COO-Utilities/hispec-tib/doc/hardware.md

# Electronics and repair reference

This page owns physical mappings and assumptions. [Fiber paths](hardware_profiles.md)
connect those mappings to API names. A firmware profile describes what is used;
a BOM describes assembly population. Neither alone certifies an installed board.

## Source drawings and revision boundaries

Use these source drawings and assembly files:

- {download}`Schematic print <../pcb/FIB_Switcher TIB Schematic Print.PDF>`:
  52 PDF pages, with some sheets dated 21 October 2026. PDF page numbers below
  are viewer page numbers, since repeated Altium sheet numbers are ambiguous.
- {download}`PCB print <../pcb/FIB_Switcher PCB Print.PDF>`: 23 pages of layers
  and assembly views; use component designators to locate the electrical stage.
- {download}`TIB BOM <../pcb/FIB_Switcher_TIB_BOM.xlsx>` and
  {download}`NoTIB BOM <../pcb/FIB_Switcher_NoTIB_BOM.xlsx>`: `Manufacturing`
  sheets dated 4 September 2026, 12:18 and 12:19 respectively.
- {download}`TIB placement <../pcb/FIB_Switcher_TIB.txt>` and
  {download}`NoTIB placement <../pcb/FIB_Switcher_NoTIB.txt>`: 16 July 2026,
  design revision `59e398672786f7c0d6aec813e7c4099687d5be41`.
  NoTIB contains optical patch comments for CAL and AS.

| Drawing pages | Use |
|---|---|
| 1, 10, 52 | AS, CAL and TIB hierarchy/component names |
| 9 | DACs U8/U9, references U12/U13 and TP2 |
| 39–44 | Repeated OPA2991 FVOA-drive stages |
| 45–48 | Controller hierarchy and Nucleo connector nets/straps |
| 49 | ADS1115 U4 and PD input networks |
| 50 | Power circuitry |
| 51 | PCAL6416 U7, MEMS drive mapping and TP1 |

The PD scaling follows the resistor network on page 49; its voltage annotation
is obsolete. The [input-chain description](#tib-photodiode-monitoring-adc) below
uses the component values and connections.

**Differences requiring physical review:** FVOA stages show 4.7 kΩ/2.43 kΩ feedback, giving
nominal gain $1+2.43/4.7=1.5170$, while firmware defaults to 1.533. NoTIB placement
comments reverse the red AS first-switch branch destinations relative to the
firmware route interpretation. These are [owner-review items](human_review_required.md);
the installed configuration matters when interpreting those drawings.

## Controller, buses and connectors

The controller is a Nucleo H563ZI (MB1404), STM32H563ZIT6 Cortex-M33, with 2 MB
flash and 640 KB SRAM. See the bundled
{download}`Nucleo manual <um3115-stm32h5-nucleo144-board-mb1404-stmicroelectronics.pdf>`
and {download}`MCU reference <stm32h563zi.pdf>`.

| Function | Nucleo signal / connector | Peripheral / destination |
|---|---|---|
| PD ADC SCL/SDA | PB8/PB9, D15/D14, CN7 2/4 | I2C1, 400 kHz; U4 ADS1115 at 0x48 |
| DAC/MEMS SCL/SDA | PF1/PF0, D69/D68, CN9 19/21 | I2C2, 400 kHz; DAC 0x48/0x4A, PCAL 0x21 |
| Laser Modbus RX/TX | PD6/PD5, D52/D53, CN9 4/6 | USART2, THVD1429 RS-485 |
| RS-485 enable | PD4, D54, CN9 8 | GPIO active high |
| Laser-bank enable | PB2, D72, CN9 13 | GPIO active low, default off |
| Relay 1-Wire | PE9, D71, CN9 15 | UART12 RX, AF6, TX/RX swap, single-wire open drain |
| Ambient 1-Wire | PG1, D64, CN9 30 | UART9 TX, AF11, single-wire open drain, DS18B20 |
| FFLS status 1/2 | PF7/PF9, D62/D63 | PCB pull-ups; overlay inputs, unused by firmware |

The two devices at address 0x48 are on different buses. Check bus identity before
interpreting an address scan. `app/boards/nucleo_h563zi.overlay` supplies the exact
pin configuration; `devices.c` maps profile names and logical channels.

Addresses below are **7-bit I2C addresses**, without the read/write bit:

| Device | Address strap | Installed selection |
|---|---|---|
| ADS1115 U4, I2C1 | ADDR to GND: 0x48; to VDD: 0x49 | GND, 0x48 |
| DAC7678PW U8/U9, I2C2 | ADDR to GND: 0x48; to AVDD: 0x4A; floating: 0x4C | U8: 0x4A; U9: 0x48 |
| PCAL6416A U7, I2C2 | ADDR low: 0x20; high: 0x21 | High, 0x21 |

The [DAC address table](https://www.ti.com/lit/ds/symlink/dac7678.pdf)
depends on package: these are the single-address-pin TSSOP-16 parts.

| Nucleo connector | Purpose | USB signal pins |
|---|---|---|
| CN1, ST-Link USB-C | Programming/debugging and ST-Link virtual COM port | Debugger MCU: D+ PB15, D− PB14, CC1 PC3, CC2 PC4 |
| CN13, user USB-C | USB connection directly to the STM32H563 | Target MCU: D+ PA12, D− PA11, CC1 PB13, CC2 PB14 |
| CN14, RJ45 | Ethernet for MQTT and OTA | — |
| CN5, MIPI20 | External SWD/JTAG/trace debugger | See Nucleo manual table 6 |

CN1 and CN13 connect to **different MCUs**; their similarly named pins are not
shared target pins. The connector names and USB mappings are in Nucleo manual
tables 18–19. Use CN1 for the [USB firmware procedure](ota.md#usb-provisioning-and-local-development).

Required MB1404 solder bridges: PB2 uses SB61 OFF/SB66 ON; PE9 uses SB35 OFF/SB67
ON. The installed-clock assumption is “HSE not used”: SB48/SB50 ON, SB49 OFF,
SB3/SB4 OFF. HSE pins PH0/PH1 are distinct from I2C2 PF0/PF1. Firmware therefore
uses HSI/PLL at 240 MHz, not an HSE source. LSE 32768 Hz clocks RTC and periodic
LPTIM4 uptime at 4096 ticks/s. LSI clocks the independent watchdog. No automatic
STOP states or RTC retention across complete power removal are assumed.

## MEMS drive and switch identity

U7 is a PCAL6416AHF,128: 3.3 V I2C logic, 5 V port supply, ADDR tied high for
0x21. Its outputs drive external transistor stages. The overlay uses push-pull,
pull-ups and **active-low PCAL logic**: logical inactive gives an external low
control line, and logical active creates a high pulse at the switch. A GPIO
`output-low` flag describes logical state, not necessarily low voltage at the pin.

The [PCAL specification](https://www.nxp.com/docs/en/data-sheet/PCAL6416A.pdf)
allows up to 25 mA sink and 10 mA source per pin, subject to its voltage and
package limits. The external MOSFETs supply the switch-coil current. The Zephyr
driver initializes full drive strength and push-pull operation. Output mode is
selected per eight-bit port; TIB's port 0 mixes FFLS and FFSW controls, so the
common push-pull configuration serves both stage types.

| Stage | Parts verified in schematic/BOM | Function |
|---|---|---|
| FFSW | Two NTGD4167CT1G complementary MOSFET packages per switch, Q6/Q7; 4.7 kΩ resistors | Coil drive for 20 ms firmware pulses |
| FFLS (TIB only) | DMP3085LSD-13 dual P-channel packages Q4/Q5 | Large-core switch drive for 50 ms pulses |

Each FFSW control has a 4.7 kΩ pull-up to 5 V: about 1.06 mA flows through that
resistor when its PCAL output is low, or up to 2.1 mA for the two-line stage.
The NTGD4167 is the PCB's complementary N/P MOSFET implementation of Agiltron's
SI3552DV reference stage. FFLS gate controls lack these external pull-ups.
An open-drain conversion would require gate pull-ups; unpopulated FFSW-stage
pads provide possible connection points where present. The current push-pull
configuration does not require that modification.

FFLS status inputs have separate 10 kΩ pull-ups to 3.3 V (R11/R12) and 10 kΩ
series resistors (R13/R14), shown on page 48 and specified in TIB BOM row 36.
These are sense-line components, not gate pull-ups.

TIB BOM rows 32–33 and NoTIB row 26 agree with the schematic's stage names. Both switch types latch;
firmware limits actuation to five pulses/s. FFLS status low indicates position B,
high A, but firmware does not consume this feedback. See the bundled
{download}`FFSW datasheet <datasheets/FFSW 1x2 Switch.pdf>` and
{download}`FFLS datasheet <datasheets/FFLS 1x2 Switch.pdf>`.

TIB return selectors `yj_sm_mm` (sw7 / SW2_FFLS1) and `hk_sm_mm`
(sw8 / SW2_FFLS2) follow state A/B name order. Common optical A connects to the
detector; silkscreen B is the SM return and C is the MM return. Pulsing FFLS
pin 2 with the A-state GPIO selects SM; pin 3 with the B-state GPIO selects MM.
The schematic labels these optical branches B1/B2.

| PCB channel | PCAL A/B GPIO indices | Port bits |
|---|---|---|
| sw1 | 6 / 7 | P0.6 / P0.7 |
| sw2 | 8 / 9 | P1.0 / P1.1 |
| sw3 | 4 / 5 | P0.4 / P0.5 |
| sw4 | 10 / 11 | P1.2 / P1.3 |
| sw5 | 12 / 13 | P1.4 / P1.5 |
| sw6 | 14 / 15 | P1.6 / P1.7 |
| sw7 | 2 / 3 | P0.2 / P0.3 |
| sw8 | 0 / 1 | P0.0 / P0.1 |

TP1 on schematic page 51 exposes drive-side nets. Its physical header pin numbers
are not PCAL bit numbers. Use [profile assignments](hardware_profiles.md) to map
sw1…sw8 to installed switch designators before probing.

## TIB and CAL attenuator drive

TIB populates DAC7678 U8/U9, REF3333 U12/U13 and six dual OPA2991 drive stages;
NoTIB's BOM populates U9/U13 and only FVOADrive5. The latter is consistent with
CAL's one logical pair, not a separately verified AS population manifest.

DAC AVDD/reference are 3.3 V; LDAC is grounded. Ideal 12-bit output is
$V=3.3n/4096$ volts for code 0…4095. Amplifiers drive the FVOAs toward 5 V.
Firmware's gain is a model coefficient; distinguish it from the resistor-derived
gain and the measured post-amplifier voltage.

The FVOA is a resistive load without polarity. The datasheet lists 6 V maximum
drive and 220 mW maximum consumption at full attenuation. Their ratio is
36.7 mA, the design current allowance; it is not a separately specified current
limit. Bench supply/ammeter measurements found **530–616 Ω**, typically about
615 Ω. At 5 V that implies about 8.1–9.4 mA per FVOA. The OPA2991, rather than
the DAC, supplies this load. Verify actual supply/headroom and loading before
interpreting a saturated drive as extra attenuation.

| API channel | PCB attenuator label | DAC/address | DAC1 / DAC2 outputs |
|---|---|---|---|
| `1028y` | Y / pair 1 | U8 / 0x4A | A / C |
| `1270j` | J / pair 2 | U8 / 0x4A | E / G |
| `1430yj` | YJATC / pair 3 | U8 / 0x4A | D / F |
| `1430hk` | HKATC / pair 4 | U9 / 0x48 | A / C |
| `1510h` or CAL `lfc` | H / CAL / pair 5 | U9 / 0x48 | E / G |
| `2330k` | K / pair 6 | U9 / 0x48 | D / F |

The firmware CAL index is **4, zero-based**, meaning physical pair 5. TP2 exposes
pre/post-amplifier nets; consult page 9 for its pin mapping. Two successful DAC
writes are consecutive I2C operations, not simultaneous latching. Refer to the
[attenuator model](attenuator.md), [calibration](attenuator_calibration.md), and
{download}`FVOA datasheet <datasheets/FVOA_atten.pdf>` for optical interpretation.

(photodiode-monitoring)=
## TIB photodiode monitoring ADC

U4 ADS1115 channel A0 samples YJ (J13); A2 samples HK (J12), single-ended. Nominal
detectors are Femto FWPR-20-IN and Thorlabs PDA10DT. Firmware uses ±2.048 V range,
62.5 µV/code and 64 SPS converter rate, producing a fresh sample on each channel
at 20 Hz. It treats 2000 mV as the usable upper limit, distinct from the ADC rail.

Each input uses a precision **0–10 V → 0–2 V divider**. R7 (YJ) and R8 (HK)
are NOMCT16032002AT1 networks containing eight isolated 20 kΩ resistors; four
form the 80 kΩ upper leg and one the 20 kΩ lower leg. The remaining three are
tied to ground at both ends. This presents a nominal 100 kΩ load to the detector.
See page 49 and the [Vishay network specification](https://www.vishay.com/docs/60007/nomc.pdf).

C17/C18 are 0.47 µF capacitors across the lower legs. The divider's Thevenin
resistance is $80\,\mathrm{k\Omega}\parallel20\,\mathrm{k\Omega}=16\,\mathrm{k\Omega}$,
giving $f_c=1/(2\pi\,16\,000\times0.47\,\mu\mathrm F)\simeq21.2$ Hz.
This PCB filter follows the detector's own response; it is separate from the
ADS1115's digital filtering and 20 Hz per-channel sample cadence.

The HK PDA10DT uses **70 dB gain and the 500 Hz bandwidth selector**. Its
high-impedance gain is $4.75\times10^6$ V/A, making the effective ADC gain
$0.2\times4.75\times10^6=9.5\times10^5$ V/A. The 100 kΩ divider is not a
50 Ω termination, so the detector's 50 Ω-load half-gain does not apply.
The [Thorlabs gain table](https://www.thorlabs.com/catalogpages/V21/1576.PDF)
states gain in **kV/A**. Firmware effective transimpedance includes the divider;
applying it twice would corrupt power.
[Sampling and uncertainty](photodiode_notes.md) explains clipping and dark capture.

### Static attenuation requirements

The optical simulations determined these anticipated attenuation requirements.
They retain the signed power-ratio convention, $10\log_{10}T$: negative dB means
loss. The static component supplies the least-negative end of the required range;
the variable attenuation supplies the remaining span.

| Wavelength (nm) | Anticipated attenuation | Variable span | Static attenuation |
|---|---|---|---|
| 1028 | -90.0 to -73.0 dB | 17.0 dB | **-73.0 dB** |
| 1270 | -70.0 to -40.0 dB | 30.0 dB | **-40.0 dB** |
| 1430 | Fixed | 0.0 dB | **-100.0 dB** |
| 1510 | -80.0 to -33.0 dB | 47.0 dB | **-33.0 dB** |
| 2330 | -73.0 to -3.0 dB | 70.0 dB | **-3.0 dB** |

These simulation-derived requirements are distinct from the compiled whole-route
defaults below and from an installed route's measured loss. Firmware attenuation
commands use **positive loss in dB**; do not send these signed values directly.

### TIB route-loss defaults

The November 4, 2026 loopbacks supply provisional **effective whole-route**
launch losses. SM return transmission is normalized to 1. Static attenuators,
actual SM-return loss and external patch loss are absorbed in the launch
estimate. The reported calibrated FVOA transmission is divided out; firmware
applies it separately. Do not add static attenuation or subtract FVOA loss again.

| Source | FEI loss (dB) | AO loss (dB) | FEI transmission | AO transmission |
|---|---:|---:|---:|---:|
| 1028y | 35.896998 | 35.912564 | 0.000257217310675 | 0.000256297034072 |
| 1270j | 40.022883 | 39.919884 | 9.94744744745e-05 | 0.000101861861862 |
| 1430yj | 61.862828 | 61.770422 | 6.51204158058e-07 | 6.65208548554e-07 |
| 1430hk | 40.316480 | 40.783695 | 9.29719589563e-05 | 8.34892314352e-05 |
| 1510h | 28.578688 | 28.861120 | 0.00138717482884 | 0.00129983419147 |
| 2330k | 35.947698 | 35.969136 | 0.000254232004693 | 0.00025298010467 |

Use the shared `yj_laser_to_yj_ao/fei` or `hk_laser_to_hk_ao/fei` loss names,
including 1430. Internal 1430 records retain their physical route identity.
YJ used an S154C head set to 1028 nm, with factors 1, 0.7314 and 0.6507 for
1028/1270/1430. HK 1430/1510 used the same head set to 1430 nm, with factors 1
and 0.9714. The 2330 measurement used an S148C set to 2330 nm, factor 1.
S154C factors come from its typical response graph; retained digits are
calculation precision, not measurement accuracy. AO/FEI and MM/SM ratios do not
depend on these wavelength corrections.

| Channel | SM transmission | MM transmission | Additional MM loss (dB) |
|---|---:|---:|---:|
| YJ | 1.0 | 0.389741142978 | 4.092237455 |
| HK | 1.0 | 0.830050505051 | 0.808954818 |

Each MM value is the equally weighted arithmetic mean of the three measured
MM/SM ratios in that channel. These useful broadband estimates do not establish
achromatic returns. They replace the former MM 0.98 / SM 0.60 component estimates.
The launch values replace the October 3 YJ 34.5/41/62 dB estimates and nominal
HK switch/static-loss products; the notebook retains that measurement history.

YJ CAL launch remains the 1 dB component estimate (transmission 0.794328234724);
HK CAL has no measured default and uses unity. Retro estimates remain notebook
references. Explicit `mems/route/loss` records replace the whole default.
Named-source overrides are independent of stored generic overrides; passive
capture selects `generic`. Saved settings take precedence after firmware updates.

## Laser control and switched power

The off-board bank contains six Maiman controllers and an NH8 hub. USART2 uses
115200 baud, 8N1, native FIFO and interrupt-driven Modbus. The THVD1429 drives
RS-485 with a documented 50 Ω board termination for this hub connection.
Power/ground to the hub come from the bank. See the bundled
{download}`Maiman manual <datasheets/maiman sf8025.pdf>` and
[laser operation](laser_operation.md) for transaction timing and faults.

PB2 drives a BSS138 stage controlling the bank power inhibit. The active-low
logical enable defaults off; heater auto policy can subsequently power the bank.
Off-board DS2408 relays switch PD YJ, PD HK and the auxiliary heater:

| Relay label | Zero-based DS2408 pin | Logical function |
|---|---|---|
| P1 | 0 | YJ PD power |
| P2 | 1 | HK PD power |
| P3 | 2 | Laser-bank auxiliary heater |

All are active-low, with inactive/off startup intent. The custom DS2408 driver
applies `init-gpios` defaults when available; application setup enforces its own
startup state. This allowed missing-at-boot peripheral is not a generic GPIO hog:
a hog would abort on a not-ready controller. Offline commands report errors;
warnings are best-effort, not guaranteed delivery. Successful DS2408 communication
is the current proxy for load-power availability; there is no downstream power-good
measurement. Status reports confirmed logical relay state.

Both 1-Wire buses have external 3.3 V pull-ups and use stock UART timing:
115200 baud data, 9600 baud reset (about 521 µs low). The accepted DS2408 reset
timing is outside its documented 660–720 µs range at this pull-up voltage; earlier
GPIO timing also fell outside it. This is a known board assumption, not a claim
of datasheet compliance. Revisit it if failures warrant. The pinned serial-driver
mutex limitation is described in [architecture](architecture.md#hardware-control).
Ambient DS18B20 conversion can take 750 ms on the app blocking queue.

## Tracing a fault

Start with the detected profile and commanded path, then follow its physical
channel through the tables above. For switching, distinguish requested state,
PCAL output, transistor-side pulse and actual optical continuity. For attenuation,
compare DAC code, pre-amplifier voltage and FVOA drive before judging the optical
model. For a PD fault, check relay state, input voltage, ADC raw code and configured
dark before interpreting computed nW. For a laser fault, preserve controller
readbacks and communication errors separately from cached current/power estimates.
The [review ledger](human_review_required.md) records unresolved drawing/firmware
questions; use the installed configuration when resolving them.
