COO-Utilities/hispec-tib/doc/hardware_overview.md

# Hardware

`hardware.md` remains the hardware source of truth. The pages below separate
physical hardware details from the firmware's selected board-profile view.

```{toctree}
:maxdepth: 2

hardware.md
hardware_profiles.md
```
