COO-Utilities/hispec-tib/doc/api/devices.md

# Devices and Board Profiles

```{eval-rst}
.. doxygenfile:: app/src/devices.h
   :project: hispec_tib
```

```{eval-rst}
.. doxygenfile:: app/src/app_identity.h
   :project: hispec_tib
```
