COO-Utilities/hispec-tib/doc/api/index.md

# API Reference

These pages are generated through Doxygen XML and Breathe. They are intended to
answer "what does the current C implementation expose?" rather than replace the
architecture and command audit pages.

```{toctree}
:maxdepth: 2

command_interface.md
devices.md
mems_switching.md
photodiode_monitoring.md
attenuator_control.md
maiman_laser.md
settings.md
scheduled_actions.md
warnings.md
sntp_time.md
temperature.md
network_mqtt.md
```
