COO-Utilities/hispec-tib/doc/api/mems_switching.md

# MEMS Switching

```{eval-rst}
.. doxygenfile:: app/src/mems_switching.h
   :project: hispec_tib
```
