COO-Utilities/hispec-tib/pcb/FIB_Switcher_NoTIB_BOM.xlsx

Sheet: Manufacturing
 |  | Bill of Materials for |  | FIB_Switcher.PrjPcb
 |  | Source Data From: | ActiveBOM.BomDoc
 |  | Variant: | NoTIB
 |  | Report Date: | 9/4/2026 12:19 PM
 |  |  |  | Primary |  |  |  |  | Secondary
Altium Vault P/N | Designator | Description | Qty | Supplier | Supplier Part Number | Manufacturer | Manufacturer Part Number | Supplier Unit Price | Supplier | Supplier Part Number | Manufacturer | Manufacturer Part Number | Supplier Unit Price
CMP-06035-053188-1 | C7, C16 | Multi-Layer Ceramic Capacitor 2.2uF 50V X5R ±10% 0603 Paper T/R | 2 | Mouser | 81-GRT188R61H225KE3J | Murata | GRT188R61H225KE13J | 0.0910 | Mouser | 81-GRT188R61H225KE3J | Murata | GRT188R61H225KE13J | 0.0910
CMP-05428-000143-1 | C9 | Conductive Polymer Aluminum Solid Capacitors (OS-CON) 100uF ±20% 25V RADIAL SMT 8x6.9mm | 1 | Mouser | 667-25SVPT100M | Panasonic | 25SVPT100M | 2.2500 | Newark | 25SVPT100M | Panasonic | 25SVPT100M | 2.2900
CMP-06035-045268-1 | C10 | Chip Multilayer Ceramic Capacitors for General Purpose, 0603, 10uF, X5R, 15%, 10%, 25V | 1 | Conrad | 3425436 | Murata | GRM188R61E106KA73D | 0.0929 | Arrow Electronics | GRM188R61E106KA73D | Murata | GRM188R61E106KA73D | 0.0955
CMP-03422-001490-1 | C11, C12, C14, C20, C21_FVOADrive5 | CAP CER 0.1UF 50V X7R 0603 | 5 | Newark | CC0603JRX7R9BB104 | Yageo Group | CC0603JRX7R9BB104 | 0.0390 | Newark | CC0603JRX7R9BB104 | Yageo Group | CC0603JRX7R9BB104 | 0.0390
CMP-00278-84331543-1 | D1 | SMCJ24CA Cut Tape 1 Surface Mount Single (Type) Tvs Diode 38.9V 5muA 1.5kW 150C | 1 | Arrow Electronics | SMCJ24CA | Bourns | SMCJ24CA | 0.1616 | Mouser | 652-SMCJ24CA | Bourns | SMCJ24CA | 0.5030
CMP-004-00035-1 | D2 | Zener Diode, 8.2V V(Z), 5%, 1W, Silicon, Unidirectional, DO-214AC | 1 | Mouser | 78-SML4738A-E3 | Vishay | SML4738A-E3/61 | 0.3920 | DigiKey | SML4738A-E3/61GICT-ND | Vishay | SML4738A-E3/61 | 0.9100
CMP-002-00106-4 | J1_ASB1, J1_ASB2, J1_ASB3, J1_ASR1, J1_ASR2, J1_ASR3, J1_Cal1, J1_Cal2, J1_Cal3, J1_Cal4, J1_Cal5, J1_Cal6, J1_Cal7, J2_ASB1, J2_ASB2, J2_ASB3, J2_ASR1, J2_ASR2, J2_ASR3, J2_Cal1, J2_Cal2, J2_Cal3, J2_Cal4, J2_Cal5, J2_Cal6, J2_Cal7, J3_ASB1, J3_ASB2, J3_ASB3, J3_ASR1, J3_ASR2, J3_ASR3, J3_Cal1, J3_Cal2, J3_Cal3, J3_Cal4, J3_Cal5, J3_Cal6, J3_Cal7, J4_ASB1, J4_ASB2, J4_ASB3, J4_ASR1, J4_ASR2, J4_ASR3, J4_Cal1, J4_Cal2, J4_Cal3, J4_Cal4, J4_Cal5, J4_Cal6, J4_Cal7, J8_Cal, J9_Cal, J10_Cal, J11_Cal | MillMax 0.015 ~ 0.020" (0.38mm ~ 0.56mm) No Tail Solder Pin Receptacle Connector | 56 | Mouser | 575-055221515 | Mill-Max | 0552-2-15-15-11-27-10-0 | 0.2450 | DigiKey | ED90096-ND | Mill-Max | 0552-2-15-15-11-27-10-0 | 0.2646
CMP-04776-000082-1 | J6 | CONN HEADER SMD R/A 2POS 3MM | 1 | Mouser | 538-43650-0210 | Molex | 43650-0210 | 2.8800 | Arrow Electronics | 0436500210 | Molex | 43650-0210 | 1.2200
CMP-002-00103-1 | J18, TP2 | 20 Position Receptacle, Bottom Entry Connector 0.100 (2.54mm) Surface Mount Gold | 2 | Avnet | SSM-110-L-DV-BE | Samtec | SSM-110-L-DV-BE | 3.0100 | Avnet | SSM-110-L-DV-BE | Samtec | SSM-110-L-DV-BE | 3.0100
CMP-002-00102-1 | J19, TP1 |  | 2 | Avnet | SSM-115-L-DV-BE | Samtec | SSM-115-L-DV-BE | 3.8200 | Mouser | 200-SSM115LDVBE | Samtec | SSM-115-L-DV-BE | 3.8600
CMP-002-00104-1 | J20 |  | 1 | Avnet | SSM-108-L-DV-BE-K | Samtec | SSM-108-L-DV-BE-K | 3.6800 | DigiKey | 612-SSM-108-L-DV-BE-K-ND | Samtec | SSM-108-L-DV-BE-K | 3.7200
CMP-002-00101-1 | J21 |  | 1 | Avnet | SSM-117-L-DV-BE | Samtec | SSM-117-L-DV-BE | 4.6700 | Newark | SSM-117-L-DV-BE | Samtec | SSM-117-L-DV-BE | 4.9200
CMP-03913-75615359-2 | MP51, MP52, MP53, MP54, MP55, MP56, MP57, MP58, MP61, MP62, MP63, MP64, MP65, MP66, MP67, MP68 | WA-SMSI SMT Steel Spacer, M3 Internal non Stop | 16 | DigiKey | 732-9774025360RCT-ND | Wurth Elektronik | 9774025360R | 0.7560 | DigiKey | 732-9774025360RCT-ND | Wurth Elektronik | 9774025360R | 0.7560
CMP-03913-89311589-2 | MP100, MP101, MP102, MP103, MP104, MP105, MP106, MP107, MP108, MP109 | WA-SMSI SMT Steel Spacer, M4 Internal non Stop | 10 | Newark | 9774010482R | Wurth Elektronik | 9774010482R | 1.3800 | Newark | 9774010482R | Wurth Elektronik | 9774010482R | 1.3800
CMP-00572-18642749-1 | Q3 | Trans MOSFET P-CH 60V 50A Automotive 3-Pin(2+Tab) DPAK T/R / MOSFET P-CH 60V 50A TO-252 | 1 | DigiKey | 559-NP50P06SDG-E1-AYCT-ND | Renesas | NP50P06SDG-E1-AY | 3.4600 | DigiKey | 559-NP50P06SDG-E1-AYDKR-ND | Renesas | NP50P06SDG-E1-AY | 3.4600
CMP-1058-00959-1 | Q6_FFSWDrive1, Q6_FFSWDrive2, Q6_FFSWDrive3, Q6_FFSWDrive4, Q6_FFSWDrive5, Q6_FFSWDrive6, Q6_FFSWDrive7, Q7_FFSWDrive1, Q7_FFSWDrive2, Q7_FFSWDrive3, Q7_FFSWDrive4, Q7_FFSWDrive5, Q7_FFSWDrive6, Q7_FFSWDrive7 | Power MOSFET, Complementary, 30 V, +2.9 / -2.2 A, 6-Pin TSOP, Pb-Free, Tape and Reel | 14 | Arrow Electronics | NTGD4167CT1G | onsemi | NTGD4167CT1G | 0.1725 | Arrow Electronics | NTGD4167CT1G | onsemi | NTGD4167CT1G | 0.3412
CMP-07173-000101-1 | Q8 | MOSFET N-CH 50V 220MA SOT-23 | 1 | DigiKey | BSS138DKR-ND | onsemi | BSS138 | 0.3200 | DigiKey | BSS138CT-ND | onsemi | BSS138 | 0.3200
CMP-2000-06942-1 | R1, R2, R15, R16, R26_FFSWDrive1, R26_FFSWDrive2, R26_FFSWDrive3, R26_FFSWDrive4, R26_FFSWDrive5, R26_FFSWDrive6, R26_FFSWDrive7, R27_FFSWDrive1, R27_FFSWDrive2, R27_FFSWDrive3, R27_FFSWDrive4, R27_FFSWDrive5, R27_FFSWDrive6, R27_FFSWDrive7, R28_FVOADrive5, R29_FVOADrive5 | Chip Resistor, 4.7 KOhm, +/- 1%, 0.1 W, -55 to 155 degC, 0603 (1608 Metric), RoHS, Tape and Reel | 20 | Mouser | 603-RC0603FR-074K7L | Yageo Group | RC0603FR-074K7L | 0.0100 | Mouser | 603-RC0603FR-074K7L | Yageo Group | RC0603FR-074K7L | 0.0100
CMP-2100-03664-2 | R17, R21, R22, R25 | RES 10K OHM 1% 1/10W 0603 | 4 | Mouser | 603-RC0603FR-0710KL | Yageo Group | RC0603FR-0710KL | 0.0140 | Mouser | 603-RC0603FR-0710KL | Yageo Group | RC0603FR-0710KL | 0.0140
CMP-03412-020828-1 | R20 | RES SMD 732 OHM 1% 1/10W 0603 | 1 | Arrow Electronics | RT0603FRE07732RL | Yageo Group | RT0603FRE07732RL | 0.0068 | Arrow Electronics | RT0603FRE07732RL | Yageo Group | RT0603FRE07732RL | 0.0068
CMP-1012-00552-1 | R30_FVOADrive5, R31_FVOADrive5 | 2K43 0.1W 1% 0603 (1608 Metric) SMD | 2 | Arrow Electronics | CRCW06032K43FKEA | Vishay | CRCW06032K43FKEA | 0.0012 | Arrow Electronics | CRCW06032K43FKEA | Vishay | CRCW06032K43FKEA | 0.0025
CMP-0253-00019-2 | U1 | High-Precision 1-Wire Digital Thermometer, -55 to 125 degC, 8-Pin SOIC (S8+2), Pb-Free | 1 | Mouser | 700-DS18B20Z | Analog Devices | DS18B20Z+ | 5.6300 | DigiKey | DS18B20Z+-ND | Analog Devices | DS18B20Z+ | 6.1400
CMP-0387-00758-2 | U6 | 3 A, Wide-Input, Adjustable Switching Regulator Module, -40 to 85 degC, 7-pin Module (EUY7), Pb-Free (RoHS) | 1 | DigiKey | 296-20525-ND | Texas Instruments | PTN78060WAZ | 31.2900 | Mouser | 595-PTN78060WAZ | Texas Instruments | PTN78060WAZ | 31.9000
CMP-10112-000009-1 | U7 | IC I/O EXPANDER 16BIT 24HWQFN | 1 | Newark | PCAL6416AHF,128 | NXP Semiconductors | PCAL6416AHF,128 | 1.5200 | Mouser | 771-PCAL6416AHF,128 | NXP Semiconductors | PCAL6416AHF,128 | 1.5900
CMP-0004-01214-1 | U9 | 12-Bit, Octal Channel, Ultra-Low Glitch, Voltage Output, 2-Wire Interface DAC with 2.5 V Internal Reference, -40 to 125 degC, 16-pin SOP (PW16), Green (RoHS & no Sb/Br) | 1 | DigiKey | 296-DAC7678SPWRCT-ND | Texas Instruments | DAC7678SPWR | 15.2900 | DigiKey | 296-DAC7678SPWRDKR-ND | Texas Instruments | DAC7678SPWR | 15.2900
CMP-04895-000242-1 | U10_FVOADrive5 | IC OPAMP GP 2 CIRCUIT 8SOIC | 1 | Arrow Electronics | OPA2991IDR | Texas Instruments | OPA2991IDR | 2.0400 | DigiKey | 296-OPA2991IDRDKR-ND | Texas Instruments | OPA2991IDR | 2.5300
CMP-0367-00146-2 | U13 | 30 ppm / degC Drift, 3.9 uA Voltage Reference, -40 to 125 degC, 3-pin SOT-23 (DBZ), Green (RoHS & no Sb/Br) | 1 | Arrow Electronics | REF3333AIDBZR | Texas Instruments | REF3333AIDBZR | 1.6700 | Mouser | 595-REF3333AIDBZR | Texas Instruments | REF3333AIDBZR | 1.7300

Sheet: Project Information
Project Full Path | C:\Users\Public\Documents\Altium\FIB_Switcher\FIB_Switcher.PrjPcb
Project Filename | FIB_Switcher.PrjPcb
Variant Name | NoTIB
Data-Source Filename | ActiveBOM.BomDoc
Data-Source Full Path | C:\Users\Public\Documents\Altium\FIB_Switcher\ActiveBOM.BomDoc
Title | Copy of Copy of Copy of Copy of Copy of Copy of Bill of Materials for Variant [NoTIB] of BOM Document [ActiveBOM.BomDoc]
Total Quantity | 149
Report Time | 12:19 PM
Report Date | 9/4/2026
Report Date & Tine | 9/4/2026 12:19 PM
Output Name | Copy of Copy of Copy of Copy of Copy of Copy of Bill of Materials
Output Type | BomReport
Output Generator Name | BOM
Output Generator Description | Bill of Materials
