COO-Utilities/hispec-tib/pcb/FIB_Switcher_TIB_BOM.xlsx

Sheet: Manufacturing
 |  | Bill of Materials for |  | FIB_Switcher.PrjPcb
 |  | Source Data From: | ActiveBOM.BomDoc
 |  | Variant: | TIB
 |  | Report Date: | 9/4/2026 12:18 PM
 |  |  |  | Primary |  |  |  |  | Secondary
Altium Vault P/N | Designator | Description | Qty | Supplier | Supplier Part Number | Manufacturer | Manufacturer Part Number | Supplier Unit Price | Supplier | Supplier Part Number | Manufacturer | Manufacturer Part Number | Supplier Unit Price
CMP-03422-001490-1 | C1, C5, C11, C12, C13, C14, C19, C20, C21_FVOADrive1, C21_FVOADrive2, C21_FVOADrive3, C21_FVOADrive4, C21_FVOADrive5, C21_FVOADrive6 | CAP CER 0.1UF 50V X7R 0603 | 14 | Newark | CC0603JRX7R9BB104 | Yageo Group | CC0603JRX7R9BB104 | 0.0390 | Newark | CC0603JRX7R9BB104 | Yageo Group | CC0603JRX7R9BB104 | 0.0390
CMP-03422-001015-1 | C2 | CC0805 1 uF X7R 10.00% 50 V | 1 | Newark | CC0805KFX7R9BB105 | Yageo Group | CC0805KFX7R9BB105 | 0.2470 | Mouser | 603-CC0805KFX7R9BB10 | Yageo Group | CC0805KFX7R9BB105 | 0.2600
CMP-2006-03420-2 | C3 | CAP CER 10000PF 25V 10% NP0 0603 | 1 | DigiKey | 399-C0603C103K3GACTUCT-ND | Yageo Group | C0603C103K3GACTU | 0.4500 | DigiKey | 399-C0603C103K3GACTUDKR-ND | Yageo Group | C0603C103K3GACTU | 0.4500
CMP-06035-053188-1 | C4, C6, C7, C15, C16 | Multi-Layer Ceramic Capacitor 2.2uF 50V X5R ±10% 0603 Paper T/R | 5 | Mouser | 81-GRT188R61H225KE3J | Murata | GRT188R61H225KE13J | 0.0910 | Mouser | 81-GRT188R61H225KE3J | Murata | GRT188R61H225KE13J | 0.0910
CMP-05428-000143-1 | C8, C9 | Conductive Polymer Aluminum Solid Capacitors (OS-CON) 100uF ±20% 25V RADIAL SMT 8x6.9mm | 2 | Mouser | 667-25SVPT100M | Panasonic | 25SVPT100M | 2.2500 | Newark | 25SVPT100M | Panasonic | 25SVPT100M | 2.2900
CMP-06035-045268-1 | C10 | Chip Multilayer Ceramic Capacitors for General Purpose, 0603, 10uF, X5R, 15%, 10%, 25V | 1 | Conrad | 3425436 | Murata | GRM188R61E106KA73D | 0.0929 | Arrow Electronics | GRM188R61E106KA73D | Murata | GRM188R61E106KA73D | 0.0955
CMP-1037-04566-3 | C17, C18 | CAP CER 0.47UF 50V X7R 1206 | 2 | Mouser | 80-C1206C474J5R | Yageo Group | C1206C474J5RACTU | 0.7700 | Newark | C1206C474J5RACTU | Yageo Group | C1206C474J5RACTU | 0.4570
CMP-00278-84331543-1 | D1 | SMCJ24CA Cut Tape 1 Surface Mount Single (Type) Tvs Diode 38.9V 5muA 1.5kW 150C | 1 | Arrow Electronics | SMCJ24CA | Bourns | SMCJ24CA | 0.1616 | Mouser | 652-SMCJ24CA | Bourns | SMCJ24CA | 1.0500
CMP-004-00035-1 | D2 | Zener Diode, 8.2V V(Z), 5%, 1W, Silicon, Unidirectional, DO-214AC | 1 | Mouser | 78-SML4738A-E3 | Vishay | SML4738A-E3/61 | 0.8600 | DigiKey | SML4738A-E3/61GICT-ND | Vishay | SML4738A-E3/61 | 0.9100
CMP-002-00106-4 | J1_TIBB1, J1_TIBB2, J1_TIBB3, J1_TIBR1, J1_TIBR2, J1_TIBR3, J2_TIBB1, J2_TIBB2, J2_TIBB3, J2_TIBR1, J2_TIBR2, J2_TIBR3, J3_TIBB1, J3_TIBB2, J3_TIBB3, J3_TIBR1, J3_TIBR2, J3_TIBR3, J4_TIBB1, J4_TIBB2, J4_TIBB3, J4_TIBR1, J4_TIBR2, J4_TIBR3, J8_H, J8_HKATC, J8_J, J8_K, J8_Y, J8_YJATC, J9_H, J9_HKATC, J9_J, J9_K, J9_Y, J9_YJATC, J10_H, J10_HKATC, J10_J, J10_K, J10_Y, J10_YJATC, J11_H, J11_HKATC, J11_J, J11_K, J11_Y, J11_YJATC | MillMax 0.015 ~ 0.020" (0.38mm ~ 0.56mm) No Tail Solder Pin Receptacle Connector | 48 | Mouser | 575-055221515 | Mill-Max | 0552-2-15-15-11-27-10-0 | 0.2730 | DigiKey | ED90096-ND | Mill-Max | 0552-2-15-15-11-27-10-0 | 0.2824
CMP-00257-00298098-1 | J5 | 43650-0310 Conn Header 3 POS 3mm Solder RA SMD 3 Terminal 1 Port Micro-Fit 3.0 T/R | 1 | Arrow Electronics | 0436500310 | Molex | 43650-0310 | 2.1800 | Newark | 43650-0310 | Molex | 43650-0310 | 3.0600
CMP-04776-000082-1 | J6 | CONN HEADER SMD R/A 2POS 3MM | 1 | Mouser | 538-43650-0210 | Molex | 43650-0210 | 2.8800 | Arrow Electronics | 0436500210 | Molex | 43650-0210 | 1.2200
CMP-00257-00298100-1 | J7 | 43650-0510 Conn Header 5 POS 3mm Solder RA SMD 5 Terminal 1 Port Micro-Fit 3.0 T/R | 1 | Arrow Electronics | 0436500510 | Molex | 43650-0510 | 1.1100 | RS (Formerly Allied Electronics) | 43650-0510 | Molex | 43650-0510 | 1.1900
CMP-03790-39547162-1 | J12, J13 | 5413194-2 RF BNC Connector, 1 Contact(s), Female, Panel Mount, Solder Terminal, Locking, Jack | 2 | Newark | 5413194-2 | TE Connectivity | 5413194-2 | 9.0200 | Newark | 5413194-2 | TE Connectivity | 5413194-2 | 11.5300
CMP-002-00103-1 | J18, TP2 | 20 Position Receptacle, Bottom Entry Connector 0.100 (2.54mm) Surface Mount Gold | 2 | Avnet | SSM-110-L-DV-BE | Samtec | SSM-110-L-DV-BE | 3.0100 | Avnet | SSM-110-L-DV-BE | Samtec | SSM-110-L-DV-BE | 3.0100
CMP-002-00102-1 | J19, TP1 |  | 2 | Avnet | SSM-115-L-DV-BE | Samtec | SSM-115-L-DV-BE | 3.8200 | Mouser | 200-SSM115LDVBE | Samtec | SSM-115-L-DV-BE | 3.8600
CMP-002-00104-1 | J20 |  | 1 | Avnet | SSM-108-L-DV-BE-K | Samtec | SSM-108-L-DV-BE-K | 3.6800 | DigiKey | 612-SSM-108-L-DV-BE-K-ND | Samtec | SSM-108-L-DV-BE-K | 3.7200
CMP-002-00101-1 | J21 |  | 1 | Avnet | SSM-117-L-DV-BE | Samtec | SSM-117-L-DV-BE | 4.6700 | Newark | SSM-117-L-DV-BE | Samtec | SSM-117-L-DV-BE | 4.9200
CMP-03913-75615359-2 | MP14, MP15, MP16, MP17, MP18, MP19, MP20, MP21, MP22, MP23, MP24, MP25, MP26, MP27, MP28, MP29, MP30, MP31, MP32, MP33, MP34, MP35, MP36, MP37 | WA-SMSI SMT Steel Spacer, M3 Internal non Stop | 24 | DigiKey | 732-9774025360RCT-ND | Wurth Elektronik | 9774025360R | 0.8610 | DigiKey | 732-9774025360RCT-ND | Wurth Elektronik | 9774025360R | 0.8610
CMP-03913-89311589-2 | MP100, MP101, MP102, MP103, MP104, MP105, MP106, MP107, MP108, MP109 | WA-SMSI SMT Steel Spacer, M4 Internal non Stop | 10 | Newark | 9774010482R | Wurth Elektronik | 9774010482R | 1.6900 | Newark | 9774010482R | Wurth Elektronik | 9774010482R | 1.6900
CMP-00572-18642749-1 | Q3 | Trans MOSFET P-CH 60V 50A Automotive 3-Pin(2+Tab) DPAK T/R / MOSFET P-CH 60V 50A TO-252 | 1 | DigiKey | 559-NP50P06SDG-E1-AYCT-ND | Renesas | NP50P06SDG-E1-AY | 3.4600 | DigiKey | 559-NP50P06SDG-E1-AYDKR-ND | Renesas | NP50P06SDG-E1-AY | 3.4600
CMP-12801-000030-1 | Q4, Q5 | MOSFET 2P-CH 30V 3.9A 8SO | 2 | Arrow Electronics | DMP3085LSD-13 | Diodes Inc. | DMP3085LSD-13 | 0.2721 | Mouser | 621-DMP3085LSD-13 | Diodes Inc. | DMP3085LSD-13 | 0.6700
CMP-1058-00959-1 | Q6_FFSWDrive1, Q6_FFSWDrive2, Q6_FFSWDrive3, Q6_FFSWDrive4, Q6_FFSWDrive5, Q6_FFSWDrive6, Q7_FFSWDrive1, Q7_FFSWDrive2, Q7_FFSWDrive3, Q7_FFSWDrive4, Q7_FFSWDrive5, Q7_FFSWDrive6 | Power MOSFET, Complementary, 30 V, +2.9 / -2.2 A, 6-Pin TSOP, Pb-Free, Tape and Reel | 12 | Arrow Electronics | NTGD4167CT1G | onsemi | NTGD4167CT1G | 0.2858 | Arrow Electronics | NTGD4167CT1G | onsemi | NTGD4167CT1G | 0.5157
CMP-07173-000101-1 | Q8 | MOSFET N-CH 50V 220MA SOT-23 | 1 | DigiKey | BSS138DKR-ND | onsemi | BSS138 | 0.3200 | DigiKey | BSS138CT-ND | onsemi | BSS138 | 0.3200
CMP-2000-06942-1 | R1, R2, R15, R16, R26_FFSWDrive1, R26_FFSWDrive2, R26_FFSWDrive3, R26_FFSWDrive4, R26_FFSWDrive5, R26_FFSWDrive6, R27_FFSWDrive1, R27_FFSWDrive2, R27_FFSWDrive3, R27_FFSWDrive4, R27_FFSWDrive5, R27_FFSWDrive6, R28_FVOADrive1, R28_FVOADrive2, R28_FVOADrive3, R28_FVOADrive4, R28_FVOADrive5, R28_FVOADrive6, R29_FVOADrive1, R29_FVOADrive2, R29_FVOADrive3, R29_FVOADrive4, R29_FVOADrive5, R29_FVOADrive6 | Chip Resistor, 4.7 KOhm, +/- 1%, 0.1 W, -55 to 155 degC, 0603 (1608 Metric), RoHS, Tape and Reel | 28 | Newark | RC0603FR-074K7L | Yageo Group | RC0603FR-074K7L | 0.0120 | Newark | RC0603FR-074K7L | Yageo Group | RC0603FR-074K7L | 0.0120
CMP-2100-03664-2 | R3, R5, R6, R11, R12, R13, R14, R17, R21, R22, R23, R24, R25 | RES 10K OHM 1% 1/10W 0603 | 13 | Mouser | 603-RC0603FR-0710KL | Yageo Group | RC0603FR-0710KL | 0.0140 | Mouser | 603-RC0603FR-0710KL | Yageo Group | RC0603FR-0710KL | 0.0140
CMP-2000-03661-2 | R4 | RES SMD 50 OHM 0.1% 1/8W 0603 | 1 | Avnet | FC0603E50R0BTBST1 | Vishay | FC0603E50R0BTBST1 | 3.8400 | Avnet | FC0603E50R0BTBST1 | Vishay | FC0603E50R0BTBST1 | 3.8400
NOMCT16032002AT1 | R7, R8 | NOMCT 16P ISO 20K 0.1%ABS 0.05%RAT T1 e3 | 2 | Mouser | 71-NOMCT16032002AT1 | Vishay | NOMCT16032002AT1 | 6.9300
CMP-03412-024216-1 | R19 | RES SMD 21K OHM 1% 1/10W 0603 | 1 | Mouser | 603-RT0603FRE0721KL | Yageo Group | RT0603FRE0721KL | 0.0110 | Mouser | 603-RT0603FRE0721KL | Yageo Group | RT0603FRE0721KL | 0.0110
CMP-03412-020828-1 | R20 | RES SMD 732 OHM 1% 1/10W 0603 | 1 | Arrow Electronics | RT0603FRE07732RL | Yageo Group | RT0603FRE07732RL | 0.0068 | Arrow Electronics | RT0603FRE07732RL | Yageo Group | RT0603FRE07732RL | 0.0068
CMP-1012-00552-1 | R30_FVOADrive1, R30_FVOADrive2, R30_FVOADrive3, R30_FVOADrive4, R30_FVOADrive5, R30_FVOADrive6, R31_FVOADrive1, R31_FVOADrive2, R31_FVOADrive3, R31_FVOADrive4, R31_FVOADrive5, R31_FVOADrive6 | 2K43 0.1W 1% 0603 (1608 Metric) SMD | 12 | Arrow Electronics | CRCW06032K43FKEA | Vishay | CRCW06032K43FKEA | 0.0012 | Arrow Electronics | CRCW06032K43FKEA | Vishay | CRCW06032K43FKEA | 0.0025
CMP-0253-00019-2 | U1 | High-Precision 1-Wire Digital Thermometer, -55 to 125 degC, 8-Pin SOIC (S8+2), Pb-Free | 1 | Mouser | 700-DS18B20Z | Analog Devices | DS18B20Z+ | 6.2500 | DigiKey | DS18B20Z+-ND | Analog Devices | DS18B20Z+ | 6.8200
CMP-04875-000067-1 | U2 | IC TRANSCEIVER HALF 1/1 8SOIC | 1 | DigiKey | 296-53046-1-ND | Texas Instruments | THVD1429DT | 5.8100 | DigiKey | 296-53046-6-ND | Texas Instruments | THVD1429DT | 5.8100
CMP-019-00054-1 | U3 | 150-mA, 16-V, low-dropout voltage regulator with enable 5-SOT-23 -40 to 125 | 1 | Mouser | 926-LP2985AIM5X33NPB | Texas Instruments | LP2985AIM5X-3.3/NOPB | 0.7500 | DigiKey | LP2985AIM5X-3.3/NOPBCT-ND | Texas Instruments | LP2985AIM5X-3.3/NOPB | 0.7600
CMP-0003-00378-2 | U4 | 16-Bit ADC with Integrated Multiplexer, PGA, Comparator, Oscillator, and Reference, -40 to 125 degC, 10-pin SOP (DGS10), Green (RoHS & no Sb/Br) | 1 | Arrow Electronics | ADS1115IDGST | Texas Instruments | ADS1115IDGST | 6.0000 | Newark | ADS1115IDGST | Texas Instruments | ADS1115IDGST | 6.3500
CMP-0387-00758-2 | U5, U6 | 3 A, Wide-Input, Adjustable Switching Regulator Module, -40 to 85 degC, 7-pin Module (EUY7), Pb-Free (RoHS) | 2 | Mouser | 595-PTN78060WAZ | Texas Instruments | PTN78060WAZ | 31.9000 | DigiKey | 296-20525-ND | Texas Instruments | PTN78060WAZ | 32.5000
CMP-10112-000009-1 | U7 | IC I/O EXPANDER 16BIT 24HWQFN | 1 | Newark | PCAL6416AHF,128 | NXP Semiconductors | PCAL6416AHF,128 | 1.5200 | Mouser | 771-PCAL6416AHF,128 | NXP Semiconductors | PCAL6416AHF,128 | 1.5900
CMP-0004-01214-1 | U8, U9 | 12-Bit, Octal Channel, Ultra-Low Glitch, Voltage Output, 2-Wire Interface DAC with 2.5 V Internal Reference, -40 to 125 degC, 16-pin SOP (PW16), Green (RoHS & no Sb/Br) | 2 | DigiKey | 296-DAC7678SPWRCT-ND | Texas Instruments | DAC7678SPWR | 15.2900 | DigiKey | 296-DAC7678SPWRDKR-ND | Texas Instruments | DAC7678SPWR | 15.2900
CMP-04895-000242-1 | U10_FVOADrive1, U10_FVOADrive2, U10_FVOADrive3, U10_FVOADrive4, U10_FVOADrive5, U10_FVOADrive6 | IC OPAMP GP 2 CIRCUIT 8SOIC | 6 | Arrow Electronics | OPA2991IDR | Texas Instruments | OPA2991IDR | 1.5600 | DigiKey | 296-OPA2991IDRDKR-ND | Texas Instruments | OPA2991IDR | 1.8800
CMP-0367-00146-2 | U12, U13 | 30 ppm / degC Drift, 3.9 uA Voltage Reference, -40 to 125 degC, 3-pin SOT-23 (DBZ), Green (RoHS & no Sb/Br) | 2 | Arrow Electronics | REF3333AIDBZR | Texas Instruments | REF3333AIDBZR | 1.6700 | Mouser | 595-REF3333AIDBZR | Texas Instruments | REF3333AIDBZR | 1.7300

Sheet: Project Information
Project Full Path | C:\Users\Public\Documents\Altium\FIB_Switcher\FIB_Switcher.PrjPcb
Project Filename | FIB_Switcher.PrjPcb
Variant Name | TIB
Data-Source Filename | ActiveBOM.BomDoc
Data-Source Full Path | C:\Users\Public\Documents\Altium\FIB_Switcher\ActiveBOM.BomDoc
Title | Copy of Copy of Copy of Copy of Copy of Bill of Materials for Variant [TIB] of BOM Document [ActiveBOM.BomDoc]
Total Quantity | 212
Report Time | 12:18 PM
Report Date | 9/4/2026
Report Date & Tine | 9/4/2026 12:18 PM
Output Name | Copy of Copy of Copy of Copy of Copy of Bill of Materials
Output Type | BomReport
Output Generator Name | BOM
Output Generator Description | Bill of Materials
