COO-Utilities/hispec-tib/pcb/FIB_Switcher TIB Schematic Print.PDF

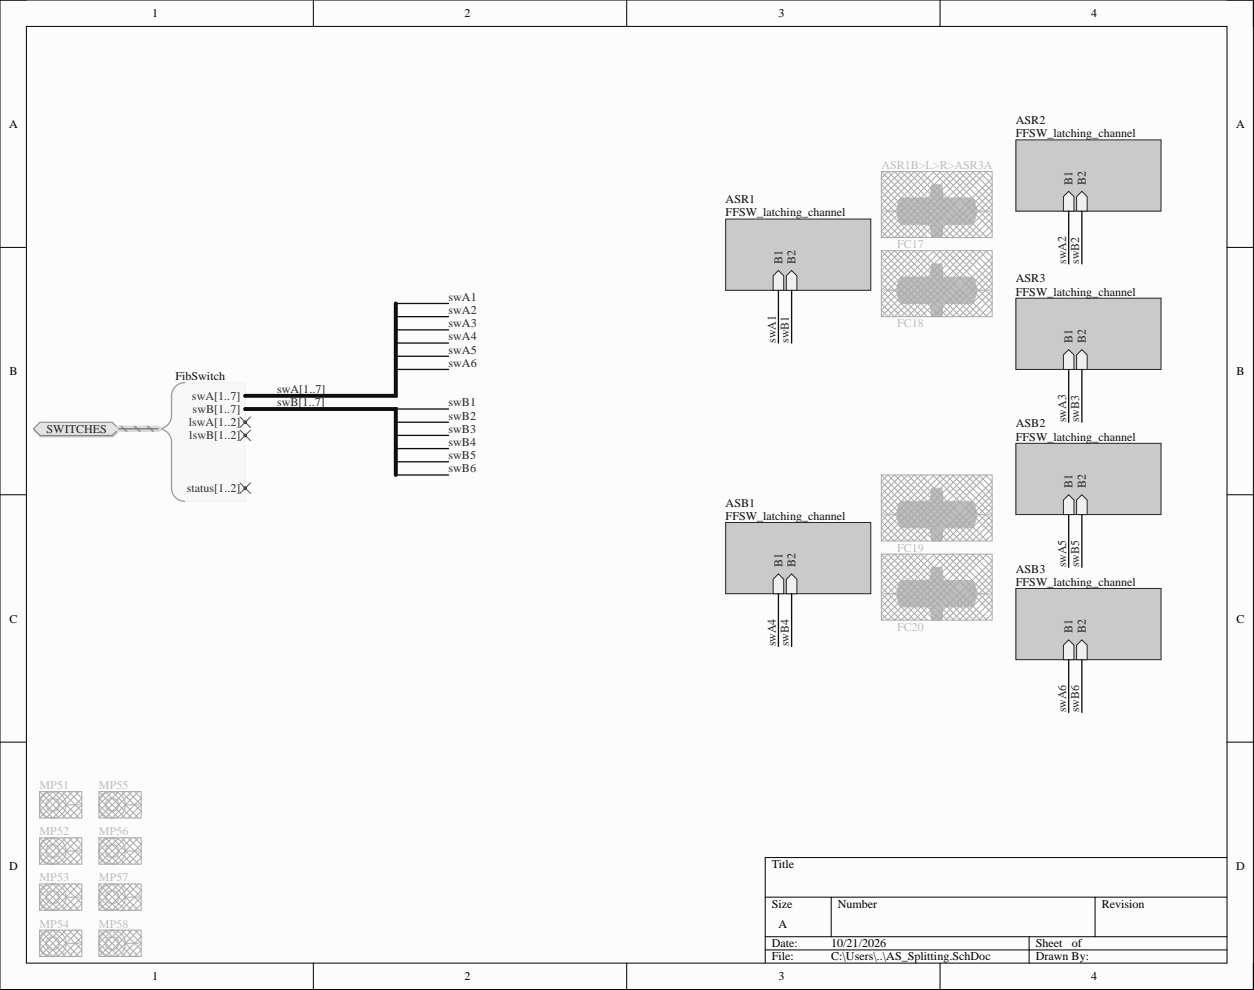
[picture p1: page 1]

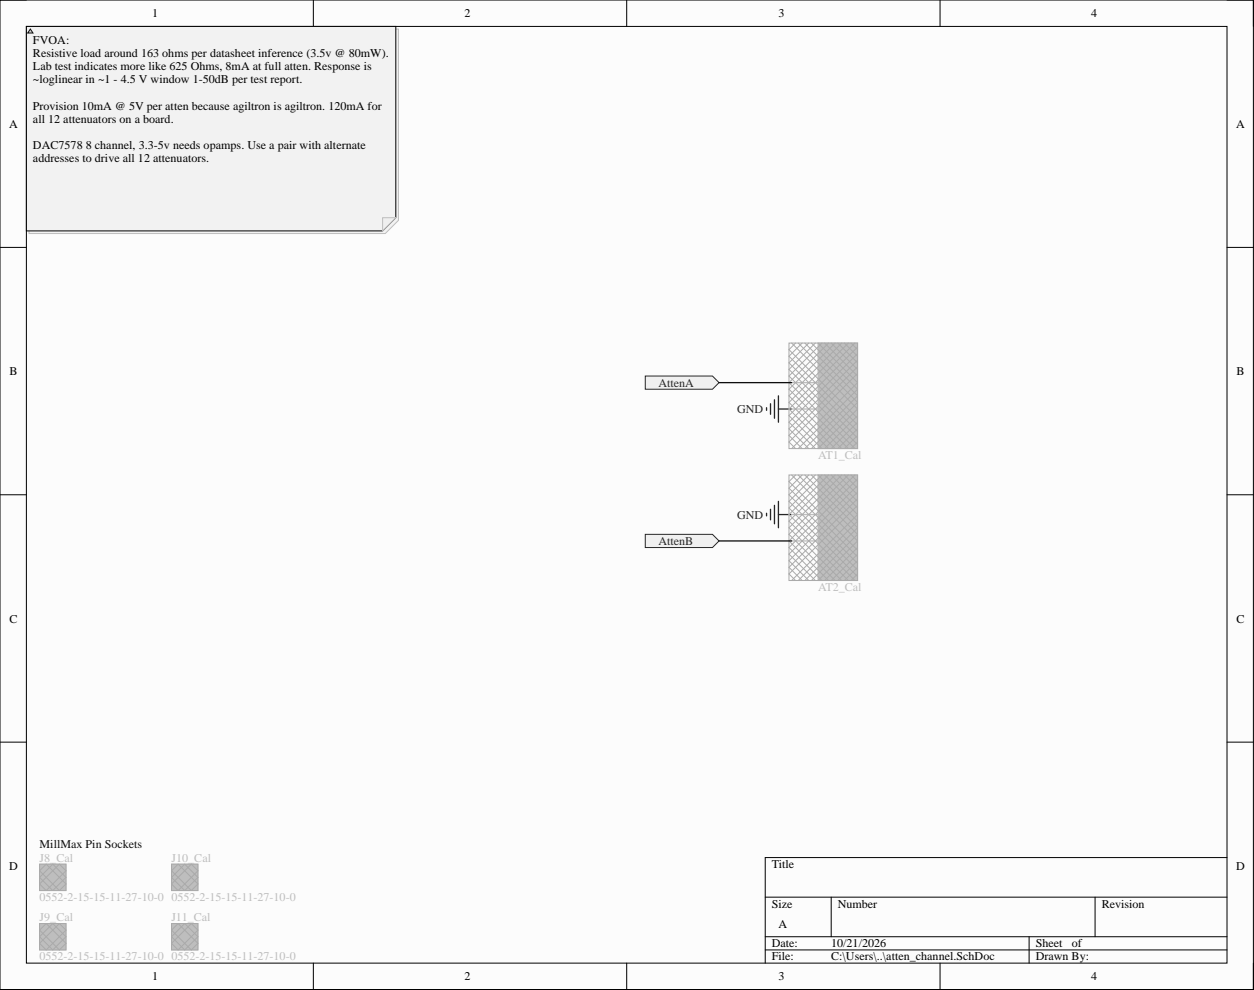
[picture p2: page 2]

FVOA:
Resistive load around 163 ohms per datasheet inference (3.5v @ 80mW).
Lab test indicates more like 625 Ohms, 8mA at full atten. Response is
~loglinear in ~1 - 4.5 V window 1-50dB per test report.

Provision 10mA @ 5V per atten because agiltron is agiltron. 120mA for
all 12 attenuators on a board.

DAC7578 8 channel, 3.3-5v needs opamps. Use a pair with alternate
addresses to drive all 12 attenuators.

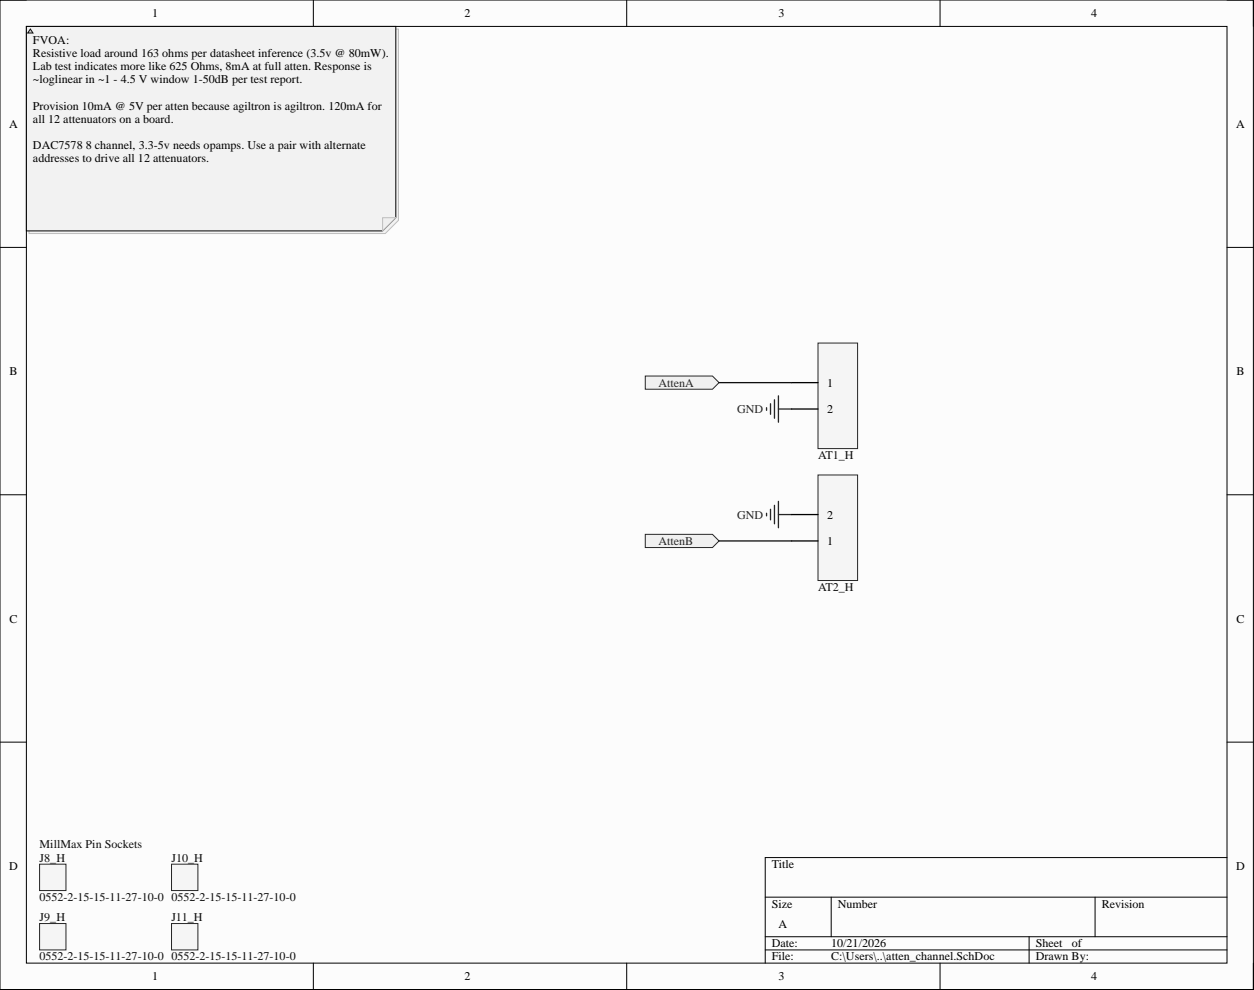
[picture p3: page 3]

FVOA:
Resistive load around 163 ohms per datasheet inference (3.5v @ 80mW).
Lab test indicates more like 625 Ohms, 8mA at full atten. Response is
~loglinear in ~1 - 4.5 V window 1-50dB per test report.

Provision 10mA @ 5V per atten because agiltron is agiltron. 120mA for
all 12 attenuators on a board.

DAC7578 8 channel, 3.3-5v needs opamps. Use a pair with alternate
addresses to drive all 12 attenuators.

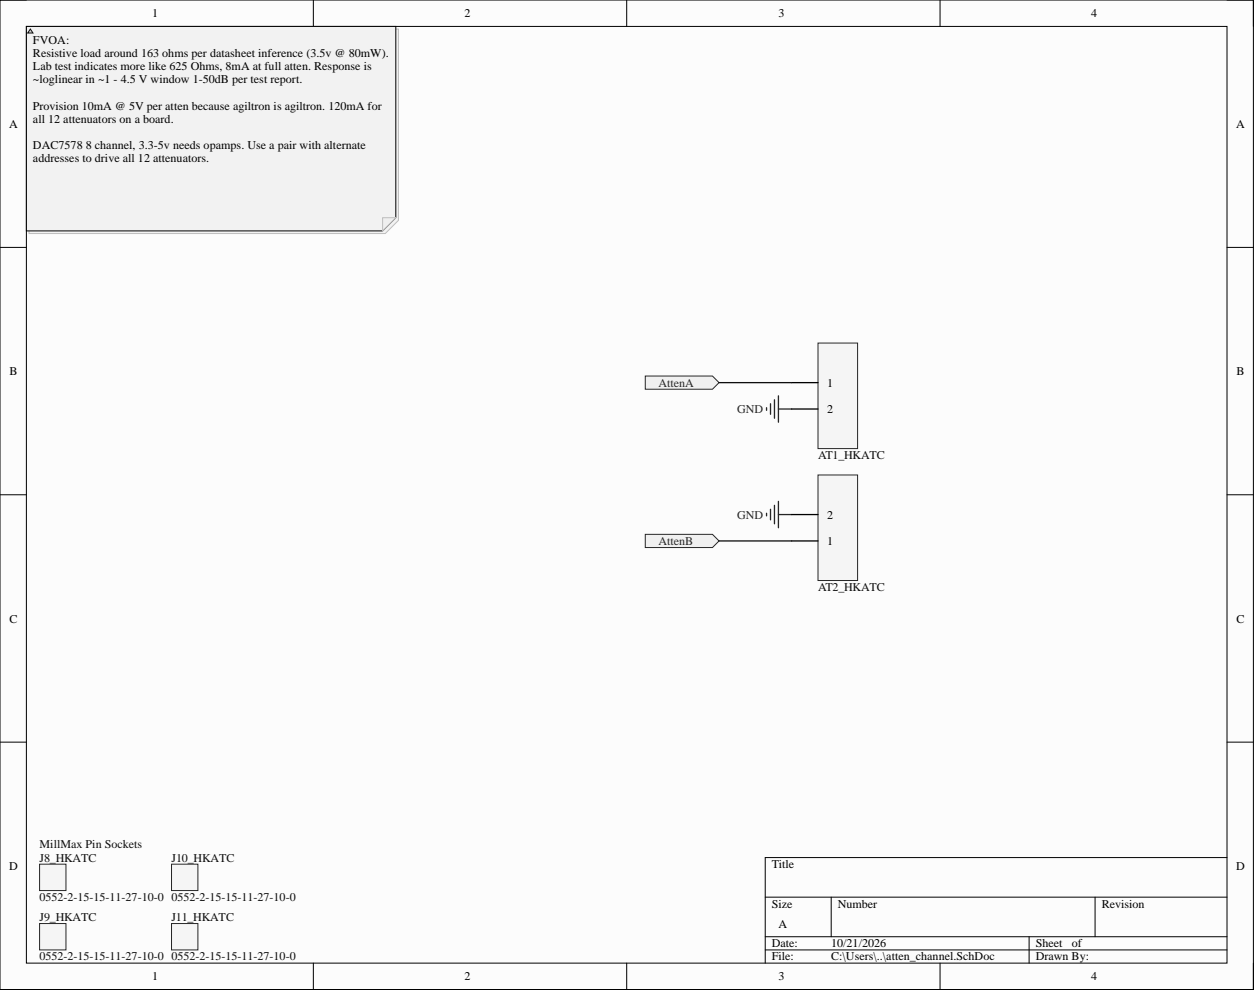
[picture p4: page 4]

FVOA:
Resistive load around 163 ohms per datasheet inference (3.5v @ 80mW).
Lab test indicates more like 625 Ohms, 8mA at full atten. Response is
~loglinear in ~1 - 4.5 V window 1-50dB per test report.

Provision 10mA @ 5V per atten because agiltron is agiltron. 120mA for
all 12 attenuators on a board.

DAC7578 8 channel, 3.3-5v needs opamps. Use a pair with alternate
addresses to drive all 12 attenuators.

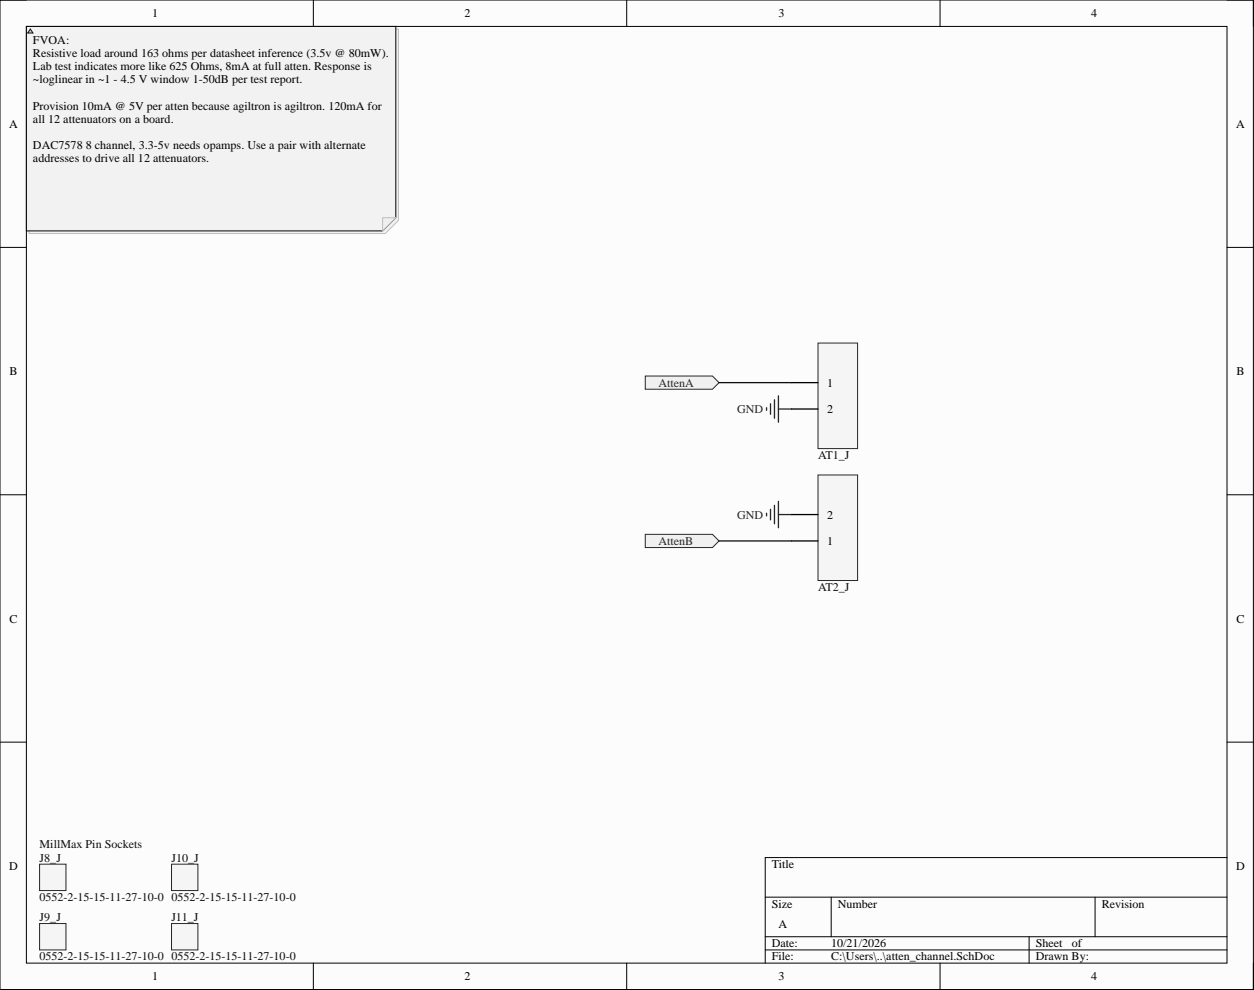
[picture p5: page 5]
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

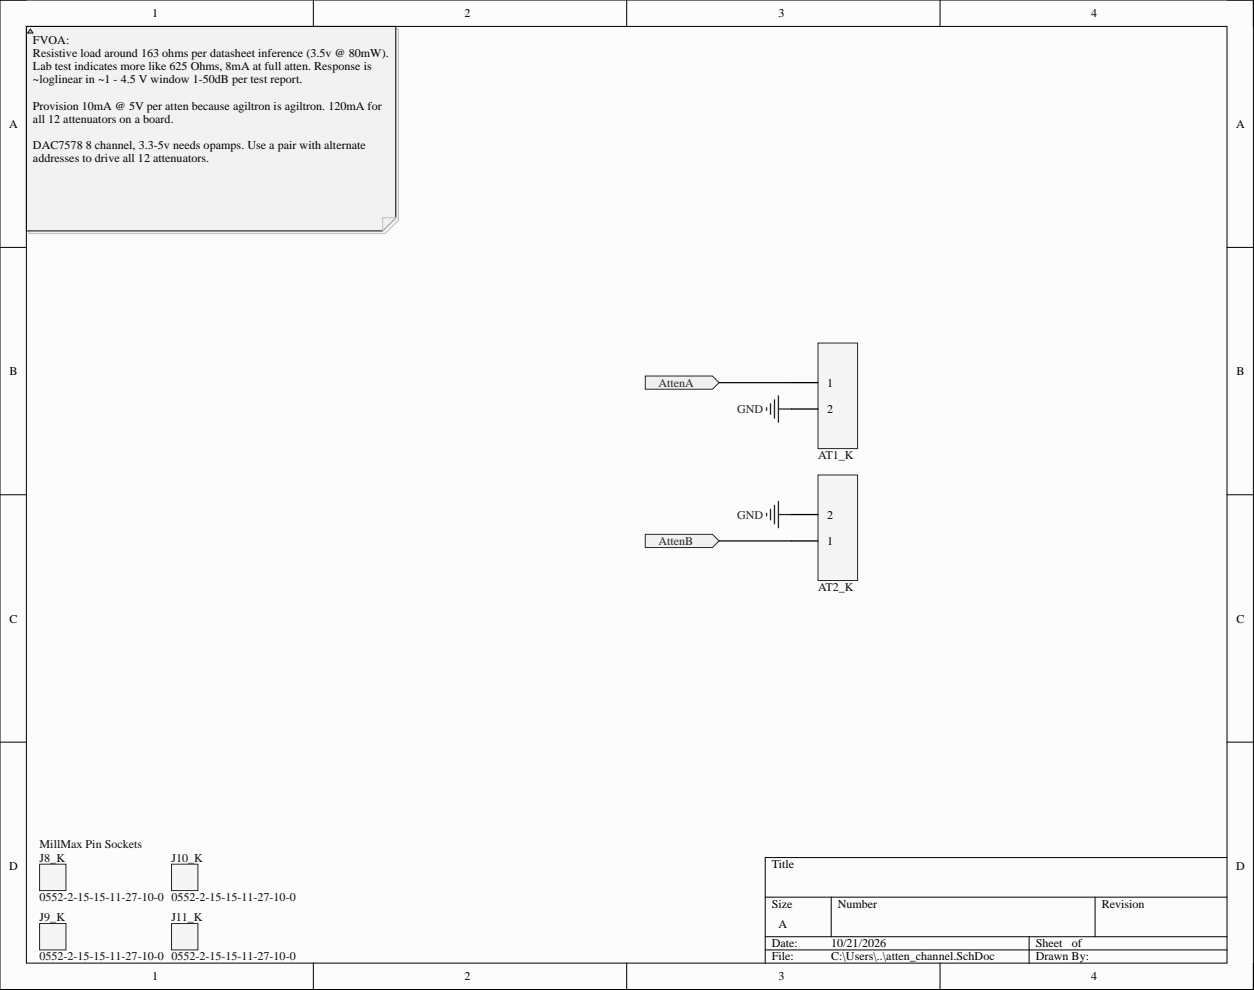
[picture p6: page 6]
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

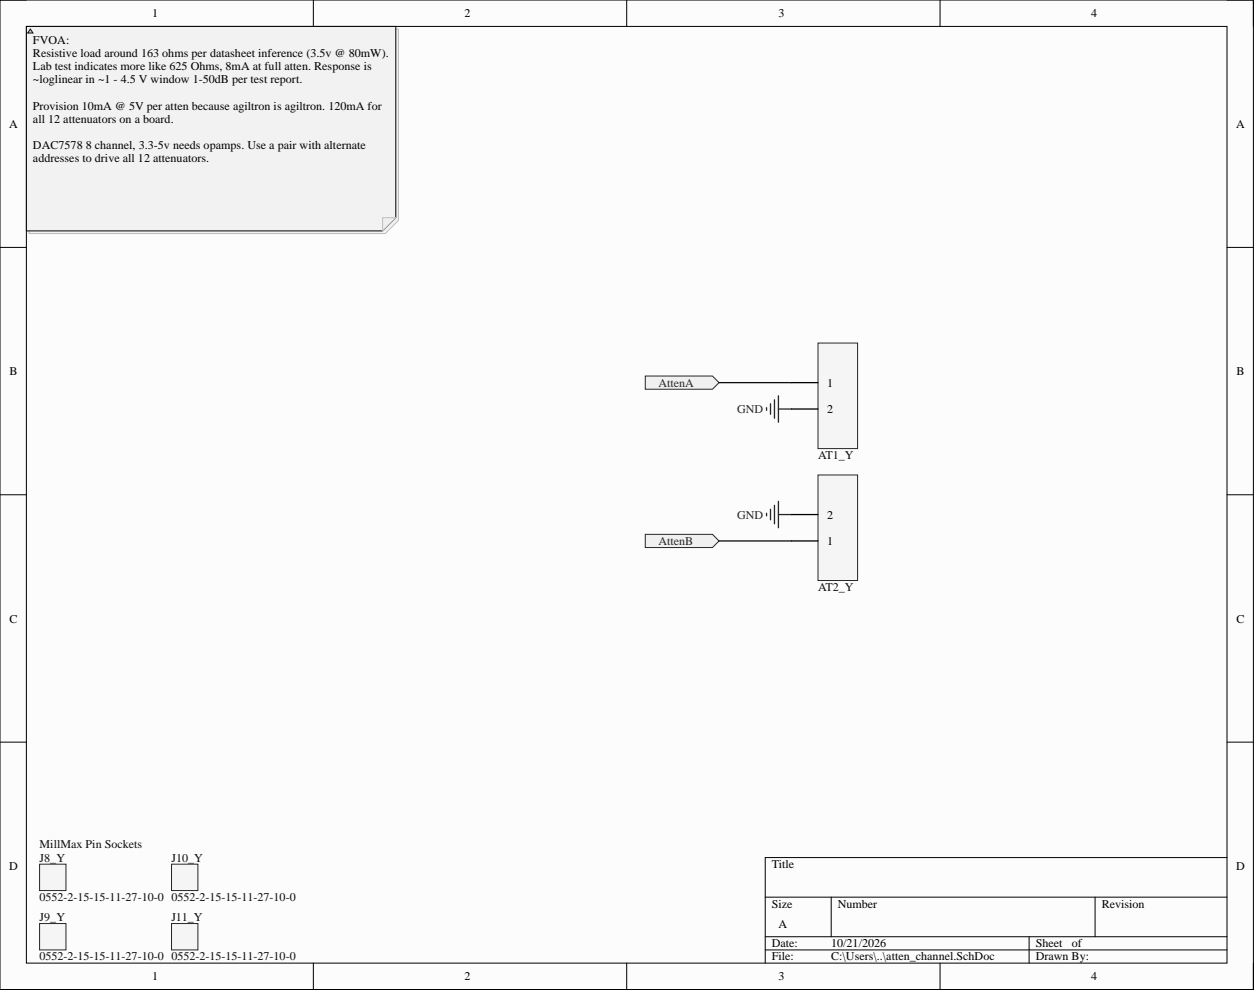
[picture p7: page 7]
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

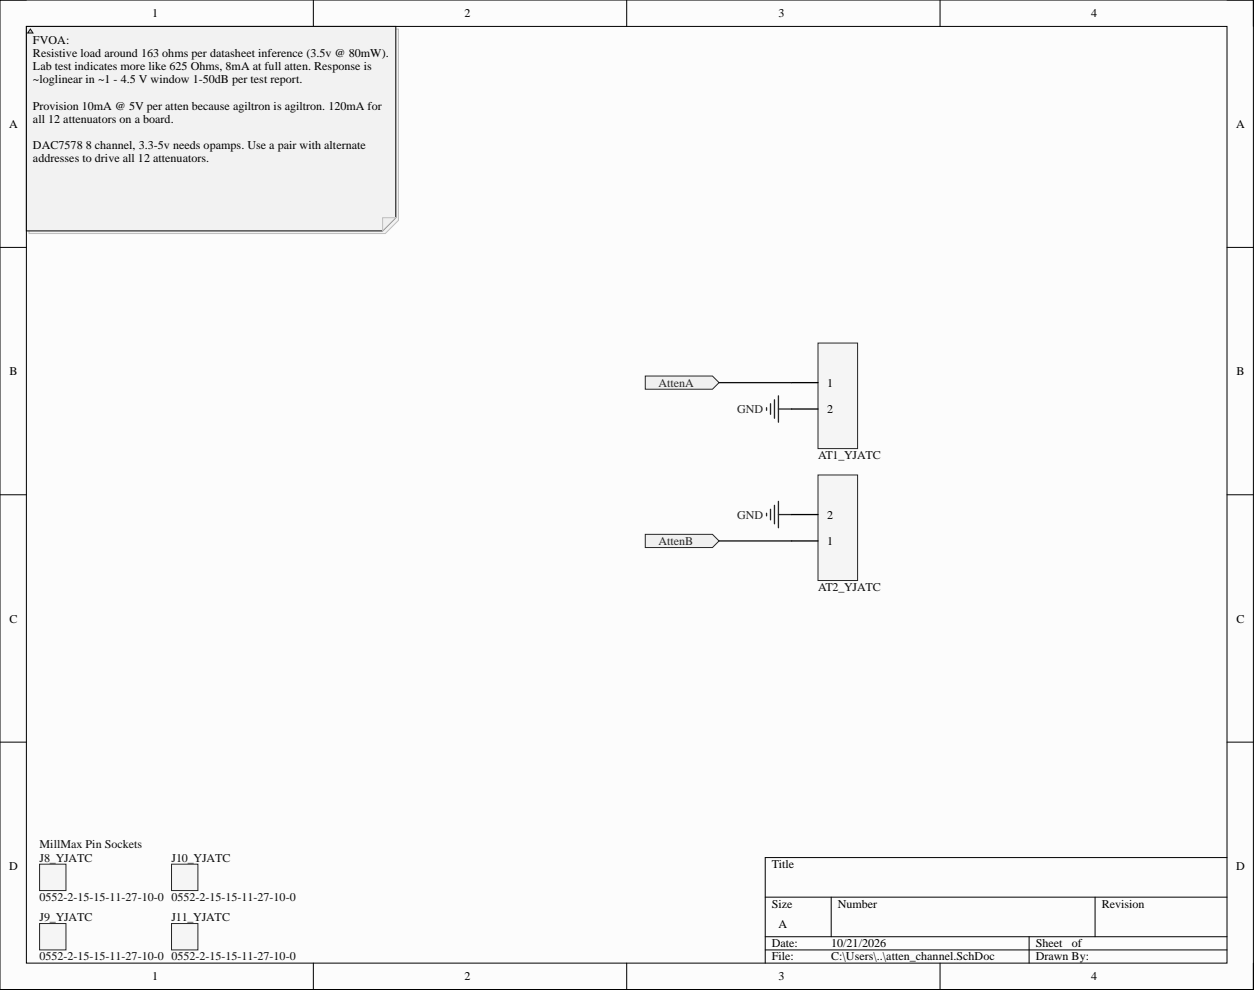
[picture p8: page 8]
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

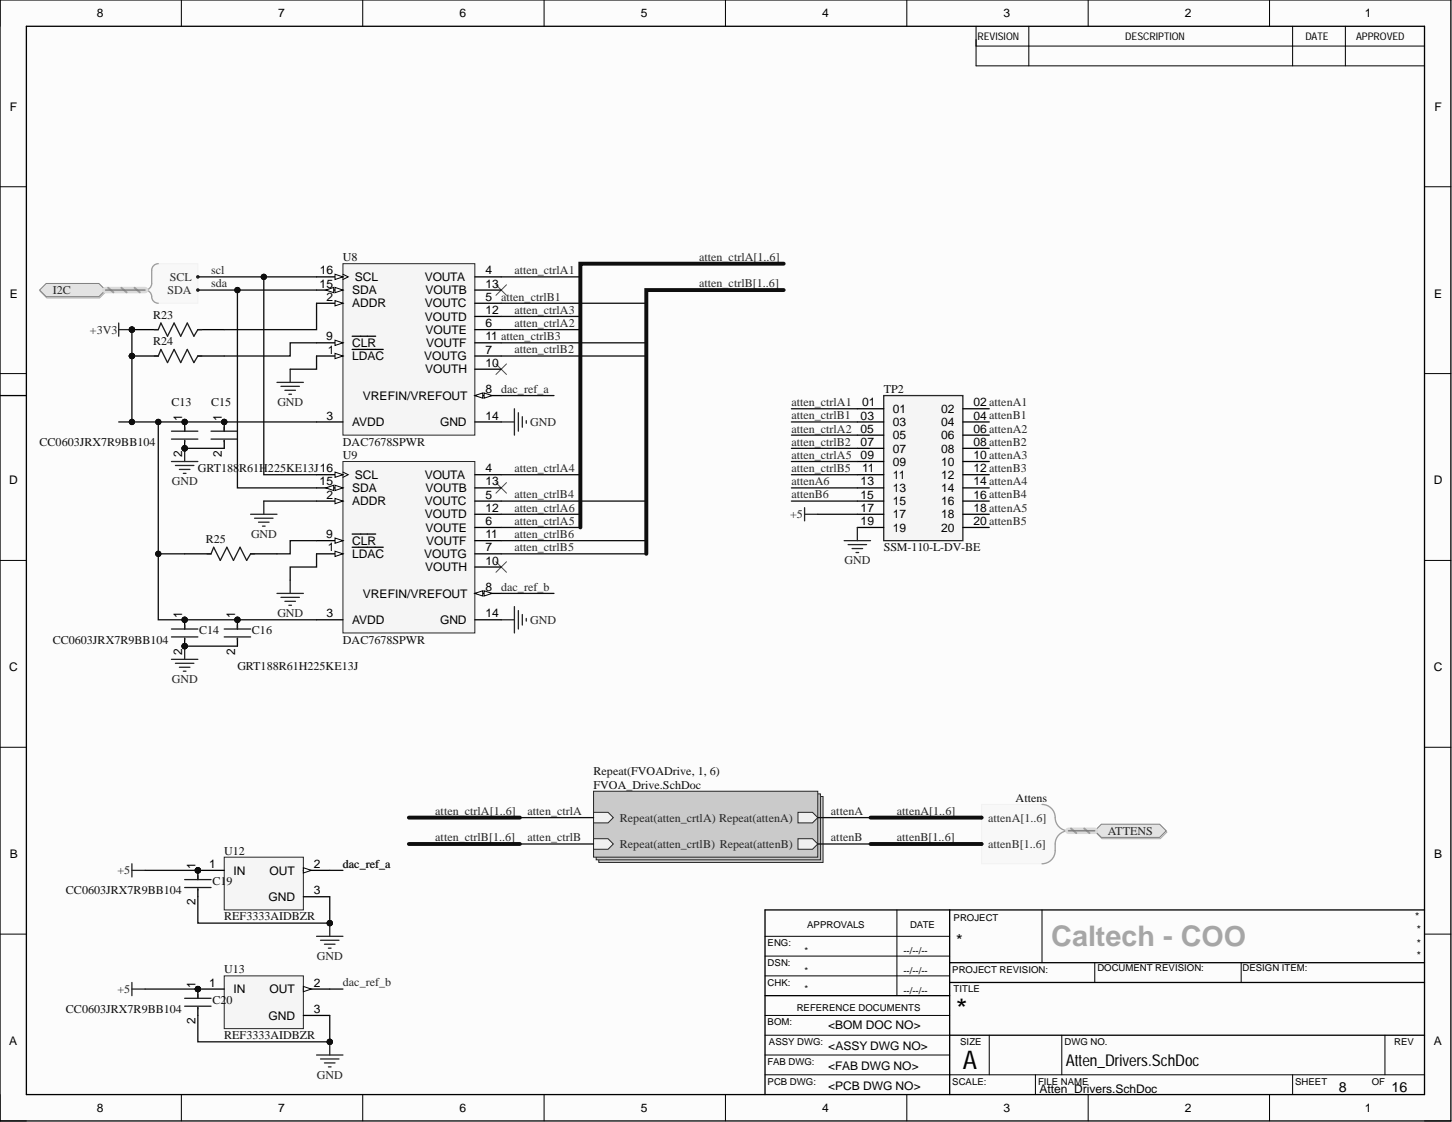
[picture p9: page 9]

DSN: * | --/--/--

PROJECT REVISION: | DOCUMENT REVISION: | DESIGN ITEM:

CHK: * | --/--/--

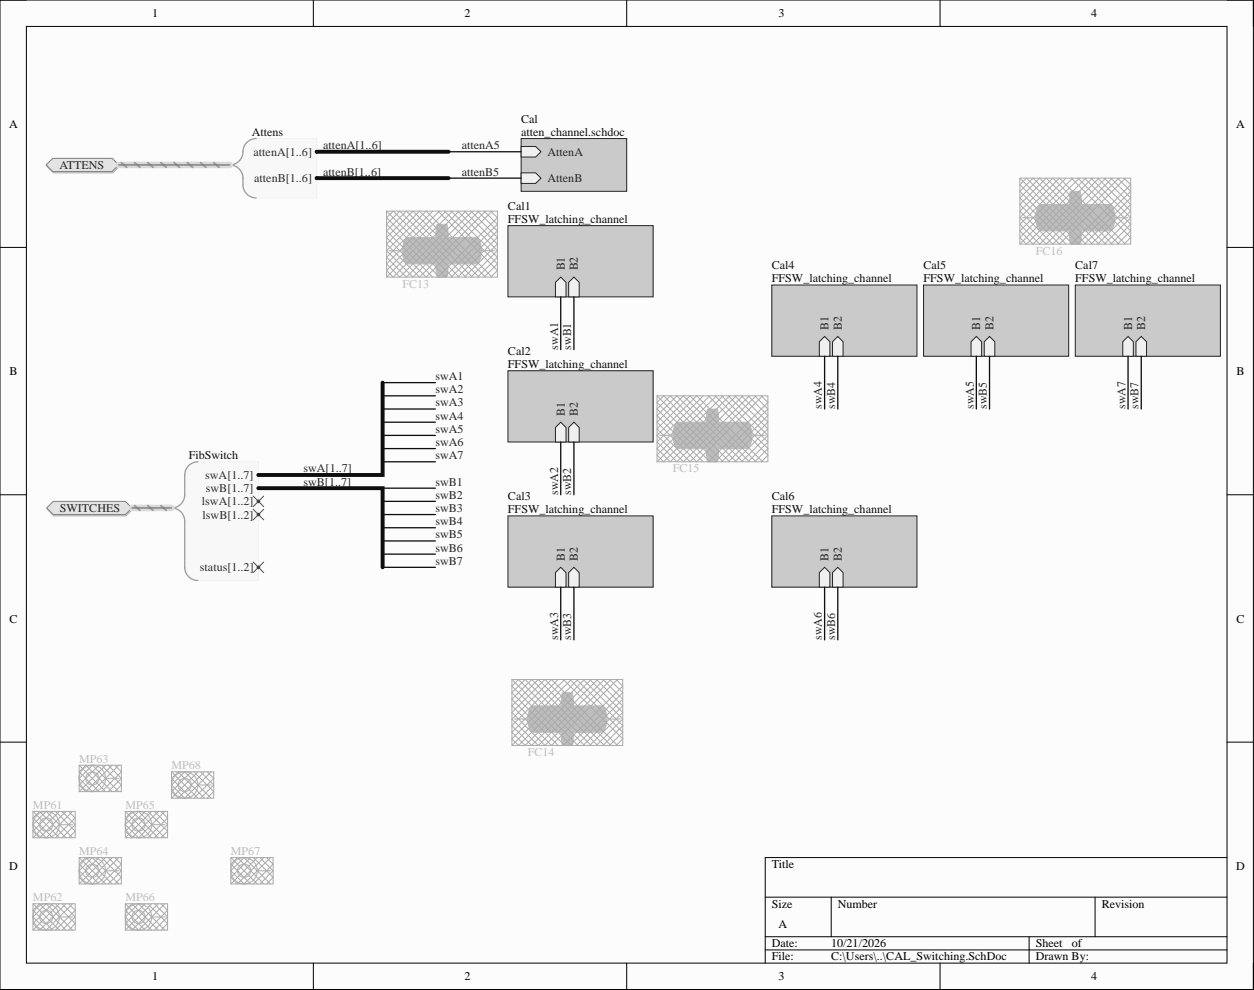
[picture p10: page 10]

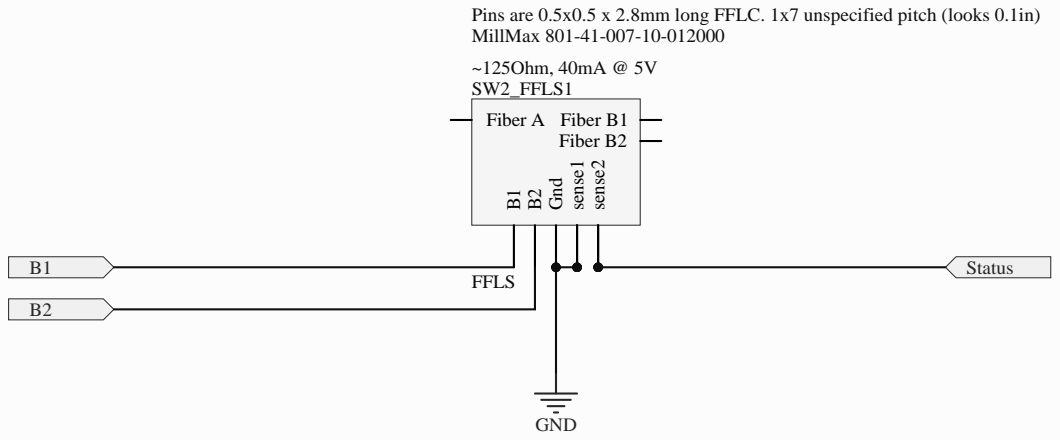
[picture p11: page 11]

Pins are 0.5x0.5 x 2.8mm long FFLC. 1x7 unspecified pitch (looks 0.1in)
MillMax 801-41-007-10-012000
~125Ohm, 40mA @ 5V
SW2_FFLS1
Fiber A Fiber B1

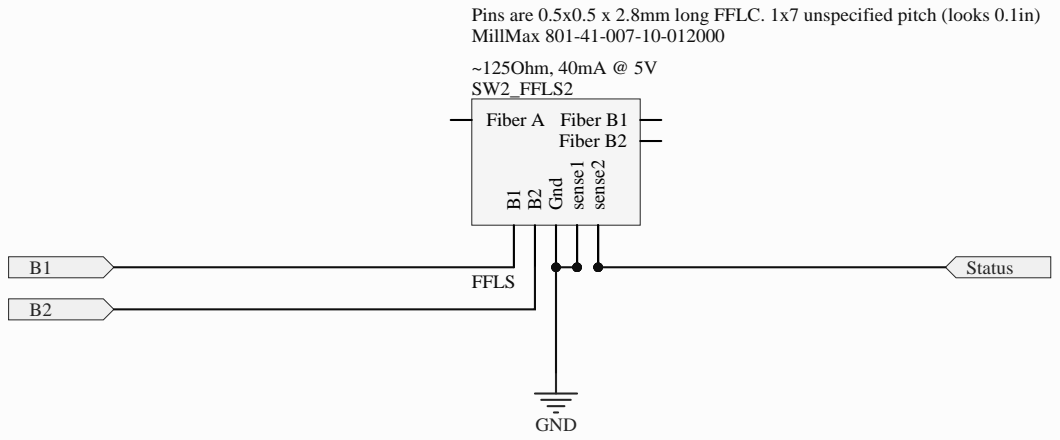
[picture p12: page 12]

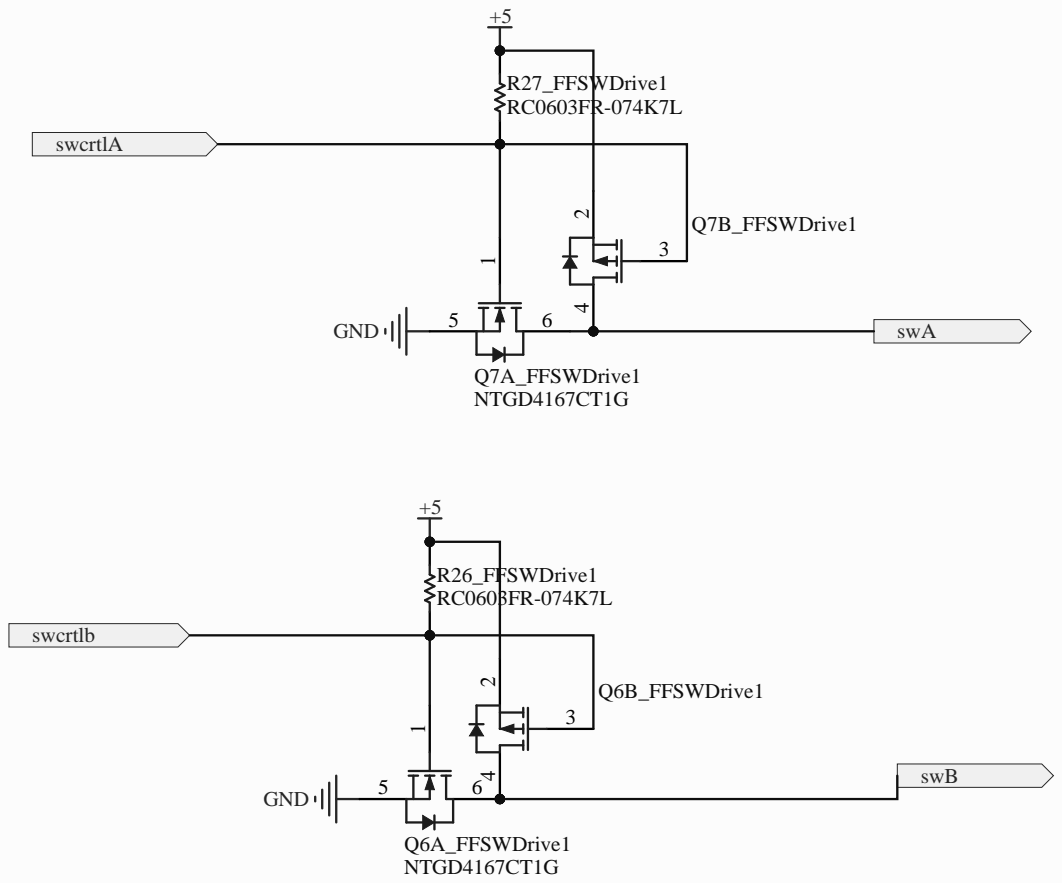
[picture p13: page 13]

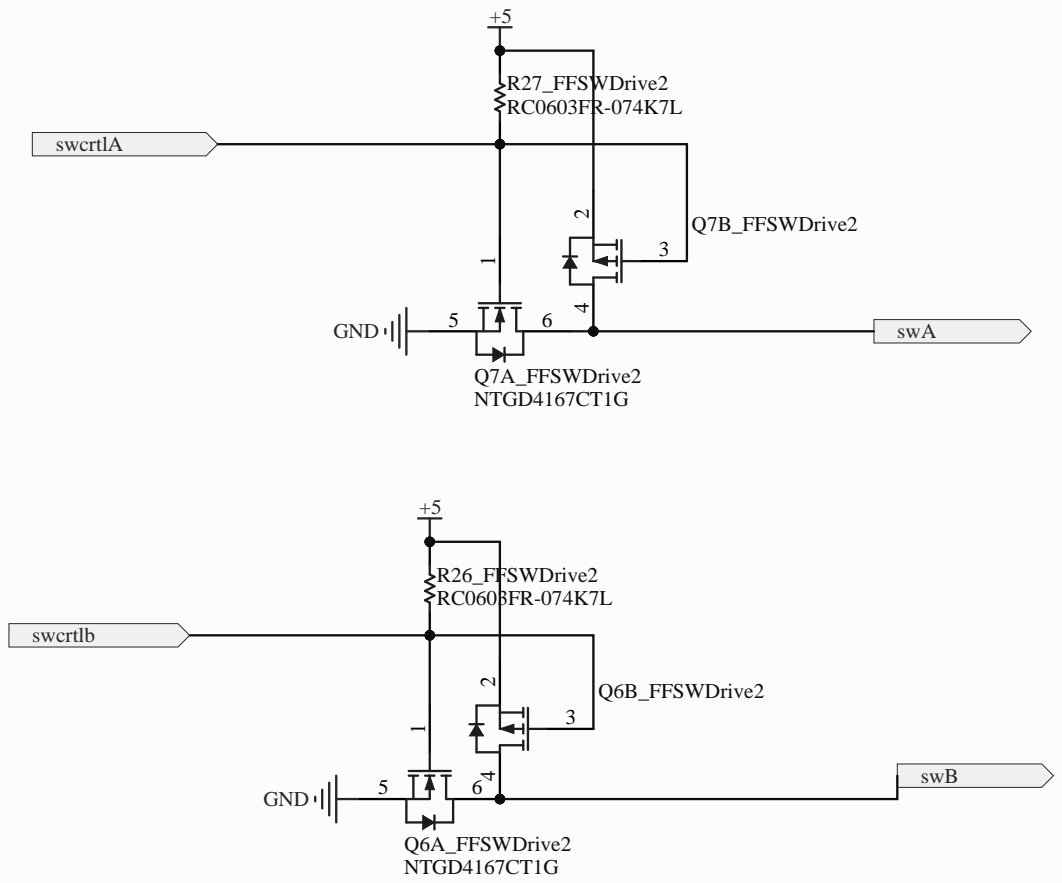
[picture p14: page 14]

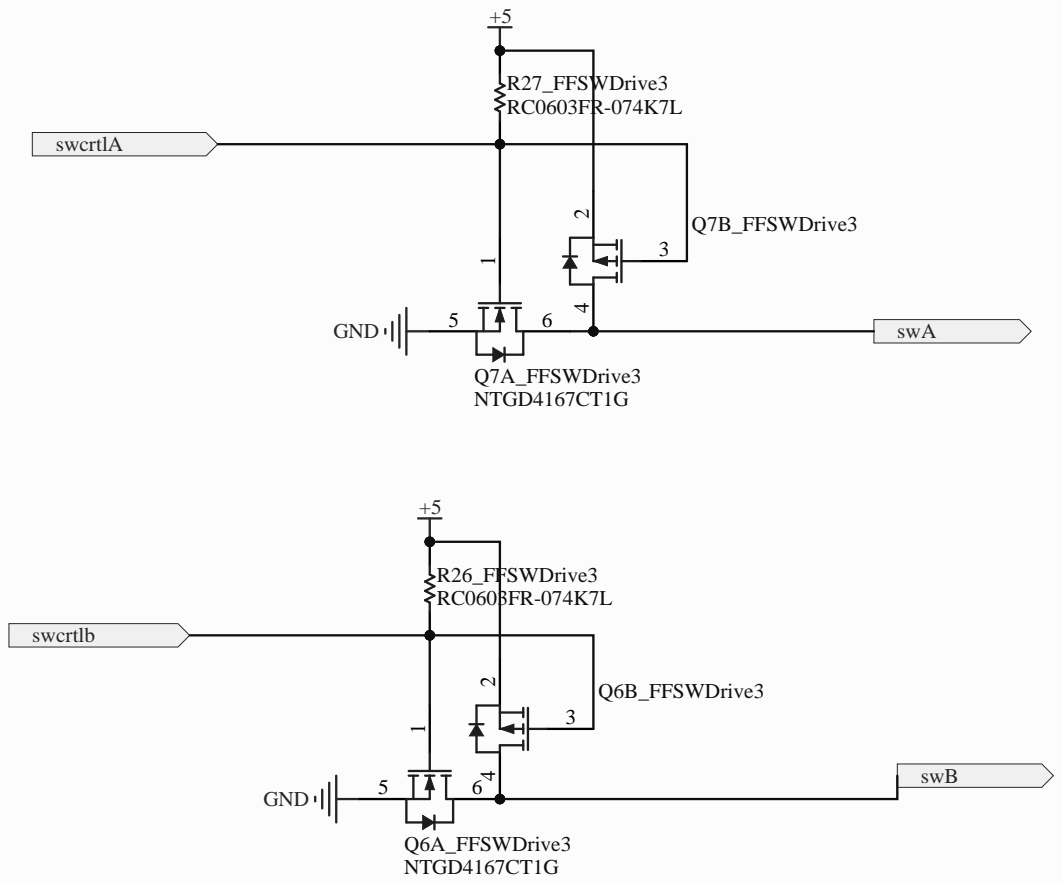
[picture p15: page 15]

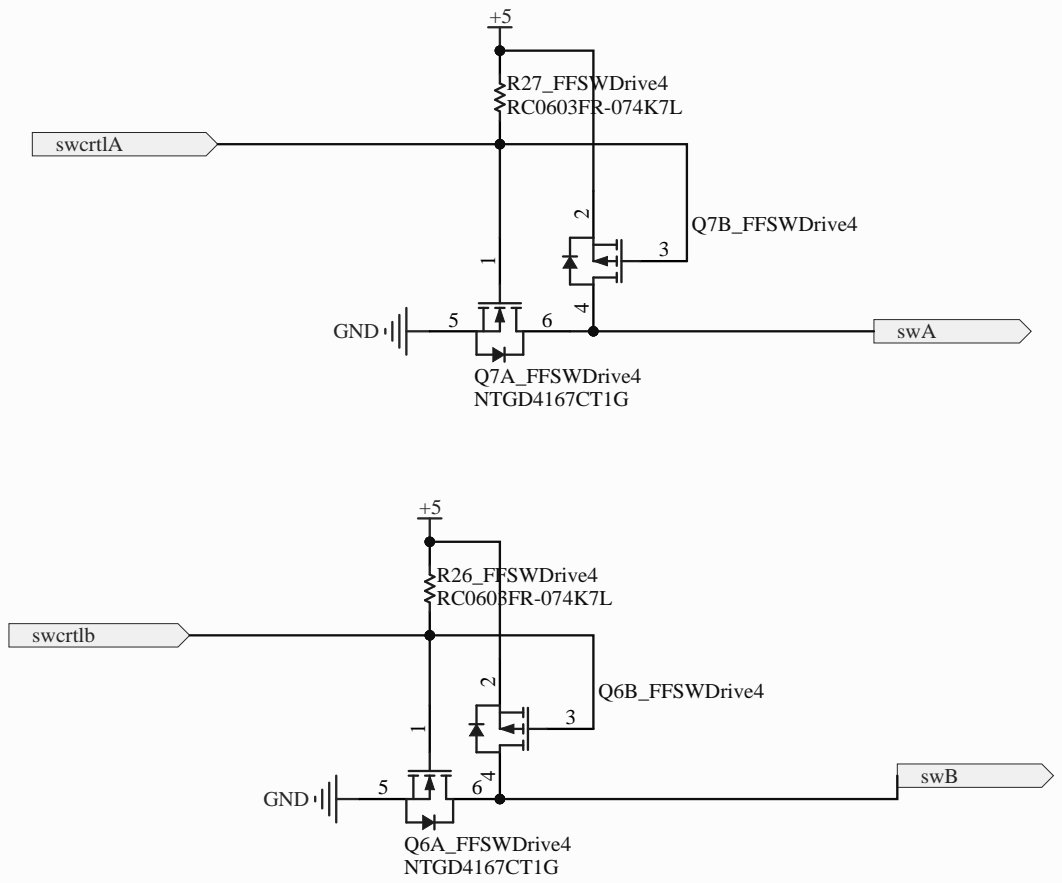
[picture p16: page 16]

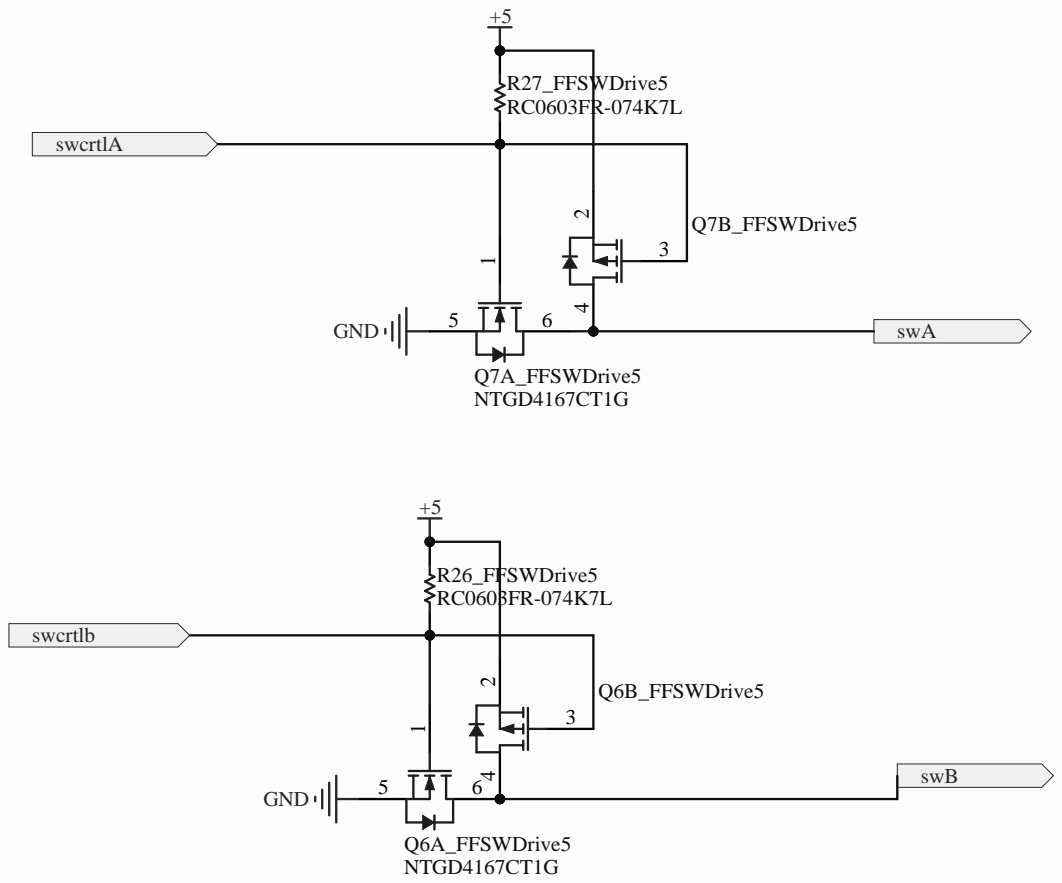
[picture p17: page 17]

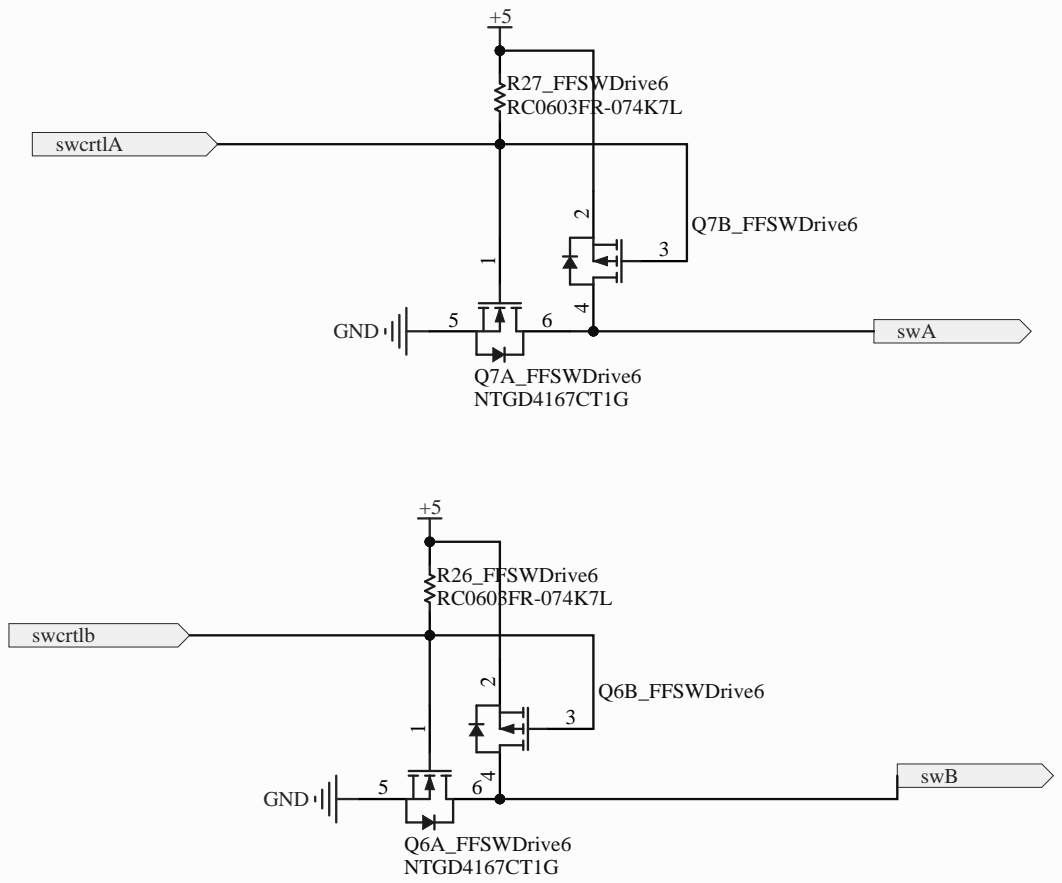
[picture p18: page 18]

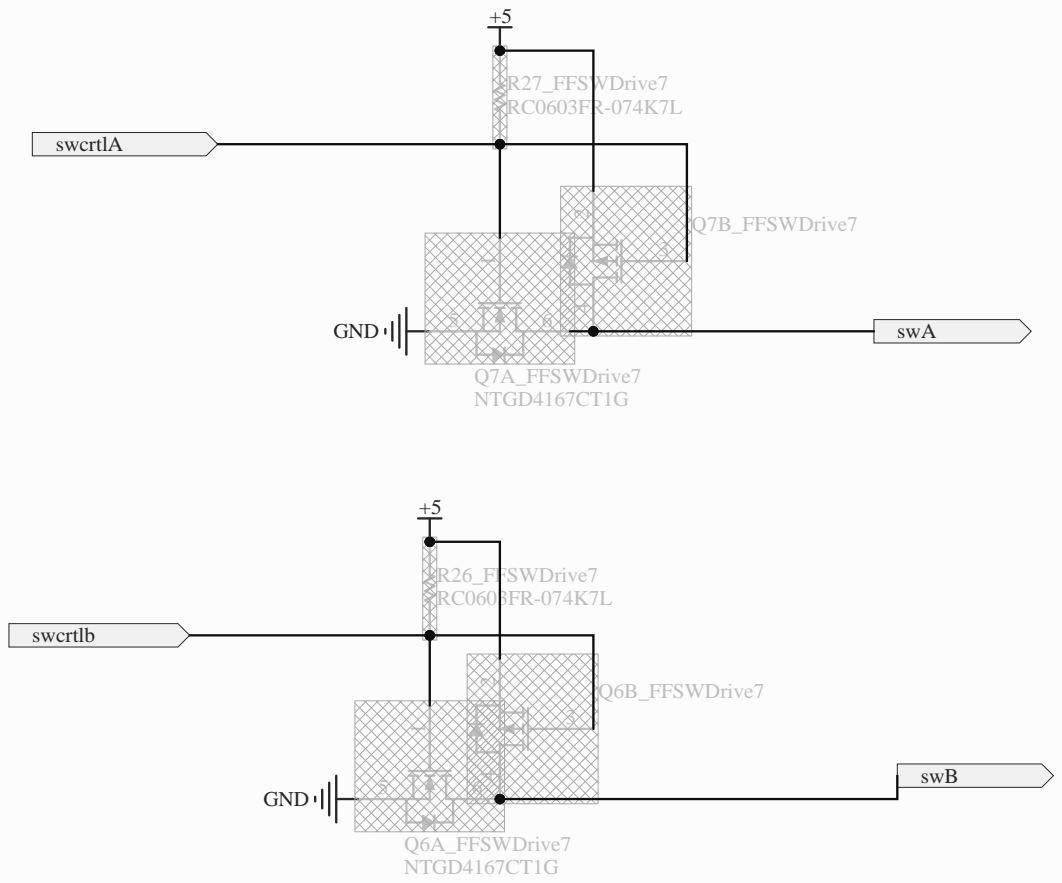
[picture p19: page 19]

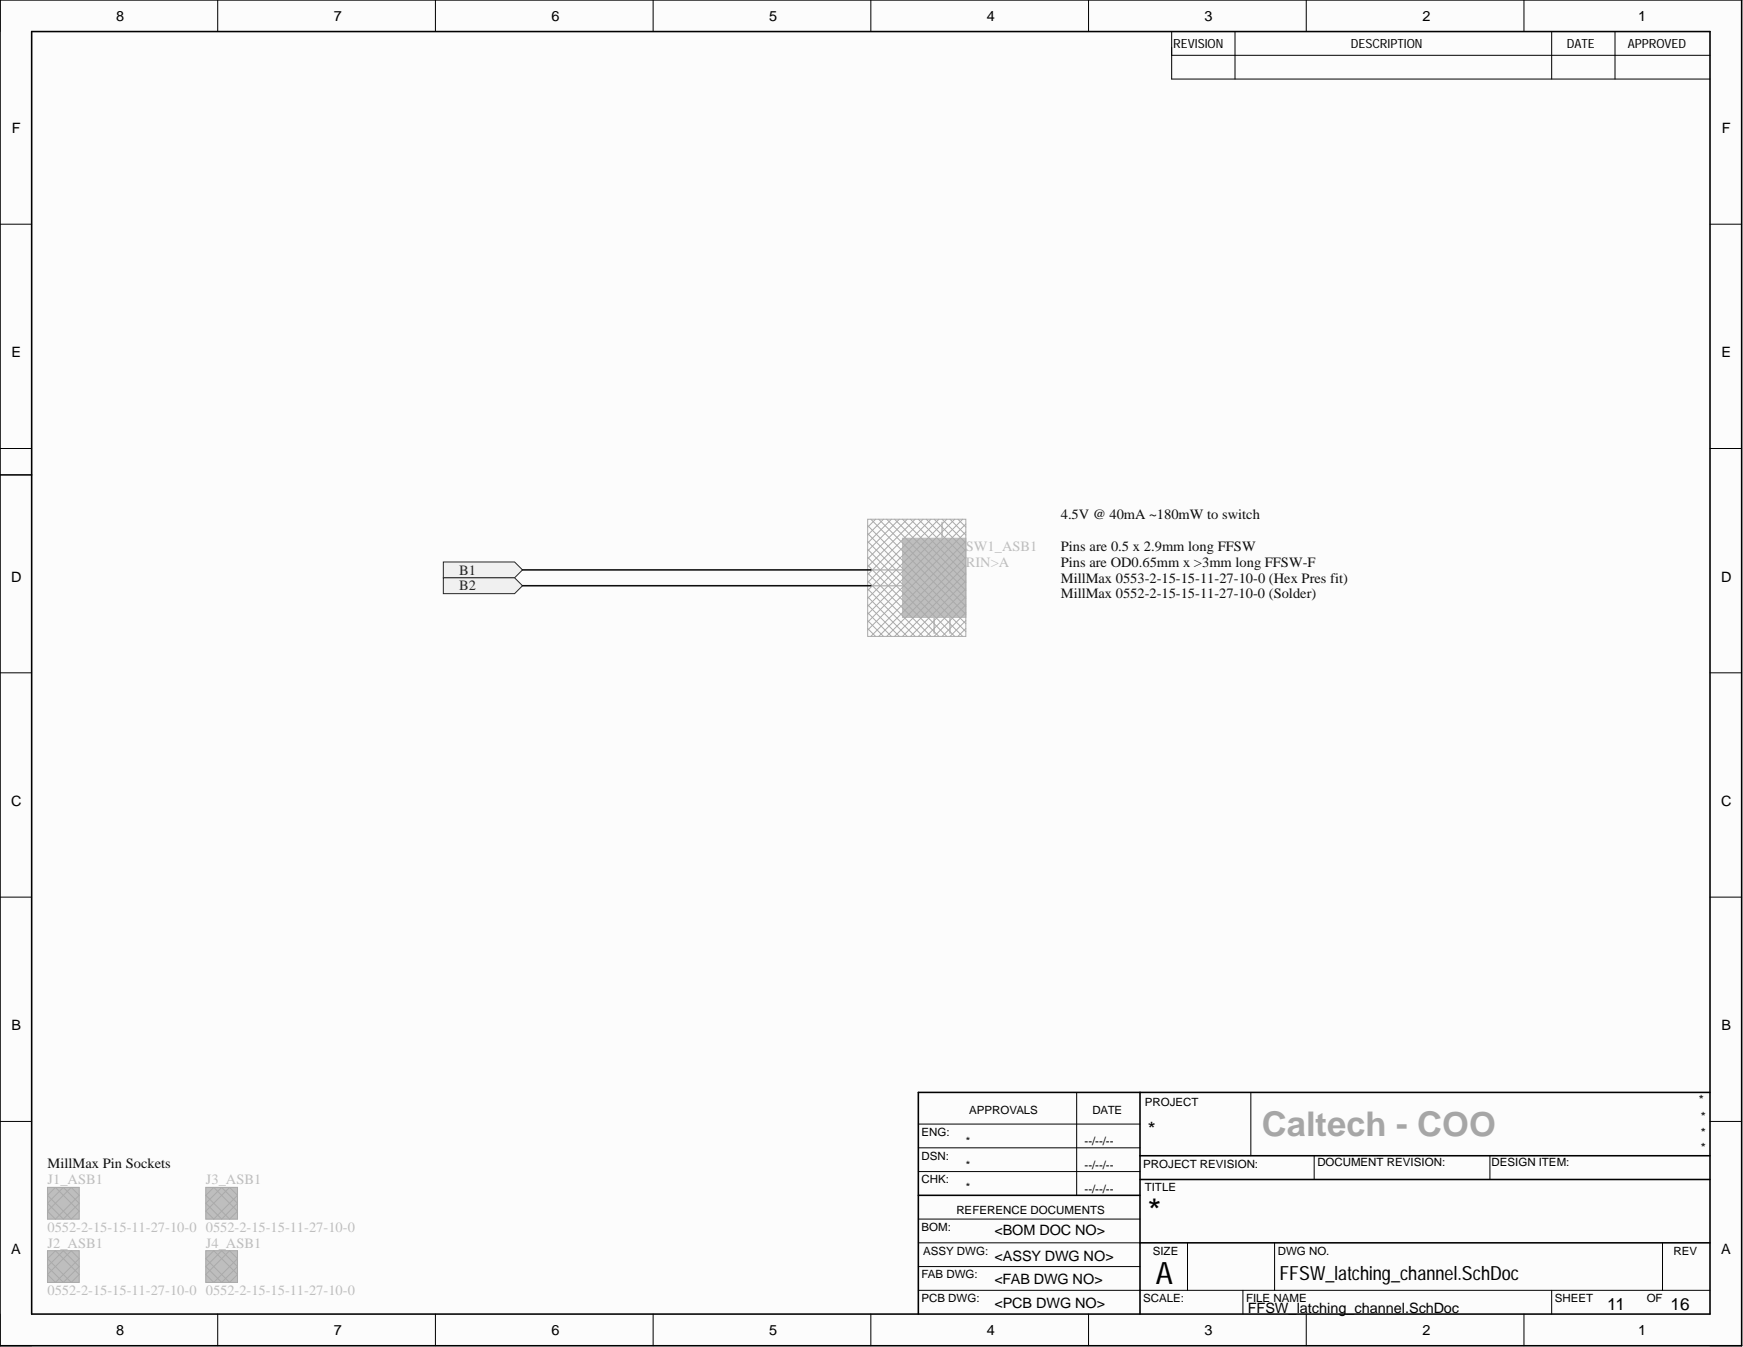
[picture p20: page 20]

Pins are 0.5 x 2.9mm long FFSW
Pins are OD0.65mm x >3mm long FFSW-F
MillMax 0553-2-15-15-11-27-10-0 (Hex Pres fit)
MillMax 0552-2-15-15-11-27-10-0 (Solder)

DATE | PROJECT * | * * APPROVALS Caltech - COO * *

ENG: * | --/--/--

DSN: * | --/--/--

PROJECT REVISION: | DOCUMENT REVISION: | DESIGN ITEM:

CHK: * | --/--/--

A | | FFSW_latching_channel.SchDoc

FFSW_latching_channel.SchDoc | 11 16

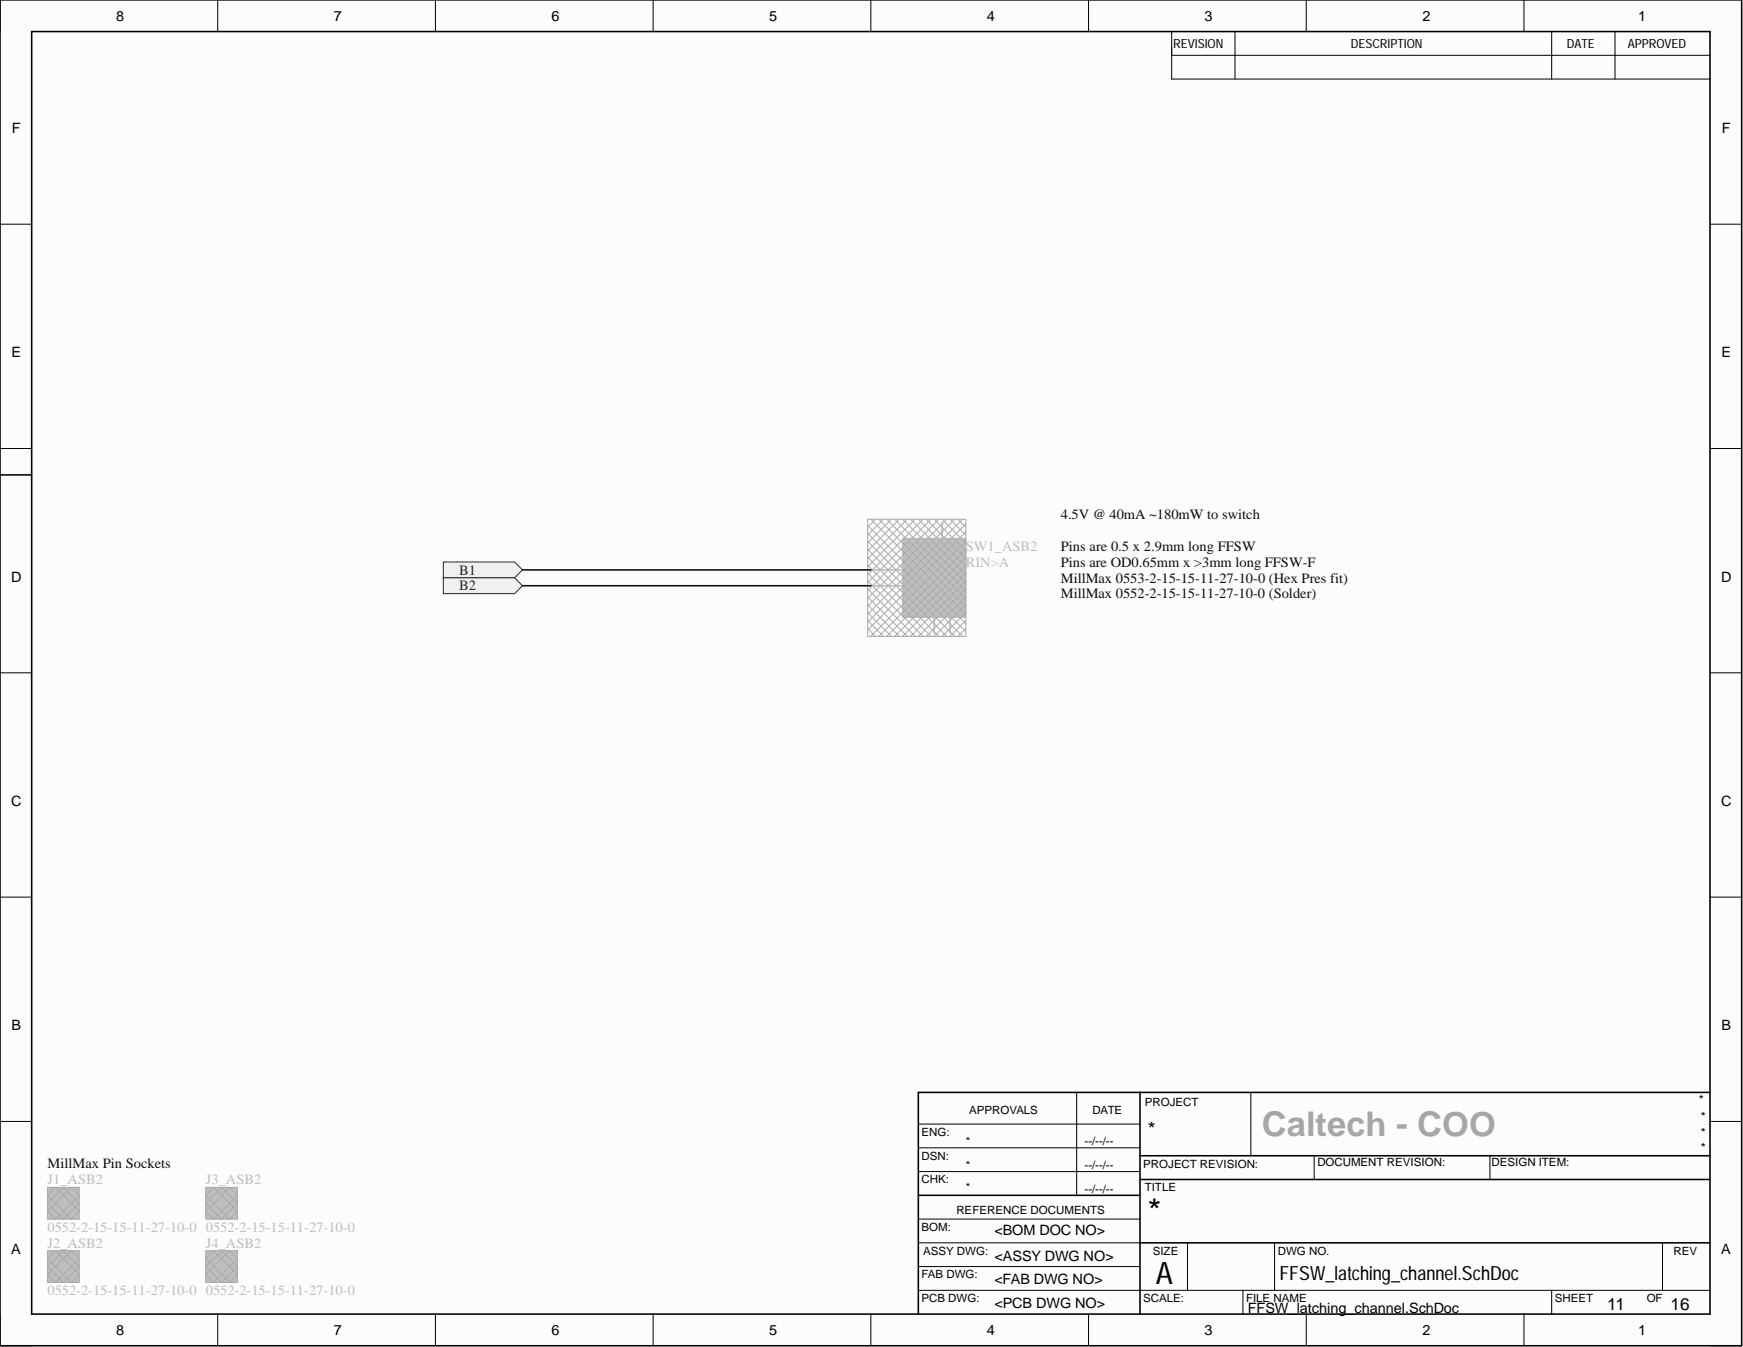
[picture p21: page 21]

Pins are 0.5 x 2.9mm long FFSW
Pins are OD0.65mm x >3mm long FFSW-F
MillMax 0553-2-15-15-11-27-10-0 (Hex Pres fit)
MillMax 0552-2-15-15-11-27-10-0 (Solder)

DATE | PROJECT * | * * APPROVALS Caltech - COO * *

ENG: * | --/--/--

DSN: * | --/--/--

PROJECT REVISION: | DOCUMENT REVISION: | DESIGN ITEM:

CHK: * | --/--/--

A | | FFSW_latching_channel.SchDoc

FFSW_latching_channel.SchDoc | 11 16

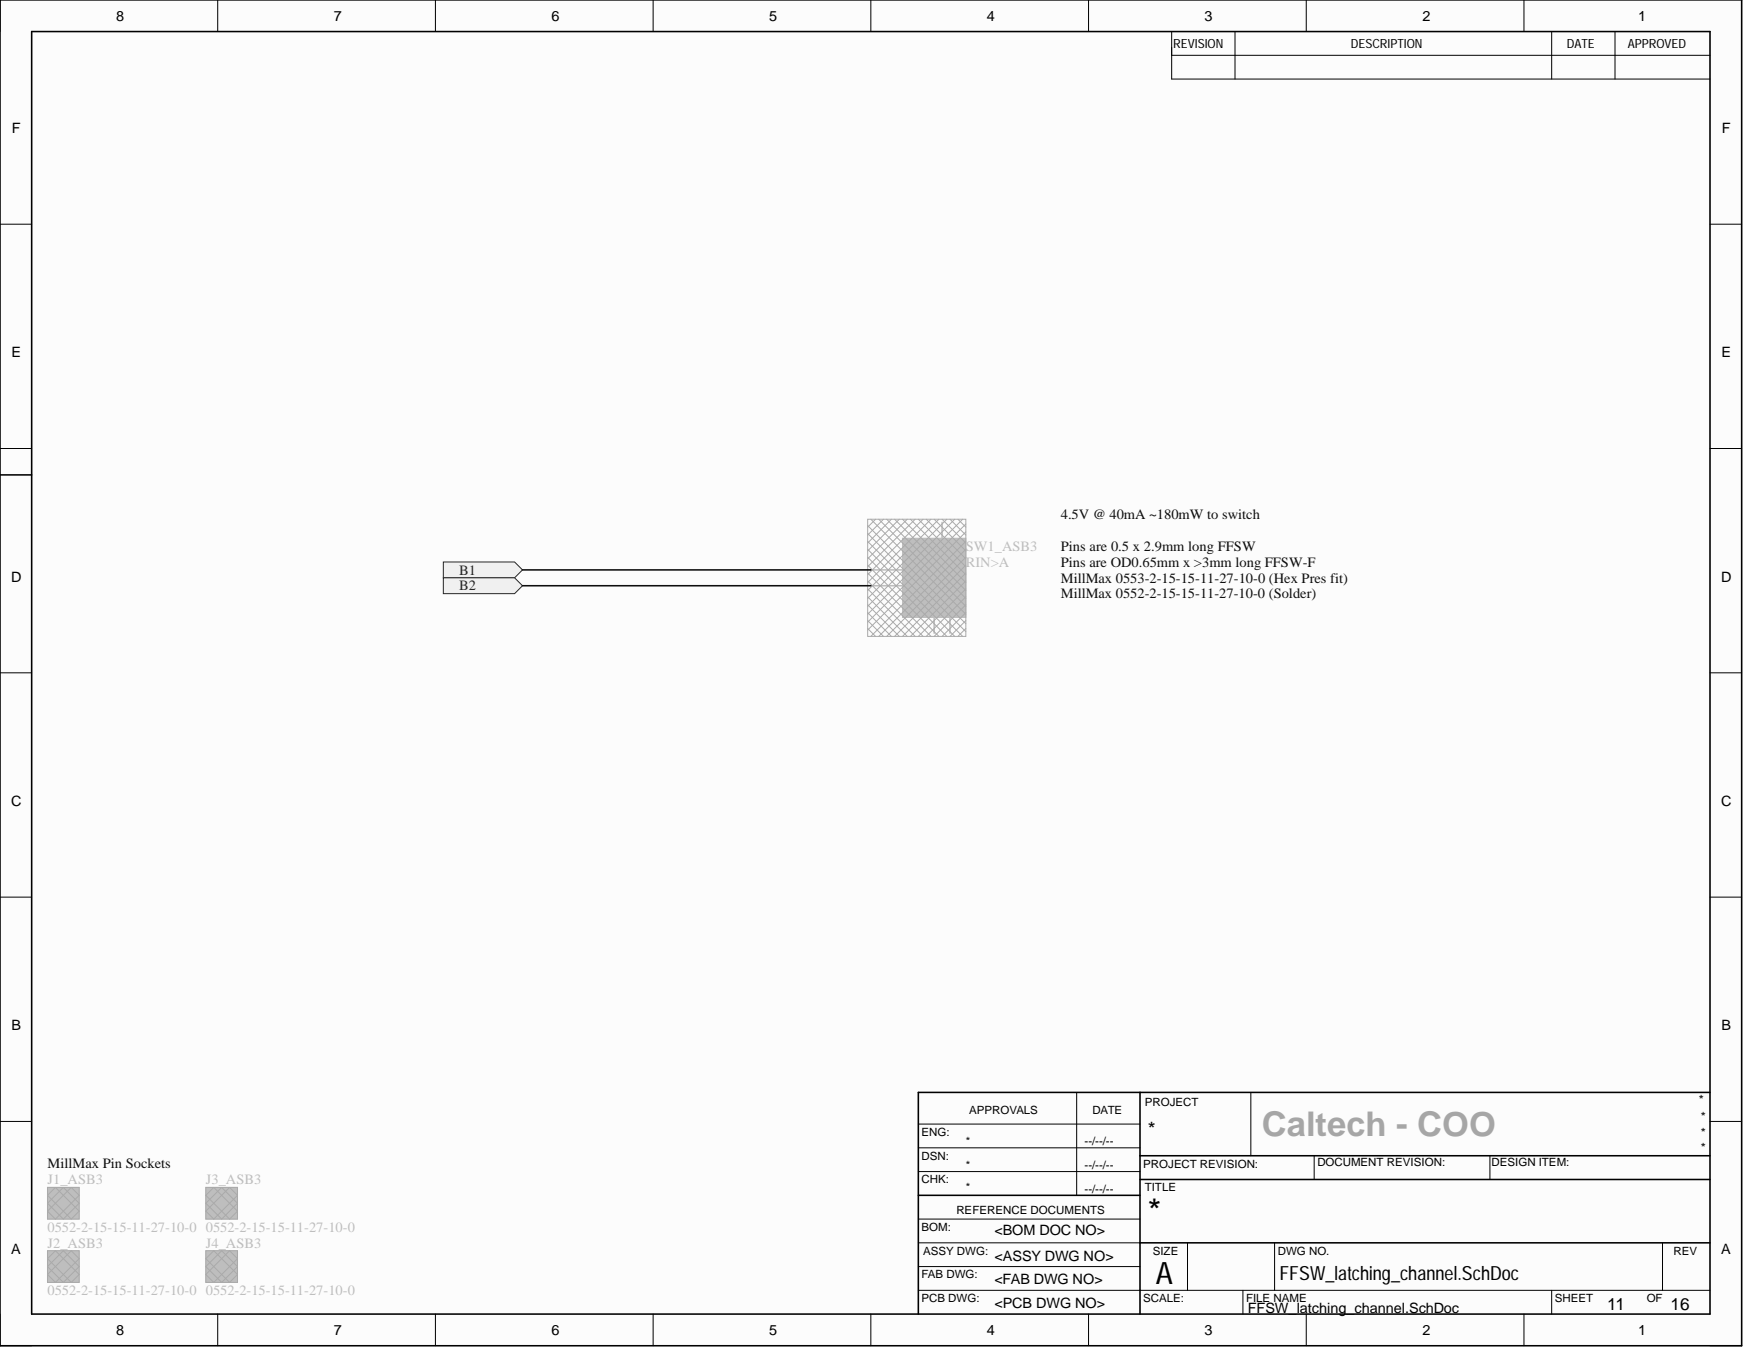
[picture p22: page 22]

Pins are 0.5 x 2.9mm long FFSW
Pins are OD0.65mm x >3mm long FFSW-F
MillMax 0553-2-15-15-11-27-10-0 (Hex Pres fit)
MillMax 0552-2-15-15-11-27-10-0 (Solder)

DATE | PROJECT * | * * APPROVALS Caltech - COO * *

ENG: * | --/--/--

DSN: * | --/--/--

PROJECT REVISION: | DOCUMENT REVISION: | DESIGN ITEM:

CHK: * | --/--/--

A | | FFSW_latching_channel.SchDoc

FFSW_latching_channel.SchDoc | 11 16

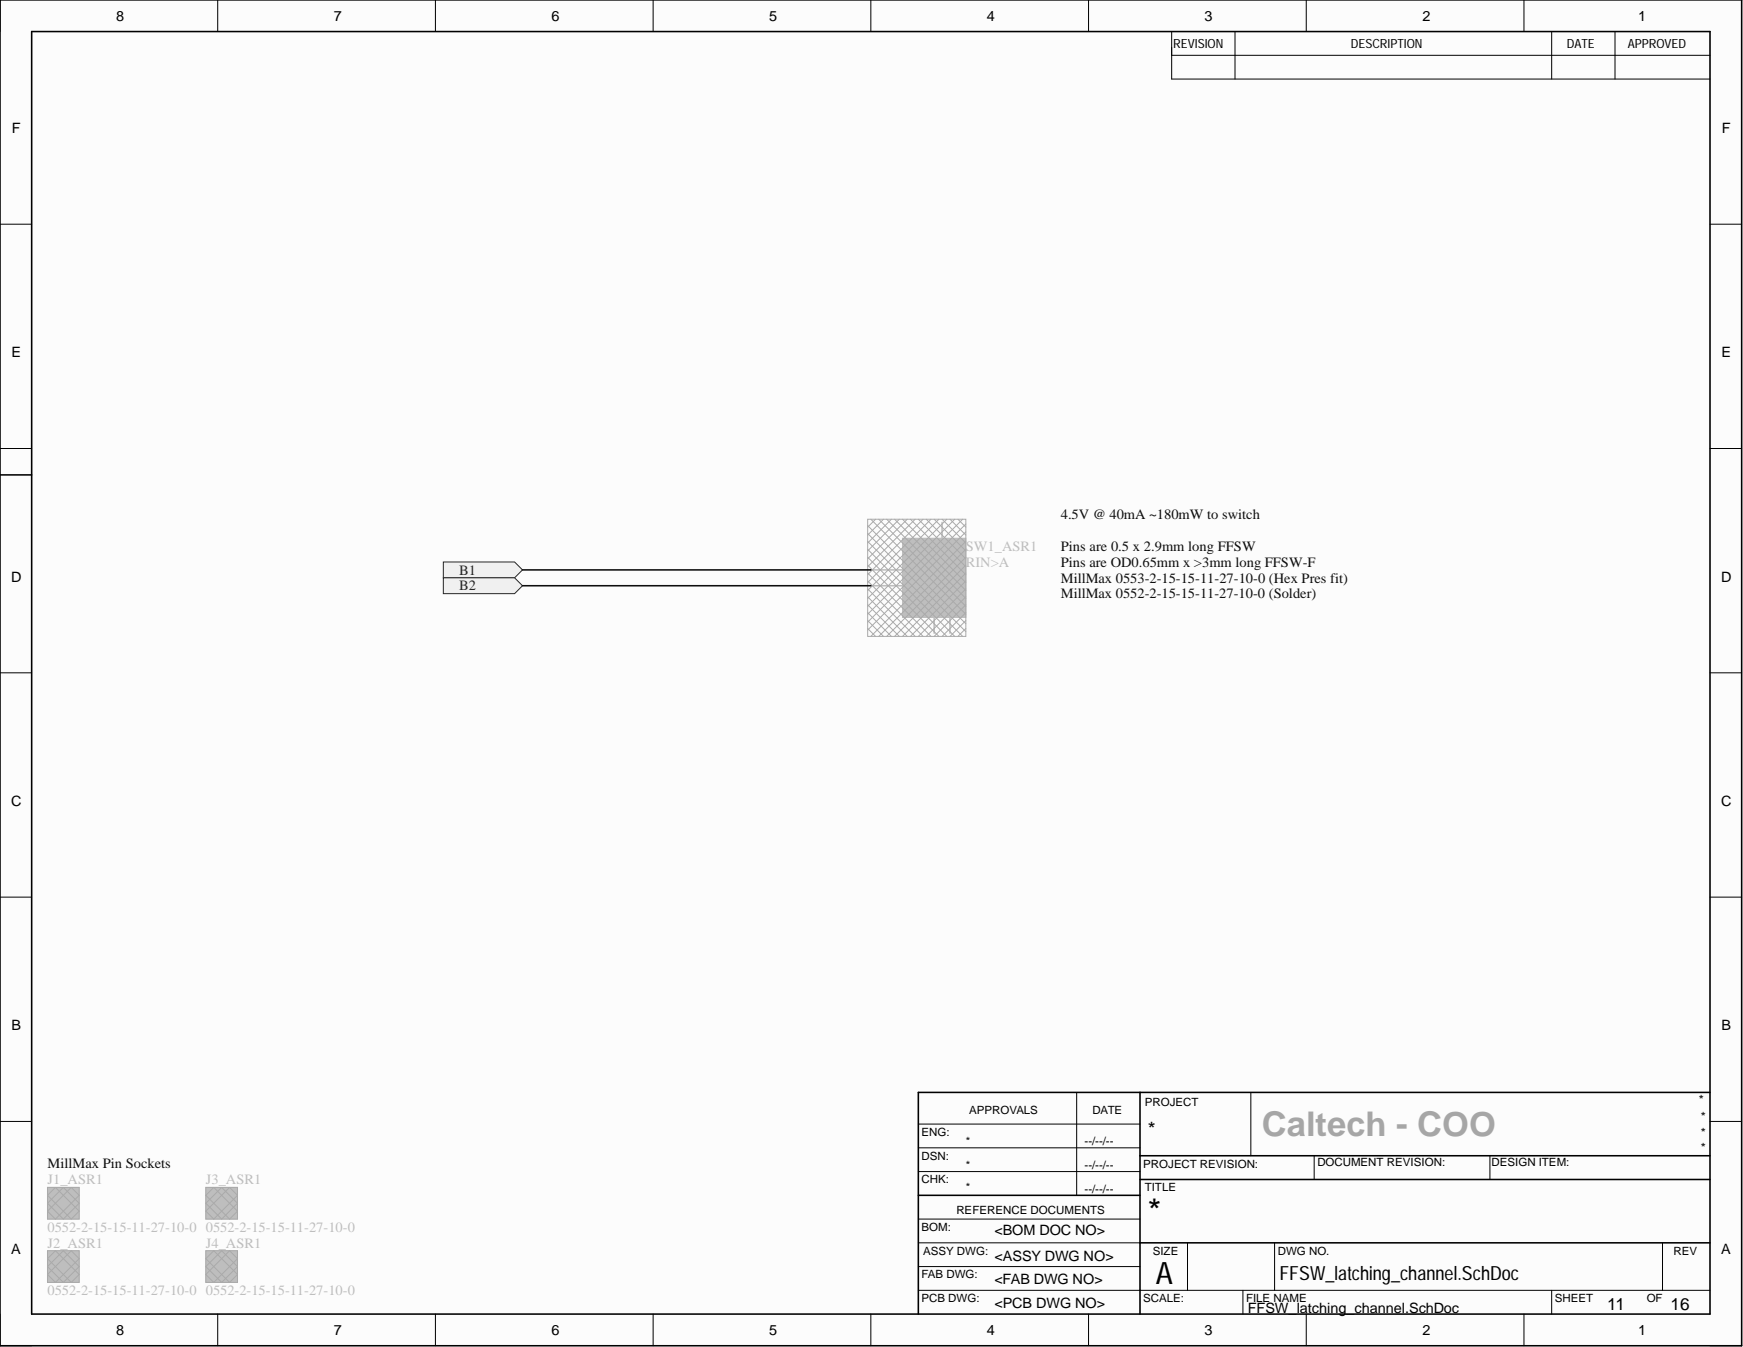
[picture p23: page 23]
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

DATE | PROJECT * | * * APPROVALS Caltech - COO * *

ENG: * | --/--/--

DSN: * | --/--/--

PROJECT REVISION: | DOCUMENT REVISION: | DESIGN ITEM:

CHK: * | --/--/--

A | | FFSW_latching_channel.SchDoc

FFSW_latching_channel.SchDoc | 11 16

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

DATE | PROJECT * | * * APPROVALS Caltech - COO * *

ENG: * | --/--/--

DSN: * | --/--/--

PROJECT REVISION: | DOCUMENT REVISION: | DESIGN ITEM:

CHK: * | --/--/--

A | | FFSW_latching_channel.SchDoc

FFSW_latching_channel.SchDoc | 11 16

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

DATE | PROJECT * | * * APPROVALS Caltech - COO * *

ENG: * | --/--/--

DSN: * | --/--/--

PROJECT REVISION: | DOCUMENT REVISION: | DESIGN ITEM:

CHK: * | --/--/--

A | | FFSW_latching_channel.SchDoc

FFSW_latching_channel.SchDoc | 11 16

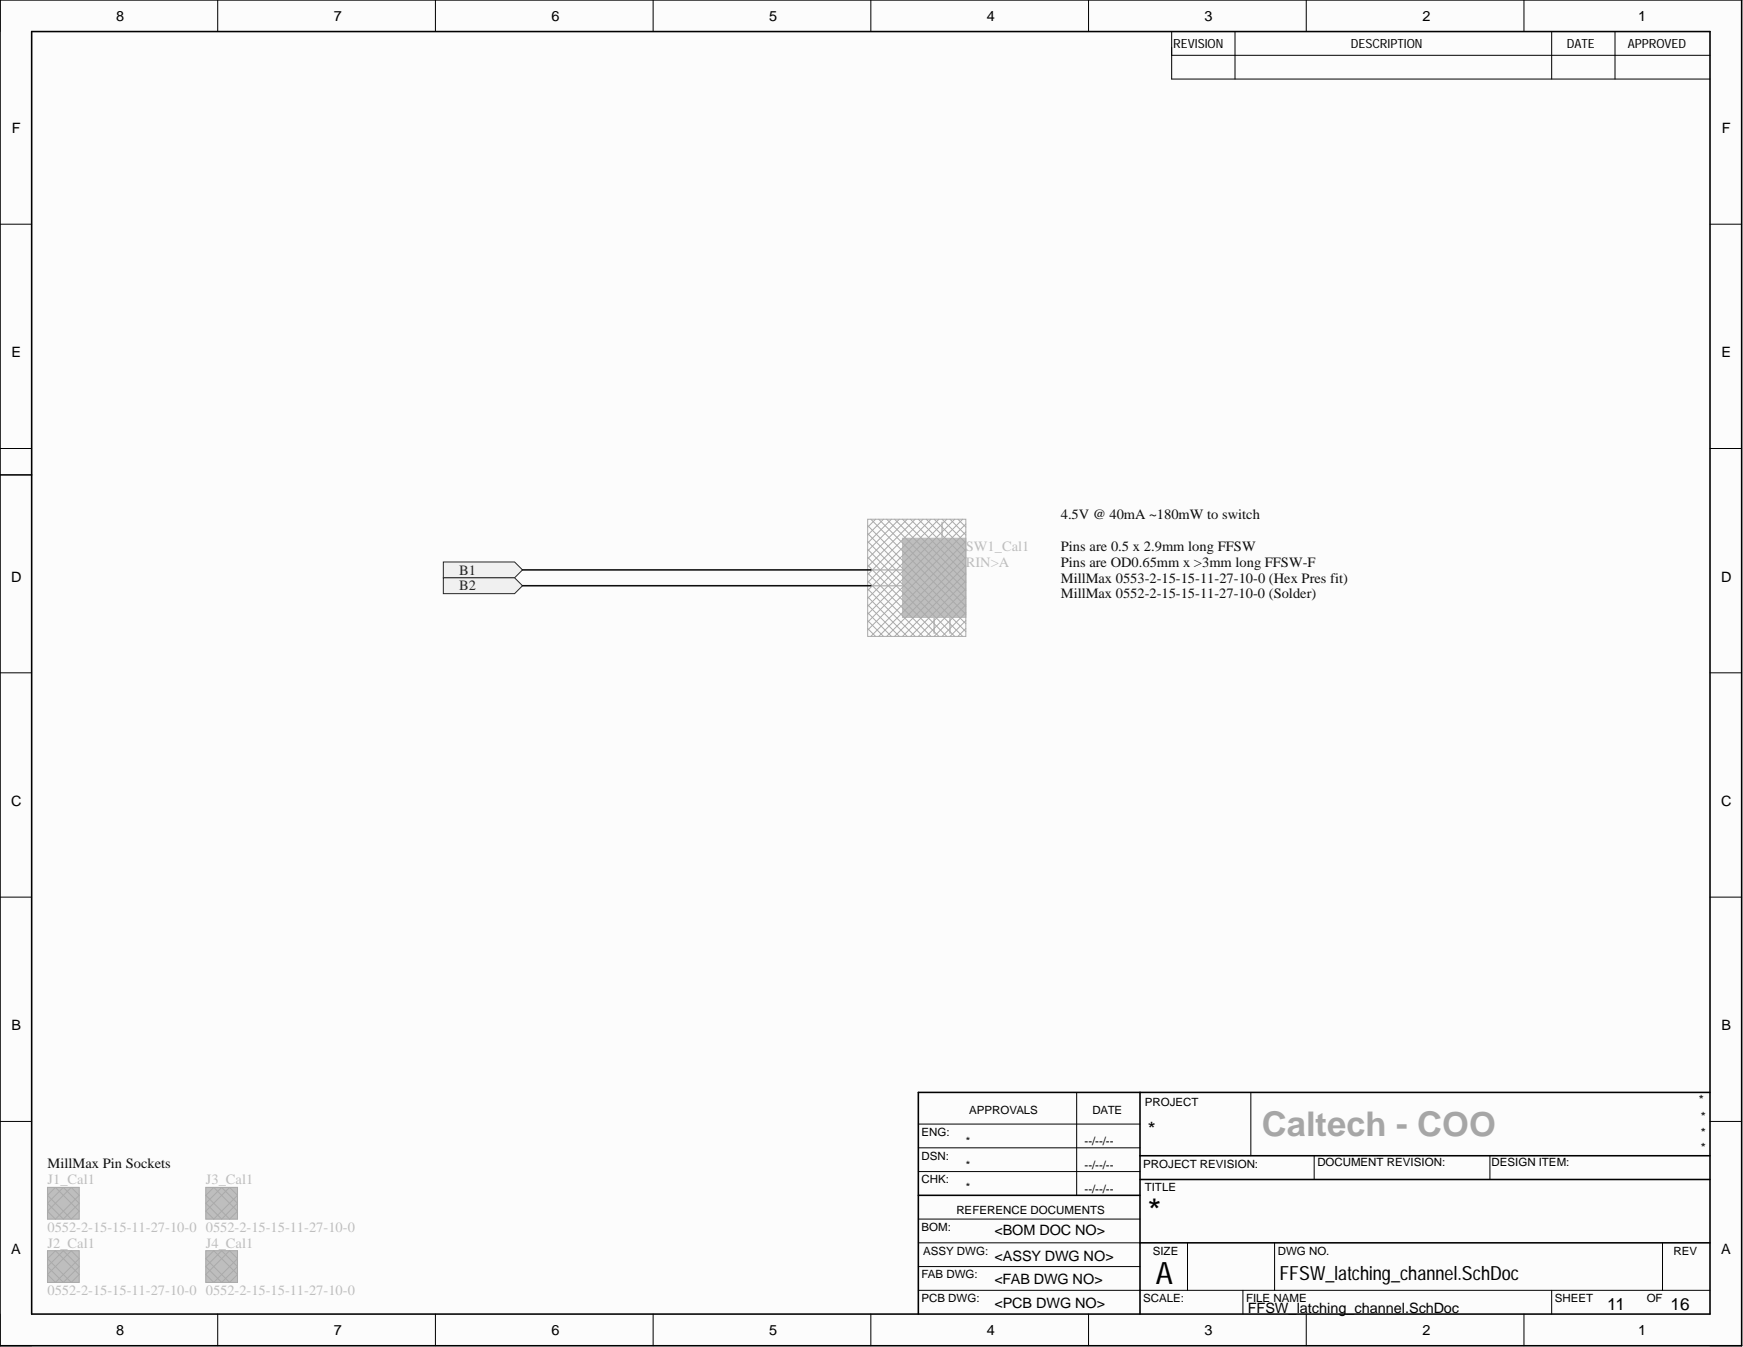
[picture p24: page 26]
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

DATE | PROJECT * | * * APPROVALS Caltech - COO * *

ENG: * | --/--/--

DSN: * | --/--/--

PROJECT REVISION: | DOCUMENT REVISION: | DESIGN ITEM:

CHK: * | --/--/--

A | | FFSW_latching_channel.SchDoc

FFSW_latching_channel.SchDoc | 11 16

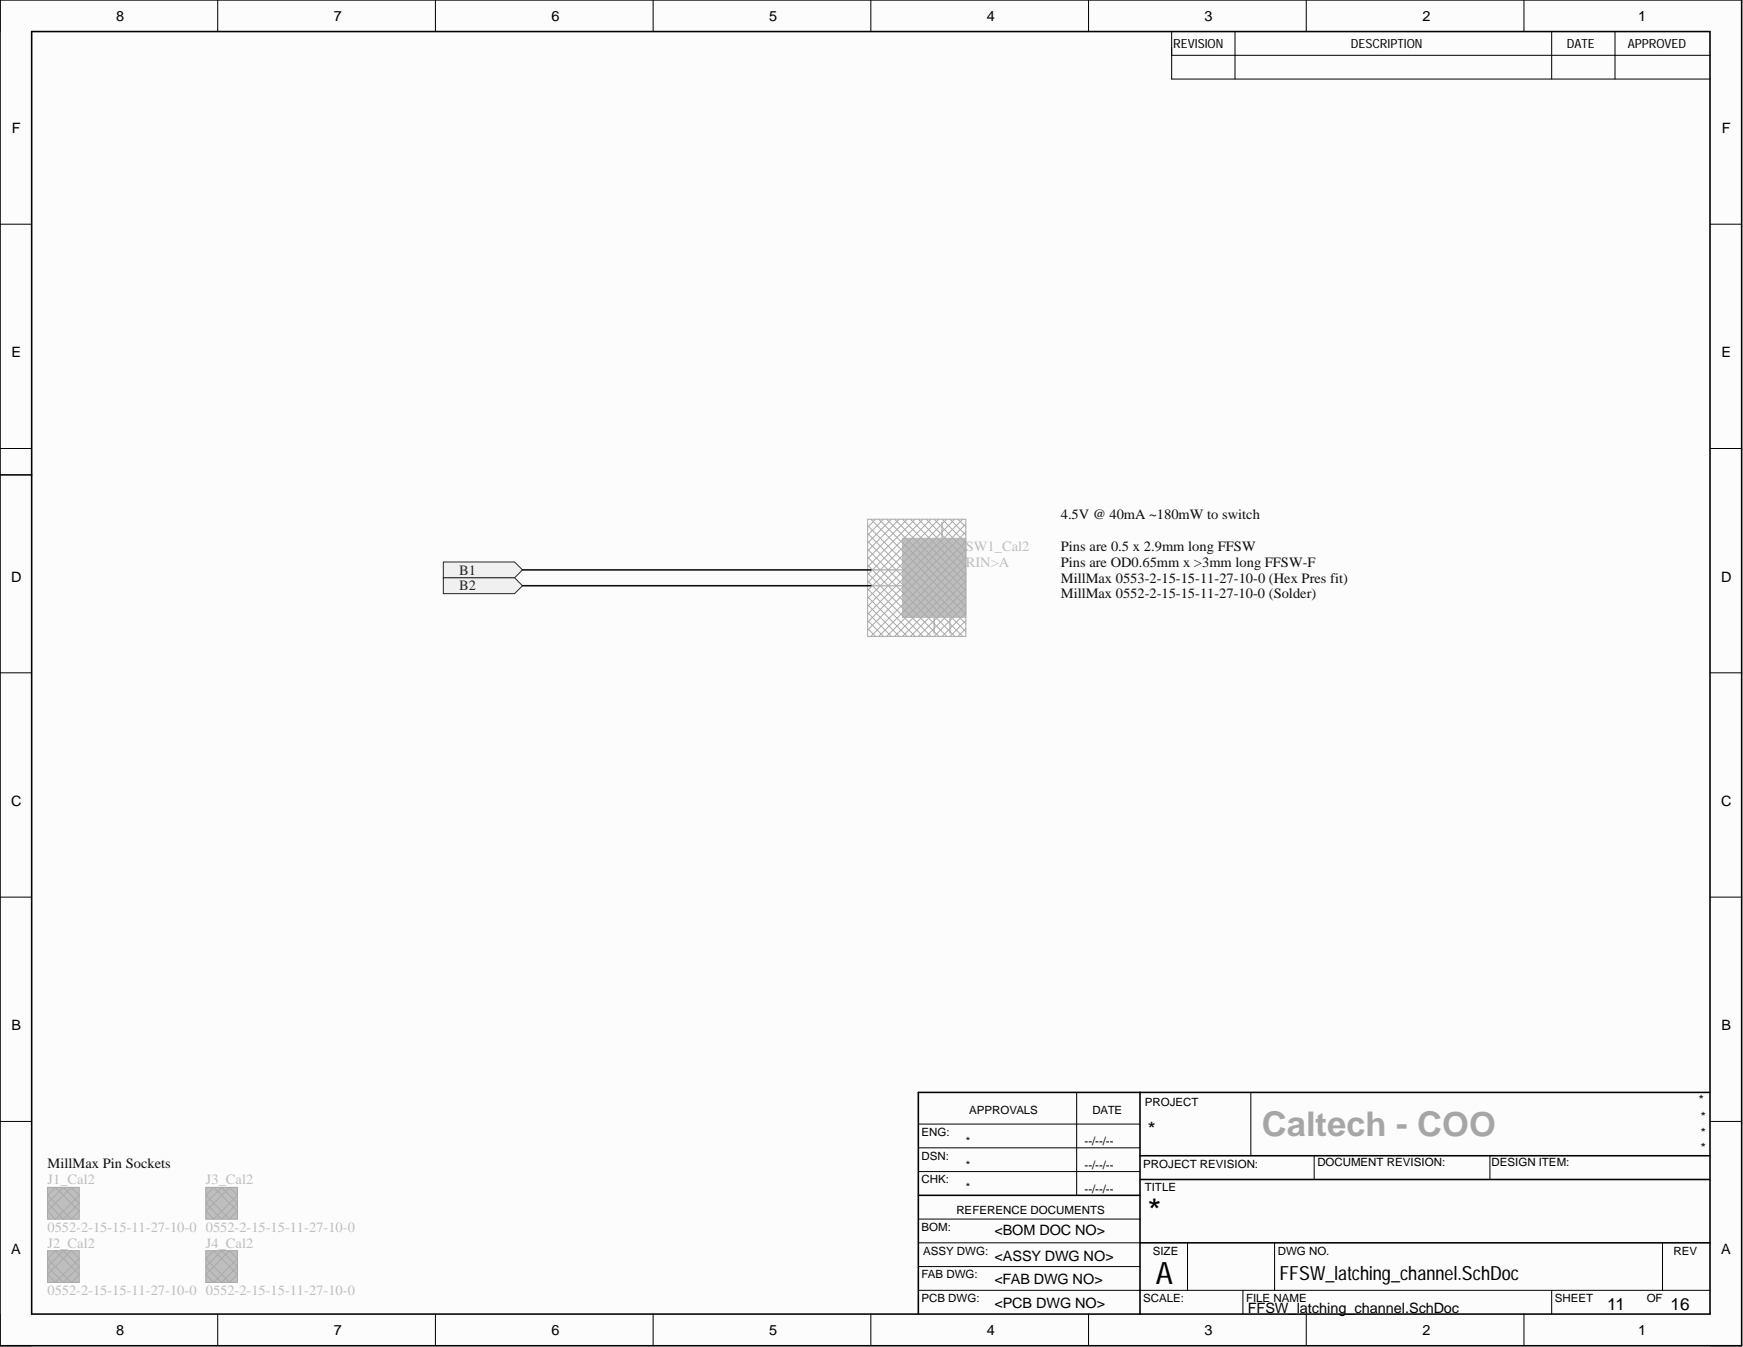
[picture p25: page 27]
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

DATE | PROJECT * | * * APPROVALS Caltech - COO * *

ENG: * | --/--/--

DSN: * | --/--/--

PROJECT REVISION: | DOCUMENT REVISION: | DESIGN ITEM:

CHK: * | --/--/--

A | | FFSW_latching_channel.SchDoc

FFSW_latching_channel.SchDoc | 11 16

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

DATE | PROJECT * | * * APPROVALS Caltech - COO * *

ENG: * | --/--/--

DSN: * | --/--/--

PROJECT REVISION: | DOCUMENT REVISION: | DESIGN ITEM:

CHK: * | --/--/--

A | | FFSW_latching_channel.SchDoc

FFSW_latching_channel.SchDoc | 11 16

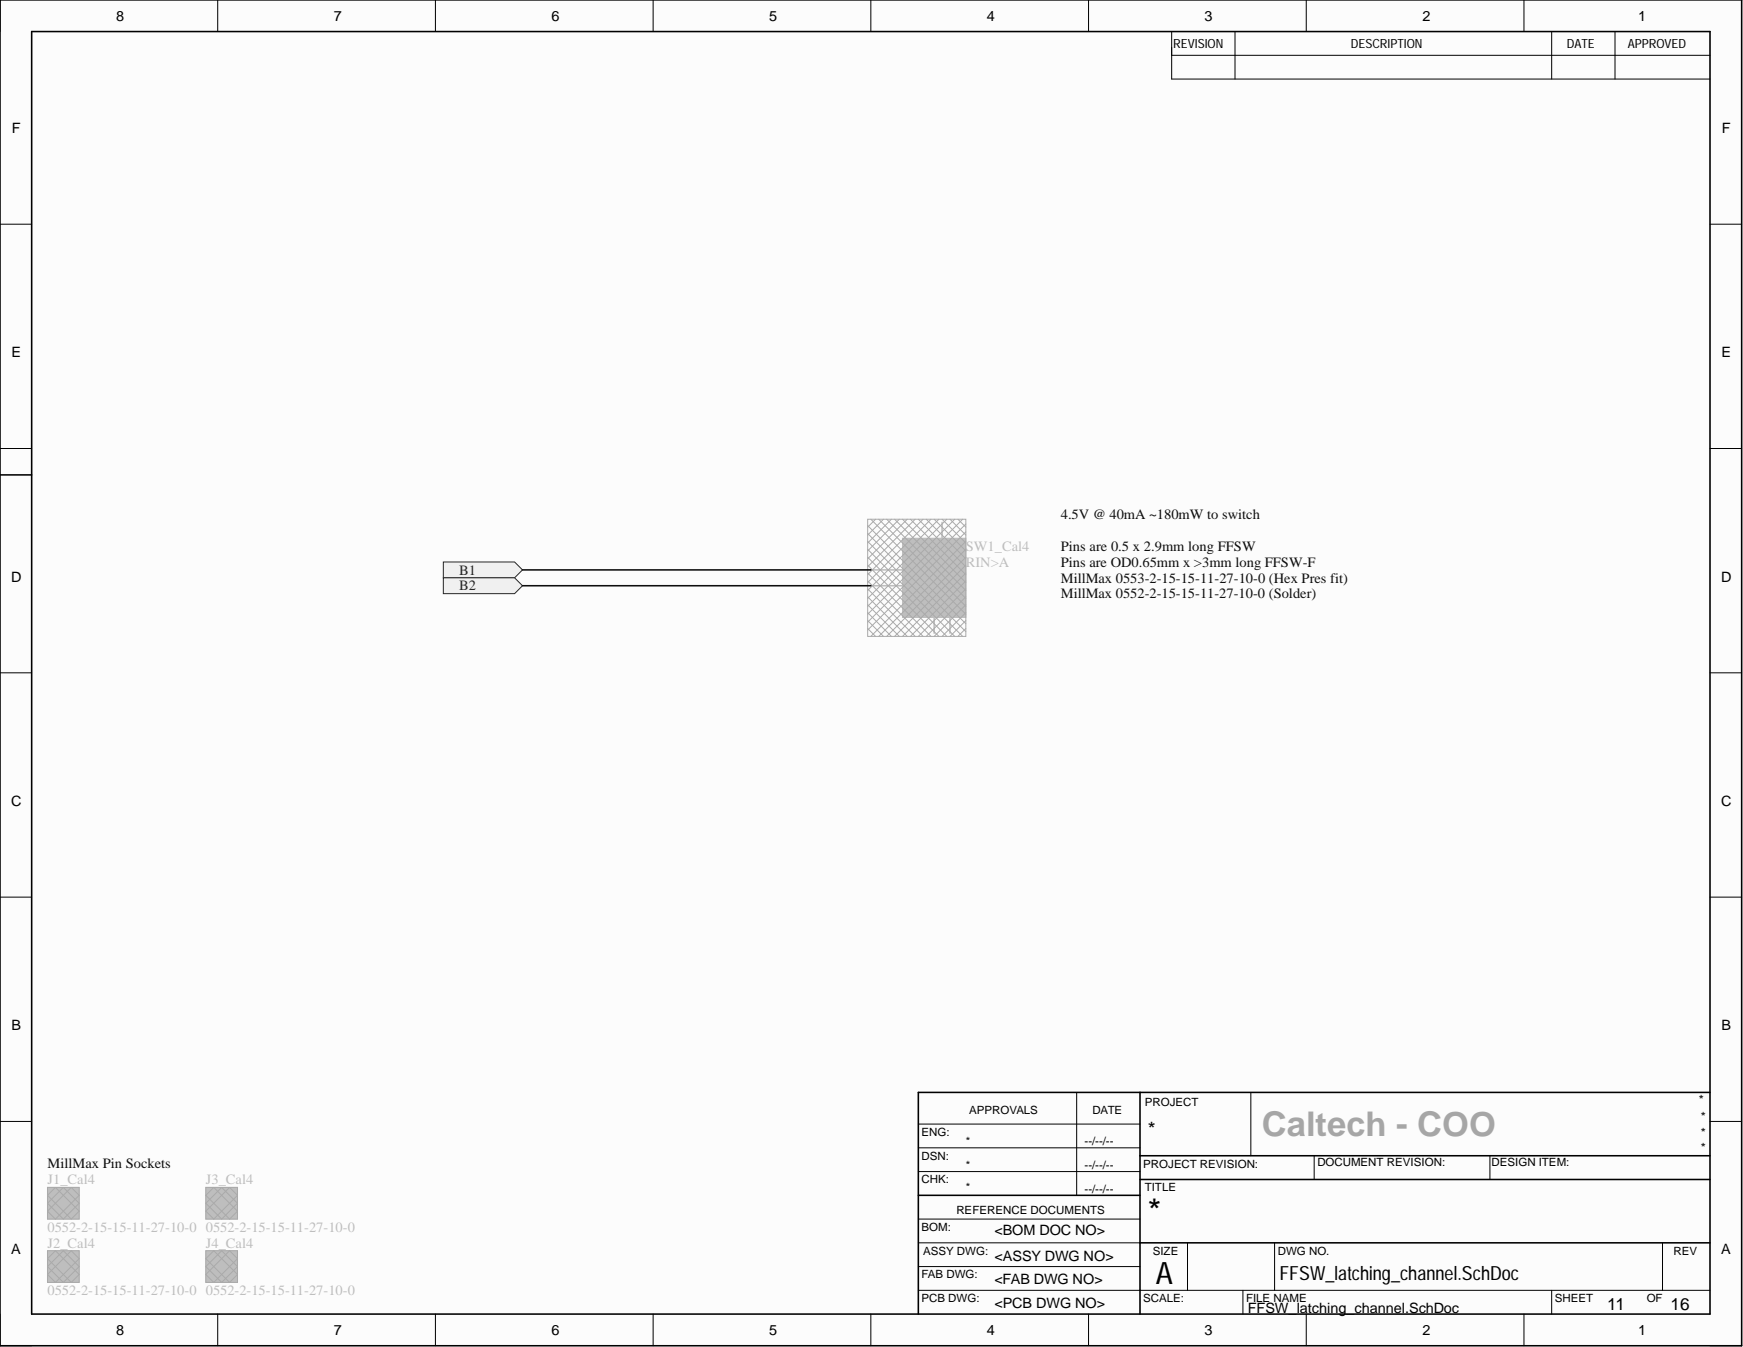
[picture p26: page 29]
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

DATE | PROJECT * | * * APPROVALS Caltech - COO * *

ENG: * | --/--/--

DSN: * | --/--/--

PROJECT REVISION: | DOCUMENT REVISION: | DESIGN ITEM:

CHK: * | --/--/--

A | | FFSW_latching_channel.SchDoc

FFSW_latching_channel.SchDoc | 11 16

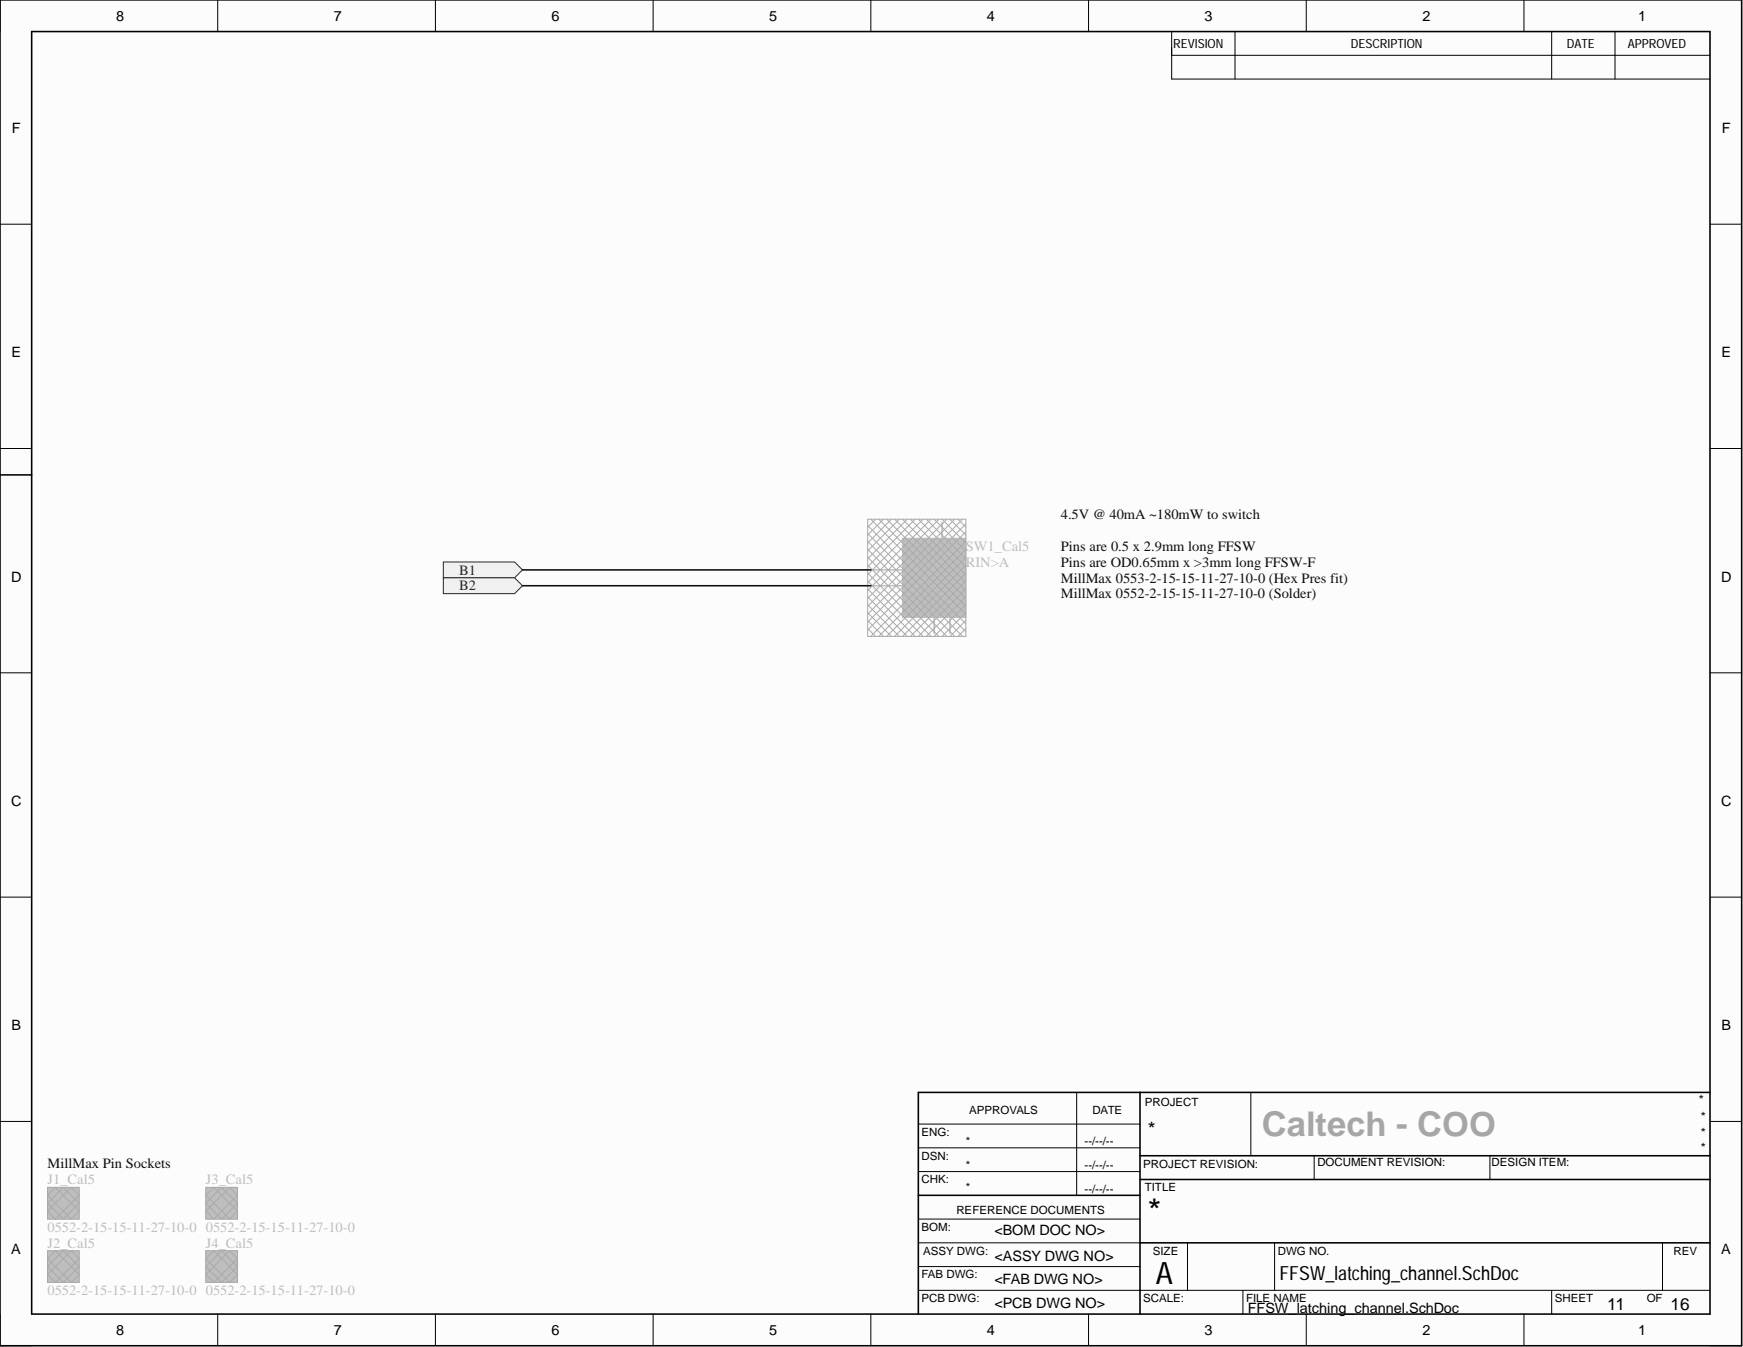
[picture p27: page 30]
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

DATE | PROJECT * | * * APPROVALS Caltech - COO * *

ENG: * | --/--/--

DSN: * | --/--/--

PROJECT REVISION: | DOCUMENT REVISION: | DESIGN ITEM:

CHK: * | --/--/--

A | | FFSW_latching_channel.SchDoc

FFSW_latching_channel.SchDoc | 11 16

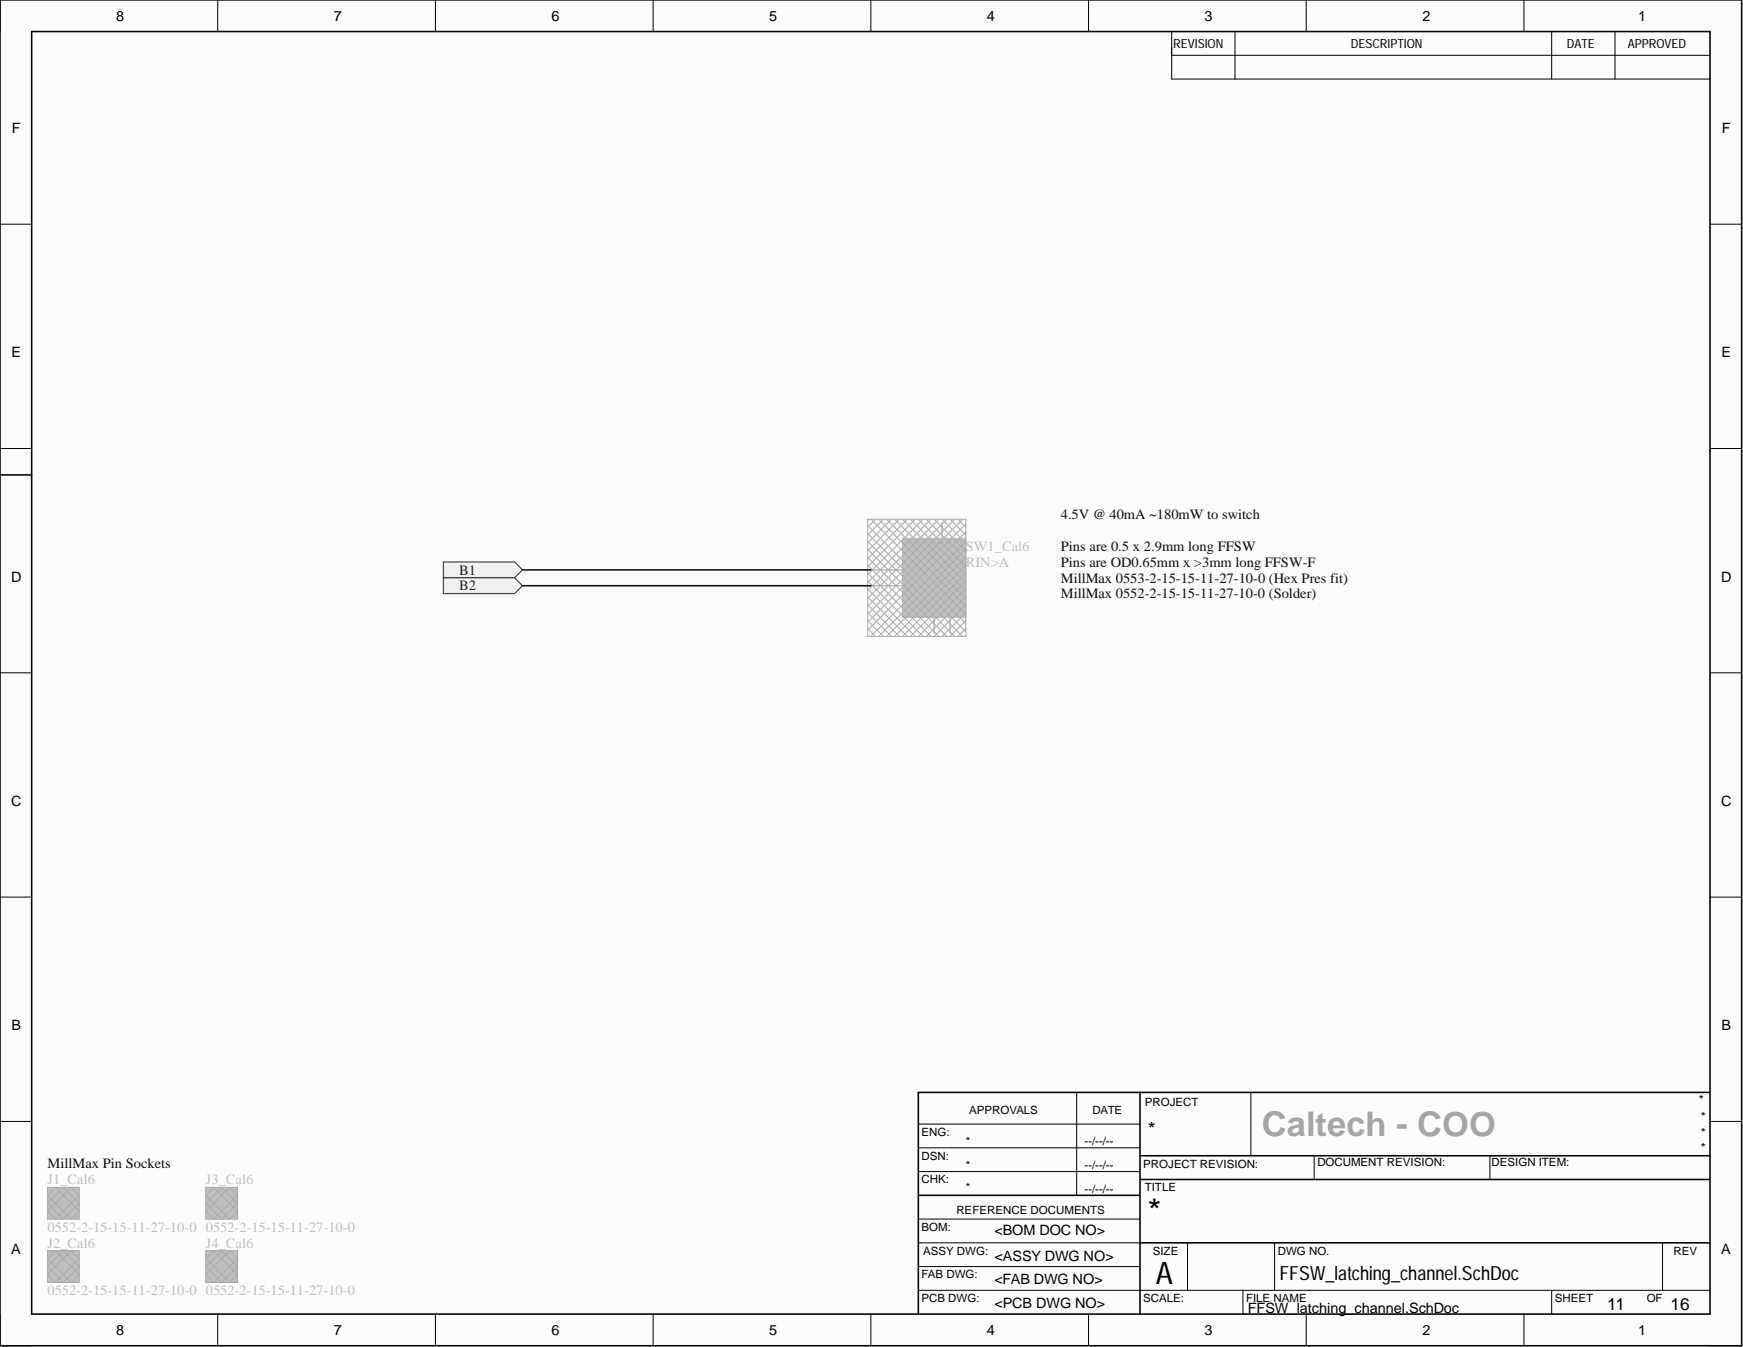
[picture p28: page 31]
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

DATE | PROJECT * | * * APPROVALS Caltech - COO * *

ENG: * | --/--/--

DSN: * | --/--/--

PROJECT REVISION: | DOCUMENT REVISION: | DESIGN ITEM:

CHK: * | --/--/--

A | | FFSW_latching_channel.SchDoc

FFSW_latching_channel.SchDoc | 11 16

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

DATE | PROJECT * | * * APPROVALS Caltech - COO * *

ENG: * | --/--/--

DSN: * | --/--/--

PROJECT REVISION: | DOCUMENT REVISION: | DESIGN ITEM:

CHK: * | --/--/--

A | | FFSW_latching_channel.SchDoc

FFSW_latching_channel.SchDoc | 11 16

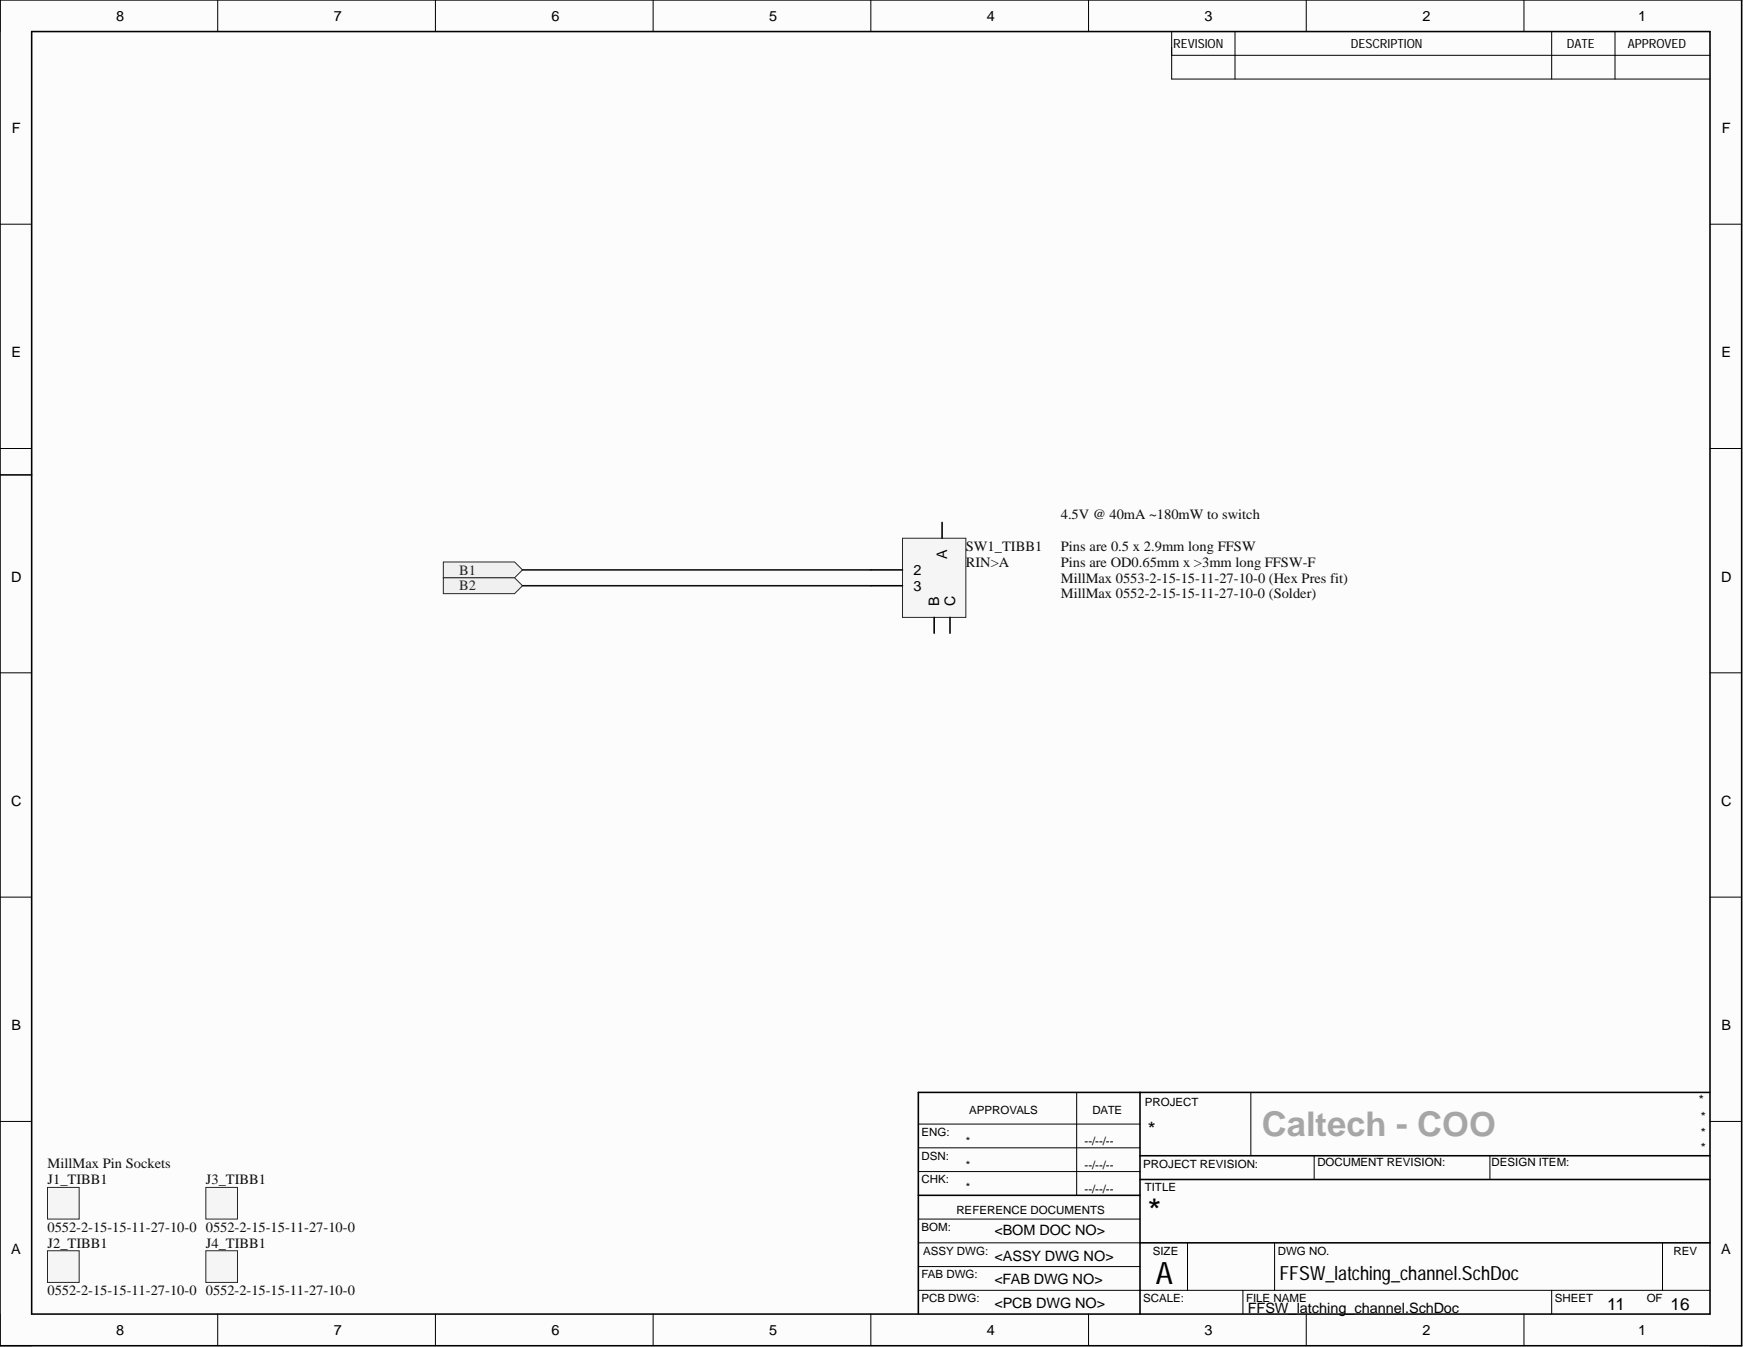
[picture p29: page 33]
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

DATE | PROJECT * | * * APPROVALS Caltech - COO * *

ENG: * | --/--/--

DSN: * | --/--/--

PROJECT REVISION: | DOCUMENT REVISION: | DESIGN ITEM:

CHK: * | --/--/--

A | | FFSW_latching_channel.SchDoc

FFSW_latching_channel.SchDoc | 11 16

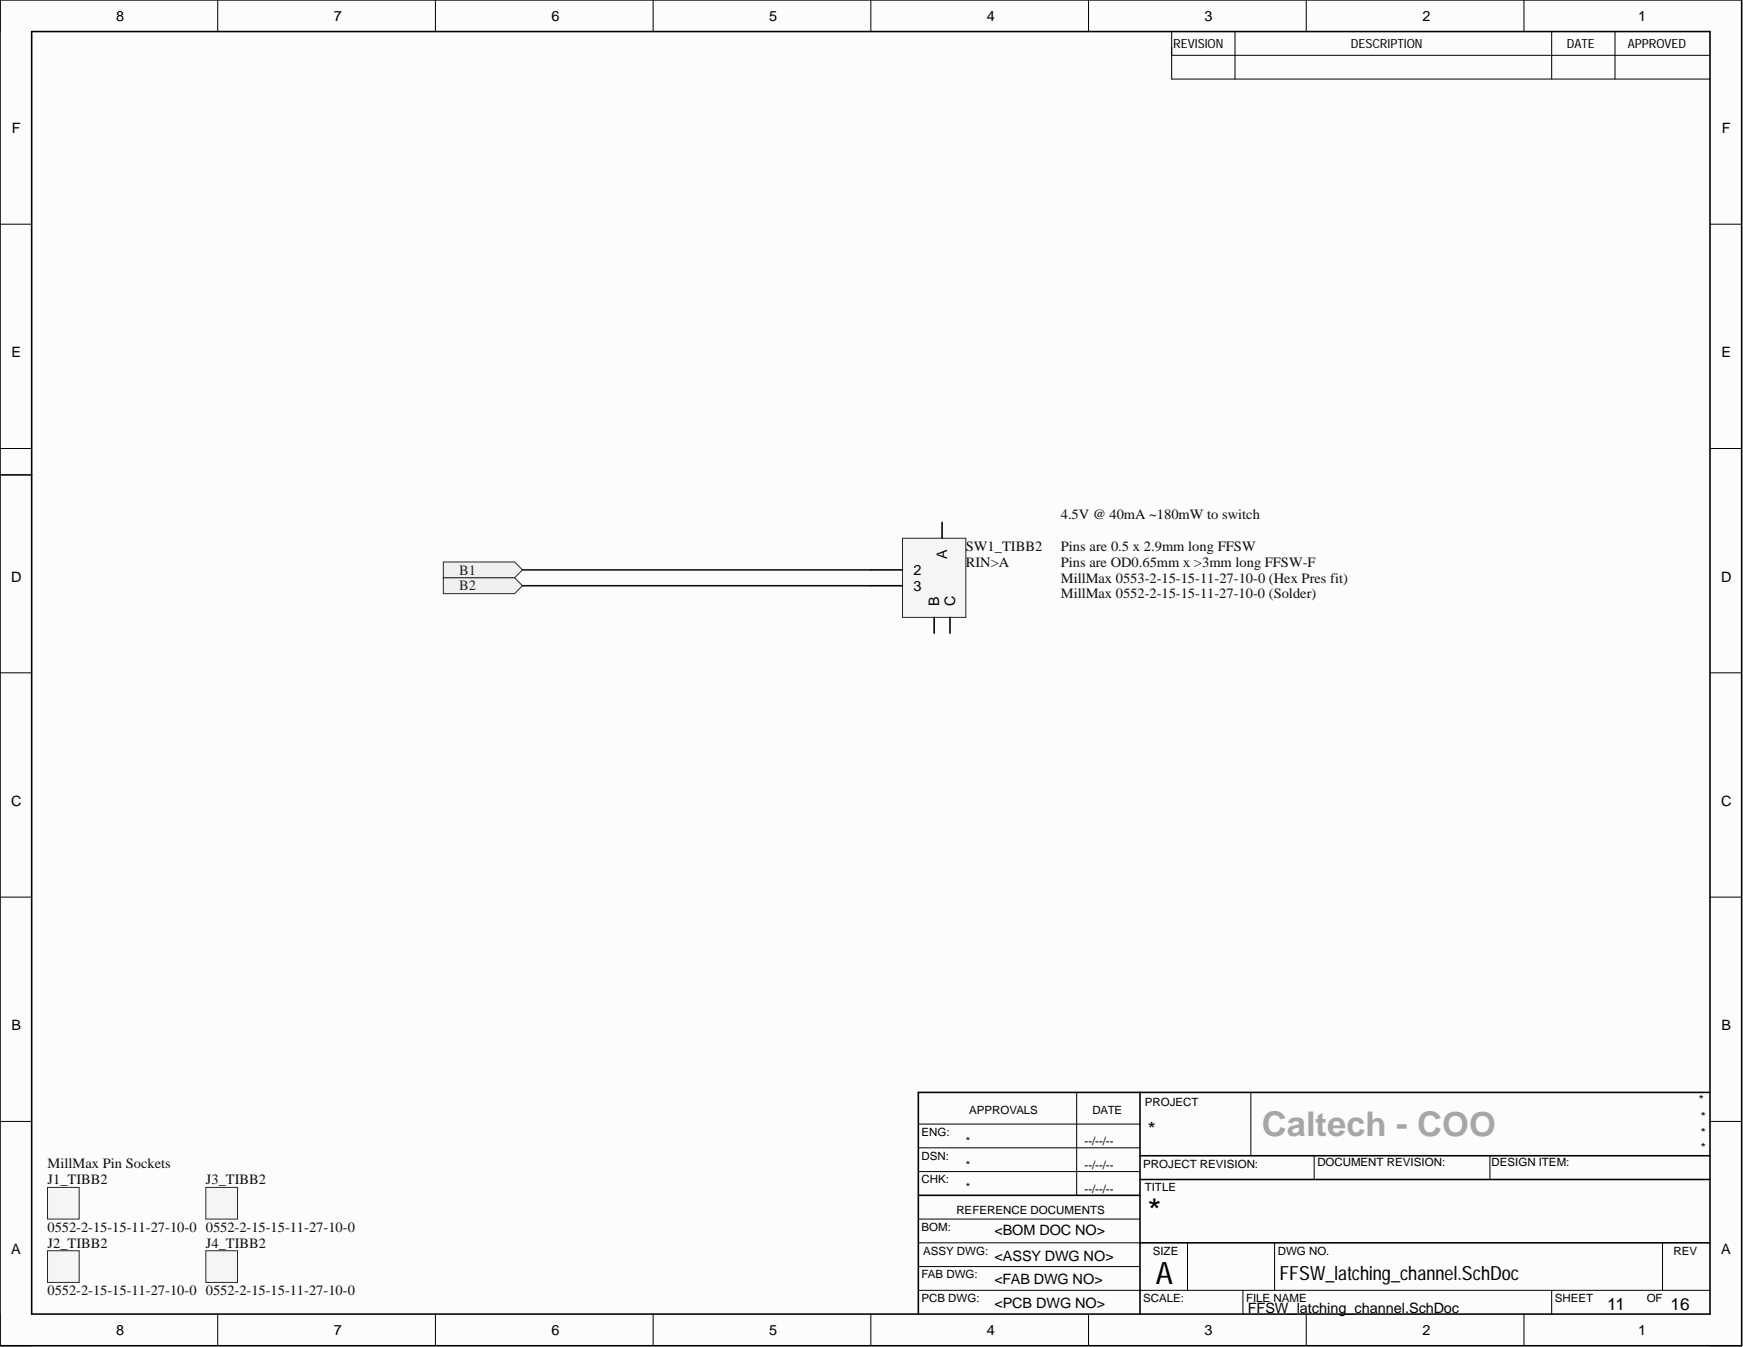
[picture p30: page 34]
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

DATE | PROJECT * | * * APPROVALS Caltech - COO * *

ENG: * | --/--/--

DSN: * | --/--/--

PROJECT REVISION: | DOCUMENT REVISION: | DESIGN ITEM:

CHK: * | --/--/--

A | | FFSW_latching_channel.SchDoc

FFSW_latching_channel.SchDoc | 11 16

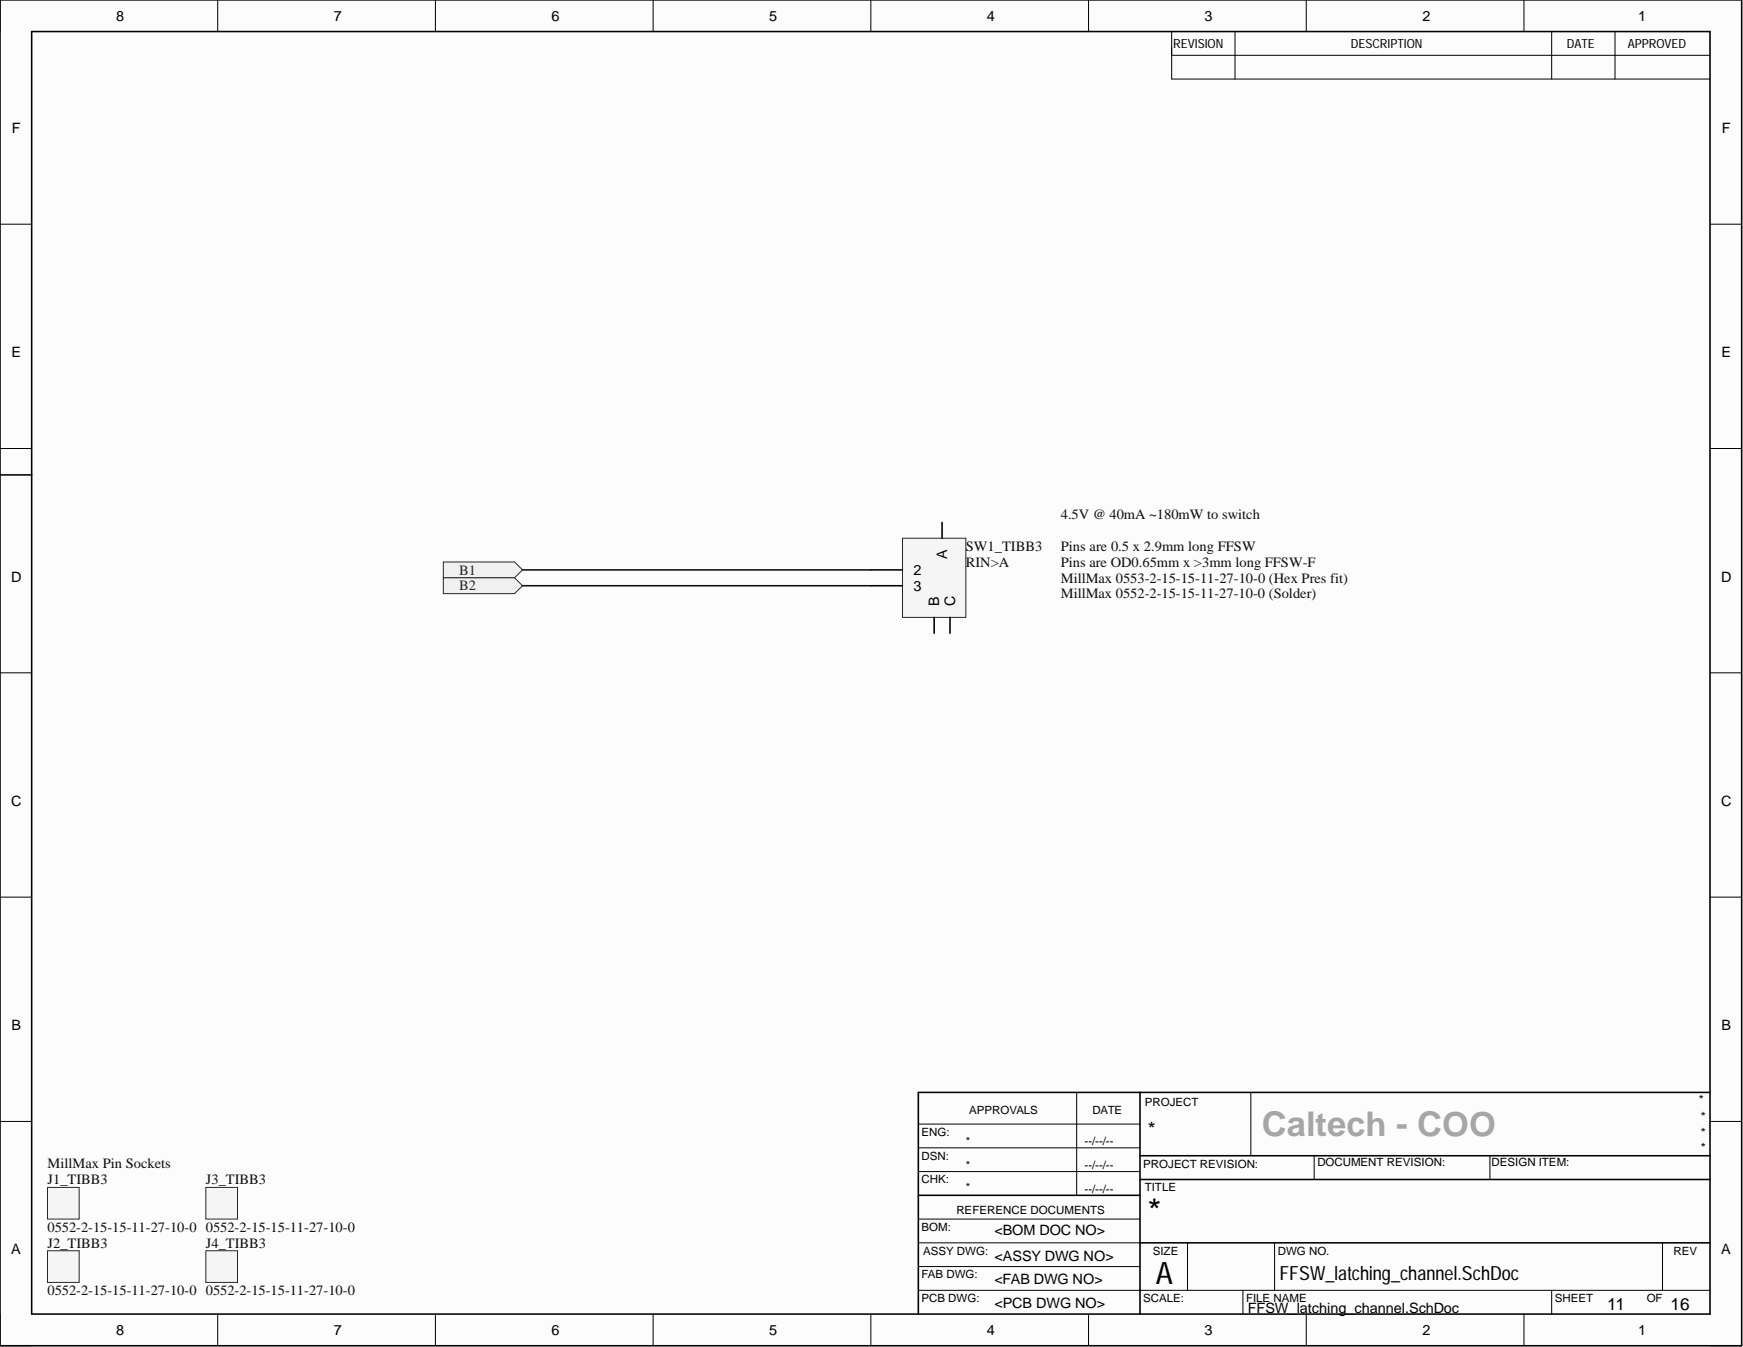
[picture p31: page 35]
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

DATE | PROJECT * | * * APPROVALS Caltech - COO * *

ENG: * | --/--/--

DSN: * | --/--/--

PROJECT REVISION: | DOCUMENT REVISION: | DESIGN ITEM:

CHK: * | --/--/--

A | | FFSW_latching_channel.SchDoc

FFSW_latching_channel.SchDoc | 11 16

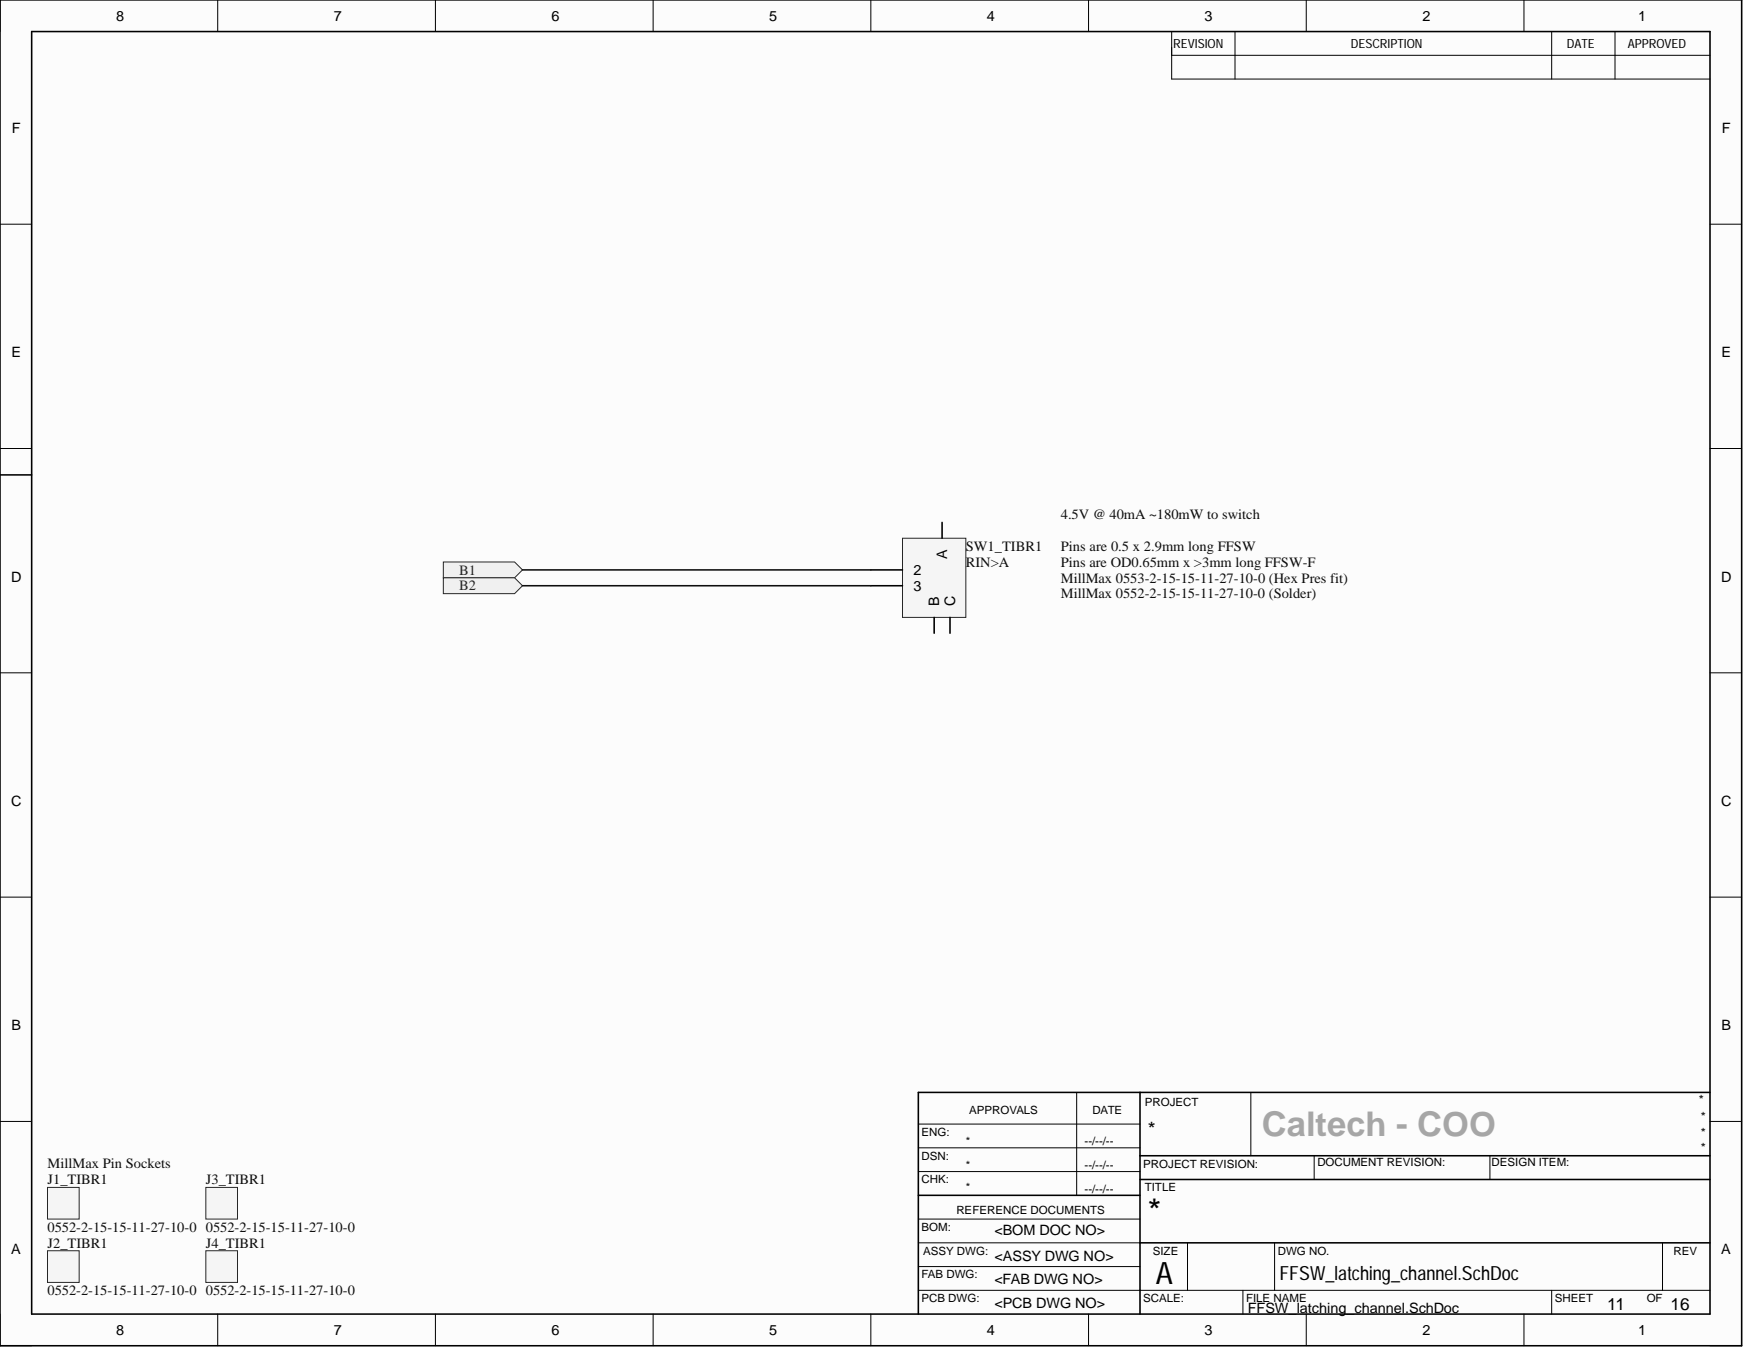
[picture p32: page 36]
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

DATE | PROJECT * | * * APPROVALS Caltech - COO * *

ENG: * | --/--/--

DSN: * | --/--/--

PROJECT REVISION: | DOCUMENT REVISION: | DESIGN ITEM:

CHK: * | --/--/--

A | | FFSW_latching_channel.SchDoc

FFSW_latching_channel.SchDoc | 11 16

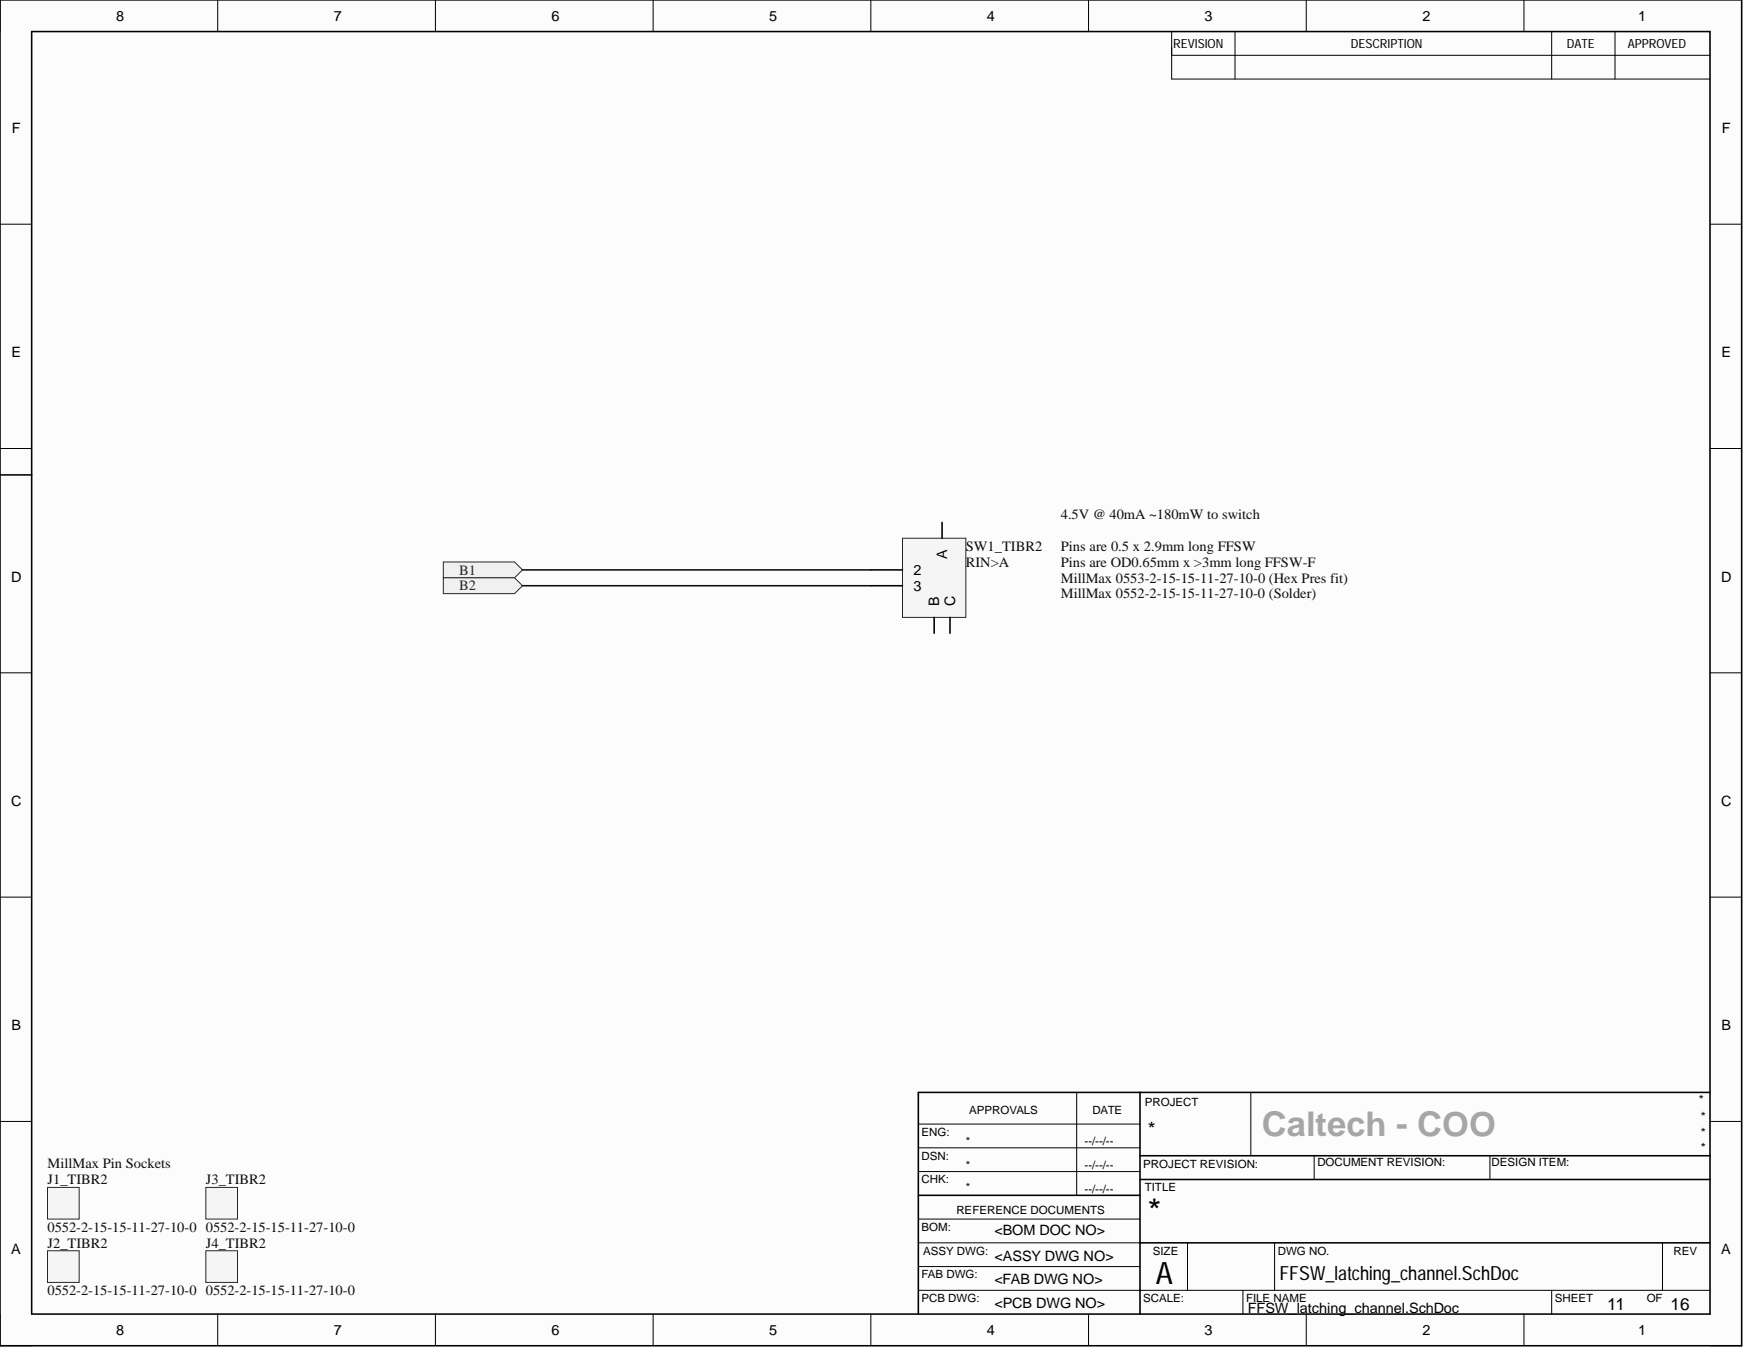
[picture p33: page 37]
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

DATE | PROJECT * | * * APPROVALS Caltech - COO * *

ENG: * | --/--/--

DSN: * | --/--/--

PROJECT REVISION: | DOCUMENT REVISION: | DESIGN ITEM:

CHK: * | --/--/--

A | | FFSW_latching_channel.SchDoc

FFSW_latching_channel.SchDoc | 11 16

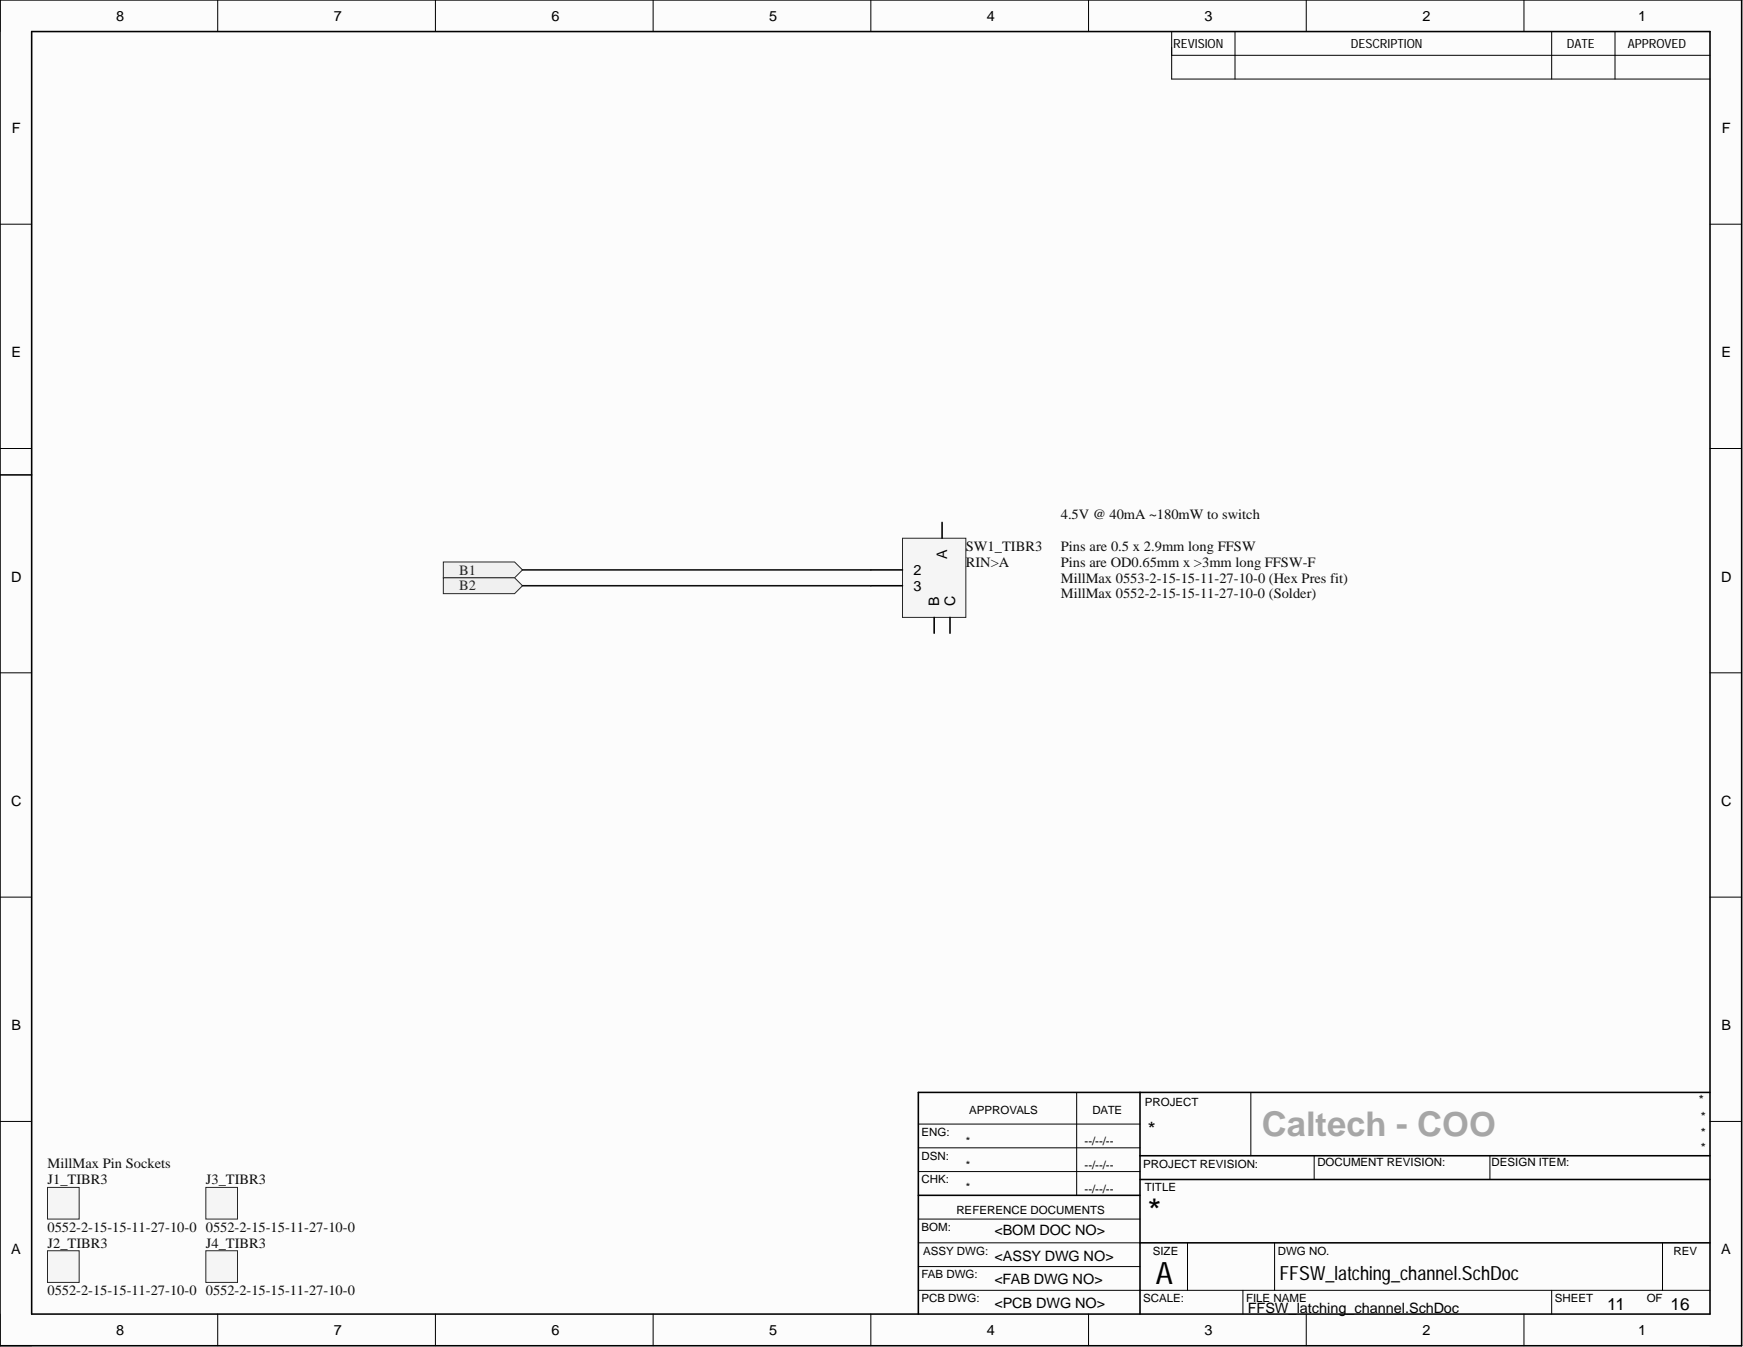
[picture p34: page 38]
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

DATE | PROJECT * | * * APPROVALS Caltech - COO * *

ENG: * | --/--/--

DSN: * | --/--/--

PROJECT REVISION: | DOCUMENT REVISION: | DESIGN ITEM:

CHK: * | --/--/--

A | | FFSW_latching_channel.SchDoc

FFSW_latching_channel.SchDoc | 11 16

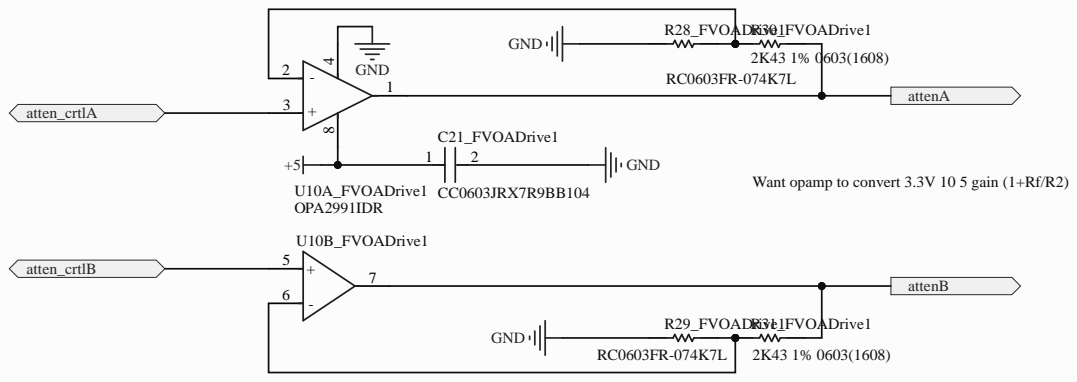
[picture p35: page 39]

Want opamp to convert 3.3V 10 5 gain (1+Rf/R2)

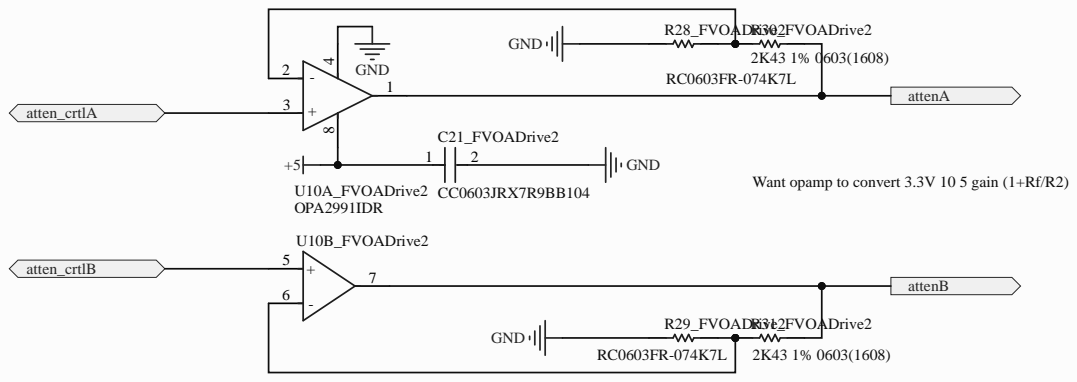
[picture p36: page 40]

Want opamp to convert 3.3V 10 5 gain (1+Rf/R2)

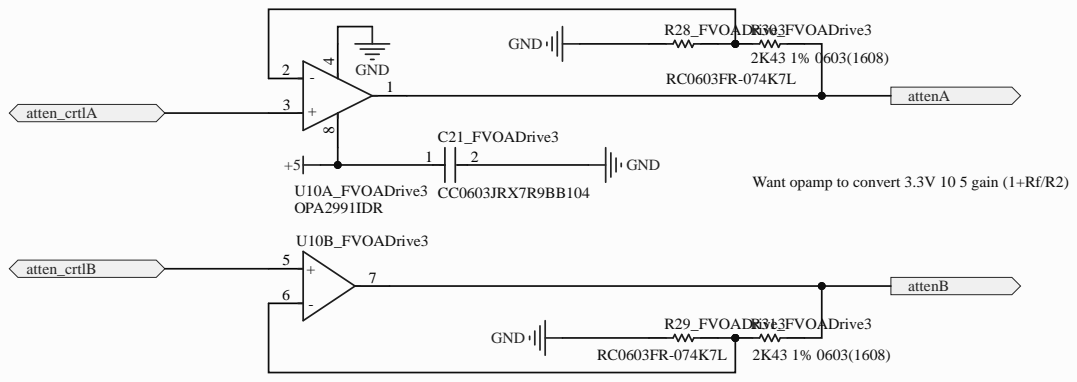
[picture p37: page 41]

Want opamp to convert 3.3V 10 5 gain (1+Rf/R2)

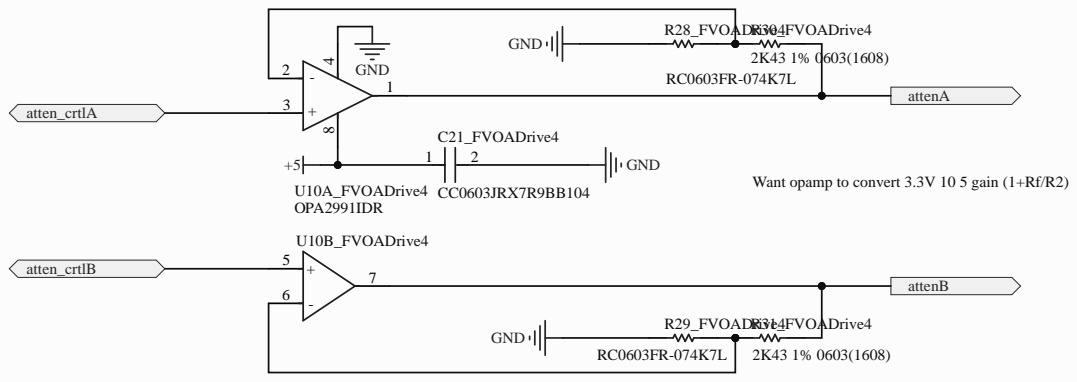
[picture p38: page 42]

Want opamp to convert 3.3V 10 5 gain (1+Rf/R2)

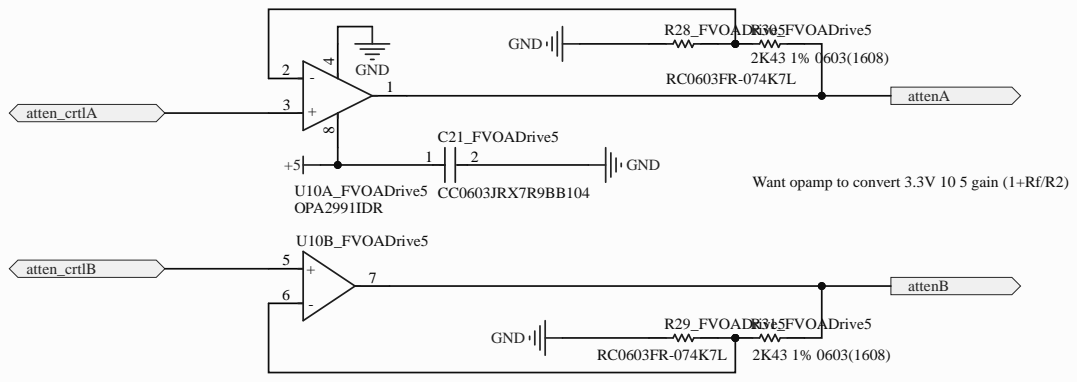
[picture p39: page 43]

Want opamp to convert 3.3V 10 5 gain (1+Rf/R2)

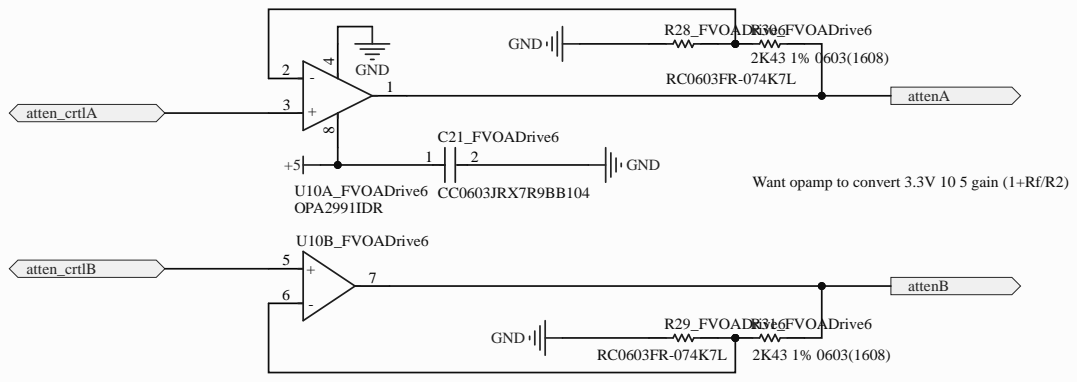
[picture p40: page 44]

Want opamp to convert 3.3V 10 5 gain (1+Rf/R2)

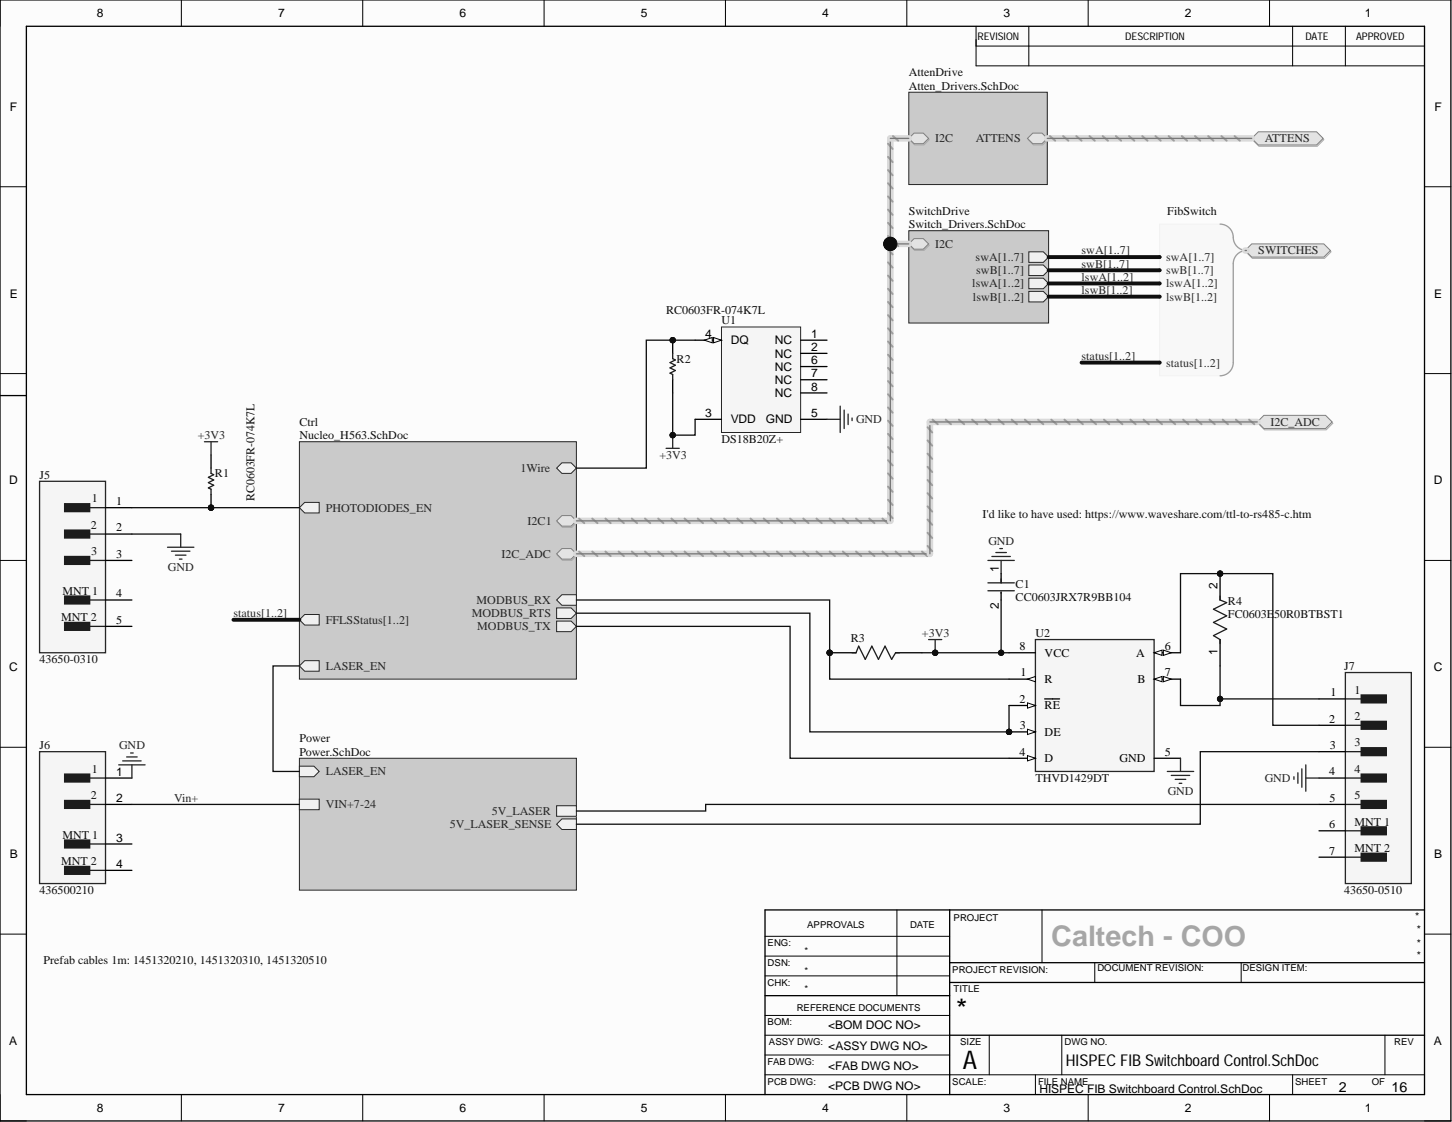
[picture p41: page 45]

I'd like to have used: https://www.waveshare.com/ttl-to-rs485-c.htm

Power Power.SchDoc | RE 2

DATE | PROJECT | * * APPROVALS Caltech - COO * *

ENG: *

DSN: *

PROJECT REVISION: | DOCUMENT REVISION: | DESIGN ITEM:

CHK: *

A | | HISPEC FIB Switchboard Control.SchDoc

HISPEC FIB Switchboard Control.SchDoc | 2 16

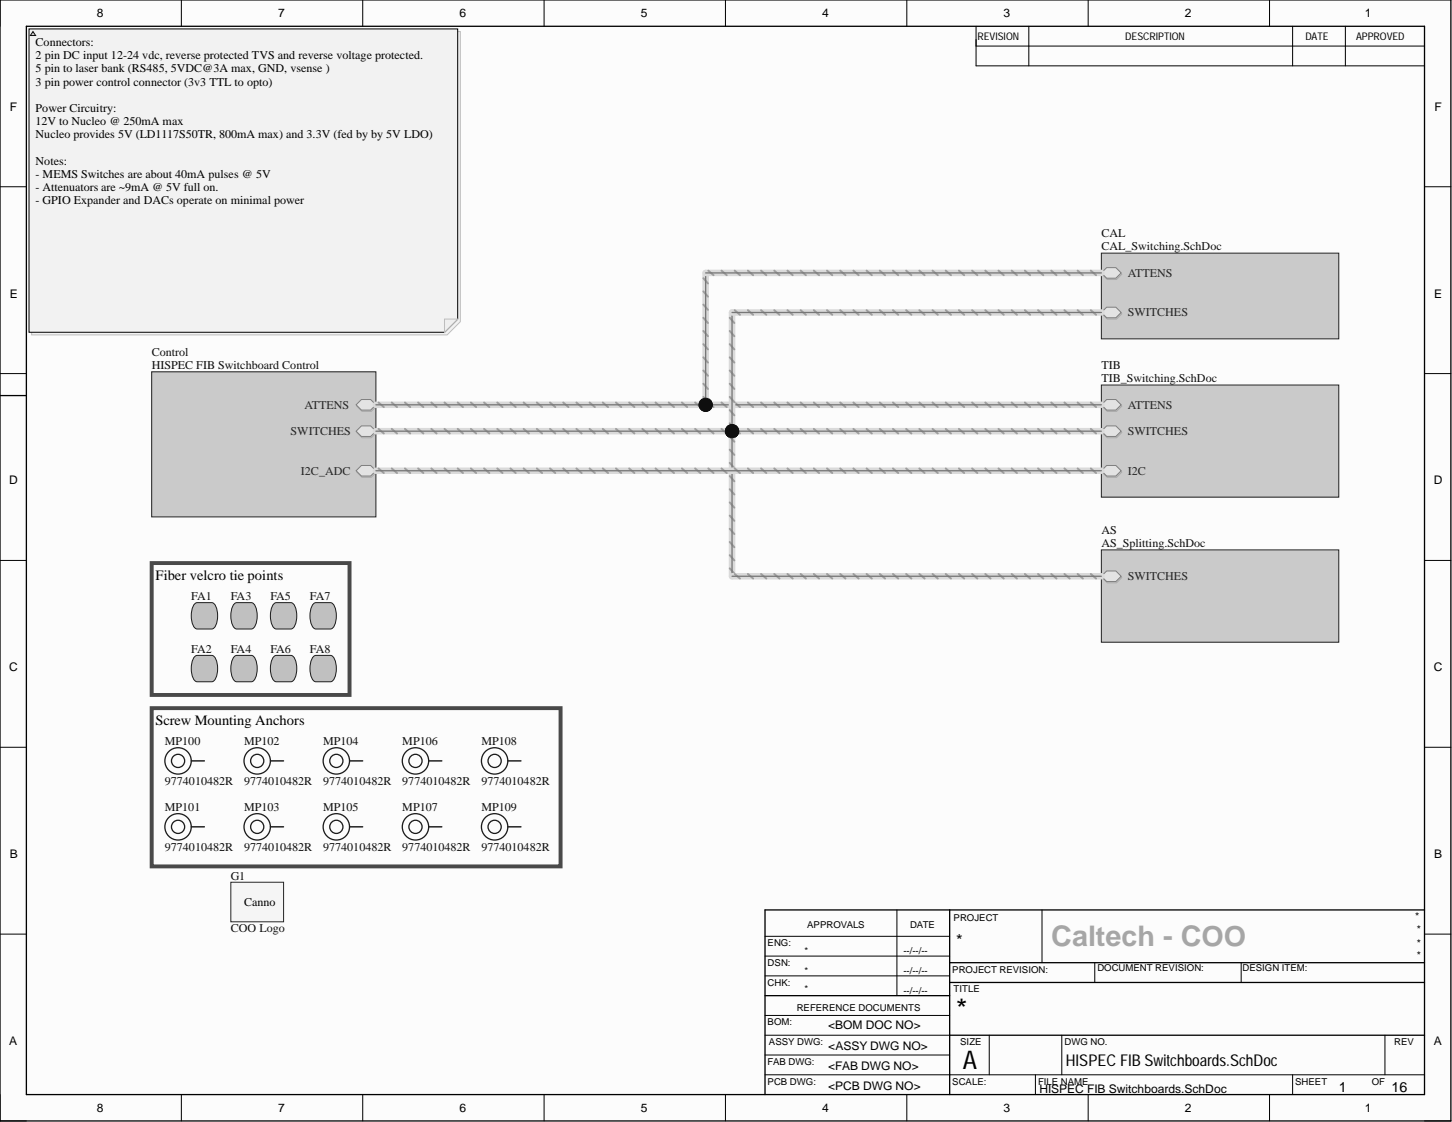
[picture p42: page 46]

Connectors:
2 pin DC input 12-24 vdc, reverse protected TVS and reverse voltage protected.
5 pin to laser bank (RS485, 5VDC@3A max, GND, vsense )
3 pin power control connector (3v3 TTL to opto)

Power Circuitry:
12V to Nucleo @ 250mA max
Nucleo provides 5V (LD1117S50TR, 800mA max) and 3.3V (fed by by 5V LDO)

Notes:
- MEMS Switches are about 40mA pulses @ 5V
- Attenuators are ~9mA @ 5V full on.
- GPIO Expander and DACs operate on minimal power

Control
HISPEC FIB Switchboard Control

Fiber velcro tie points

DATE | PROJECT * | * * APPROVALS Caltech - COO * *

ENG: * | --/--/--

DSN: * | --/--/--

PROJECT REVISION: | DOCUMENT REVISION: | DESIGN ITEM:

CHK: * | --/--/--

A | | HISPEC FIB Switchboards.SchDoc

HISPEC FIB Switchboards.SchDoc | 1 16

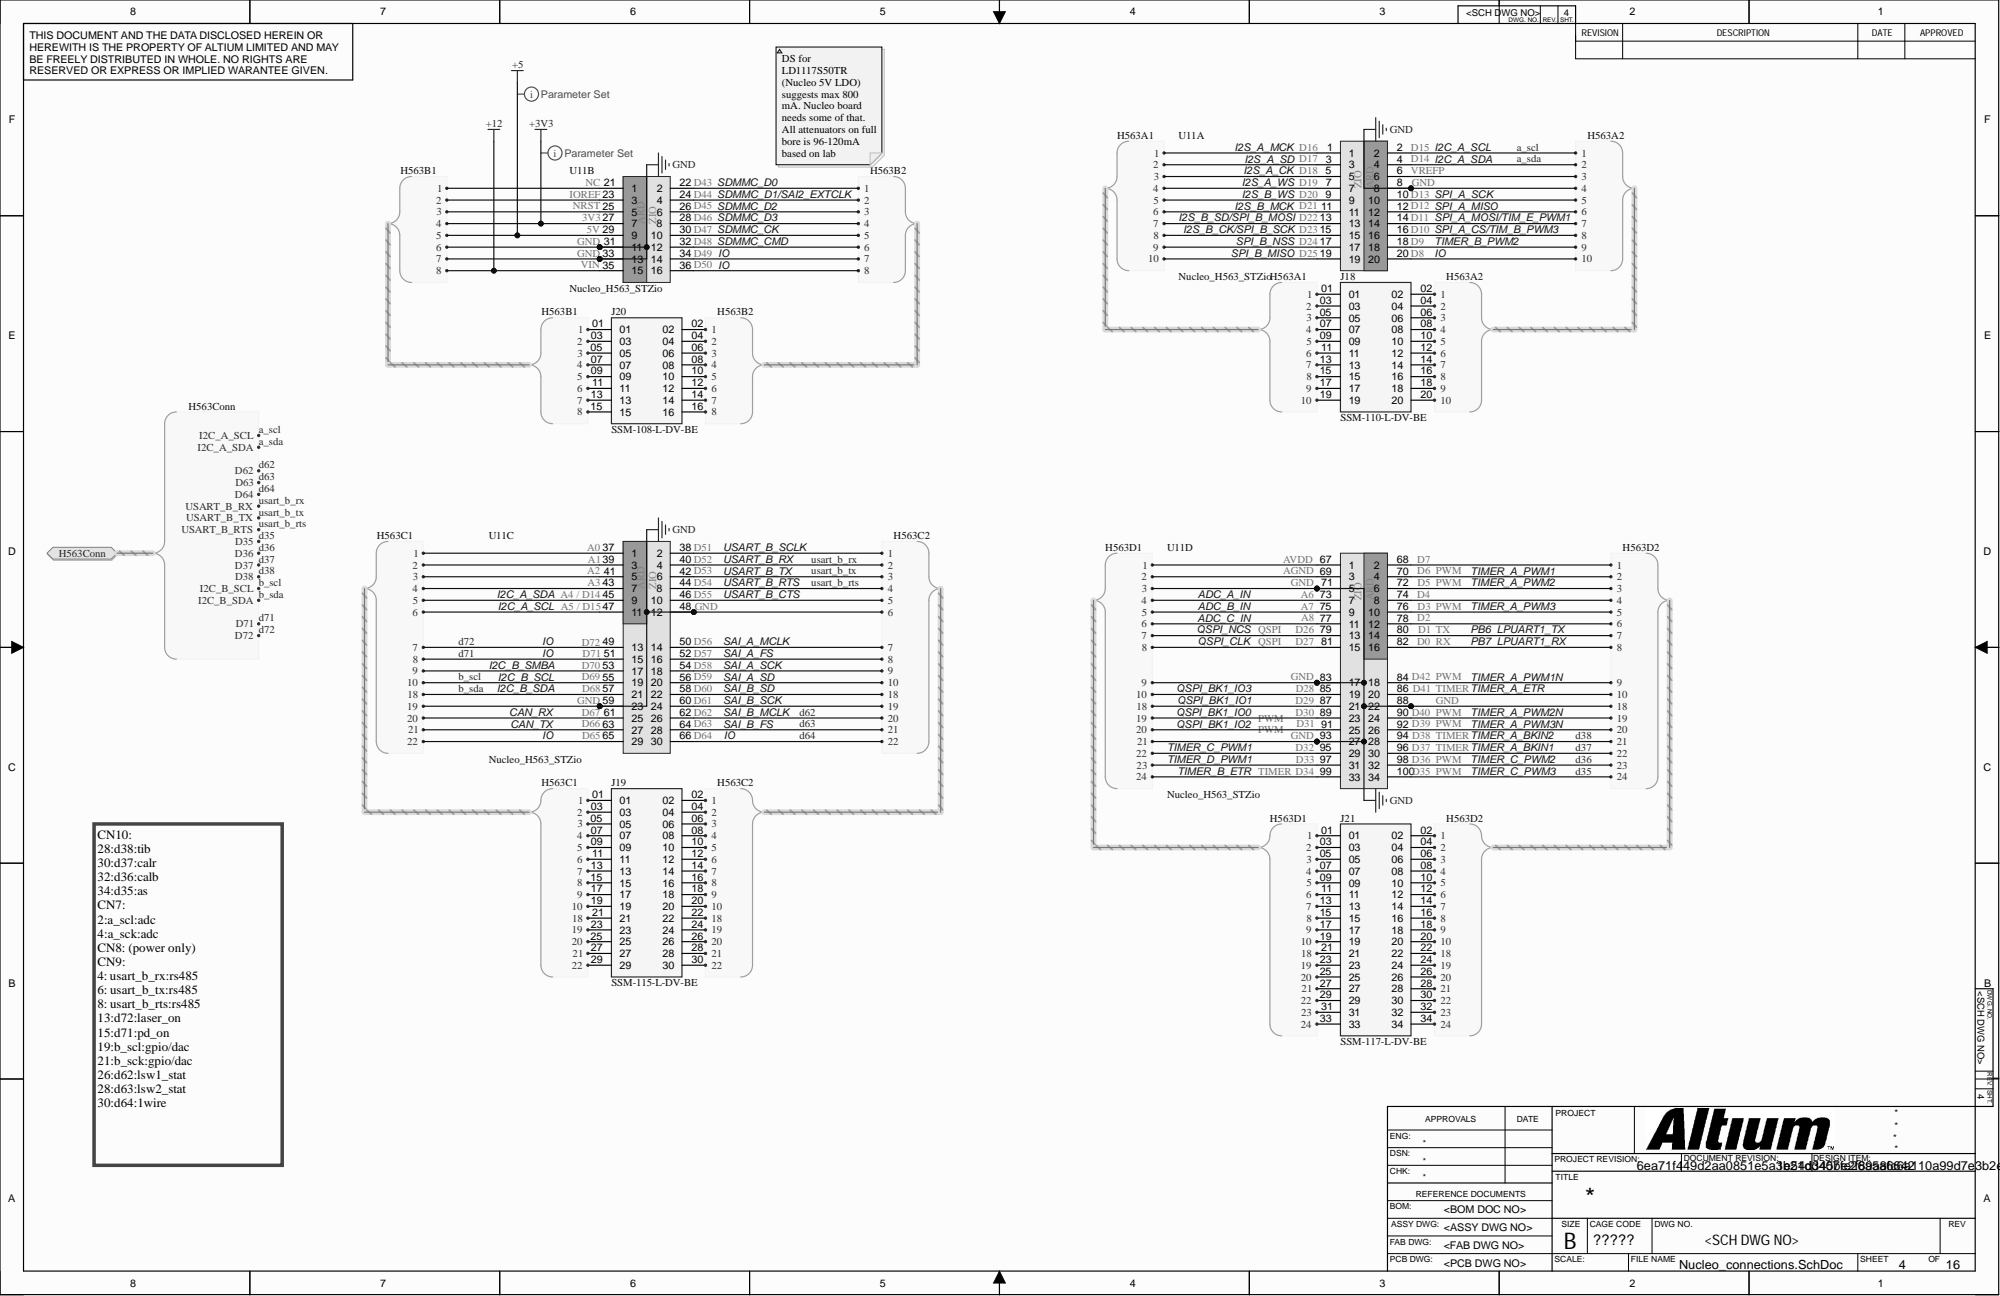
[picture p43: page 47]

<SCH DWG NO> | DWG. NO. | RE V . | SHT | .

THIS DOCUMENT AND THE DATA DISCLOSED HEREIN OR HEREWITH IS THE PROPERTY OF ALTIUM LIMITED AND MAY BE FREEL Y DISTRIBUTED IN WHOLE. NO RIGHTS ARE RESERVED OR EXPRESS OR IMPLIED WARANTEE GIVEN.

DS for
(Nucleo 5V LDO)
suggests max 800
mA. Nucleo board
needs some of that.
All attenuators on full
bore is 96-120mA
based on lab

REV. SHT. DWG. NO.

DATE | PRO JECT | **** APPROVALS

ENG :
** DSN:

CHK: *

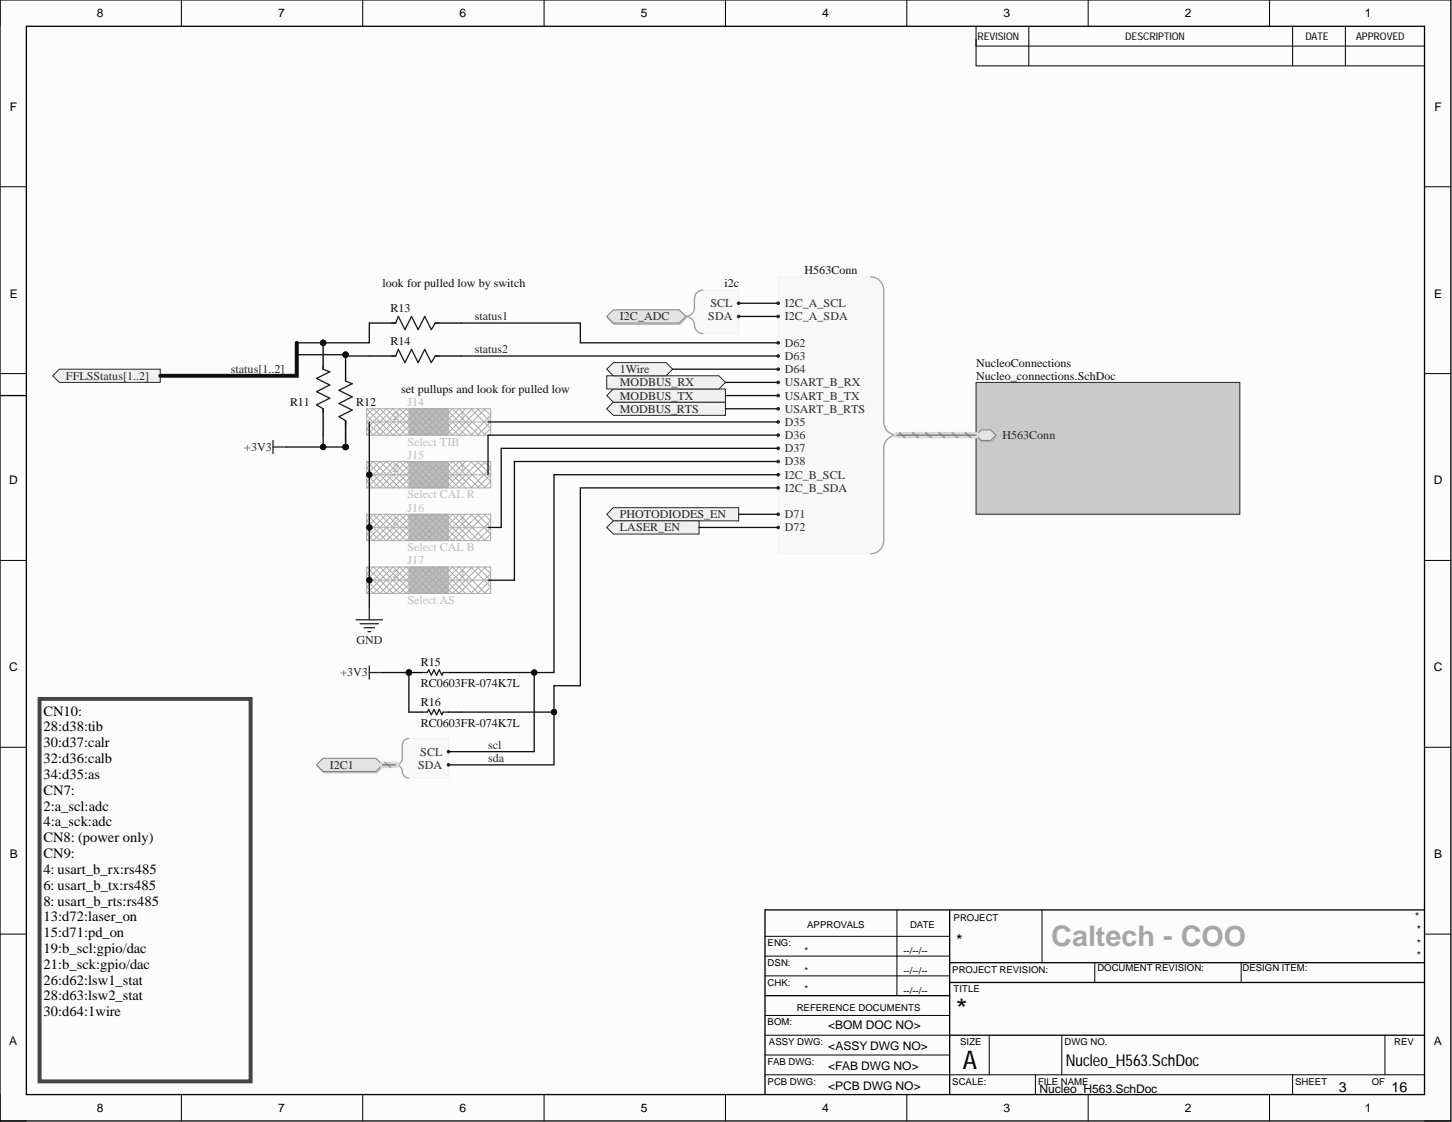
[picture p44: page 48]

look for pulled low by switch

status[1..2] | MODBUS_RX set pullups and look for pulled low MODBUS_TX

Select TIB J15

DATE | PROJECT * | * * APPROVALS Caltech - COO * *

ENG: * | --/--/--

DSN: * | --/--/--

PROJECT REVISION: | DOCUMENT REVISION: | DESIGN ITEM:

CHK: * | --/--/--

A | | Nucleo_H563.SchDoc

Nucleo_H563.SchDoc | 3 16

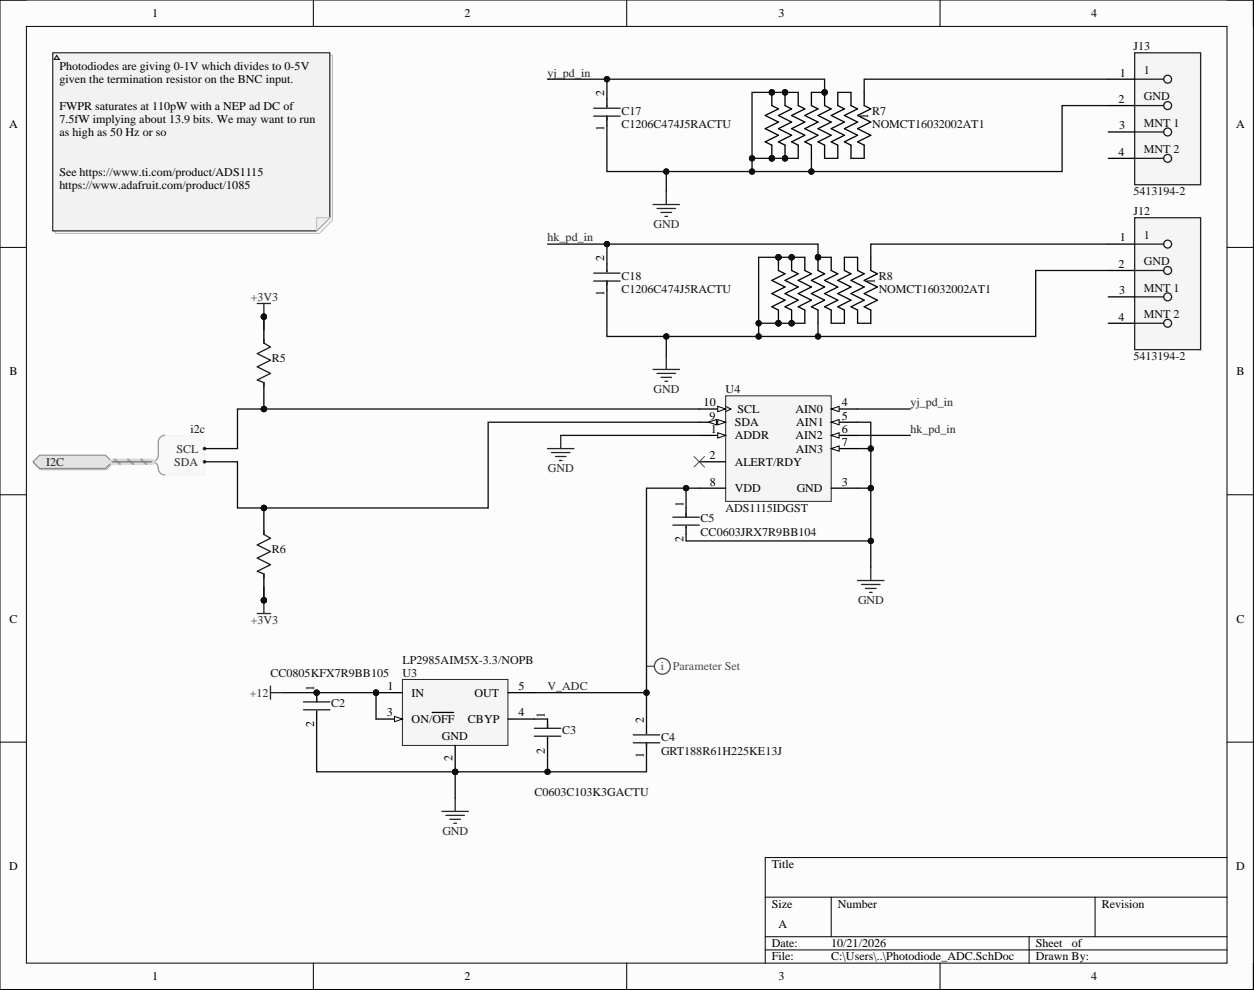
[picture p45: page 49]

Photodiodes are giving 0-1V which divides to 0-5V
given the termination resistor on the BNC input.

FWPR saturates at 110pW with a NEP ad DC of
7.5fW implying about 13.9 bits. We may want to run
as high as 50 Hz or so

See https://www.ti.com/product/ADS1
https://www.adafruit.com/product/1085

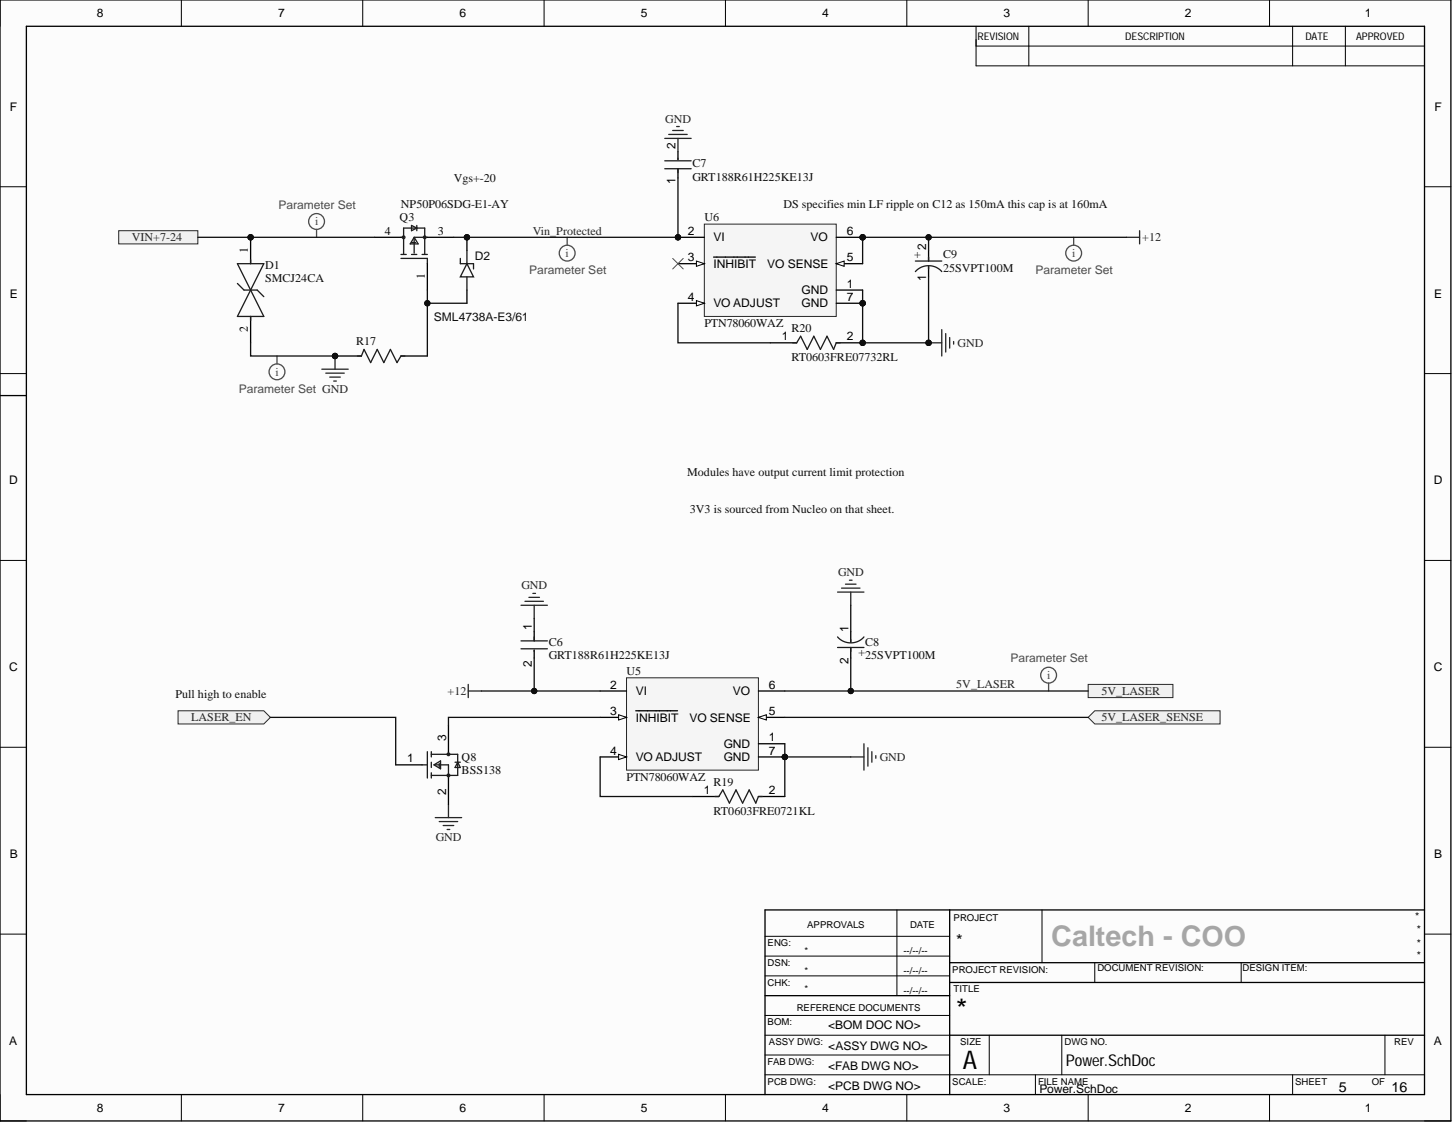
[picture p46: page 50]

DS specifies min LF ripple on C12 as 150mA this cap is at 160mA

Modules have output current limit protection

3V3 is sourced from Nucleo on that sheet.

Pull high to enable

DATE | PROJECT * | * * APPROVALS Caltech - COO * *

ENG: * | --/--/--

DSN: * | --/--/--

PROJECT REVISION: | DOCUMENT REVISION: | DESIGN ITEM:

CHK: * | --/--/--

A | | Power.SchDoc

Power.SchDoc | 5 16

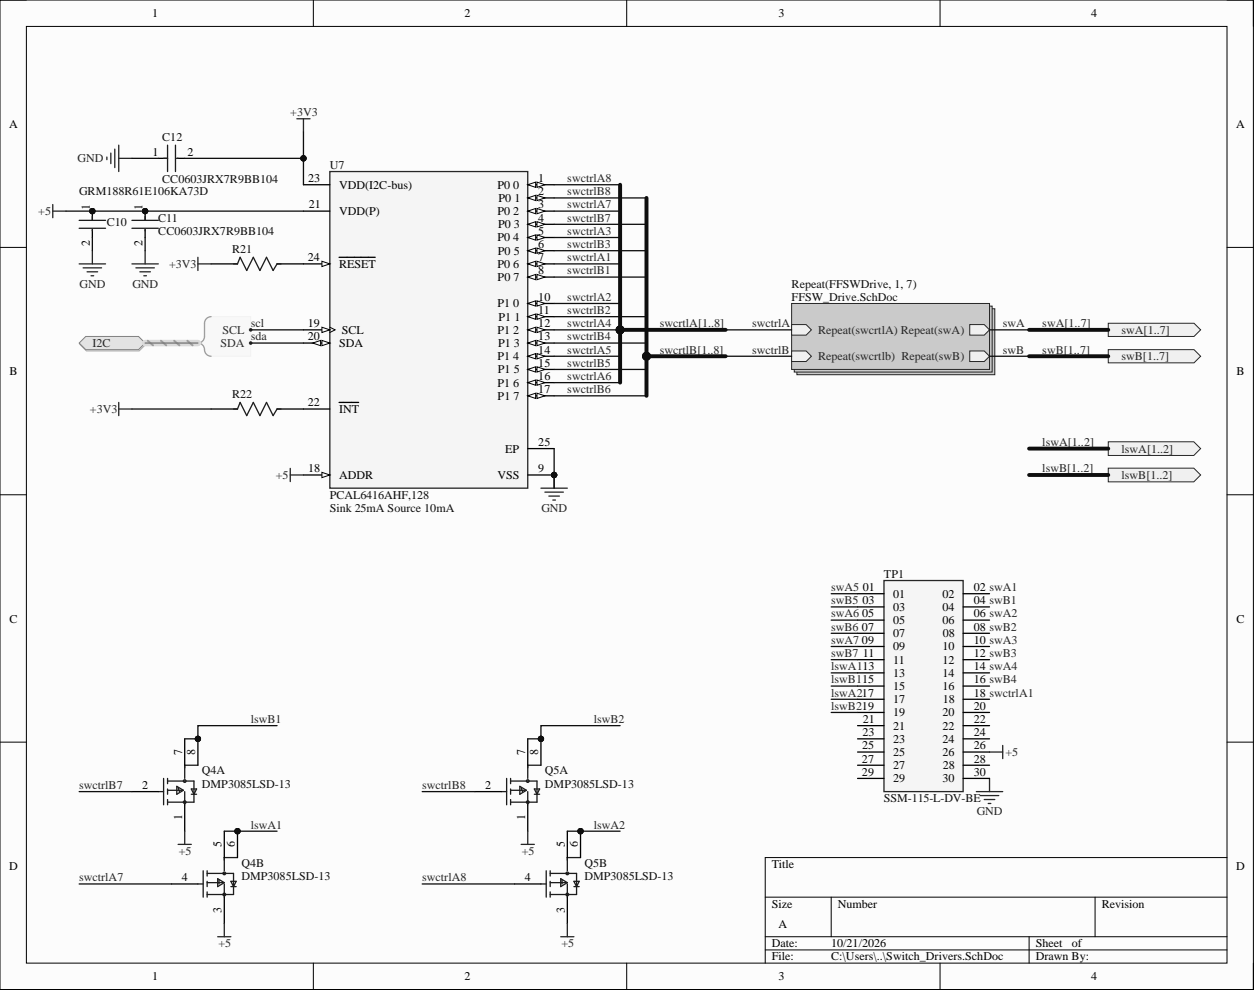
[picture p47: page 51]

VDD(P) 21 | swctrlB8

swctrlA7

RESET 24 | swctrlB7

swctrlA3

swctrlA1

SCL 19 SDA 20 INT 22 | swctrlB1

swctrlA2

swctrlA4
swctrlB4 | swcrtlB[1..8] swctrlB

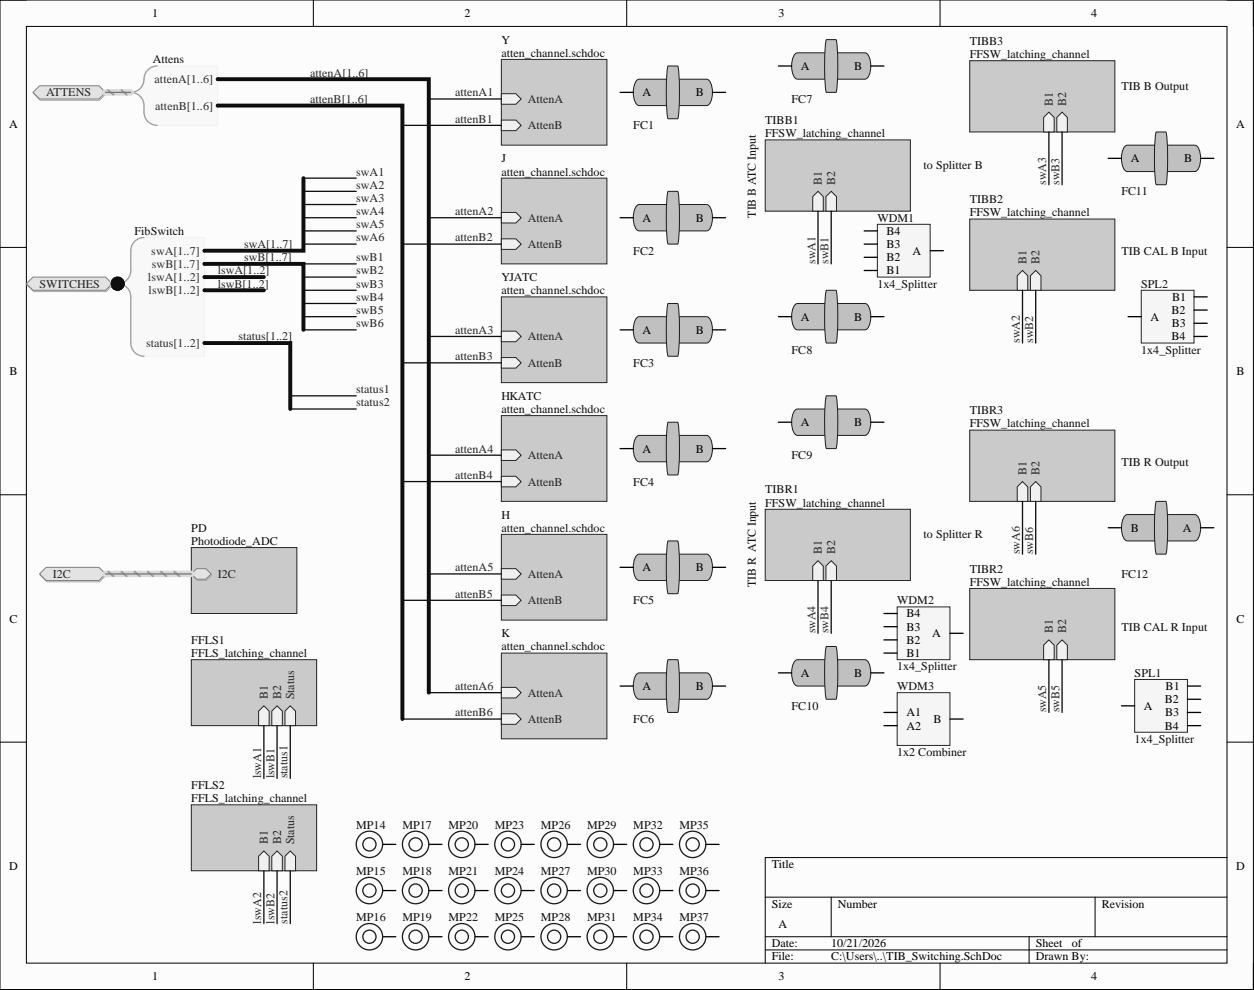
[picture p48: page 52]

TIB R ATC Input TIB B ATC Input
