COO-Utilities/hispec-tib/app/src/main.c

/**
 * @file main.c
 * @brief Boot orchestration, watchdog, network/MQTT pump, and outbound publish.
 *
 * The main thread owns MQTT connection maintenance and all MQTT publish calls.
 * Worker threads and work items enqueue responses, warnings, and telemetry
 * instead of publishing directly.
 *
 * Copyright (c) 2026 Caltech Optical Observatories
 * SPDX-License-Identifier: Apache-2.0
 */

#include <hispec_build_version.h>
#include <zephyr/drivers/watchdog.h>
#include <zephyr/devicetree.h>
#include <zephyr/device.h>
#include <zephyr/kernel.h>
#include <zephyr/logging/log.h>
#include <zephyr/sys/clock.h>
#include <zephyr/sys/util.h>
#include <errno.h>
#include <string.h>
#include <time.h>

#include <coo_commons/mqtt_client.h>
#include <coo_commons/command_dispatch.h>
#include <coo_commons/network.h>
#if defined(CONFIG_COO_OTA)
#include <coo_commons/ota.h>
#endif

#include "app_identity.h"
#include "app_output.h"
#include "app_settings.h"
#include "command.h"
#include "devices.h"
#include "housekeeping.h"
#include "laserbank_tempcontrol.h"
#include "lasers.h"
#include "photodiode.h"
#include "throughput_monitor.h"
#if defined(CONFIG_SNTP)
#include "sntp_sync.h"
#endif

LOG_MODULE_REGISTER(main, LOG_LEVEL_DBG);

/* TODO Enumerate and describe thread priorities across the whole app, and what their responsibilities are here
 *
 * Preemptible application order: MEMS 0, photodiode 1, system/Modbus RX 2,
 * throughput 3, main/MQTT 4, commands 6, blocking work 7, logging 13, fit 14.
 * Throughput/autolevel can write DACs and lasers; MEMS pulse cleanup, PD
 * sampling, and Modbus completion must be able to preempt its numerical work.


 * Zephyr Modbus parses client RX frames on the system workqueue. App-owned
 * background work that can block on Modbus, 1-Wire, or slow GPIO must run below
 * command execution on a separate queue so it cannot starve Modbus RX parsing.

* Network setup returns after starting DHCP/static policy; DHCP fallback is a
 * later system-work item, not part of the boot watchdog budget.
*/

#define EXECUTOR_STACK_SIZE 8192
#define EXECUTOR_PRIORITY 6

#define PHOTODIODE_STACK_SIZE 2048 //1400
#define PHOTODIODE_PRIORITY 1

#define THROUGHPUT_MONITOR_STACK_SIZE 4096
/* Calibration temporarily lowers this thread to the lowest application priority
 * for numerical fitting; acquisition and active autolevel retain this priority.
 */
#define THROUGHPUT_MONITOR_PRIORITY 3

#define APP_BLOCKING_WORKQ_STACK_SIZE 3072
#define APP_BLOCKING_WORKQ_PRIORITY 7

//Set to 1 to get periodic timing summaries in more detail, may  (will) mess with timing
#define APP_TIMING_SUMMARY_LOGS 0

#define WDT_TIMEOUT_MS 15000U
#define MQTT_CONNECT_RETRY_MS 5000

static struct mqtt_client client_ctx;
static char mqtt_cmd_subscription[COO_CMD_TOPIC_MAX];

static K_THREAD_STACK_DEFINE(exec_stack, EXECUTOR_STACK_SIZE);
static struct k_thread exec_thread_data;

static K_THREAD_STACK_DEFINE(photodiode_stack, PHOTODIODE_STACK_SIZE);
static struct k_thread photodiode_thread_data;

static K_THREAD_STACK_DEFINE(throughput_monitor_stack, THROUGHPUT_MONITOR_STACK_SIZE);
static struct k_thread throughput_monitor_thread_data;

static K_THREAD_STACK_DEFINE(app_blocking_workq_stack, APP_BLOCKING_WORKQ_STACK_SIZE);
static struct k_work_q app_blocking_workq;
static const struct k_work_queue_config app_blocking_workq_config = {
	.name = "app_blocking",
};

bool app_timing_summary_logs_enabled(void)
{
	return APP_TIMING_SUMMARY_LOGS != 0;
}

static void load_network_config(struct network_config *cfg)
{
	struct app_ip_settings ip_cfg = {0};
#if defined(CONFIG_NET_DHCPV4)
	const bool dhcp_supported = true;
#else
	const bool dhcp_supported = false;
#endif

	if (cfg == NULL) {
		return;
	}

	network_config_defaults(cfg);
	app_settings_get_ip(&ip_cfg);

	cfg->try_dhcp_first = ip_cfg.try_dhcp_first && dhcp_supported;
	cfg->prefer_dhcp_dns = ip_cfg.prefer_dhcp_dns;
	cfg->prefer_dhcp_ntp = ip_cfg.prefer_dhcp_ntp;

	strncpy(cfg->static_profile.ip, ip_cfg.ip, sizeof(cfg->static_profile.ip) - 1U);
	cfg->static_profile.ip[sizeof(cfg->static_profile.ip) - 1U] = '\0';
	strncpy(cfg->static_profile.subnet, ip_cfg.subnet, sizeof(cfg->static_profile.subnet) - 1U);
	cfg->static_profile.subnet[sizeof(cfg->static_profile.subnet) - 1U] = '\0';
	strncpy(cfg->static_profile.gateway, ip_cfg.gateway, sizeof(cfg->static_profile.gateway) - 1U);
	cfg->static_profile.gateway[sizeof(cfg->static_profile.gateway) - 1U] = '\0';

#if defined(CONFIG_DNS_RESOLVER)
	strncpy(cfg->static_profile.dns, ip_cfg.dns, sizeof(cfg->static_profile.dns) - 1U);
	cfg->static_profile.dns[sizeof(cfg->static_profile.dns) - 1U] = '\0';
#endif

#if defined(CONFIG_SNTP)
	strncpy(cfg->static_profile.ntp, ip_cfg.ntp, sizeof(cfg->static_profile.ntp) - 1U);
	cfg->static_profile.ntp[sizeof(cfg->static_profile.ntp) - 1U] = '\0';
#endif
}

//TODO I think this should be part of coo mqtt  or coo command dispatch
static void load_mqtt_config(struct coo_mqtt_broker_config *cfg)
{
	struct app_mqtt_settings mqtt_cfg = {0};

	if (cfg == NULL) {
		return;
	}

	memset(cfg, 0, sizeof(*cfg));
	app_settings_get_mqtt(&mqtt_cfg);
	strncpy(cfg->host, mqtt_cfg.broker_host, sizeof(cfg->host) - 1U);
	cfg->host[sizeof(cfg->host) - 1U] = '\0';
	cfg->port = mqtt_cfg.broker_port;
}

//TODO I think this should be part of coo mqtt  or coo command dispatch
static bool mqtt_config_equal(const struct coo_mqtt_broker_config *a,
			      const struct coo_mqtt_broker_config *b)
{
	return a != NULL && b != NULL &&
	       a->port == b->port &&
	       strcmp(a->host, b->host) == 0;
}

//TODO I think this should be part of coo mqtt  or coo command dispatch
static void restore_mqtt_config(const struct coo_mqtt_broker_config *cfg)
{
	struct app_mqtt_settings mqtt_cfg = {0};

	if (cfg == NULL) {
		return;
	}

	strncpy(mqtt_cfg.broker_host, cfg->host, sizeof(mqtt_cfg.broker_host) - 1U);
	mqtt_cfg.broker_host[sizeof(mqtt_cfg.broker_host) - 1U] = '\0';
	mqtt_cfg.broker_port = cfg->port;
	/* Revert persistent settings too so a resolvable but unreachable broker
	 * does not strand the next boot on the rejected endpoint.
	 */
	int rc = app_settings_update_mqtt(&mqtt_cfg, true);
	if (rc != 0) {
		char context[32];
		snprintk(context, sizeof(context), "rc=%d", rc);
		app_output_emit(&(const struct coo_cmd_runtime_emit_args){
			.type = COO_CMD_RUNTIME_EMIT_WARNING,
			.delivery = COO_CMD_RUNTIME_EMIT_BEST_EFFORT,
			.code = "mqtt_revert_persist_failed",
			.msg = "prior MQTT broker restored in RAM; saving failed",
			.context = context,
		});
		LOG_WRN("MQTT broker restored in RAM; persistence failed (%d)", rc);
	}
}


/**
 * @brief Configure the hardware watchdog used by the main network/MQTT loop.
 *
 * The STM32 IWDG resets the MCU if the main loop stops feeding it. It does not
 * use an application callback in this build, because Zephyr's STM32 IWDG driver
 * only supports callbacks when early-wakeup interrupt support is enabled. Setup
 * writes hardware watchdog registers and can briefly wait for them to settle.
 * In the OTA build, MCUboot leaves IWDG running at 30 seconds across chainload;
 * the fresh STM32 driver state permits reprogramming our 15-second timeout.
 * Uploads keep this main-loop budget. Trial expiry deliberately stops feeding.
 */
static int watchdog_init(const struct device **wdt_out, int *wdt_channel_out)
{
	const struct device *wdt;
	struct wdt_timeout_cfg wdt_config;
	int wdt_channel_id;
	int rc;

	wdt = DEVICE_DT_GET_OR_NULL(DT_ALIAS(watchdog0));
	if (!wdt || !device_is_ready(wdt)) {
		LOG_WRN("Watchdog device unavailable");
		*wdt_out = NULL;
		return -ENODEV;
	}

	wdt_config.flags = WDT_FLAG_RESET_SOC;
	wdt_config.window.min = 0U;
	wdt_config.window.max = WDT_TIMEOUT_MS;
	wdt_config.callback = NULL;

	wdt_channel_id = wdt_install_timeout(wdt, &wdt_config);
	if (wdt_channel_id < 0) {
		return wdt_channel_id;
	}

	rc = wdt_setup(wdt, WDT_OPT_PAUSE_HALTED_BY_DBG);
	if (rc < 0) {
		return rc;
	}

	*wdt_out = wdt;
	*wdt_channel_out = wdt_channel_id;
	return 0;
}



// TODO, why isn't also triggering a mqtt reconnect here?
static void network_event_handler(bool connected)
{
	LOG_INF("Network event: %s", connected ? "connected" : "disconnected");
	if (connected)
		sntp_sync_schedule_now();
}


//TODO I want to refashion things such that all log messages are able to be emitted as console telemetry by mqtt
// This needs a configurable call that controls whether the message is best effort or not and if it does go out over
// mqtt and then an app level config for the level that is transmitted (debug/info/warn+err) that is configurable over mqtt
// early boot messages clearly may not get out and only go to serial, if there is a q for them then I think that the
// earlier messages in a burst would be sent and later dropped.
// I'm not adamant about this though as if I do it I want to commit and replace ALL LOG_INF/LOG_ERR/etc with a COO_LOG
// or COO_TELEM or some such
// Telemetry needs both uptime and unixtime
// there are warings like LOG_WRN("Outbound queue full; boot watchdog telemetry not queued"); that serve no purpose.
// All console messages need to be evaluated for the assumption that the console is UNMONITORED. so for example if boot telem isn't making it out cause the
// queue is full it either wasn't needed in the first place or there is now a problem that vitally needs to be debugged. So careful thout about what actually CAN happen and design of flow and sizes based on that is appropriate


#if defined(CONFIG_COO_OTA)
/* Inspect the existing bank state only. The operator shuts down experiments
 * and selects override_off before opening OTA; this callback performs no I/O.
 */
static int ota_check_ready(void *user_data)
{
	ARG_UNUSED(user_data);
	if (devices_board_type() == HISPEC_BOARD_TIB &&
	    (hispec_laser_bank_power_mode_get() != HISPEC_LASER_BANK_POWER_OVERRIDE_OFF ||
	     hispec_laser_bank_power_is_enabled())) {
		LOG_WRN("Set laser bank override_off before opening OTA");
		return -EPERM;
	}
	return 0;
}
#endif

int main(void)
{
	int rc;
	const struct device *wdt = NULL;
	int wdt_channel = -1;
	bool mqtt_subscribed = false;
	uint32_t mqtt_cfg_revision = 0U;
	bool mqtt_revert_on_connect_failure = false;
	struct network_config net_cfg;
	struct coo_mqtt_broker_config mqtt_cfg;
	struct coo_mqtt_broker_config prior_mqtt_cfg = {0};
	struct coo_cmd_runtime *cmd_runtime;
	int64_t next_mqtt_connect_ms = 0;
	bool board_devices_ready;

	LOG_INF("HISPEC-FIB PCB  %s\n", HISPEC_BUILD_VERSION);

	devices_capture_boot_reset_cause();

	rc = watchdog_init(&wdt, &wdt_channel);
	if (rc != 0) {
		LOG_ERR("Watchdog init failed (%d); refusing to boot", rc);
		return rc;
	}

	rc = app_settings_init();
	if (rc != 0) {
		LOG_ERR("Settings init/load failed (%d); refusing to boot", rc);
		return rc;
	}

	rc = devices_detect_board_type();
	if (rc != 0) {
		LOG_ERR("Board type detection failed (%d); optional hardware setup will stay disabled", rc);
	} else {
		bool board_changed = false;

		rc = app_settings_note_board_type(devices_board_type_name(), &board_changed);
		if (rc != 0) {
			LOG_WRN("Failed to persist board type %s (%d)",
				devices_board_type_name(), rc);
		} else if (board_changed) {
			LOG_WRN("Settings reset after board type change to %s",
				devices_board_type_name());
		}
	}

	//TODO move to right after app settings. this needs to ensure that loading does not depend on detecting board type.

	sntp_sync_restore_rtc();
	app_settings_increment_boot_count();

	rc = command_runtime_init(&app_blocking_workq);
	if (rc != 0) {
		LOG_ERR("Command runtime init failed (%d)", rc);
		return rc;
	}
	cmd_runtime = command_runtime_get();
	devices_queue_boot_reset_telemetry();

	board_devices_ready = devices_ready();
#if defined(CONFIG_COO_OTA)
	struct coo_ota_status ota_status;

	rc = coo_ota_init(ota_check_ready, NULL);
	if (rc != 0) {
		LOG_ERR("OTA boot state initialization failed (%d); refusing to boot", rc);
		return rc;
	}
	/* Trial hardware preparation must precede every worker and command ingress.
	 * Confirmation leaves this mode in place; only the operator restores auto.
	 */
	coo_ota_get_status(&ota_status);
	if (!ota_status.confirmed && devices_board_type() == HISPEC_BOARD_TIB) {
		rc = hispec_laser_bank_power_mode_set(HISPEC_LASER_BANK_POWER_OVERRIDE_OFF);
		if (rc != 0) {
			LOG_ERR("Trial bank shutdown failed (%d); refusing to boot", rc);
			return rc;
		}
	}
#endif
	setup_mems_switches_and_routes();
	setup_attenuators();

	/* Reboot preparation shares this queue: Modbus RX must remain free on
	 * the system queue while shutdown waits for driver replies. */
	k_work_queue_init(&app_blocking_workq);
	k_work_queue_start(&app_blocking_workq,
			   app_blocking_workq_stack,
			   K_THREAD_STACK_SIZEOF(app_blocking_workq_stack),
			   APP_BLOCKING_WORKQ_PRIORITY,
			   &app_blocking_workq_config);


	hispec_laser_autooff_start(&app_blocking_workq);
	housekeeping_start(&app_blocking_workq);

	if (devices_board_type() == HISPEC_BOARD_TIB) {
		//TODO if the board devices are not ready then we can't continue (or rather we continue but are going to throw LOTS of errors)
		if (board_devices_ready) {
			k_thread_create(&photodiode_thread_data,
					photodiode_stack,
					K_THREAD_STACK_SIZEOF(photodiode_stack),
					photodiode_thread, NULL, NULL, NULL,
					PHOTODIODE_PRIORITY, 0, K_NO_WAIT);
			k_thread_name_set(&photodiode_thread_data, "photodiode");
			k_thread_create(&throughput_monitor_thread_data,
					throughput_monitor_stack,
					K_THREAD_STACK_SIZEOF(throughput_monitor_stack),
					throughput_monitor_thread, NULL, NULL, NULL,
					THROUGHPUT_MONITOR_PRIORITY, 0, K_NO_WAIT);
			k_thread_name_set(&throughput_monitor_thread_data, "throughput");
			laserbank_tempcontrol_start(&app_blocking_workq);
		} else {
			LOG_WRN("TIB background workers disabled because board devices are not ready");
		}
	}

	k_thread_create(&exec_thread_data, exec_stack, K_THREAD_STACK_SIZEOF(exec_stack),
			coo_cmd_runtime_executor_thread, cmd_runtime, NULL, NULL,
			EXECUTOR_PRIORITY, 0, K_NO_WAIT);
	k_thread_name_set(&exec_thread_data, "command_exec");

	sntp_sync_init();

	load_network_config(&net_cfg);
	(void)network_init(&net_cfg, network_event_handler);

	rc = coo_mqtt_init(&client_ctx, app_mqtt_device_id());
	if (rc != 0) {
		LOG_ERR("MQTT init failed (%d)", rc); //TODO move this log to coo_mqtt_init
		return rc;
	}
	load_mqtt_config(&mqtt_cfg);
	rc = coo_mqtt_set_broker_config(&mqtt_cfg);
	if (rc != 0) {
		LOG_ERR("MQTT broker config invalid (%d)", rc); //TODO move this log to coo_mqtt_set_broker_config
		return rc;
	}
	mqtt_cfg_revision = app_settings_get_mqtt_revision();
	coo_mqtt_set_message_callback(coo_cmd_runtime_mqtt_callback, cmd_runtime);

	//TODO get rid of this test. Software should verify the prefix + command string portion fits in buffer AND that all
	// command strings fit in max_command_suffix (and similarly for telemetry/warnings
	//also why is this in braces??
	{
		int written;
		size_t prefix_len;

		strncpy(mqtt_cmd_subscription, cmd_runtime->request_prefix, sizeof(mqtt_cmd_subscription) - 1U);
		mqtt_cmd_subscription[sizeof(mqtt_cmd_subscription) - 1U] = '\0';
		prefix_len = strlen(mqtt_cmd_subscription);
		written = snprintk(mqtt_cmd_subscription + prefix_len, sizeof(mqtt_cmd_subscription) - prefix_len, "#");
		// if (written < 0 ||
		//     written >= (int)(sizeof(mqtt_cmd_subscription) - prefix_len)) {
		// 	LOG_ERR("MQTT command subscription topic too long");
		// 	return -ENOSPC;
		// }
		(void)coo_mqtt_add_subscription(mqtt_cmd_subscription, MQTT_QOS_2_EXACTLY_ONCE);
	}

	while (1) {
		/* MQTT stays connected whenever the network is ready. Serial override
		 * rejection happens in the command runtime, so requesters get
		 * an explicit response instead of a silent disconnect.
		 */
		bool mqtt_can_run = network_is_ready();
		uint32_t current_mqtt_revision = app_settings_get_mqtt_revision();

		coo_cmd_runtime_serial_poll(cmd_runtime);


		//TODO From here to ***** below looks like code that should be consolidated into 1-3 functions and shifted to coo_mqtt or coo_command
		if (current_mqtt_revision != mqtt_cfg_revision) {
			struct coo_mqtt_broker_config new_mqtt_cfg;

			mqtt_cfg_revision = current_mqtt_revision;
			load_mqtt_config(&new_mqtt_cfg);
			rc = coo_mqtt_set_broker_config(&new_mqtt_cfg);
			if (rc != 0) {
				LOG_ERR("MQTT broker reconfigure rejected (%d)", rc);
			} else {
				if (!mqtt_config_equal(&new_mqtt_cfg, &mqtt_cfg)) {
					prior_mqtt_cfg = mqtt_cfg;
					mqtt_cfg = new_mqtt_cfg;
					mqtt_revert_on_connect_failure = true;
				}
				if (coo_mqtt_is_connected()) {
					(void)mqtt_disconnect(&client_ctx, NULL);
					mqtt_subscribed = false;
				}
			}
		}

#if defined(CONFIG_COO_OTA)
		enum coo_ota_poll_result ota_result = coo_ota_poll();

		if (ota_result == COO_OTA_REBOOT_REQUESTED) {
			LOG_WRN("Unconfirmed image trial expired; rebooting for MCUboot rollback");
			rc = coo_cmd_runtime_schedule_reboot(cmd_runtime, false);
			if (rc != 0 && rc != -EALREADY) {
				LOG_ERR("Rollback reboot scheduling failed (%d); watchdog will reset", rc);
			}
		}
		/* Both expiry results withhold feeds, including when scheduling failed. */
		if (ota_result == COO_OTA_CONTINUE) {
			wdt_feed(wdt, wdt_channel);
		}
#else
		wdt_feed(wdt, wdt_channel);
#endif

		if (coo_mqtt_is_connected() && !mqtt_can_run) {
			(void)mqtt_disconnect(&client_ctx, NULL);
			mqtt_subscribed = false;
		}

		if (!coo_mqtt_is_connected() && mqtt_can_run &&
		    k_uptime_get() >= next_mqtt_connect_ms) {
			rc = coo_mqtt_connect(&client_ctx);
			if (rc == 0) {
				mqtt_subscribed = false;
				mqtt_revert_on_connect_failure = false;
				} else if (mqtt_revert_on_connect_failure) {
					char context[160];

					snprintk(context, sizeof(context),
						 "host=%s port=%u rc=%d",
						 mqtt_cfg.host, mqtt_cfg.port, rc);
					app_output_emit(&(const struct coo_cmd_runtime_emit_args){
						.type = COO_CMD_RUNTIME_EMIT_WARNING,
						.delivery = COO_CMD_RUNTIME_EMIT_BEST_EFFORT,
						.code = "mqtt_broker_revert",
						.msg = "MQTT broker connection failed; reverting to prior broker",
						.context = context,
					});
					LOG_WRN("MQTT broker connection failed (%d), reverting to %s:%u",
						rc, prior_mqtt_cfg.host, prior_mqtt_cfg.port);
				mqtt_cfg = prior_mqtt_cfg;
				(void)coo_mqtt_set_broker_config(&mqtt_cfg);
				restore_mqtt_config(&mqtt_cfg);
				mqtt_cfg_revision = app_settings_get_mqtt_revision();
				mqtt_revert_on_connect_failure = false;
			}
			if (rc != 0) {
				next_mqtt_connect_ms = k_uptime_get() + MQTT_CONNECT_RETRY_MS;
			}
		}

		if (coo_mqtt_is_connected() && !mqtt_subscribed) {
			rc = coo_mqtt_subscribe(&client_ctx);
			if (rc == 0) {
				mqtt_subscribed = true;
			}
		}
		// TODO *****

		coo_cmd_runtime_drain_outbound(cmd_runtime, &client_ctx,
					       coo_mqtt_is_connected() && mqtt_can_run);

		if (coo_mqtt_is_connected()) {
			rc = coo_mqtt_process(&client_ctx, cmd_runtime->output_event_fd,
				k_msgq_num_used_get(cmd_runtime->reply_queue) != 0U ||
				k_msgq_num_used_get(cmd_runtime->outbound_queue) != 0U);
			if (rc != 0) {
				(void)mqtt_disconnect(&client_ctx, NULL);
				mqtt_subscribed = false;
			}
		} else {
			k_sleep(K_MSEC(50));
		}
	}
}
