COO-Utilities/hispec-tib/app/src/app_settings.h

/**
 * @file app_settings.h
 * @brief Direct-NVS app configuration and calibration ownership.
 *
 * App-owned numeric NVS IDs store board identity, boot count, operator
 * network/MQTT configuration, attenuator coefficients, photodiode
 * calibration/response settings, laser policy, route loss, and MEMS intent.
 *
 * Copyright (c) 2026 Caltech Optical Observatories
 * SPDX-License-Identifier: Apache-2.0
 */

#ifndef HISPEC_APP_SETTINGS_H
#define HISPEC_APP_SETTINGS_H

#include <stdbool.h>
#include <stdint.h>
#include <zephyr/net/net_ip.h>

#include "attenuator.h"
#include "laser_properties.h"
#include "laserbank_tempcontrol.h"

struct app_ip_settings {
	bool try_dhcp_first;
	bool prefer_dhcp_dns;
	bool prefer_dhcp_ntp;
	char ip[NET_IPV4_ADDR_LEN];
	char subnet[NET_IPV4_ADDR_LEN];
	char gateway[NET_IPV4_ADDR_LEN];
	char dns[NET_IPV4_ADDR_LEN];
	char ntp[NET_IPV4_ADDR_LEN];
};

/** Runtime and optional persisted MQTT broker configuration. */
struct app_mqtt_settings {
	char broker_host[128];
	uint16_t broker_port;
};

/** Number of logical attenuator channels whose calibration may be persisted. */
#define APP_ATTENUATOR_CHANNEL_COUNT 6
#define APP_ATTENUATOR_PHYSICAL_COUNT 2
#define APP_PD_CHANNEL_COUNT 2
#define APP_SETTINGS_BOARD_TYPE_MAX_LEN 16
/* Two TIB channels, 16 launch/return source pairs each. AS has its own PCB/NVS. */
#define APP_ROUTE_LOSS_RECORD_COUNT 32
#define APP_ROUTE_LOSS_ROUTE_MAX_LEN 24
#define APP_ROUTE_LOSS_LASER_MAX_LEN 16
#define APP_LASER_CHANNEL_COUNT 6
#define APP_MEMS_SWITCH_COUNT 8
#define APP_MEMS_SPLIT_CHANNEL_COUNT 2
#define APP_MEMS_SPLIT_OUTPUT_COUNT 3
#define APP_PD_DARK_DURATION_MAX_MS 2000U
#define APP_PD_DEFAULT_AUTOOFF_S 36000U

enum app_pd_power_mode {
	APP_PD_POWER_AUTO = 0,
	APP_PD_POWER_OVERRIDE_ON,
	APP_PD_POWER_OVERRIDE_OFF,
};

struct app_attenuator_physical_settings {
	double fvoa_50pct_mv;
	double slope_inv_fvoa_mv;
	/* Maximum attenuation of one physical FVOA from residual leakage. */
	double max_atten_db;
	double max_calibrated_db;
	/* External op-amp gain applied before the FVOA drive-voltage model. */
	double gain;
	/* Residual model RMS, installed/persisted together with these coefficients. */
	double rms_db;
	/* Optional empirical dB residual correction; all zeros means disabled. */
	float correction_coeff[ATTENUATOR_MODEL_CORRECTION_TERMS];
};

/** Fit acceptance policy; separate NVS record preserves calibration layout. */
struct app_attenuator_fit_policy {
	double max_fit_residual_db[APP_ATTENUATOR_PHYSICAL_COUNT];
};

/** Operational open voltages, stored separately from model coefficients. */
struct app_attenuator_open_settings {
	float mv[APP_ATTENUATOR_PHYSICAL_COUNT];
};

/** Persisted/runtime calibration for one logical attenuator channel. */
struct app_attenuator_channel_settings {
	struct app_attenuator_physical_settings physical[APP_ATTENUATOR_PHYSICAL_COUNT];
};

/** Persisted/runtime attenuator calibration snapshot. */
struct app_attenuator_settings {
	struct app_attenuator_channel_settings channel[APP_ATTENUATOR_CHANNEL_COUNT];
};

/** Persisted/runtime photodiode dark measurement metadata. */
struct app_pd_dark_result {
	uint32_t duration_ms;
	uint16_t failed_samples;
	double mean_mv;
	double rms_mv;
	double min_mv;
	double max_mv;
	int16_t max_raw;
};

/** Photodiode calibration, response, and warning thresholds owned by app settings. */
struct app_pd_channel_settings {
	struct app_pd_dark_result dark;
	struct app_pd_dark_result lowest_dark;
	bool lowest_dark_valid;
	double noise_warn_rms_mv;
	double responsivity_a_per_w;
	/* ADC-input V/A, combining detector transimpedance and the analog divider/gain. */
	double transimpedance_v_per_a;
	enum app_pd_power_mode power;
	uint32_t autooff_s;
};

struct app_photodiode_settings {
	struct app_pd_channel_settings channel[APP_PD_CHANNEL_COUNT];
};

struct app_laserbank_settings {
	enum laserbank_heater_mode heater_mode;
};

/** App-owned laser policy/calibration settings. Driver EEPROM owns raw driver persistence. */
struct app_laser_channel_settings {
	laserprops_t properties;
	/* Throughput autolevel support; manual current/level commands remain independent. */
	double min_autolevel_current_ma;
	double max_autolevel_current_ma;
	double current_cal_pct;
	/* App-owned optical-power uncertainty; never programmed into Maiman. */
	double fractional_noise;
	double constant_noise_mw;
	/* Operator-confirmed driver/diode association. Status may report a different
	 * serial, but does not learn it or authorize writes to the replacement.
	 */
	uint16_t expected_serial;
	bool disable_tec_at_autooff;
	uint32_t autooff_s;
	double tune_delta_nm;
	double total_emitting_s;
};

struct app_laser_settings {
	struct app_laser_channel_settings channel[APP_LASER_CHANNEL_COUNT];
};

/** User-provided optical route transmission keyed by route and source or split output. */
struct app_route_loss_record {
	bool configured;
	char route[APP_ROUTE_LOSS_ROUTE_MAX_LEN];
	char laser[APP_ROUTE_LOSS_LASER_MAX_LEN];
	double transmission;
};

struct app_route_loss_settings {
	struct app_route_loss_record record[APP_ROUTE_LOSS_RECORD_COUNT];
};

/** User-requested MEMS state and restart intent. Physical state is not verified. */
struct app_mems_switch_settings {
	uint8_t static_configured;
	char static_state;
	uint8_t toggle_configured;
	char toggle_state;
	double toggle_duty_cycle;
	uint32_t toggle_cycle_ms;
	uint32_t toggle_duration_s;
};

struct app_mems_split_settings {
	uint8_t configured;
	uint8_t reserved[3];
	double requested[APP_MEMS_SPLIT_OUTPUT_COUNT];
	uint32_t cycle_ms;
	uint32_t duration_s;
};

struct app_mems_settings {
	struct app_mems_switch_settings switch_state[APP_MEMS_SWITCH_COUNT];
	struct app_mems_split_settings split[APP_MEMS_SPLIT_CHANNEL_COUNT];
};

/** Persisted/runtime settings snapshot copied under a module mutex. */
struct app_settings_snapshot {
	char board_type[APP_SETTINGS_BOARD_TYPE_MAX_LEN];
	struct app_ip_settings ip;
	struct app_mqtt_settings mqtt;
	struct app_attenuator_settings attenuator;
	struct app_attenuator_fit_policy attenuator_fit[APP_ATTENUATOR_CHANNEL_COUNT];
	struct app_attenuator_open_settings attenuator_open[APP_ATTENUATOR_CHANNEL_COUNT];
	struct app_photodiode_settings photodiode;
	struct app_laserbank_settings laserbank;
	struct app_laser_settings laser;
	struct app_route_loss_settings route_loss;
	struct app_mems_settings mems;
	uint32_t boot_count;
	uint32_t mqtt_revision;
};

/** Small read-only status projection; this is never stored in NVS. */
struct app_status_settings {
    uint32_t boot_count;
    struct app_mqtt_settings mqtt;
    double launch_tx[APP_LASER_CHANNEL_COUNT][2]; /* AO, FEI; includes source-specific overrides. */
    double split_tx[APP_MEMS_SPLIT_CHANNEL_COUNT][APP_MEMS_SPLIT_OUTPUT_COUNT];
    bool split_configured[APP_MEMS_SPLIT_CHANNEL_COUNT];
};

/** Try copying status inputs from RAM. False leaves out untouched. Copies under
 * K_NO_WAIT, then resolves losses after unlocking; no flash, writes or logging. */
bool app_settings_try_get_status(struct app_status_settings *out);

/**
 * @brief Mount app NVS storage, load persisted values, and keep defaults on failure.
 *
 * Uses Zephyr NVS directly with app-owned numeric IDs, so it may block on
 * flash I/O. If the stored schema marker is missing or incompatible, app NVS
 * storage is cleared and defaults are used.
 */
int app_settings_init(void);
/** Copy all app-owned settings under the settings mutex; no NVS or hardware I/O. */
void app_settings_get_snapshot(struct app_settings_snapshot *out);
/**
 * @brief Record the immutable PCB board type in persistent settings.
 *
 * If a stored board type exists and differs from @p board_type, all other
 * persisted app settings are deleted and runtime settings return to defaults.
 * That treats a physically different solder-strap identity as a first boot.
 */
int app_settings_note_board_type(const char *board_type, bool *changed);
/**
 * @brief Erase persisted app settings except IP settings and boot count.
 *
 * This may block on Zephyr NVS flash I/O. It also resets the runtime settings
 * snapshot to defaults while preserving the current IP snapshot and boot count.
 * The schema marker is preserved as storage metadata.
 */
int app_settings_erase_non_ip_settings(void);
/** @brief Copy current IP settings. */
void app_settings_get_ip(struct app_ip_settings *out);
/** Replace the IP snapshot; optional NVS write may block. Return save errors
 * after RAM application, without rollback. No network I/O or publishing. */
int app_settings_update_ip(const struct app_ip_settings *ip, bool persist);
/** @brief Copy current MQTT broker settings. */
void app_settings_get_mqtt(struct app_mqtt_settings *out);
/** Replace MQTT settings and increment reconnect revision. Optional NVS write
 * may block; save errors leave RAM/reconnect intent applied. No publishing. */
int app_settings_update_mqtt(const struct app_mqtt_settings *mqtt, bool persist);
/** Copy acceptance policy under the settings mutex; no I/O. */
void app_settings_get_attenuator_fit(uint8_t channel, struct app_attenuator_fit_policy *out);
/** Copy operational open settings; neither function performs DAC I/O. */
void app_settings_get_attenuator_open(uint8_t channel, struct app_attenuator_open_settings *out);
/** Update the settings snapshot, optionally blocking on NVS persistence. */
int app_settings_update_attenuator_open(uint8_t channel, const struct app_attenuator_open_settings *open, bool persist);
/** Validate/update policy only; optional NVS write, never changes DAC outputs. */
int app_settings_update_attenuator_fit(uint8_t channel, const struct app_attenuator_fit_policy *policy, bool persist);

/** @brief Copy the current attenuator calibration snapshot. */
void app_settings_get_attenuator(struct app_attenuator_settings *out);
/**
 * @brief Update one logical attenuator channel's calibration coefficients.
 *
 * @param channel Zero-based logical attenuator channel index.
 * @param atten Channel coefficient settings copied into the runtime snapshot.
 * @param persist If true, save this channel's coefficients through Zephyr NVS.
 * May block on the mutex and flash I/O. Returns save errors after RAM update;
 * no DAC I/O, publishing or rollback.
 */
int app_settings_update_attenuator_channel(uint8_t channel,
					    const struct app_attenuator_channel_settings *atten,
					    bool persist);
/** @brief Boot relay intent: saved override, or last confirmed state in AUTO.
 * Missing last-state records mean off. Takes the settings mutex; no hardware I/O.
 */
bool app_settings_photodiode_power_at_boot(uint8_t channel);
/** @brief Save a successfully applied PD relay state, separately from calibration.
 * May block on NVS I/O when state changes; returns write errors. No publishing.
 */
int app_settings_record_photodiode_power(uint8_t channel, bool enabled);
/** @brief Copy current photodiode calibration and warning settings. */
void app_settings_get_photodiode(struct app_photodiode_settings *out);
/**
 * @brief Try to copy photodiode settings without sleeping.
 *
 * Timing-sensitive samplers use this to refresh cached calibration data without
 * waiting behind command-thread settings updates. A false return leaves the
 * caller's prior snapshot authoritative until a later refresh succeeds.
 */
bool app_settings_try_get_photodiode(struct app_photodiode_settings *out);
/**
 * @brief Update one photodiode channel's calibration/settings.
 *
 * @param channel Zero-based photodiode channel index.
 * @param pd Channel settings to copy into the runtime snapshot.
 * @param persist If true, save only this channel's NVS record.
 * May block on the mutex and flash I/O. Returns save errors after RAM update;
 * no relay/ADC I/O, publishing or rollback.
 */
int app_settings_update_photodiode_channel(uint8_t channel,
					    const struct app_pd_channel_settings *pd,
					    bool persist);
/** @brief Copy current laser-bank heater mode setting. */
void app_settings_get_laserbank(struct app_laserbank_settings *out);
/** Replace heater mode in RAM; optional NVS write may block. Returns save
 * errors without rollback; no relay I/O or publishing. */
int app_settings_update_laserbank(const struct app_laserbank_settings *laserbank,
				   bool persist);
/** @brief Copy one app-owned laser channel's settings. */
int app_settings_get_laser_channel(uint8_t channel,
				   struct app_laser_channel_settings *out);
/**
 * @brief Replace one laser channel's app-owned settings.
 *
 * Driver-backed values are only app intent here; lasers.c owns applying those
 * values to the Maiman module. Laser output current is intentionally absent.
 * May wait on the settings mutex and optional flash writes. Persistence errors
 * are returned after RAM application; writes to separate records are not atomic.
 */
int app_settings_update_laser_channel(uint8_t channel,
				      const struct app_laser_channel_settings *laser,
				      bool persist);
/** @brief Update the persisted/runtime total emitting counter for one laser. */
int app_settings_update_laser_total_emitting(uint8_t channel,
					     double total_emitting_s,
					     bool persist);
/**
 * @brief Get effective route transmission, including compiled TIB defaults.
 *
 * Explicit RAM/NVS records override defaults, including transmission 1.0.
 * Callers supply a named laser, "generic", or split-output key. Only an exact
 * source override applies; named lasers never inherit a stored generic override.
 * Shared *_laser forward names resolve 1430 to its physical loss record; get,
 * set and reset use the same identity without changing switch routes.
 * Unspecified paths return 1.0. May wait on the settings mutex; performs no
 * hardware or flash I/O. Throughput captures this value at start.
 */
int app_settings_get_route_loss(const char *route, const char *laser,
				double *transmission);
/**
 * @brief Store or update one route-loss record.
 *
 * The record is keyed by resolved route and laser names. It does not change MEMS
 * route structs or switch state. If @p persist is true, the indexed route-loss
 * record is saved via Zephyr NVS and may block on flash I/O. A flash error is
 * returned without undoing the RAM update.
 */
int app_settings_set_route_loss(const char *route, const char *laser,
				double transmission, bool persist);

/** Remove one exact route/source override, optionally deleting its NVS record.
 * Exposes compiled defaults; no switch I/O. May block on settings/flash. */
int app_settings_reset_route_loss(const char *route, const char *laser, bool persist);

/** @brief Copy MEMS user intent and optional restart metadata. */
void app_settings_get_mems(struct app_mems_settings *out);
/** @brief Replace MEMS intent, optionally saving once through NVS.
 * May block on flash I/O; returns save errors without undoing the RAM update.
 * No hardware actuation or publishing. Identical records do not program flash.
 */
int app_settings_update_mems(const struct app_mems_settings *mems, bool persist);
/** @brief Monotonic runtime counter used by main.c to reconnect MQTT. */
uint32_t app_settings_get_mqtt_revision(void);
/** @brief Get persisted boot count. */
uint32_t app_settings_get_boot_count(void);
/** @brief Increment and persist boot count. */
void app_settings_increment_boot_count(void);

#endif /* HISPEC_APP_SETTINGS_H */
