COO-Utilities/hispec-tib/app/src/laserbank_tempcontrol.h

/**
 * @file laserbank_tempcontrol.h
 * @brief TIB laser-bank temperature-control loop.
 */

#ifndef HISPEC_LASERBANK_TEMPCONTROL_H
#define HISPEC_LASERBANK_TEMPCONTROL_H

#include <stdbool.h>
#include <stdint.h>

struct k_work_q;

#define LASERBANK_TEMPCONTROL_POLL_INTERVAL_MS 10000U
#define LASERBANK_TEMPCONTROL_TEMP_STALE_MS (2U * LASERBANK_TEMPCONTROL_POLL_INTERVAL_MS)
#define LASERBANK_TEMPCONTROL_OVERRIDE_WARNING_MS (20U * 60U * 1000U)

enum laserbank_heater_mode {
	LASERBANK_HEATER_MODE_AUTO = 0,
	LASERBANK_HEATER_MODE_OVERRIDE_ON,
	LASERBANK_HEATER_MODE_OVERRIDE_OFF,
};

struct laserbank_tempcontrol_status {
	bool available;
	enum laserbank_heater_mode heater_mode;
	bool bank_powered;
	bool heater_on;
	double ambient_c;
	/* Idle TEC readings approximate bank temperature; active TECs are excluded. */
	uint8_t idle_tec_temp_count;
	double idle_tec_temp_avg_c;
	bool waiting_for_temps;
	bool any_disabled_below_15c;
	bool any_disabled_above_off_threshold;
	bool all_tecs_enabled;
	uint32_t all_tecs_enabled_ms;
	int last_error;
	uint32_t last_poll_age_ms;
};

/**
 * Start the TIB heater-policy delayable work.
 *
 * The work is submitted to @p work_q and may block on Modbus and relay GPIO
 * I/O. Heater-mode commands reschedule the same work for immediate policy
 * application.
 */
void laserbank_tempcontrol_start(struct k_work_q *work_q);

/** Copy the latest temperature-control loop state. */
void laserbank_tempcontrol_get_status(struct laserbank_tempcontrol_status *out);

/** Set heater mode. Auto runs the warmup policy; override modes force the relay. */
int laserbank_tempcontrol_set_heater_mode(enum laserbank_heater_mode mode,
					  bool persist);

const char *laserbank_heater_mode_name(enum laserbank_heater_mode mode);

#endif /* HISPEC_LASERBANK_TEMPCONTROL_H */
