COO-Utilities/hispec-tib/app/src/photodiode.c

/**
 * @file photodiode.c
 * @brief ADS1115 photodiode sampler, rolling status windows, and dark calibration.
 */


#include <zephyr/kernel.h>             // k_sleep, thread declarations, etc.
#include <zephyr/device.h>             // DEVICE_DT_GET, device_is_ready
#include <zephyr/devicetree.h>         // DT_NODELABEL, DT_CHILD
#include <zephyr/drivers/adc.h>        // ADC API
#include <zephyr/logging/log.h>        // LOG_ERR, LOG_WRN, etc.
#include <zephyr/sys/util.h>
#include <errno.h>
#include <stdint.h>                    // int16_t, int64_t, etc.
#include <string.h>
#include <math.h>
#include <time.h>
#include <zephyr/sys/clock.h>

#include "photodiode.h"
#include "app_settings.h"
#include "app_output.h"
#include "devices.h"
#include "housekeeping.h"
#include "lasers.h"


LOG_MODULE_REGISTER(photodiode, LOG_LEVEL_INF);

// More ADC info:
// https://github.com/zephyrproject-rtos/zephyr/blob/main/samples/drivers/adc/adc_dt/src/main.c
// https://docs.zephyrproject.org/apidoc/latest/group__adc__interface.html
// https://github.com/zephyrproject-rtos/zephyr/blob/main/drivers/adc/adc_ads1x1x.c#L617

static const struct adc_channel_cfg yj_cfg_dt =
    ADC_CHANNEL_CFG_DT(DT_CHILD(DT_NODELABEL(adc1115), channel_0));

static const struct adc_channel_cfg hk_cfg_dt =
    ADC_CHANNEL_CFG_DT(DT_CHILD(DT_NODELABEL(adc1115), channel_2));

static const struct adc_channel_cfg *const pd_adc_cfg[PHOTODIODE_CHANNEL_COUNT] = {
    &yj_cfg_dt,
    &hk_cfg_dt,
};

#define PD_YJ_ADC_CHANNEL_NODE DT_CHILD(DT_NODELABEL(adc1115), channel_0)
#define PD_HK_ADC_CHANNEL_NODE DT_CHILD(DT_NODELABEL(adc1115), channel_2)
#define ADS1115_DT_RESOLUTION DT_PROP(PD_YJ_ADC_CHANNEL_NODE, zephyr_resolution)
#define ADS1115_DT_ACQ_TIME DT_PROP(PD_YJ_ADC_CHANNEL_NODE, zephyr_acquisition_time)
#define ADS1115_DT_GAIN DT_STRING_TOKEN(PD_YJ_ADC_CHANNEL_NODE, zephyr_gain)
#define ADS1115_I2C_HZ DT_PROP(DT_PARENT(DT_NODELABEL(adc1115)), clock_frequency)

BUILD_ASSERT(DT_PROP(PD_HK_ADC_CHANNEL_NODE, zephyr_resolution) == ADS1115_DT_RESOLUTION,
             "photodiode ADS1115 channels must use the same resolution");
BUILD_ASSERT(DT_PROP(PD_HK_ADC_CHANNEL_NODE, zephyr_acquisition_time) == ADS1115_DT_ACQ_TIME,
             "photodiode ADS1115 channels must use the same data rate");
BUILD_ASSERT(DT_STRING_TOKEN(PD_HK_ADC_CHANNEL_NODE, zephyr_gain) == ADS1115_DT_GAIN,
             "photodiode ADS1115 channels must use the same gain");
BUILD_ASSERT(ADS1115_DT_GAIN == ADC_GAIN_1,
             "photodiode scaling requires the ADS1115 +/-2.048 V range");

/* Zephyr's ADS1115 driver exposes the muxed device as ADC channel 0 only.
 * The physical ADS input is selected by input_positive from devicetree.
 * For single-ended ADS1115 reads, Zephyr expects the usable positive code
 * range: one bit less than the signed conversion register width.
 */
#define ADS1115_ZEPHYR_CHANNEL_ID 0U
#define ADS1115_SINGLE_ENDED_SEQUENCE_RESOLUTION (ADS1115_DT_RESOLUTION - 1U)

const char *const photodiode_channel_names[PHOTODIODE_CHANNEL_COUNT] = {
    "yj",
    "hk",
};

static K_TIMER_DEFINE(pd_sample_timer, NULL, NULL);
/* Latest-state handoff: a delayed reader sees the newest acquisition, not a queue. */
static K_SEM_DEFINE(pd_sample_ready, 0, 1);

int photodiode_wait_for_sample(k_timeout_t timeout)
{
    return k_sem_take(&pd_sample_ready, timeout);
}

/* ADC_GAIN_1 gives the ADS1115 a +/-2.048 V bipolar range. Single-ended
 * measurements use its positive 15-bit half, or exactly 62.5 uV per count.
 */
#define PD_HARDWARE_LOG_RATELIMIT_MS 10000U
#define PD_TIMING_STATS_INTERVAL_MS 10000U
#define PD_ADS1115_WAKE_US 25U
/* Rough ADS1115 sample-time floor for timing diagnostics, ignoring scheduler
 * overhead inside Zephyr's ADC driver path.
 */
#define PD_ADC_I2C_WIRE_BITS_PER_SAMPLE 126U
#define PD_NOISE_WARNING_COOLDOWN_MS 60000U
#define PD_NOISE_QUIET_MS 5000U
#define PD_WINDOW_DEFAULT_DURATION_MS PHOTODIODE_FIXED_WINDOW_MS
#define PD_DARK_SETTLE_MS 10000
#define PD_WINDOW_MAX_DURATION_MS APP_PD_DARK_DURATION_MAX_MS
#define PD_WINDOW_MAX_SAMPLES (PD_WINDOW_MAX_DURATION_MS / PHOTODIODE_SAMPLE_INTERVAL_MS)
#define PD_STEP_MIN_UV 5000U
#define PD_STEP_MIN_MV ((double)PD_STEP_MIN_UV / 1000.0)
#define PD_STEP_RMS_MULT 8.0
#define PLANCK_J_S 6.62607015e-34
#define LIGHT_M_PER_S 299792458.0

BUILD_ASSERT(PD_WINDOW_MAX_SAMPLES > 0U &&
	     PD_WINDOW_MAX_SAMPLES <= UINT16_MAX,
	     "photodiode windows must fit in uint16_t sample counters");
struct photodiode_wavelength_coefficient {
    double wavelength_nm;
    double coefficient;
};

static const struct photodiode_wavelength_coefficient wavelength_coefficients[] = {
    { 1028.01, 1.0 },
    { 1270.0, 1.0 },
    { 1430.0, 1.0 },
    { 1510.0, 1.0 },
    { 2329.81, 1.0 },
};


struct pd_window_runtime {
	uint16_t target_samples;
	uint16_t index;
	uint16_t filled;
	/* ADC counts are exact in float; round only after double dark subtraction.
	 * Window arithmetic uses the FPU, then promotes into public double results.
	 */
	float mv[PD_WINDOW_MAX_SAMPLES];
	float net_mv[PD_WINDOW_MAX_SAMPLES];
	int16_t raw[PD_WINDOW_MAX_SAMPLES];
	bool good[PD_WINDOW_MAX_SAMPLES];
	struct photodiode_window_result current;
	struct photodiode_window_result last;
};

struct photodiode_dark_action {
	bool pending;
	bool collecting;
	int64_t settle_after_ms;
	bool persist;
	bool reset_lowest;
	uint16_t target_sample_length;
	uint32_t duration_ms;
};

struct photodiode_runtime_channel {
	int16_t raw;
	double mv;
	double net_mv;
	double net_err_mv;
	double power_uw;
	double power_err_uw;
	int64_t next_adc_warning_ms;
	int64_t next_noise_warning_ms;
	uint32_t noise_generation;
	uint16_t noise_fresh_samples;
	struct pd_window_runtime configurable_window;
	struct pd_window_runtime fixed_window;
	int64_t configurable_start_ms; /* Exclude a conversion begun before window reset. */
	int64_t sample_ms;
	uint64_t t_ms;
	struct photodiode_dark_action dark_action;
};

static struct photodiode_runtime_channel pd_runtime[PHOTODIODE_CHANNEL_COUNT];
static K_MUTEX_DEFINE(pd_runtime_lock);

/* Hardware owners only report activity. Gate critical sections never acquire
 * owner locks or do I/O. The sampler alone owns the per-channel fresh counts. */
static struct k_spinlock pd_noise_lock;
static uint32_t pd_noise_active_changes;
static uint32_t pd_noise_generation;
static int64_t pd_noise_quiet_until_ms;

void photodiode_noise_change_begin(void)
{
	k_spinlock_key_t key = k_spin_lock(&pd_noise_lock);
	pd_noise_active_changes++;
	pd_noise_generation++;
	k_spin_unlock(&pd_noise_lock, key);
}

void photodiode_noise_change_end(void)
{
	k_spinlock_key_t key = k_spin_lock(&pd_noise_lock);
	__ASSERT_NO_MSG(pd_noise_active_changes > 0U);
	pd_noise_active_changes--;
	pd_noise_generation++;
	pd_noise_quiet_until_ms = k_uptime_get() + PD_NOISE_QUIET_MS;
	k_spin_unlock(&pd_noise_lock, key);
}

struct photodiode_loop_timing {
    uint64_t worst_loop_us;
    uint64_t worst_non_adc_us;
    uint64_t worst_adc_us[PHOTODIODE_CHANNEL_COUNT];
    uint64_t worst_adc_over_us[PHOTODIODE_CHANNEL_COUNT];
    int64_t min_margin_us;
};

struct photodiode_timing_stats {
    uint32_t samples;
    uint32_t missed_intervals;
    uint32_t overruns;
    uint32_t settings_busy;
    uint32_t adc_errors[PHOTODIODE_CHANNEL_COUNT];
    struct photodiode_loop_timing worst;
};

static struct photodiode_timing_stats pd_timing_stats;
static int64_t pd_timing_next_log_ms;

extern bool app_timing_summary_logs_enabled(void);

static uint64_t pd_i2c_wire_us_for_bits(uint32_t bits)
{
    return ((uint64_t)bits * 1000000ULL + ADS1115_I2C_HZ - 1ULL) /
           ADS1115_I2C_HZ;
}

static uint32_t pd_ads1115_conversion_us(void)
{
    switch (ADC_ACQ_TIME_VALUE(ADS1115_DT_ACQ_TIME)) {
    case 0:
        return 125000U + PD_ADS1115_WAKE_US;
    case 1:
        return 62500U + PD_ADS1115_WAKE_US;
    case 2:
        return 31250U + PD_ADS1115_WAKE_US;
    case 3:
        return 15625U + PD_ADS1115_WAKE_US;
    case 4:
        return 7813U + PD_ADS1115_WAKE_US;
    case 5:
        return 4000U + PD_ADS1115_WAKE_US;
    case 6:
        return 2105U + PD_ADS1115_WAKE_US;
    case 7:
        return 1163U + PD_ADS1115_WAKE_US;
    default:
        return 0U;
    }
}



static uint64_t pd_ads1115_i2c_wire_us_per_sample(void)
{
    return pd_i2c_wire_us_for_bits(PD_ADC_I2C_WIRE_BITS_PER_SAMPLE);
}

static uint64_t pd_ads1115_adc_floor_us(void)
{
    return pd_ads1115_conversion_us() + pd_ads1115_i2c_wire_us_per_sample();
}

static uint64_t pd_adc_over_us(uint64_t adc_elapsed_us)
{
    const uint64_t floor_us = pd_ads1115_adc_floor_us();

    return adc_elapsed_us > floor_us ? adc_elapsed_us - floor_us : 0U;
}

static void pd_timing_note_adc(enum photodiode_channel channel, int rc)
{
    if (channel < 0 || channel >= PHOTODIODE_CHANNEL_COUNT) {
        return;
    }

    if (rc != 0) {
        pd_timing_stats.adc_errors[channel]++;
    }
}

static void pd_timing_note_settings(bool refreshed)
{
    if (!refreshed) {
        pd_timing_stats.settings_busy++;
    }
}

static void pd_timing_note_loop(struct photodiode_loop_timing *loop,
                                uint64_t elapsed_us,
                                uint64_t adc_total_us)
{
    if (loop == NULL) {
        return;
    }

    loop->worst_loop_us = elapsed_us;
    loop->min_margin_us = ((int64_t)PHOTODIODE_SAMPLE_INTERVAL_MS * 1000LL) -
                          (int64_t)elapsed_us;
    /* Earlier phase probes showed settings refresh, rolling-stat updates, and
     * shared-state updates are normally sub-100 us. Keep the durable metric as
     * "not inside ADC calls"; use Zephyr runtime/tracing tools to identify
     * what preempted or blocked the thread during any large value.
     */
    loop->worst_non_adc_us =
        elapsed_us > adc_total_us ? elapsed_us - adc_total_us : 0U;

    if (loop->min_margin_us < 0) {
        pd_timing_stats.overruns++;
    }
    if (pd_timing_stats.samples == 0U ||
        loop->worst_loop_us > pd_timing_stats.worst.worst_loop_us) {
        pd_timing_stats.worst = *loop;
    }
    pd_timing_stats.samples++;
}

static bool pd_timing_has_anomaly(void)
{
    return pd_timing_stats.missed_intervals > 0U ||
           pd_timing_stats.overruns > 0U ||
           pd_timing_stats.adc_errors[0] > 0U ||
           pd_timing_stats.adc_errors[1] > 0U;
}

static void pd_timing_log_snapshot(bool anomaly)
{
    if (anomaly) {
        LOG_WRN("ADC timing: samples=%u missed=%u overruns=%u settings_busy=%u "
                "worst_loop_us=%llu min_margin_us=%lld worst_non_adc_us=%llu "
                "adc_floor_us=%llu adc_us=%llu/%llu adc_over_us=%llu/%llu "
                "errors=%u/%u",
                (unsigned int)pd_timing_stats.samples,
                (unsigned int)pd_timing_stats.missed_intervals,
                (unsigned int)pd_timing_stats.overruns,
                (unsigned int)pd_timing_stats.settings_busy,
                (unsigned long long)pd_timing_stats.worst.worst_loop_us,
                (long long)pd_timing_stats.worst.min_margin_us,
                (unsigned long long)pd_timing_stats.worst.worst_non_adc_us,
                (unsigned long long)pd_ads1115_adc_floor_us(),
                (unsigned long long)pd_timing_stats.worst.worst_adc_us[0],
                (unsigned long long)pd_timing_stats.worst.worst_adc_us[1],
                (unsigned long long)pd_timing_stats.worst.worst_adc_over_us[0],
                (unsigned long long)pd_timing_stats.worst.worst_adc_over_us[1],
                (unsigned int)pd_timing_stats.adc_errors[0],
                (unsigned int)pd_timing_stats.adc_errors[1]);
        return;
    }

    LOG_INF("ADC timing: samples=%u missed=%u overruns=%u settings_busy=%u "
            "worst_loop_us=%llu min_margin_us=%lld worst_non_adc_us=%llu "
            "adc_floor_us=%llu adc_us=%llu/%llu adc_over_us=%llu/%llu "
            "errors=%u/%u",
            (unsigned int)pd_timing_stats.samples,
            (unsigned int)pd_timing_stats.missed_intervals,
            (unsigned int)pd_timing_stats.overruns,
            (unsigned int)pd_timing_stats.settings_busy,
            (unsigned long long)pd_timing_stats.worst.worst_loop_us,
            (long long)pd_timing_stats.worst.min_margin_us,
            (unsigned long long)pd_timing_stats.worst.worst_non_adc_us,
            (unsigned long long)pd_ads1115_adc_floor_us(),
            (unsigned long long)pd_timing_stats.worst.worst_adc_us[0],
            (unsigned long long)pd_timing_stats.worst.worst_adc_us[1],
            (unsigned long long)pd_timing_stats.worst.worst_adc_over_us[0],
            (unsigned long long)pd_timing_stats.worst.worst_adc_over_us[1],
            (unsigned int)pd_timing_stats.adc_errors[0],
            (unsigned int)pd_timing_stats.adc_errors[1]);
}

static void pd_timing_maybe_log(int64_t now_ms)
{
    bool anomaly;

    if (pd_timing_next_log_ms == 0) {
        pd_timing_next_log_ms = now_ms + PD_TIMING_STATS_INTERVAL_MS;
        return;
    }
    if (now_ms < pd_timing_next_log_ms) {
        return;
    }

    anomaly = pd_timing_has_anomaly();
    if (anomaly || app_timing_summary_logs_enabled()) {
        pd_timing_log_snapshot(anomaly);
    }

    memset(&pd_timing_stats, 0, sizeof(pd_timing_stats));
    pd_timing_next_log_ms = now_ms + PD_TIMING_STATS_INTERVAL_MS;
}

/* Read one ADS1115 physical mux input through Zephyr's ADC driver. This can
 * sleep/block in the driver for I2C and conversion time; it does not publish,
 * enqueue, or update shared photodiode status.
 */
static int pd_read_raw(enum photodiode_channel channel, int16_t *raw)
{
    struct adc_channel_cfg cfg;
    struct adc_sequence seq = {
        .channels = BIT(ADS1115_ZEPHYR_CHANNEL_ID),
        .buffer = raw,
        .buffer_size = sizeof(*raw),
        .resolution = ADS1115_SINGLE_ENDED_SEQUENCE_RESOLUTION,
        .oversampling = 0,
        .calibrate = false,
    };
    int rc;

    if (raw == NULL || channel < 0 || channel >= PHOTODIODE_CHANNEL_COUNT) {
        return -EINVAL;
    }
    if (adc_dev == NULL || !device_is_ready(adc_dev)) {
        return -ENODEV;
    }

    cfg = *pd_adc_cfg[channel];
    cfg.channel_id = ADS1115_ZEPHYR_CHANNEL_ID;
    rc = adc_channel_setup(adc_dev, &cfg);
    if (rc == 0) {
        rc = adc_read(adc_dev, &seq);
    }
    return rc;
}

double photodiode_power_uw_from_mv(double net_mv,
                                   const struct app_pd_channel_settings *settings)
{
    /* Settings owns validated gain/response. The comparison preserves NaN;
     * fmax(0, NaN) would instead hide a missing reading as measured zero.
     */
    double signal_mv = net_mv < 0.0 ? 0.0 : net_mv;
    return signal_mv * 1.0e3 /
        (settings->transimpedance_v_per_a * settings->responsivity_a_per_w);
}

double photodiode_wavelength_coefficient(double wavelength_nm)
{
    double best_delta;
    double best_coeff;

    best_delta = fabs(wavelength_nm - wavelength_coefficients[0].wavelength_nm);
    best_coeff = wavelength_coefficients[0].coefficient;
    for (size_t i = 1U; i < ARRAY_SIZE(wavelength_coefficients); ++i) {
        double delta = fabs(wavelength_nm - wavelength_coefficients[i].wavelength_nm);

        if (delta < best_delta) {
            best_delta = delta;
            best_coeff = wavelength_coefficients[i].coefficient;
        }
    }

    return best_coeff;
}

double photodiode_power_uw_from_mv_at_wavelength(
    double net_mv,
    double wavelength_nm,
    const struct app_pd_channel_settings *settings)
{
    double coefficient = photodiode_wavelength_coefficient(wavelength_nm);

    return photodiode_power_uw_from_mv(net_mv, settings) * coefficient;
}

double photodiode_photon_flux_from_mv(double net_mv,
                                      double wavelength_nm,
                                      const struct app_pd_channel_settings *settings)
{
    double power_w = photodiode_power_uw_from_mv_at_wavelength(
        net_mv, wavelength_nm, settings) * 1.0e-6;
    return power_w * (wavelength_nm * 1.0e-9) / (PLANCK_J_S * LIGHT_M_PER_S);
}

static bool pd_dark_result_valid(const struct app_pd_dark_result *dark)
{
	if (dark == NULL) {
		return false;
	}

	return dark->duration_ms <= APP_PD_DARK_DURATION_MAX_MS &&
	       isfinite((double)dark->mean_mv) &&
	       dark->mean_mv >= PHOTODIODE_DARK_MIN_MV &&
	       dark->mean_mv <= PHOTODIODE_DARK_MAX_MV &&
	       isfinite((double)dark->rms_mv) &&
	       dark->rms_mv >= PHOTODIODE_NOISE_RMS_MIN_MV &&
	       dark->rms_mv <= PHOTODIODE_NOISE_RMS_MAX_MV &&
	       isfinite((double)dark->min_mv) &&
	       dark->min_mv >= PHOTODIODE_DARK_MIN_MV &&
	       dark->min_mv <= PHOTODIODE_DARK_MAX_MV &&
	       isfinite((double)dark->max_mv) &&
	       dark->max_mv >= PHOTODIODE_DARK_MIN_MV &&
	       dark->max_mv <= PHOTODIODE_DARK_MAX_MV &&
	       dark->min_mv <= dark->max_mv;
}

bool photodiode_settings_valid(const struct app_pd_channel_settings *settings)
{
    if (settings == NULL) {
        return false;
    }

    return pd_dark_result_valid(&settings->dark) &&
           (!settings->lowest_dark_valid ||
	    pd_dark_result_valid(&settings->lowest_dark)) &&
           isfinite((double)settings->noise_warn_rms_mv) &&
           settings->noise_warn_rms_mv >= PHOTODIODE_NOISE_RMS_MIN_MV &&
           settings->noise_warn_rms_mv <= PHOTODIODE_NOISE_RMS_MAX_MV &&
           isfinite(settings->responsivity_a_per_w) &&
           settings->responsivity_a_per_w >= PHOTODIODE_RESPONSIVITY_MIN_A_PER_W &&
           settings->responsivity_a_per_w <= PHOTODIODE_RESPONSIVITY_MAX_A_PER_W &&
           isfinite(settings->transimpedance_v_per_a) &&
           settings->transimpedance_v_per_a >= PHOTODIODE_TRANSIMPEDANCE_MIN_V_PER_A &&
           settings->transimpedance_v_per_a <= PHOTODIODE_TRANSIMPEDANCE_MAX_V_PER_A &&
           settings->power >= APP_PD_POWER_AUTO &&
           settings->power <= APP_PD_POWER_OVERRIDE_OFF;
}

static uint16_t pd_window_duration_to_samples(uint32_t duration_ms)
{
	uint32_t requested_ms = duration_ms == 0U ? PHOTODIODE_SAMPLE_INTERVAL_MS : duration_ms;
	uint32_t samples;

	if (requested_ms >= PD_WINDOW_MAX_DURATION_MS) {
		return (uint16_t)PD_WINDOW_MAX_SAMPLES;
	}

	requested_ms += PHOTODIODE_SAMPLE_INTERVAL_MS / 2U;
	samples = requested_ms / PHOTODIODE_SAMPLE_INTERVAL_MS;
	return (uint16_t)CLAMP(samples, 1U, PD_WINDOW_MAX_SAMPLES);
}

static uint32_t pd_window_samples_to_duration_ms(uint16_t samples)
{
	return (uint32_t)samples * PHOTODIODE_SAMPLE_INTERVAL_MS;
}

static void pd_window_result_clear(struct photodiode_window_result *result)
{
	if (result == NULL) {
		return;
	}

	memset(result, 0, sizeof(*result));
	result->mean_mv = NAN;
	result->mean_net_mv = NAN;
	result->rms_mv = NAN;
	result->mean_net_err_mv = NAN;
	result->min_mv = NAN;
	result->max_mv = NAN;
	result->power_uw = NAN;
	result->power_err_uw = NAN;
}

static void pd_window_reset_current(struct pd_window_runtime *window)
{
	if (window == NULL) {
		return;
	}

	window->index = 0U;
	window->filled = 0U;
	memset(window->good, 0, sizeof(window->good));
	pd_window_result_clear(&window->current);
}

static void pd_window_set_target(struct pd_window_runtime *window,
				 uint16_t target_samples)
{
	if (window == NULL) {
		return;
	}

	window->target_samples = CLAMP(target_samples, 1U,
				       (uint16_t)PD_WINDOW_MAX_SAMPLES);
	pd_window_reset_current(window);
	pd_window_result_clear(&window->last);
}

static void pd_windows_ensure_locked(struct photodiode_runtime_channel *channel)
{
	if (channel == NULL) {
		return;
	}
	if (channel->fixed_window.target_samples == 0U) {
		pd_window_set_target(&channel->fixed_window,
				     pd_window_duration_to_samples(PHOTODIODE_FIXED_WINDOW_MS));
	}
	if (channel->configurable_window.target_samples == 0U) {
		pd_window_set_target(&channel->configurable_window,
				     pd_window_duration_to_samples(PD_WINDOW_DEFAULT_DURATION_MS));
	}
}

static void pd_window_snapshot_last(struct pd_window_runtime *window)
{
	if (window == NULL || window->target_samples == 0U) {
		return;
	}

	window->last = window->current;
}

/* Measured dark RMS is the empirical single-reading noise baseline (already
 * including ADC noise). Quantization RMS is a floor, not an added duplicate.
 * Forced-dark rms_mv instead describes uncertainty in the supplied offset.
 */
static double pd_read_noise_mv(const struct app_pd_dark_result *dark)
{
    /* Uniform rounding error over [-LSB/2, +LSB/2] has variance LSB^2/12,
     * hence RMS LSB/sqrt(12): 0.01804 mV for our 0.0625 mV code spacing.
     * This is a quantization floor, not a measurement of total ADC noise.
     */
    double quantization = PHOTODIODE_ADC_LSB_MV / sqrt(12.0);

    return dark->duration_ms > 0U ?
        MAX(quantization, dark->rms_mv) : quantization;
}

/* A measured dark mean has a smaller uncertainty than its individual readings.
 * This assumes disjoint dark samples; recapture dark after changing ADC cadence
 * or data rate. The saved duration/failures describe samples at that cadence.
 */
static double pd_dark_mean_error_mv(const struct app_pd_dark_result *dark)
{
    if (dark->duration_ms == 0U) {
        return dark->rms_mv;
    }
    int samples = (dark->duration_ms + PHOTODIODE_SAMPLE_INTERVAL_MS / 2U) /
                  PHOTODIODE_SAMPLE_INTERVAL_MS;
    samples -= dark->failed_samples;
    return samples > 0 ? pd_read_noise_mv(dark) / sqrt((double)samples) : (double)NAN;
}

static void pd_window_recompute(struct pd_window_runtime *window,
				const struct app_pd_channel_settings *settings,
				int64_t now_ms)
{
	struct photodiode_window_result next;
	float sum_mv = 0.0f;
	float sum_net_mv = 0.0f;
	float mean;
	float m2 = 0.0f;
	float min_mv = NAN, max_mv = NAN;
	uint16_t good_count = 0U;
	uint16_t failed = 0U;

	if (window == NULL) {
		return;
	}

	pd_window_result_clear(&next);
	next.sample_length = window->filled;
	next.end_ms = now_ms;
	next.max_raw = INT16_MIN;

	for (uint16_t i = 0U; i < window->filled; ++i) {
		if (!window->good[i]) {
			failed++;
			continue;
		}
		if (good_count == 0U) {
			min_mv = window->mv[i];
			max_mv = window->mv[i];
			next.max_raw = window->raw[i];
		} else {
			min_mv = MIN(min_mv, window->mv[i]);
			max_mv = MAX(max_mv, window->mv[i]);
			next.max_raw = MAX(next.max_raw, window->raw[i]);
		}
		sum_mv += window->mv[i];
		sum_net_mv += window->net_mv[i];
		good_count++;
	}

	next.failed_samples = failed;
	if (good_count == 0U) {
		next.max_raw = 0;
		window->current = next;
		return;
	}

	mean = sum_mv / (float)good_count;
	for (uint16_t i = 0U; i < window->filled; ++i) {
		float delta;

		if (!window->good[i]) {
			continue;
		}
		delta = window->mv[i] - mean;
		m2 += delta * delta;
	}

	next.valid = true;
	next.min_mv = min_mv;
	next.max_mv = max_mv;
	next.mean_mv = mean;
	next.mean_net_mv = sum_net_mv / (float)good_count;
	float rms_mv = sqrtf(m2 / (float)good_count);
	next.rms_mv = rms_mv;
	next.mean_net_err_mv = rms_mv / sqrtf((float)good_count);
	if (settings != NULL) {
		next.mean_net_err_mv = hypot(
			MAX(next.rms_mv, pd_read_noise_mv(&settings->dark)) / sqrt((double)good_count),
			pd_dark_mean_error_mv(&settings->dark));
	}
	if (settings != NULL) {
		next.power_uw = photodiode_power_uw_from_mv(next.mean_net_mv, settings);
		next.power_err_uw = photodiode_power_uw_from_mv(next.mean_net_err_mv,
								settings);
	}
	window->current = next;
}

static void pd_window_add_sample(struct pd_window_runtime *window,
				 int rc, int16_t raw, double mv, double net_mv,
				 const struct app_pd_channel_settings *settings,
				 int64_t now_ms)
{
	uint16_t slot;

	if (window == NULL || window->target_samples == 0U) {
		return;
	}

	slot = window->index;
	window->good[slot] = rc == 0;
	window->raw[slot] = raw;
	window->mv[slot] = rc == 0 ? (float)mv : NAN;
	window->net_mv[slot] = rc == 0 ? (float)net_mv : NAN;
	window->index = (uint16_t)((slot + 1U) % window->target_samples);
	if (window->filled < window->target_samples) {
		window->filled++;
	}
	pd_window_recompute(window, settings, now_ms);
}



static bool pd_sample_is_step(const struct photodiode_runtime_channel *channel,
			      double mv)
{
	double threshold = PD_STEP_MIN_MV;

	if (channel == NULL || channel->sample_ms <= 0) {
		return false;
	}
	if (channel->fixed_window.current.valid &&
	    channel->fixed_window.current.rms_mv > 0.0) {
		threshold = MAX(threshold,
				PD_STEP_RMS_MULT * channel->fixed_window.current.rms_mv);
	}

	return fabs(mv - channel->mv) > threshold;
}

static struct photodiode_window_result
pd_dark_window_from_settings(const struct app_pd_dark_result *dark,
			     bool valid,
			     const struct app_pd_channel_settings *settings)
{
	struct photodiode_window_result result;

	pd_window_result_clear(&result);
	if (!valid || dark == NULL || settings == NULL ||
	    !pd_dark_result_valid(dark)) {
		return result;
	}

	result.valid = true;
	result.sample_length = dark->duration_ms == 0U ?
			       0U :
			       pd_window_duration_to_samples(dark->duration_ms);
	result.failed_samples = dark->failed_samples;
	result.end_ms = 0;
	result.mean_mv = dark->mean_mv;
	result.mean_net_mv = 0.0;
	result.rms_mv = dark->rms_mv;
	result.mean_net_err_mv = pd_dark_mean_error_mv(dark);
	result.min_mv = dark->min_mv;
	result.max_mv = dark->max_mv;
	result.power_uw = 0.0;
	result.power_err_uw = photodiode_power_uw_from_mv(result.mean_net_err_mv, settings);
	result.max_raw = dark->max_raw;
	return result;
}

static struct app_pd_dark_result
pd_dark_result_from_window(const struct photodiode_window_result *window)
{
	struct app_pd_dark_result dark = {0};

	if (window == NULL) {
		return dark;
	}

	dark.duration_ms = pd_window_samples_to_duration_ms(window->sample_length);
	dark.failed_samples = window->failed_samples;
	dark.mean_mv = window->mean_mv;
	dark.rms_mv = window->rms_mv;
	dark.min_mv = window->min_mv;
	dark.max_mv = window->max_mv;
	dark.max_raw = window->max_raw;
	return dark;
}

static void pd_update_lowest_dark(struct app_pd_channel_settings *ch,
				  bool reset_lowest)
{
	/* duration_ms == 0 is the existing persisted forced/default provenance. */
	if (ch == NULL || ch->dark.duration_ms == 0U) {
		return;
	}

	if (reset_lowest || !ch->lowest_dark_valid ||
	    ch->dark.mean_mv < ch->lowest_dark.mean_mv) {
		ch->lowest_dark = ch->dark;
		ch->lowest_dark_valid = true;
	}
}

static void pd_commit_dark_result(enum photodiode_channel channel,
				  const struct app_pd_dark_result *dark,
				  bool persist,
				  bool reset_lowest,
				  bool forced)
{
	struct app_photodiode_settings settings;

	if (dark == NULL || channel < 0 || channel >= PHOTODIODE_CHANNEL_COUNT) {
		return;
	}

	app_settings_get_photodiode(&settings);
	settings.channel[channel].dark = *dark;
	if (!forced)
		pd_update_lowest_dark(&settings.channel[channel], reset_lowest);
	app_settings_update_photodiode_channel((uint8_t)channel,
					       &settings.channel[channel],
					       persist);
}

static bool pd_stage_completed_dark_locked(
	struct photodiode_runtime_channel *runtime,
	struct app_pd_dark_result *dark,
	bool *persist,
	bool *reset_lowest,
	bool *failed)
{
	const struct photodiode_window_result *window;

	if (runtime == NULL || dark == NULL || persist == NULL ||
	    reset_lowest == NULL || failed == NULL ||
	    !runtime->dark_action.pending) {
		return false;
	}

	window = &runtime->configurable_window.current;
	if (window->sample_length < runtime->dark_action.target_sample_length) {
		return false;
	}

	*persist = runtime->dark_action.persist;
	*reset_lowest = runtime->dark_action.reset_lowest;
	*failed = !window->valid || window->sample_length == 0U ||
		  window->sample_length == window->failed_samples ||
		  window->max_mv >= PHOTODIODE_ADC_USABLE_MV;
	runtime->dark_action.pending = false;

	if (*failed) {
		return false;
	}

	*dark = pd_dark_result_from_window(window);
	return true;
}

static void pd_emit_adc_error_warning(enum photodiode_channel channel, int rc)
{
    char context[64];

    if (channel < 0 || channel >= PHOTODIODE_CHANNEL_COUNT || rc == 0) {
        return;
    }

    snprintk(context, sizeof(context), "channel=%s rc=%d",
             photodiode_channel_names[channel], rc);
    app_output_emit(&(const struct coo_cmd_runtime_emit_args){
        .type = COO_CMD_RUNTIME_EMIT_WARNING,
        .delivery = COO_CMD_RUNTIME_EMIT_BEST_EFFORT,
        .code = "photodiode_adc_error",
        .msg = "photodiode ADC sample discarded",
        .context = context,
    });
}

static void pd_emit_dark_failed_warning(enum photodiode_channel channel)
{
	char context[64];

	if (channel < 0 || channel >= PHOTODIODE_CHANNEL_COUNT) {
		return;
	}

	snprintk(context, sizeof(context), "channel=%s",
		 photodiode_channel_names[channel]);
	app_output_emit(&(const struct coo_cmd_runtime_emit_args){
		.type = COO_CMD_RUNTIME_EMIT_WARNING,
		.delivery = COO_CMD_RUNTIME_EMIT_BEST_EFFORT,
		.code = "photodiode_dark_failed",
		.msg = "photodiode dark capture clipped or had no valid samples",
		.context = context,
	});
}

/* Read only owner caches: never relay or Modbus I/O in the sampler. Tracking
 * transitions in their owners also catches on/off changes between ADC samples.
 */
static int64_t pd_dark_eligible_since(enum photodiode_channel channel)
{
	enum housekeeping_power_output output = channel == PHOTODIODE_CHANNEL_YJ ?
		HOUSEKEEPING_POWER_YJ_PHOTODIODE : HOUSEKEEPING_POWER_HK_PHOTODIODE;
	bool powered;
	if (housekeeping_power_get_confirmed(output, &powered) != 0 || !powered) return -EBUSY;
	int64_t since = k_uptime_get() - (int64_t)(1000.0 * housekeeping_power_on_time_s(output));
	const enum hispec_laser_id first = channel == PHOTODIODE_CHANNEL_YJ ?
		HISPEC_LASER_1028_Y : HISPEC_LASER_1430_HK;
	const enum hispec_laser_id last = channel == PHOTODIODE_CHANNEL_YJ ?
		HISPEC_LASER_1430_YJ : HISPEC_LASER_2330_K;
	for (enum hispec_laser_id id = first; id <= last; ++id) {
		int64_t off_since = hispec_laser_off_since_ms(id);
		if (off_since < 0) return off_since;
		since = MAX(since, off_since);
	}
	return since;
}

static void pd_update_channel(enum photodiode_channel channel, int rc, int16_t raw,
                              const struct app_pd_channel_settings *settings,
                              int64_t acquisition_ms, uint64_t utc_start_ms)
{
	struct photodiode_runtime_channel *runtime;
	struct app_pd_dark_result completed_dark = {0};
	double mv = NAN;
	double net_mv = NAN;
	double net_err_mv = NAN;
	double noise_rms = 0.0;
	bool emit_noise_warning = false;
	bool emit_adc_warning = false;
	bool commit_dark = false;
	bool dark_failed = false;
	bool dark_persist = false;
	bool dark_reset_lowest = false;
	int64_t now = k_uptime_get();
	int64_t eligible_since = pd_dark_eligible_since(channel);

	if (rc == 0) {
		mv = (double)raw * PHOTODIODE_ADC_LSB_MV;
		net_mv = mv - settings->dark.mean_mv;
		net_err_mv = hypot(pd_read_noise_mv(&settings->dark), pd_dark_mean_error_mv(&settings->dark));
		if (mv >= PHOTODIODE_ADC_USABLE_MV) {
			net_err_mv = NAN; /* Numerical reading retained as an overrange bound. */
		}
	}

	k_mutex_lock(&pd_runtime_lock, K_FOREVER);
	runtime = &pd_runtime[channel];
	pd_windows_ensure_locked(runtime);
	if (runtime->dark_action.pending) {
		if (eligible_since < 0) runtime->dark_action.settle_after_ms = now + PD_DARK_SETTLE_MS;
		bool settled = eligible_since >= 0 &&
			acquisition_ms >= MAX(eligible_since + PD_DARK_SETTLE_MS,
					      runtime->dark_action.settle_after_ms);
		if (!settled || !runtime->dark_action.collecting) {
			pd_window_reset_current(&runtime->configurable_window);
			runtime->configurable_start_ms = now;
		}
		runtime->dark_action.collecting = settled;
	}

	if (rc == 0 && pd_sample_is_step(runtime, mv)) {
		pd_window_snapshot_last(&runtime->configurable_window);
		pd_window_snapshot_last(&runtime->fixed_window);
	}

	if (rc == 0) {
		runtime->raw = raw;
		runtime->mv = mv;
		runtime->net_mv = net_mv;
		runtime->net_err_mv = net_err_mv;
		runtime->power_uw = photodiode_power_uw_from_mv(net_mv, settings);
		runtime->power_err_uw = photodiode_power_uw_from_mv(net_err_mv, settings);
		runtime->sample_ms = acquisition_ms;
		runtime->t_ms = utc_start_ms + (uint64_t)(now - acquisition_ms) / 2U;
	}

	/* Reset can occur while an ADC conversion is in flight. Count only reads
	 * begun afterward in the new calibration/dark window; fixed diagnostics
	 * still receive every conversion attempt.
	 */
	if (acquisition_ms > runtime->configurable_start_ms &&
	    (!runtime->dark_action.pending || runtime->dark_action.collecting)) {
		pd_window_add_sample(&runtime->configurable_window, rc, raw, mv, net_mv, settings, now);
	}
	pd_window_add_sample(&runtime->fixed_window, rc, raw, mv, net_mv, settings, now);
	commit_dark = pd_stage_completed_dark_locked(runtime, &completed_dark,
						     &dark_persist,
						     &dark_reset_lowest,
						     &dark_failed);

	/* Window accounting records every failure above; only the operator warning
	 * is throttled so a missing ADC cannot saturate the outbound queue.
	 */
	if (rc != 0 && now >= runtime->next_adc_warning_ms) {
		runtime->next_adc_warning_ms = now + PD_HARDWARE_LOG_RATELIMIT_MS;
		emit_adc_warning = true;
	}

	/* Gate warnings only: retain every attempt in the diagnostic window. The
	 * generation also invalidates old eligibility if sampling slept through an
	 * entire change/grace interval. Acquisition start excludes in-flight reads.
	 */
	k_spinlock_key_t noise_key = k_spin_lock(&pd_noise_lock);
	if (runtime->noise_generation != pd_noise_generation) {
		runtime->noise_generation = pd_noise_generation;
		runtime->noise_fresh_samples = 0U;
	}
	if (pd_noise_active_changes > 0U || acquisition_ms <= pd_noise_quiet_until_ms) {
		runtime->noise_fresh_samples = 0U;
	} else if (runtime->noise_fresh_samples < runtime->fixed_window.target_samples) {
		runtime->noise_fresh_samples++;
	}
	if (rc == 0 && runtime->fixed_window.current.valid &&
	    runtime->noise_fresh_samples == runtime->fixed_window.target_samples &&
	    runtime->fixed_window.current.sample_length -
		    runtime->fixed_window.current.failed_samples >= 2U) {
		noise_rms = runtime->fixed_window.current.rms_mv;
		if (settings->noise_warn_rms_mv > 0.0 &&
		    noise_rms > settings->noise_warn_rms_mv &&
		    now >= runtime->next_noise_warning_ms) {
			runtime->next_noise_warning_ms =
				now + PD_NOISE_WARNING_COOLDOWN_MS;
			emit_noise_warning = true;
		}
	}
	k_spin_unlock(&pd_noise_lock, noise_key);
	k_mutex_unlock(&pd_runtime_lock);

	if (commit_dark) {
		pd_commit_dark_result(channel, &completed_dark, dark_persist, dark_reset_lowest, false);
	} else if (dark_failed) {
		pd_emit_dark_failed_warning(channel);
	}

	if (rc != 0) {
		if (emit_adc_warning) {
			pd_emit_adc_error_warning(channel, rc);
		}
		return;
	}

	if (emit_noise_warning) {
		char context[128];

		snprintk(context, sizeof(context),
			 "channel=%s fixed_rms_mv=%.3f threshold_mv=%.3f",
			 photodiode_channel_names[channel],
			 (double)noise_rms,
			 (double)settings->noise_warn_rms_mv);
		app_output_emit(&(const struct coo_cmd_runtime_emit_args){
			.type = COO_CMD_RUNTIME_EMIT_WARNING,
			.delivery = COO_CMD_RUNTIME_EMIT_BEST_EFFORT,
			.code = "photodiode_noise",
			.msg = "photodiode fixed-window RMS exceeded warning threshold",
			.context = context,
		});
	}
}

void photodiode_get_status(struct photodiode_status *out)
{
    struct app_photodiode_settings settings;
    int64_t now = k_uptime_get();

    if (out == NULL) {
        return;
    }

    memset(out, 0, sizeof(*out));
    app_settings_get_photodiode(&settings);

    k_mutex_lock(&pd_runtime_lock, K_FOREVER);
    for (uint8_t i = 0; i < PHOTODIODE_CHANNEL_COUNT; ++i) {
        const struct photodiode_runtime_channel *src = &pd_runtime[i];
        struct photodiode_channel_status *dst = &out->channel[i];
        const struct app_pd_channel_settings *ch = &settings.channel[i];

        if (src->sample_ms > 0) {
            dst->raw = src->raw;
            dst->mv = src->mv;
            dst->net_mv = src->net_mv;
            dst->net_err_mv = src->net_err_mv;
            dst->power_uw = src->power_uw;
            dst->power_err_uw = src->power_err_uw;
            dst->age_ms = (uint32_t)(now - src->sample_ms);
        } else {
            dst->raw = INT16_MIN;
            dst->mv = NAN;
            dst->net_mv = NAN;
            dst->net_err_mv = NAN;
            dst->power_uw = NAN;
            dst->power_err_uw = NAN;
            dst->age_ms = UINT32_MAX;
        }
        dst->configurable_window = src->configurable_window.current;
        dst->last_configurable_window = src->configurable_window.last;
        dst->fixed_window = src->fixed_window.current;
        dst->sample_ms = src->sample_ms;
        dst->t_ms = src->t_ms;
        dst->last_fixed_window = src->fixed_window.last;
        dst->dark_window = pd_dark_window_from_settings(&ch->dark, true, ch);
	        dst->lowest_dark_window =
	            pd_dark_window_from_settings(&ch->lowest_dark,
	                                         ch->lowest_dark_valid,
	                                         ch);
		dst->dark_pending = src->dark_action.pending;
		dst->dark_duration_ms = src->dark_action.pending ?
					src->dark_action.duration_ms : 0U;
	    }
    k_mutex_unlock(&pd_runtime_lock);
}

static void pd_set_configurable_window_locked(struct photodiode_runtime_channel *runtime,
					      uint16_t sample_count)
{
	struct pd_window_runtime *window;

	pd_windows_ensure_locked(runtime);
	window = &runtime->configurable_window;
	window->last = window->current;
	runtime->configurable_start_ms = k_uptime_get();
	window->target_samples = sample_count;
	pd_window_reset_current(window);
}

int photodiode_set_configurable_window_duration(enum photodiode_channel channel,
						uint32_t duration_ms)
{
	uint16_t sample_count;

	if (channel < 0 || channel >= PHOTODIODE_CHANNEL_COUNT) {
		return -EINVAL;
	}
	if (adc_dev == NULL || !device_is_ready(adc_dev)) {
		return -ENODEV;
	}

	sample_count = pd_window_duration_to_samples(duration_ms);

	k_mutex_lock(&pd_runtime_lock, K_FOREVER);
	if (pd_runtime[channel].dark_action.pending) {
		k_mutex_unlock(&pd_runtime_lock);
		return -EBUSY;
	}
	pd_set_configurable_window_locked(&pd_runtime[channel], sample_count);
	k_mutex_unlock(&pd_runtime_lock);
	return (int)pd_window_samples_to_duration_ms(sample_count);
}

int photodiode_start_dark_capture(enum photodiode_channel channel,
				  uint32_t duration_ms,
				  bool persist,
				  bool reset_lowest)
{
	uint16_t sample_count;
	struct photodiode_runtime_channel *runtime;

	if (channel < 0 || channel >= PHOTODIODE_CHANNEL_COUNT ||
	    duration_ms == 0U || duration_ms > APP_PD_DARK_DURATION_MAX_MS) {
		return -EINVAL;
	}
	if (adc_dev == NULL || !device_is_ready(adc_dev)) {
		return -ENODEV;
	}
	/* The command has stopped throughput-owned lasers and enabled the PD.
	 * A manual emitter or unavailable owner state must not arm a false dark. */
	if (pd_dark_eligible_since(channel) < 0) return -EBUSY;

	sample_count = pd_window_duration_to_samples(duration_ms);

	k_mutex_lock(&pd_runtime_lock, K_FOREVER);
	runtime = &pd_runtime[channel];
	pd_windows_ensure_locked(runtime);
	if (runtime->dark_action.pending) {
		k_mutex_unlock(&pd_runtime_lock);
		return -EBUSY;
	}
	pd_set_configurable_window_locked(runtime, sample_count);
	runtime->dark_action = (struct photodiode_dark_action){
		.pending = true,
		.persist = persist,
		.reset_lowest = reset_lowest,
		.target_sample_length = sample_count,
		.duration_ms = pd_window_samples_to_duration_ms(sample_count),
	};
	k_mutex_unlock(&pd_runtime_lock);
	return 0;
}

int photodiode_force_dark(enum photodiode_channel channel,
			  double mean_mv,
			  double rms_mv,
			  bool persist,
			  bool reset_lowest)
{
	struct app_pd_dark_result dark;

	if (reset_lowest || channel < 0 || channel >= PHOTODIODE_CHANNEL_COUNT ||
	    !isfinite(mean_mv) ||
	    mean_mv < PHOTODIODE_DARK_MIN_MV ||
	    mean_mv > PHOTODIODE_DARK_MAX_MV ||
	    !isfinite(rms_mv) ||
	    rms_mv < PHOTODIODE_NOISE_RMS_MIN_MV ||
	    rms_mv > PHOTODIODE_NOISE_RMS_MAX_MV) {
		return -EINVAL;
	}

	k_mutex_lock(&pd_runtime_lock, K_FOREVER);
	pd_runtime[channel].dark_action.pending = false;
	k_mutex_unlock(&pd_runtime_lock);

	dark = (struct app_pd_dark_result){
		.mean_mv = mean_mv,
		.rms_mv = rms_mv,
		.min_mv = mean_mv,
		.max_mv = mean_mv,
	};
	pd_commit_dark_result(channel, &dark, persist, reset_lowest, true);
	return 0;
}

int photodiode_reset_lowest_dark(enum photodiode_channel channel,
				 bool persist)
{
	struct app_photodiode_settings settings;

	if (channel < 0 || channel >= PHOTODIODE_CHANNEL_COUNT) {
		return -EINVAL;
	}

	app_settings_get_photodiode(&settings);
	if (settings.channel[channel].dark.duration_ms == 0U) return -EINVAL;
	pd_update_lowest_dark(&settings.channel[channel], true);
	app_settings_update_photodiode_channel((uint8_t)channel,
					       &settings.channel[channel],
					       persist);
	return 0;
}

void photodiode_thread(void *p1, void *p2, void *p3)
{
    struct app_photodiode_settings settings;

    ARG_UNUSED(p1);
    ARG_UNUSED(p2);
    ARG_UNUSED(p3);

    k_sleep(K_MSEC(10));

    while (adc_dev == NULL || !device_is_ready(adc_dev)) {
        LOG_ERR_RATELIMIT_RATE(PD_HARDWARE_LOG_RATELIMIT_MS, "ADS1115 not ready");
        k_sleep(K_MSEC(500));
    }

    /* Load the first calibration snapshot before the sample timer starts. The
     * timed loop only uses non-blocking refreshes and reuses this cached copy
     * if the command thread is updating settings at the same instant.
     */
    app_settings_get_photodiode(&settings);

    k_timer_start(&pd_sample_timer, K_NO_WAIT, K_MSEC(PHOTODIODE_SAMPLE_INTERVAL_MS));

    while (1) {
        struct photodiode_loop_timing loop_timing = {0};
        int64_t loop_start_ticks;
        uint64_t adc_total_us = 0U;
        uint32_t elapsed_samples;
        bool settings_refreshed;

        elapsed_samples = k_timer_status_sync(&pd_sample_timer);
        /* Native kernel ticks avoid the LPTIM driver's scaled cycle rollover.
         * 4096 Hz gives 244 us diagnostic granularity; UTC steps do not enter. */
        loop_start_ticks = k_uptime_ticks();
    	pd_timing_stats.missed_intervals += elapsed_samples > 1U ? elapsed_samples - 1U : 0U;

        settings_refreshed = app_settings_try_get_photodiode(&settings);
        pd_timing_note_settings(settings_refreshed);

        for (uint8_t i = 0; i < PHOTODIODE_CHANNEL_COUNT; ++i) {
            int16_t raw = 0;
            int64_t adc_start_ticks;
            uint64_t adc_elapsed_us;
            int rc;

            /* One monotonic sample time identifies this acquisition; UTC is
             * separately retained for alignment with external experiment data.
             */
            int64_t acquisition_ms = k_uptime_get();
            struct timespec utc;
            (void)sys_clock_gettime(SYS_CLOCK_REALTIME, &utc);
            uint64_t utc_start_ms = (uint64_t)utc.tv_sec * 1000U + utc.tv_nsec / 1000000U;
            adc_start_ticks = k_uptime_ticks();
            rc = pd_read_raw((enum photodiode_channel)i, &raw);
            adc_elapsed_us = k_ticks_to_us_floor64(k_uptime_ticks() - adc_start_ticks);
            adc_total_us += adc_elapsed_us;
            loop_timing.worst_adc_us[i] = adc_elapsed_us;
            loop_timing.worst_adc_over_us[i] = pd_adc_over_us(adc_elapsed_us);
            pd_timing_note_adc((enum photodiode_channel)i, rc);

            if (rc != 0) {
                LOG_ERR_RATELIMIT_RATE(PD_HARDWARE_LOG_RATELIMIT_MS,
                                       "ADC %s read failed (%d)",
                                       photodiode_channel_names[i], rc);
            }
            pd_update_channel((enum photodiode_channel)i, rc, raw, &settings.channel[i],
                              acquisition_ms, utc_start_ms);
        }

        /* Both channel snapshots are ready. Binary wakeup coalesces overruns;
         * the consumer uses acquisition timestamps and never replays old data.
         */
        k_sem_give(&pd_sample_ready);
        pd_timing_note_loop(&loop_timing,
                            k_ticks_to_us_floor64(k_uptime_ticks() - loop_start_ticks),
                            adc_total_us);
        pd_timing_maybe_log(k_uptime_get());
    }
}
