COO-Utilities/hispec-tib/app/src/attenuator.c

/**
 * @file attenuator.c
 * @brief DAC write/read helpers for paired physical attenuators.
 */

#include "attenuator.h"
#include "command.h"
#include "photodiode.h"
#include "drivers/dac/dac7x78.h"

#include <errno.h>
#include <float.h>
#include <math.h>
#include <string.h>
#include <zephyr/sys/util.h>
#include <zsl/zsl.h>

LOG_MODULE_REGISTER(attenuator, LOG_LEVEL_INF);

/* Pair writes/readback and coefficient changes serialize here. Work on a local
 * copy during I2C; state_lock publishes the resulting confirmed state in one
 * assignment. Readers never take io_lock. Both locks are module-wide because
 * all pairs share the DAC bus; no per-channel synchronization objects needed.
 */
static K_MUTEX_DEFINE(attenuator_io_lock);
static K_MUTEX_DEFINE(attenuator_state_lock);

void attenuator_snapshot(const struct attenuator *drv, struct attenuator *out)
{
    k_mutex_lock(&attenuator_state_lock, K_FOREVER);
    *out = *drv;
    k_mutex_unlock(&attenuator_state_lock);
}

/* Preserve successful physical writes even when the other DAC operation failed.
 * Invalid channels retain their last confirmed voltage but cannot yield an
 * estimate until a successful write/read establishes their state again.
 */
static void attenuator_commit(struct attenuator *drv, struct attenuator *next)
{
    next->dac_cfg1.attenuation_db = attenuator_model_voltage_to_db(&next->coeff1, next->dac_cfg1.voltage);
    next->dac_cfg2.attenuation_db = attenuator_model_voltage_to_db(&next->coeff2, next->dac_cfg2.voltage);
    next->attenuation_db = next->dac_cfg1.attenuation_db + next->dac_cfg2.attenuation_db;
    k_mutex_lock(&attenuator_state_lock, K_FOREVER);
    *drv = *next;
    k_mutex_unlock(&attenuator_state_lock);
}

#define DAC_RESOLUTION_BITS 12
#define DAC_MAX_CODE        ((1 << DAC_RESOLUTION_BITS) - 1)
#define MODEL_ERF_SCALE     4.0
#define MODEL_MIN_TX        1.0e-300
#define MODEL_CORRECTION_START_TX 0.99
#define MODEL_CORRECTION_START_DB (-10.0 * log10(MODEL_CORRECTION_START_TX))
#define ATTENUATOR_DB_EPSILON 1.0e-6
#define ATTENUATOR_VOLTAGE_WARN_EPS_MV 0.5f
#define ATTENUATOR_MODEL_INVERSE_STEPS 24U
#define ATTENUATOR_DB_PER_NEPER (10.0 / log(10.0))
#ifndef M_PI
#define M_PI 3.14159265358979323846
#endif

/* Convert erf-model delta to raw transmission before open normalization. */
static double attenuator_model_delta_to_raw_linear(double delta,
                                                   double *d_raw_d_delta)
{
    const double erf_scale = (double)ZSL_ERF((zsl_real_t)MODEL_ERF_SCALE);
    double transmission;
    double derivative = 0.0;

    if (d_raw_d_delta != NULL) {
        *d_raw_d_delta = 0.0;
    }

    transmission = (double)((erf_scale - ZSL_ERF((zsl_real_t)delta)) /
                            (2.0 * erf_scale));
    if (!isfinite(transmission)) {
        return (isfinite(delta) && delta < 0.0) ? 1.0 : 0.0;
    }

    if (transmission <= 0.0) {
        return 0.0;
    }
    if (transmission >= 1.0) {
        return 1.0;
    }

    derivative = -ZSL_EXP((zsl_real_t)(-delta * delta)) /
                 (sqrt(M_PI) * erf_scale);
    if (d_raw_d_delta != NULL && isfinite(derivative)) {
        *d_raw_d_delta = derivative;
    }
    return transmission;
}

static double attenuator_model_voltage_to_delta(const struct attenuator_model_coeffs *coeffs,
                                                float voltage)
{
    double fvoa_drive_mv = coeffs->gain * (double) voltage;

    return coeffs->slope_inv_fvoa_mv * (fvoa_drive_mv - coeffs->fvoa_50pct_mv);
}

static double attenuator_model_floor_linear(const struct attenuator_model_coeffs *coeffs)
{
    double floor_tx;

    if (coeffs == NULL || !isfinite(coeffs->max_atten_db) ||
        coeffs->max_atten_db <= 0.0) {
        return 0.0;
    }

    floor_tx = pow(10.0, -coeffs->max_atten_db / 10.0);
    if (!isfinite(floor_tx) || floor_tx <= 0.0 || floor_tx >= 1.0) {
        return 0.0;
    }
    return floor_tx;
}

static bool attenuator_model_correction_active(const struct attenuator_model_coeffs *coeffs)
{
    if (coeffs == NULL) {
        return false;
    }

    for (uint8_t i = 0U; i < ATTENUATOR_MODEL_CORRECTION_TERMS; ++i) {
        if (!isfinite((double)coeffs->correction_coeff[i])) {
            return false;
        }
        if (coeffs->correction_coeff[i] != 0.0f) {
            return true;
        }
    }
    return false;
}

bool atten_model_correction_basis(double base_db,
                                  double max_atten_db,
                                  double basis[ATTENUATOR_MODEL_CORRECTION_TERMS])
{
    double span;
    double t;
    double x;
    double envelope;

    if (basis == NULL || !isfinite(base_db) ||
        !isfinite(max_atten_db) ||
        !(max_atten_db > MODEL_CORRECTION_START_DB)) {
        return false;
    }

    for (uint8_t i = 0U; i < ATTENUATOR_MODEL_CORRECTION_TERMS; ++i) {
        basis[i] = 0.0;
    }

    span = max_atten_db - MODEL_CORRECTION_START_DB;
    t = (base_db - MODEL_CORRECTION_START_DB) / span;
    if (!(t > 0.0) || !(t < 1.0)) {
        return false;
    }

    x = 2.0 * t - 1.0;
    envelope = t * (1.0 - t);
    basis[0] = envelope;
    basis[1] = envelope * x;
    /* The common envelope factors out of T_n = 2*x*T_(n-1) - T_(n-2). */
    for (uint8_t i = 2U; i < ATTENUATOR_MODEL_CORRECTION_TERMS; ++i) {
        basis[i] = 2.0 * x * basis[i - 1U] - basis[i - 2U];
    }
    return true;
}

/**
 * Return the empirical dB-space residual correction for the base model.
 *
 * The fitted physical coefficients keep their meaning: fvoa_50pct_mv,
 * slope_inv_fvoa_mv, and max_atten_db still define the erf shutter model plus
 * leakage floor. This ringfenced correction only models the smooth residual
 * left after that fit. Its envelope is zero near open transmission and at the
 * modeled leakage floor so clearing the six coefficients recovers the base
 * model exactly.
 */
static double attenuator_model_chebyshev_db(const struct attenuator_model_coeffs *coeffs,
                                             double base_db,
                                             double *d_corr_d_base_db,
                                             double *d_corr_d_max_atten_db)
{
    double span;
    double t;
    double x;
    double shape;
    double d_shape_dt;
    double d_corr_dt;

    if (d_corr_d_base_db != NULL) {
        *d_corr_d_base_db = 0.0;
    }
    if (d_corr_d_max_atten_db != NULL) {
        *d_corr_d_max_atten_db = 0.0;
    }
    if (coeffs == NULL || !attenuator_model_correction_active(coeffs) ||
        !isfinite(base_db) ||
        !(coeffs->max_atten_db > MODEL_CORRECTION_START_DB)) {
        return 0.0;
    }

    span = coeffs->max_atten_db - MODEL_CORRECTION_START_DB;
    t = (base_db - MODEL_CORRECTION_START_DB) / span;
    if (!(t > 0.0) || !(t < 1.0)) {
        return 0.0;
    }

    x = 2.0 * t - 1.0;
    /* Evaluate T0..T5 and differentiate the same recurrence with respect
     * to t (dx/dt = 2). Every fitted coefficient affects both inversion and
     * uncertainty derivatives.
     */
    double previous = 1.0, term = x;
    double previous_derivative = 0.0, derivative = 2.0;
    shape = coeffs->correction_coeff[0];
    d_shape_dt = 0.0;
    for (uint8_t i = 1U; i < ATTENUATOR_MODEL_CORRECTION_TERMS; ++i) {
        shape += (double)coeffs->correction_coeff[i] * term;
        d_shape_dt += (double)coeffs->correction_coeff[i] * derivative;
        double next = 2.0 * x * term - previous;
        double next_derivative = 4.0 * term + 2.0 * x * derivative - previous_derivative;
        previous = term;
        term = next;
        previous_derivative = derivative;
        derivative = next_derivative;
    }
    d_corr_dt = (1.0 - 2.0 * t) * shape + t * (1.0 - t) * d_shape_dt;
    if (d_corr_d_base_db != NULL) {
        *d_corr_d_base_db = d_corr_dt / span;
    }
    if (d_corr_d_max_atten_db != NULL) {
        *d_corr_d_max_atten_db = -d_corr_dt * t / span;
    }
    return t * (1.0 - t) * shape;
}

/* Only the calibrated branch uses the polynomial. Recover its endpoint in base
 * dB coordinates from Bc + C(Bc) = max_calibrated_db, then fade that residual
 * linearly to the existing leakage floor. No voltage cutoff is stored, and no
 * blend width is fitted. A zero limit is used only while constructing a fit.
 * The implicit endpoint derivative keeps floor-uncertainty propagation valid.
 */
static double attenuator_model_correction_db(const struct attenuator_model_coeffs *coeffs,
                                             double base_db,
                                             double *d_corr_d_base_db,
                                             double *d_corr_d_max_atten_db)
{
    double limit = coeffs->max_calibrated_db;
    double floor = coeffs->max_atten_db;

    if (attenuator_model_correction_active(coeffs) && limit > 0.0 && limit < floor) {
        double lo = 0.0, hi = floor;
        /* Double-precision endpoint resolution, independent of DAC resolution. */
        for (uint8_t i = 0U; i < 48U; ++i) {
            double mid = 0.5 * (lo + hi);
            double db = mid + attenuator_model_chebyshev_db(coeffs, mid, NULL, NULL);
            if (db < limit) lo = mid;
            else hi = mid;
        }
        double bc = 0.5 * (lo + hi);
        if (base_db > bc) {
            double cb, cl;
            (void)attenuator_model_chebyshev_db(coeffs, bc, &cb, &cl);
            if (!(1.0 + cb > 0.0)) return NAN;
            double span = floor - bc;
            double cc = limit - bc;
            double fraction = (floor - base_db) / span;
            double d_bc_d_floor = -cl / (1.0 + cb);
            if (d_corr_d_base_db != NULL) *d_corr_d_base_db = -cc / span;
            if (d_corr_d_max_atten_db != NULL) {
                *d_corr_d_max_atten_db = -d_bc_d_floor * fraction +
                    cc * (1.0 - fraction * (1.0 - d_bc_d_floor)) / span;
            }
            return cc * fraction;
        }
    }
    return attenuator_model_chebyshev_db(coeffs, base_db,
        d_corr_d_base_db, d_corr_d_max_atten_db);
}

/* Temporary working coefficients, never cached across calls or persisted.
 * Keep the fitter's full double evaluator above/below separate from this
 * runtime path: control needs dB and optionally a voltage slope, not fit
 * Jacobians or a per-device conversion back to linear transmission.
 */
#define RUNTIME_CORRECTION_START_DB 0.043648054024500883f
struct atten_runtime_model {
    const float *correction;
    float f50, slope, gain;
    float floor_db, floor_tx, raw0;
    float correction_end_db, tail_slope;
    bool corrected;
};

/* erfc(delta)-erfc(4) preserves the shutter tail in single precision;
 * subtracting erf(delta) from erf(4) would collapse it prematurely to zero.
 */
static float atten_runtime_raw(float delta)
{
    return CLAMP((erfcf(delta) - erfcf(4.0f)) / (2.0f * erff(4.0f)), 0.0f, 1.0f);
}

static float atten_runtime_chebyshev(const struct atten_runtime_model *model,
                                     float base_db, float *derivative)
{
    float span = model->floor_db - RUNTIME_CORRECTION_START_DB;
    float t = (base_db - RUNTIME_CORRECTION_START_DB) / span;

    if (derivative != NULL) *derivative = 0.0f;
    if (!model->corrected || !(t > 0.0f) || !(t < 1.0f)) return 0.0f;

    float x = 2.0f * t - 1.0f;
    float previous = 1.0f, term = x;
    float previous_derivative = 0.0f, d_term = 2.0f;
    float shape = model->correction[0], d_shape_dt = 0.0f;
    /* The same enveloped T0..T5 recurrence as the double fit model. Skip
     * derivative work for inversion's value-only evaluations.
     */
    for (uint8_t i = 1U; i < ATTENUATOR_MODEL_CORRECTION_TERMS; ++i) {
        shape += model->correction[i] * term;
        float next = 2.0f * x * term - previous;
        if (derivative != NULL) {
            d_shape_dt += model->correction[i] * d_term;
            float next_derivative = 4.0f * term + 2.0f * x * d_term - previous_derivative;
            previous_derivative = d_term;
            d_term = next_derivative;
        }
        previous = term;
        term = next;
    }
    if (derivative != NULL) {
        *derivative = ((1.0f - 2.0f * t) * shape + t * (1.0f - t) * d_shape_dt) / span;
    }
    return t * (1.0f - t) * shape;
}

static bool atten_runtime_prepare(const struct attenuator_model_coeffs *coeffs,
                                  struct atten_runtime_model *model)
{
    if (coeffs == NULL) return false;
    *model = (struct atten_runtime_model){
        .correction = coeffs->correction_coeff,
        .f50 = (float)coeffs->fvoa_50pct_mv,
        .slope = (float)coeffs->slope_inv_fvoa_mv,
        .gain = (float)coeffs->gain,
        .floor_db = (float)coeffs->max_atten_db,
    };
    float limit = (float)coeffs->max_calibrated_db;
    if (!isfinite(model->f50) || !isfinite(model->slope) || model->slope <= 0.0f ||
        !isfinite(model->gain) || model->gain <= 0.0f ||
        !isfinite(model->floor_db) || model->floor_db <= 0.0f ||
        !isfinite(limit) || limit < 0.0f || limit > model->floor_db) return false;
    for (uint8_t i = 0U; i < ATTENUATOR_MODEL_CORRECTION_TERMS; ++i) {
        if (!isfinite(model->correction[i])) return false;
        model->corrected |= model->correction[i] != 0.0f;
    }
    model->floor_tx = powf(10.0f, -model->floor_db / 10.0f);
    float delta0 = -model->slope * model->f50;
    if (!isfinite(delta0)) return false;
    model->raw0 = atten_runtime_raw(delta0);
    if (!(model->floor_tx > 0.0f) || !(model->floor_tx < 1.0f) ||
        !(model->raw0 > 0.0f) || !isfinite(model->raw0)) return false;

    model->correction_end_db = model->floor_db;
    if (model->corrected && limit > 0.0f && limit < model->floor_db) {
        float lo = 0.0f, hi = model->floor_db;
        /* Recover Bc + C(Bc) = limit once per call, including the entire
         * inverse. Stop when float endpoints no longer admit a midpoint.
         */
        for (uint8_t i = 0U; i < 48U; ++i) {
            float mid = 0.5f * (lo + hi);
            if (mid == lo || mid == hi) break;
            float db = mid + atten_runtime_chebyshev(model, mid, NULL);
            if (!isfinite(db)) return false;
            if (db < limit) lo = mid;
            else hi = mid;
        }
        model->correction_end_db = 0.5f * (lo + hi);
        float derivative;
        (void)atten_runtime_chebyshev(model, model->correction_end_db, &derivative);
        float span = model->floor_db - model->correction_end_db;
        if (!(1.0f + derivative > 0.0f) || !(span > 0.0f)) return false;
        model->tail_slope = -(limit - model->correction_end_db) / span;
        if (!isfinite(model->tail_slope)) return false;
    }
    return true;
}

static bool atten_runtime_eval(const struct atten_runtime_model *model, float mv,
                               float *db, float *slope_db_per_mv)
{
    float delta = model->slope * (model->gain * mv - model->f50);
    if (!isfinite(mv) || !isfinite(delta)) return false;
    float raw = atten_runtime_raw(delta);
    float ideal = raw / model->raw0;
    if (!isfinite(ideal)) return false;
    float tx = model->floor_tx + (1.0f - model->floor_tx) * CLAMP(ideal, 0.0f, 1.0f);
    if (!isfinite(tx) || !(tx > 0.0f)) return false;
    if (slope_db_per_mv != NULL) *slope_db_per_mv = 0.0f;
    if (tx >= 1.0f) {
        *db = 0.0f;
        return true;
    }
    float base_db = -10.0f * log10f(tx);
    float correction, derivative = 0.0f;
    if (base_db > model->correction_end_db) {
        correction = model->tail_slope * (base_db - model->floor_db);
        derivative = model->tail_slope;
    } else {
        correction = atten_runtime_chebyshev(model, base_db,
            slope_db_per_mv != NULL ? &derivative : NULL);
    }
    *db = base_db + correction;
    if (!isfinite(*db) || *db < 0.0f) return false;
    if (slope_db_per_mv != NULL && ideal > 0.0f && ideal < 1.0f && raw < 1.0f) {
        float d_raw = -expf(-delta * delta) / (sqrtf((float)M_PI) * erff(4.0f));
        *slope_db_per_mv = (1.0f + derivative) * (-10.0f / logf(10.0f)) *
            (1.0f - model->floor_tx) / tx * d_raw * model->slope * model->gain / model->raw0;
        if (!isfinite(*slope_db_per_mv)) return false;
    }
    return true;
}

bool atten_model_eval_runtime(const struct attenuator_model_coeffs *coeffs,
                              float mv, float *db, float *slope_db_per_mv)
{
    struct atten_runtime_model model;
    return db != NULL && atten_runtime_prepare(coeffs, &model) &&
           atten_runtime_eval(&model, mv, db, slope_db_per_mv);
}

int attenuator_index_from_laser_id(enum hispec_laser_id laser, uint8_t *index)
{
    if (index == NULL || laser < 0 || laser >= HISPEC_LASER_COUNT) {
        return -EINVAL;
    }

    *index = (uint8_t)laser;
    return 0;
}

static void attenuator_cfg_init(struct attenuator_dac_cfg *dac_cfg,
                                const struct device *dev, uint8_t channel)
{
    dac_cfg->dev = dev;
    dac_cfg->ideal_full_scale_mv = ATTENUATOR_DRIVE_MAX_MV;
    dac_cfg->drive_limit_mv = ATTENUATOR_DRIVE_MAX_MV;
    dac_cfg->voltage = 0.0f;
    dac_cfg->attenuation_db = 0.0;
    dac_cfg->cfg.channel_id = channel;
    dac_cfg->cfg.resolution = DAC_RESOLUTION_BITS;
#if defined(CONFIG_DAC_BUFFER_NOT_SUPPORT)
    dac_cfg->cfg.buffered = false;
#else
    dac_cfg->cfg.buffered = true;
#endif
}

static bool attenuator_channel_setup(struct attenuator_dac_cfg *dac_cfg)
{
    struct dac7x78_transfer transfer;
    int err;

    if (dac_cfg->dev == NULL || !device_is_ready(dac_cfg->dev)) {
        LOG_ERR("DAC device unavailable for channel %u", dac_cfg->cfg.channel_id);
        return false;
    }

    err = dac7x78_get_transfer(dac_cfg->dev, &transfer);
    if (err != 0 || transfer.ideal_full_scale_uv == 0U || transfer.output_limit_uv == 0U) {
        LOG_ERR("DAC transfer setup failed for channel %u: %d", dac_cfg->cfg.channel_id, err);
        return false;
    }
    dac_cfg->ideal_full_scale_mv = (float) transfer.ideal_full_scale_uv / 1000.0f;
    dac_cfg->drive_limit_mv = MIN(ATTENUATOR_DRIVE_MAX_MV, (float) transfer.output_limit_uv / 1000.0f);

    /* dac_channel_setup() prepares the selected channel in the DAC driver and
     * may perform I2C transactions depending on the underlying implementation.
     */
    err = dac_channel_setup(dac_cfg->dev, &dac_cfg->cfg);
    if (err != 0) {
        LOG_ERR("DAC channel setup failed: %d", err);
        return false;
    }

    return true;
}

bool attenuator_init(struct attenuator *drv,
                     const struct device *dac1, uint8_t channel1,
                     const struct device *dac2, uint8_t channel2)
{
    if (drv == NULL) {
        return false;
    }

    attenuator_cfg_init(&drv->dac_cfg1, dac1, channel1);
    attenuator_cfg_init(&drv->dac_cfg2, dac2, channel2);
    drv->coeff1.fvoa_50pct_mv = 0.5 * (double)ATTENUATOR_DRIVE_MAX_MV * ATTENUATOR_DEFAULT_GAIN;
    drv->coeff1.slope_inv_fvoa_mv = 8.0 / ((double)ATTENUATOR_DRIVE_MAX_MV * ATTENUATOR_DEFAULT_GAIN);
    drv->coeff1.max_atten_db = FVOA_DEFAULT_MAX_ATTEN_DB;
    drv->coeff1.max_calibrated_db = MIN(ATTENUATOR_CALIBRATED_MAX_DB, FVOA_DEFAULT_MAX_ATTEN_DB);
    drv->coeff1.gain = ATTENUATOR_DEFAULT_GAIN;
    drv->coeff1.rms_db = ATTENUATOR_DEFAULT_RMS_DB;
    memset(drv->coeff1.correction_coeff, 0, sizeof(drv->coeff1.correction_coeff));
    drv->coeff2.fvoa_50pct_mv = 0.5 * (double)ATTENUATOR_DRIVE_MAX_MV * ATTENUATOR_DEFAULT_GAIN;
    drv->coeff2.slope_inv_fvoa_mv = 8.0 / ((double)ATTENUATOR_DRIVE_MAX_MV * ATTENUATOR_DEFAULT_GAIN);
    drv->coeff2.max_atten_db = FVOA_DEFAULT_MAX_ATTEN_DB;
    drv->coeff2.max_calibrated_db = MIN(ATTENUATOR_CALIBRATED_MAX_DB, FVOA_DEFAULT_MAX_ATTEN_DB);
    drv->coeff2.gain = ATTENUATOR_DEFAULT_GAIN;
    drv->coeff2.rms_db = ATTENUATOR_DEFAULT_RMS_DB;
    memset(drv->coeff2.correction_coeff, 0, sizeof(drv->coeff2.correction_coeff));
    drv->attenuation_db = 0.0;

    struct attenuator_status status;
    return attenuator_channel_setup(&drv->dac_cfg1) &&
           attenuator_channel_setup(&drv->dac_cfg2) && attenuator_get(drv, &status);
}

double attenuator_model_voltage_to_db(const struct attenuator_model_coeffs *coeffs,
                                      float voltage)
{
    float db;

    if (coeffs == NULL) {
        return 0.0;
    }

    if (atten_model_eval_runtime(coeffs, voltage, &db, NULL)) {
        return (double)db;
    }

    return isfinite(coeffs->max_atten_db) && coeffs->max_atten_db > 0.0 ?
           coeffs->max_atten_db : FVOA_DEFAULT_MAX_ATTEN_DB;
}

bool atten_model_eval(const struct attenuator_model_coeffs *coeffs,
                      float voltage,
                      struct atten_model_eval *out)
{
    double floor_tx;
    double raw;
    double raw0;
    double d_raw_d_delta;
    double d_raw0_d_delta;
    double delta;
    double delta0;
    double ideal;
    double ideal_clamped;
    double tx;
    double base_db;
    double correction_db;
    double d_corr_d_base_db;
    double d_corr_d_max_atten_db;
    double derivative_scale;
    double d_ideal_d_voltage = 0.0;
    double d_ideal_d_f50 = 0.0;
    double d_ideal_d_slope = 0.0;
    double d_tx_scale;
    double raw0_sq;

    if (coeffs == NULL || out == NULL ||
        !isfinite(coeffs->fvoa_50pct_mv) ||
        !isfinite(coeffs->slope_inv_fvoa_mv) ||
        !isfinite(coeffs->max_atten_db) ||
        !isfinite(coeffs->gain) ||
        !isfinite((double)voltage) ||
        coeffs->gain <= 0.0) {
        return false;
    }

    floor_tx = attenuator_model_floor_linear(coeffs);
    if (!(floor_tx > 0.0)) {
        return false;
    }

    delta = attenuator_model_voltage_to_delta(coeffs, voltage);
    delta0 = attenuator_model_voltage_to_delta(coeffs, 0.0f);
    if (!isfinite(delta) || !isfinite(delta0)) {
        return false;
    }

    raw = attenuator_model_delta_to_raw_linear(delta, &d_raw_d_delta);
    raw0 = attenuator_model_delta_to_raw_linear(delta0, &d_raw0_d_delta);
    if (!(raw0 > MODEL_MIN_TX) || !isfinite(raw0)) {
        return false;
    }

    ideal = raw / raw0;
    if (!isfinite(ideal)) {
        return false;
    }

    ideal_clamped = CLAMP(ideal, 0.0, 1.0);
    if (ideal > 0.0 && ideal < 1.0) {
        double d_raw_d_voltage =
            d_raw_d_delta * coeffs->slope_inv_fvoa_mv * coeffs->gain;
        double d_raw_d_f50 =
            d_raw_d_delta * -coeffs->slope_inv_fvoa_mv;
        double d_raw0_d_f50 =
            d_raw0_d_delta * -coeffs->slope_inv_fvoa_mv;
        double d_raw_d_slope =
            d_raw_d_delta *
            (coeffs->gain * (double)voltage - coeffs->fvoa_50pct_mv);
        double d_raw0_d_slope =
            d_raw0_d_delta * -coeffs->fvoa_50pct_mv;

        raw0_sq = raw0 * raw0;
        d_ideal_d_voltage = d_raw_d_voltage / raw0;
        d_ideal_d_f50 = (d_raw_d_f50 * raw0 - raw * d_raw0_d_f50) / raw0_sq;
        d_ideal_d_slope =
            (d_raw_d_slope * raw0 - raw * d_raw0_d_slope) / raw0_sq;
    }

    tx = floor_tx + (1.0 - floor_tx) * ideal_clamped;
    if (!isfinite(tx) || tx <= 0.0) {
        return false;
    }

    *out = (struct atten_model_eval){0};
    if (tx >= 1.0) {
        out->tx = 1.0;
        out->db = 0.0;
        return true;
    }

    d_tx_scale = -ATTENUATOR_DB_PER_NEPER * (1.0 - floor_tx) / tx;
    out->tx = tx;
    base_db = -10.0 * ZSL_LOG10((zsl_real_t)tx);
    correction_db = attenuator_model_correction_db(coeffs, base_db,
                                                   &d_corr_d_base_db,
                                                   &d_corr_d_max_atten_db);
    out->db = base_db + correction_db;
    if (!isfinite(out->db) || out->db < 0.0) {
        return false;
    }
    out->tx = pow(10.0, -out->db / 10.0);
    derivative_scale = 1.0 + d_corr_d_base_db;
    out->d_db_d_voltage_mv = derivative_scale * d_tx_scale * d_ideal_d_voltage;
    out->d_db_d_fvoa_50pct_mv = derivative_scale * d_tx_scale * d_ideal_d_f50;
    out->d_db_d_slope_inv_fvoa_mv = derivative_scale * d_tx_scale * d_ideal_d_slope;
    out->d_db_d_max_atten_db =
        derivative_scale * floor_tx * (1.0 - ideal_clamped) / tx +
        d_corr_d_max_atten_db;
    if (!isfinite(out->db) ||
        !isfinite(out->tx) ||
        !isfinite(out->d_db_d_voltage_mv) ||
        !isfinite(out->d_db_d_fvoa_50pct_mv) ||
        !isfinite(out->d_db_d_slope_inv_fvoa_mv) ||
        !isfinite(out->d_db_d_max_atten_db)) {
        return false;
    }
    return true;
}

bool atten_model_db_sigma(const struct atten_model_eval *eval,
                          double measured_db_sigma,
                          double voltage_sigma_mv,
                          double max_atten_sigma_db,
                          double *sigma_db)
{
    double sigma_sq;

    if (eval == NULL || sigma_db == NULL ||
        !isfinite(measured_db_sigma) || measured_db_sigma < 0.0 ||
        !isfinite(voltage_sigma_mv) || voltage_sigma_mv < 0.0 ||
        !isfinite(max_atten_sigma_db) || max_atten_sigma_db < 0.0) {
        return false;
    }

    sigma_sq = measured_db_sigma * measured_db_sigma +
               (eval->d_db_d_voltage_mv * voltage_sigma_mv) *
               (eval->d_db_d_voltage_mv * voltage_sigma_mv) +
               (eval->d_db_d_max_atten_db * max_atten_sigma_db) *
               (eval->d_db_d_max_atten_db * max_atten_sigma_db);
    if (!isfinite(sigma_sq) || sigma_sq < 0.0) {
        return false;
    }

    *sigma_db = sqrt(sigma_sq);
    return isfinite(*sigma_db);
}

bool attenuator_model_db_to_voltage(const struct attenuator_model_coeffs *coeffs,
                                    double attenuation_db, float *voltage)
{
    struct atten_runtime_model model;
    float lo_mv = 0.0f, hi_mv = ATTENUATOR_DRIVE_MAX_MV;
    float lo_db, hi_db;

    if (voltage == NULL || !isfinite(attenuation_db) || attenuation_db < 0.0 ||
        !atten_runtime_prepare(coeffs, &model) ||
        !atten_runtime_eval(&model, lo_mv, &lo_db, NULL) ||
        !atten_runtime_eval(&model, hi_mv, &hi_db, NULL) || !(hi_db > lo_db)) {
        return false;
    }
    /* Public targets remain double. Allow only endpoint rounding, with a
     * four-ULP float tolerance scaled to the modeled attenuation in dB.
     */
    float lo_epsilon = MAX(1.0e-6f, 4.0f * FLT_EPSILON * MAX(1.0f, fabsf(lo_db)));
    float hi_epsilon = MAX(1.0e-6f, 4.0f * FLT_EPSILON * MAX(1.0f, fabsf(hi_db)));
    if (attenuation_db < (double)lo_db - (double)lo_epsilon ||
        attenuation_db > (double)hi_db + (double)hi_epsilon) return false;
    if (attenuation_db <= (double)lo_db + (double)lo_epsilon) {
        *voltage = lo_mv;
        return true;
    }
    if (attenuation_db >= (double)hi_db - (double)hi_epsilon) {
        *voltage = hi_mv;
        return true;
    }
    /* Both corrected and base curves use the same bounded voltage search.
     * Normalization, floor, and correction endpoint were prepared just once.
     */
    for (uint8_t i = 0U; i < ATTENUATOR_MODEL_INVERSE_STEPS; ++i) {
        float mid_mv = 0.5f * (lo_mv + hi_mv);
        float mid_db;
        if (!atten_runtime_eval(&model, mid_mv, &mid_db, NULL)) return false;
        if ((double)mid_db < attenuation_db) lo_mv = mid_mv;
        else hi_mv = mid_mv;
    }
    *voltage = 0.5f * (lo_mv + hi_mv);
    return true;
}

static bool attenuator_model_coeff_valid(const struct attenuator_model_coeffs *coeffs)
{
    float max_db;

    if (coeffs == NULL || !isfinite(coeffs->fvoa_50pct_mv) ||
        !isfinite(coeffs->slope_inv_fvoa_mv) ||
        !isfinite(coeffs->max_atten_db) || !isfinite(coeffs->gain) ||
        !isfinite(coeffs->max_calibrated_db) || coeffs->max_calibrated_db <= 0.0 ||
        coeffs->max_calibrated_db > coeffs->max_atten_db ||
        !isfinite(coeffs->rms_db) || coeffs->rms_db < 0.0 ||
        coeffs->slope_inv_fvoa_mv <= 0.0 || coeffs->gain <= 0.0) {
        return false;
    }
    for (uint8_t i = 0U; i < ATTENUATOR_MODEL_CORRECTION_TERMS; ++i) {
        if (!isfinite((double)coeffs->correction_coeff[i])) {
            return false;
        }
    }
    if (!(attenuator_model_floor_linear(coeffs) > 0.0)) {
        return false;
    }

    return atten_model_eval_runtime(coeffs, ATTENUATOR_DRIVE_MAX_MV, &max_db, NULL) &&
           (double)max_db > ATTENUATOR_DB_EPSILON;
}

bool attenuator_model_coefficients_valid(
    const struct attenuator_model_coeffs physical[ATTENUATOR_PHYSICAL_COUNT])
{
    if (physical == NULL) {
        return false;
    }

    for (uint8_t i = 0U; i < ATTENUATOR_PHYSICAL_COUNT; ++i) {
        if (!attenuator_model_coeff_valid(&physical[i])) {
            return false;
        }
    }

    return true;
}

static float attenuator_drive_limit_mv(const struct attenuator_dac_cfg *dac_cfg)
{
    if (dac_cfg == NULL || dac_cfg->drive_limit_mv <= 0.0f) {
        return ATTENUATOR_DRIVE_MAX_MV;
    }

    return dac_cfg->drive_limit_mv;
}

static float attenuator_code_to_voltage(const struct attenuator_dac_cfg *dac_cfg,
                                         uint32_t code)
{
    float voltage;
    float drive_limit = attenuator_drive_limit_mv(dac_cfg);

    if (dac_cfg == NULL || dac_cfg->ideal_full_scale_mv <= 0.0f) {
        return 0.0f;
    }

    voltage = (dac_cfg->ideal_full_scale_mv /
               (float)(1 << DAC_RESOLUTION_BITS)) * (float)code;
    if (voltage > drive_limit) {
        return drive_limit;
    }

    return voltage;
}

static uint32_t attenuator_voltage_to_code(const struct attenuator_dac_cfg *dac_cfg,
                                           float voltage)
{
    float ideal_full_scale_mv;
    uint32_t code;

    if (dac_cfg->ideal_full_scale_mv <= 0.0f) {
        return 0U;
    }

    ideal_full_scale_mv = dac_cfg->ideal_full_scale_mv;
    code = (uint32_t)(((voltage / ideal_full_scale_mv) *
                       (float)(1 << DAC_RESOLUTION_BITS)) + 0.5f);

    if (code > DAC_MAX_CODE) {
        return DAC_MAX_CODE;
    }

    return code;
}

static bool attenuator_prepare_voltage(struct attenuator_dac_cfg *dac_cfg,
                                     const struct attenuator_model_coeffs *coeffs,
                                     float voltage, uint32_t *code_out)
{
    float unclamped_voltage = voltage;
    bool report_clamp = false;
    uint32_t code;
    float applied_voltage;
    float drive_limit;
    char context[64];

    if (dac_cfg == NULL || coeffs == NULL || dac_cfg->dev == NULL || !isfinite(voltage)) {
        return false;
    }

    drive_limit = attenuator_drive_limit_mv(dac_cfg);
    if (voltage < 0.0f) {
        report_clamp = voltage < -ATTENUATOR_VOLTAGE_WARN_EPS_MV;
        voltage = 0.0f;
    } else if (voltage > drive_limit) {
        report_clamp = voltage > drive_limit + ATTENUATOR_VOLTAGE_WARN_EPS_MV;
        voltage = drive_limit;
    }

	if (report_clamp) {
		snprintk(context, sizeof(context),
			 "channel=%u requested=%.3f clamped=%.3f",
			 dac_cfg->cfg.channel_id, (double)unclamped_voltage, (double)voltage);
		coo_cmd_runtime_emit(command_runtime_get(),
				     &(const struct coo_cmd_runtime_emit_args){
					     .type = COO_CMD_RUNTIME_EMIT_WARNING,
					     .delivery = COO_CMD_RUNTIME_EMIT_BEST_EFFORT,
					     .code = "attenuator_clamped",
					     .msg = "attenuator command exceeded drive range and was clamped",
					     .context = context,
				     });
	}

    code = attenuator_voltage_to_code(dac_cfg, voltage);
    applied_voltage = attenuator_code_to_voltage(dac_cfg, code);
    *code_out = code;
    dac_cfg->valid = true;
    dac_cfg->voltage = applied_voltage;
    dac_cfg->attenuation_db = attenuator_model_voltage_to_db(coeffs, applied_voltage);

    return true;
}

/* Compute both quantized outputs and forward estimates before any I2C.
 * A pair of four-byte writes takes 180 us at 400 kHz (including ACK bits),
 * apart from controller/RTOS overhead. No model inversion separates writes. */
static bool attenuator_set_pair_staged(struct attenuator *drv,
                                      const struct attenuator_target target[ATTENUATOR_PHYSICAL_COUNT])
{
    struct attenuator_dac_cfg *dac[2] = {&drv->dac_cfg1, &drv->dac_cfg2};
    const struct attenuator_model_coeffs *coeff[2] = {&drv->coeff1, &drv->coeff2};
    struct attenuator_dac_cfg prepared[2];
    uint32_t code[2];
    bool changing = false;
    for (uint8_t i = 0; i < ATTENUATOR_PHYSICAL_COUNT; ++i) {
        if (!target[i].update) continue;
        if (!isfinite(target[i].value)) return false;
        float voltage = (float)target[i].value;
        if (!target[i].voltage_mv) {
            if (target[i].value < 0.0) return false;
            float limit = attenuator_drive_limit_mv(dac[i]);
            double max_db = attenuator_model_voltage_to_db(coeff[i], limit);
            if (target[i].value <= ATTENUATOR_DB_EPSILON) voltage = 0.0f;
            else if (max_db > 0.0 && target[i].value >= max_db - ATTENUATOR_DB_EPSILON) voltage = limit;
            else if (!attenuator_model_db_to_voltage(coeff[i], target[i].value, &voltage)) return false;
        }
        prepared[i] = *dac[i];
        if (!attenuator_prepare_voltage(&prepared[i], coeff[i], voltage, &code[i])) return false;
        changing |= !dac[i]->valid || code[i] != attenuator_voltage_to_code(dac[i], dac[i]->voltage);
    }
    /* Bracket the whole prepared pair; keep notifications out of the I2C gap. */
    if (changing) photodiode_noise_change_begin();
    for (uint8_t i = 0; i < ATTENUATOR_PHYSICAL_COUNT; ++i) {
        if (!target[i].update) continue;
        /* Only this call changes hardware. It may block on I2C. */
        int rc = dac_write_value(dac[i]->dev, dac[i]->cfg.channel_id, code[i]);
        if (rc != 0) {
            dac[i]->valid = false;
            if (changing) photodiode_noise_change_end();
            LOG_ERR("DAC write failed: %d", rc);
            return false;
        }
        *dac[i] = prepared[i];
        /* Retain confirmed writes if the following channel fails. */
        drv->attenuation_db = drv->dac_cfg1.attenuation_db + drv->dac_cfg2.attenuation_db;
    }
    if (changing) photodiode_noise_change_end();
    return true;
}

static double attenuator_physical_max_db(const struct attenuator_dac_cfg *dac_cfg,
                                         const struct attenuator_model_coeffs *coeffs)
{
    return attenuator_model_voltage_to_db(coeffs,attenuator_drive_limit_mv(dac_cfg));
}

static bool attenuator_read_physical(struct attenuator_dac_cfg *dac_cfg,
                                     const struct attenuator_model_coeffs *coeffs);

static bool attenuator_set_db_staged(struct attenuator *drv, double attenuation_db,
                                     bool calibrated_only)
{
    double current1, current2, max1, max2, lower1, upper1, db1, db2;
    char context[64];

    if (drv == NULL || !isfinite(attenuation_db) || attenuation_db < 0.0) {
        return false;
    }

    if ((!drv->dac_cfg1.valid && !attenuator_read_physical(&drv->dac_cfg1, &drv->coeff1)) ||
        (!drv->dac_cfg2.valid && !attenuator_read_physical(&drv->dac_cfg2, &drv->coeff2))) {
        return false;
    }

    /* Voltages are owned by the DAC layer. Re-evaluate them under the active
     * coefficients, including coefficient replacement that preserves total dB.
     */
    current1 = attenuator_model_voltage_to_db(&drv->coeff1, drv->dac_cfg1.voltage);
    current2 = attenuator_model_voltage_to_db(&drv->coeff2, drv->dac_cfg2.voltage);
    max1 = attenuator_physical_max_db(&drv->dac_cfg1, &drv->coeff1);
    max2 = attenuator_physical_max_db(&drv->dac_cfg2, &drv->coeff2);
    if (calibrated_only) {
        max1 = MIN(max1, MIN(ATTENUATOR_CALIBRATED_MAX_DB, drv->coeff1.max_calibrated_db));
        max2 = MIN(max2, MIN(ATTENUATOR_CALIBRATED_MAX_DB, drv->coeff2.max_calibrated_db));
    }
    if (!isfinite(current1) || !isfinite(current2) || !isfinite(max1) || !isfinite(max2)) {
        return false;
    }
    drv->dac_cfg1.attenuation_db = current1;
    drv->dac_cfg2.attenuation_db = current2;
    drv->attenuation_db = current1 + current2;

    if (attenuation_db > max1 + max2) {
        snprintk(context, sizeof(context), "requested=%.3f clamped=%.3f",
                 attenuation_db, max1 + max2);
        if (!calibrated_only) coo_cmd_runtime_emit(command_runtime_get(),
            &(const struct coo_cmd_runtime_emit_args){
                .type = COO_CMD_RUNTIME_EMIT_WARNING,
                .delivery = COO_CMD_RUNTIME_EMIT_BEST_EFFORT,
                .code = "attenuator_clamped",
                .msg = "attenuator command exceeded modeled range and was clamped",
                .context = context,
            });
        attenuation_db = max1 + max2;
    }
    if (fabs(attenuation_db - drv->attenuation_db) <= ATTENUATOR_DB_EPSILON &&
        current1 <= max1 && current2 <= max2) {
        return true;
    }

    /* Choose the most balanced allocation allowed by the requested direction.
     * On an increase neither device decreases; on a decrease neither increases.
     * This uses the less-attenuated device first when adding dB, and the more-
     * attenuated one first when removing dB, avoiding the first-device plateau
     * handoff where our optical model is least reliable.
     */
    if (calibrated_only && (current1 > max1 || current2 > max2)) {
        /* Manual settings can start outside either automatic range. */
        lower1 = MAX(0.0, attenuation_db - max2);
        upper1 = MIN(max1, attenuation_db);
    } else if (attenuation_db > drv->attenuation_db) {
        lower1 = MAX(current1, attenuation_db - max2);
        upper1 = MIN(max1, attenuation_db - current2);
    } else {
        lower1 = MAX(0.0, attenuation_db - current2);
        upper1 = MIN(current1, attenuation_db);
    }
    db1 = CLAMP(attenuation_db / 2.0, lower1, upper1);
    db2 = attenuation_db - db1;
    const struct attenuator_target target[2] = {
        {.value = db1, .update = fabs(db1 - current1) > ATTENUATOR_DB_EPSILON},
        {.value = db2, .update = fabs(db2 - current2) > ATTENUATOR_DB_EPSILON},
    };
    return attenuator_set_pair_staged(drv, target);
}

bool attenuator_set_pair(struct attenuator *drv, const struct attenuator_target target[ATTENUATOR_PHYSICAL_COUNT])
{
    struct attenuator next;
    if (drv == NULL || target == NULL) return false;
    k_mutex_lock(&attenuator_io_lock, K_FOREVER);
    attenuator_snapshot(drv, &next);
    bool ok = attenuator_set_pair_staged(&next, target);
    attenuator_commit(drv, &next);
    k_mutex_unlock(&attenuator_io_lock);
    return ok;
}

bool attenuator_set_physical_db(struct attenuator *drv, uint8_t physical_index, double attenuation_db)
{
    if (physical_index >= ATTENUATOR_PHYSICAL_COUNT) return false;
    struct attenuator_target target[ATTENUATOR_PHYSICAL_COUNT] = {0};
    target[physical_index] = (struct attenuator_target){.value = attenuation_db, .update = true};
    return attenuator_set_pair(drv, target);
}

bool attenuator_set_physical_voltage(struct attenuator *drv, uint8_t physical_index, float voltage)
{
    if (physical_index >= ATTENUATOR_PHYSICAL_COUNT) return false;
    struct attenuator_target target[ATTENUATOR_PHYSICAL_COUNT] = {0};
    target[physical_index] = (struct attenuator_target){.value = voltage, .voltage_mv = true, .update = true};
    return attenuator_set_pair(drv, target);
}

bool attenuator_set_db(struct attenuator *drv, double attenuation_db, bool calibrated_only)
{
    struct attenuator next;
    bool ok;

    if (drv == NULL) {
        return false;
    }
    k_mutex_lock(&attenuator_io_lock, K_FOREVER);
    attenuator_snapshot(drv, &next);
    ok = attenuator_set_db_staged(&next, attenuation_db, calibrated_only);
    attenuator_commit(drv, &next);
    k_mutex_unlock(&attenuator_io_lock);
    return ok;
}

bool attenuator_set_linear(struct attenuator *drv, double linear, bool calibrated_only)
{
    double attenuation_db;

    if (linear <= 0.0 || linear > 1.0) {
        return false;
    }

    attenuation_db = -10.0 * (double)ZSL_LOG10((zsl_real_t)linear);

    return attenuator_set_db(drv, attenuation_db, calibrated_only);
}

static bool attenuator_read_physical(struct attenuator_dac_cfg *dac_cfg,
                                     const struct attenuator_model_coeffs *coeffs)
{
    uint32_t code = 0U;
    int err;

    err = dac7x78_read_value(dac_cfg->dev, dac_cfg->cfg.channel_id, &code);
    if (err != 0) {
        dac_cfg->valid = false;
        LOG_ERR("DAC read failed: %d", err);
        return false;
    }

    dac_cfg->valid = true;
    dac_cfg->voltage = attenuator_code_to_voltage(dac_cfg, code);
    dac_cfg->attenuation_db =
        attenuator_model_voltage_to_db(coeffs, dac_cfg->voltage);

    return true;
}

bool attenuator_get(struct attenuator *drv, struct attenuator_status *out)
{
    struct attenuator next;
    bool first_ok, second_ok;

    if (drv == NULL || out == NULL) {
        return false;
    }
    k_mutex_lock(&attenuator_io_lock, K_FOREVER);
    attenuator_snapshot(drv, &next);
    first_ok = attenuator_read_physical(&next.dac_cfg1, &next.coeff1);
    second_ok = attenuator_read_physical(&next.dac_cfg2, &next.coeff2);
    attenuator_commit(drv, &next);
    k_mutex_unlock(&attenuator_io_lock);
    if (!first_ok || !second_ok) {
        return false;
    }
    out->attenuation_db = next.attenuation_db;
    out->linear = pow(10.0, -next.attenuation_db / 10.0);
    out->voltage1 = next.dac_cfg1.voltage;
    out->voltage2 = next.dac_cfg2.voltage;
    out->attenuation_db1 = next.dac_cfg1.attenuation_db;
    out->attenuation_db2 = next.dac_cfg2.attenuation_db;
    return true;
}

bool attenuator_estimate_transmission(struct attenuator *drv,
                                      struct attenuator_transmission_estimate *out)
{
    struct attenuator snapshot;
    float db1, db2, slope1, slope2;
    float sigma_db1, sigma_db2;

    if (drv == NULL || out == NULL) {
        return false;
    }
    attenuator_snapshot(drv, &snapshot);
    if (!snapshot.dac_cfg1.valid || !snapshot.dac_cfg2.valid) {
        return false;
    }
    /* Derive dB from confirmed voltages and the same coefficient snapshot;
     * boot may have installed calibration since the last register readback.
     */
    if (!atten_model_eval_runtime(&snapshot.coeff1, snapshot.dac_cfg1.voltage, &db1, &slope1) ||
        !atten_model_eval_runtime(&snapshot.coeff2, snapshot.dac_cfg2.voltage, &db2, &slope2)) {
        return false;
    }
    float rms1 = (float)snapshot.coeff1.rms_db, rms2 = (float)snapshot.coeff2.rms_db;
    if (!isfinite(rms1) || rms1 < 0.0f || !isfinite(rms2) || rms2 < 0.0f) return false;
    slope1 /= (float)snapshot.coeff1.gain;
    slope2 /= (float)snapshot.coeff2.gain;
    sigma_db1 = hypotf(rms1, slope1 * (float)ATTENUATOR_FVOA_NOISE_RMS_MV);
    sigma_db2 = hypotf(rms2, slope2 * (float)ATTENUATOR_FVOA_NOISE_RMS_MV);
    if (!isfinite(sigma_db1) || !isfinite(sigma_db2)) return false;
    /* Promote before adding the two dB values or converting tiny linear
     * transmissions/errors. Throughput arithmetic remains double throughout.
     */
    out->attenuation_db1 = (double)db1;
    out->attenuation_db2 = (double)db2;
    out->attenuation_db = out->attenuation_db1 + out->attenuation_db2;
    out->slope1_db_per_fvoa_mv = (double)slope1;
    out->slope2_db_per_fvoa_mv = (double)slope2;
    out->linear = pow(10.0, -out->attenuation_db / 10.0);
    /* Fit residuals are model uncertainty, not independent ADC noise: these
     * contributions remain correlated across repeated measurements.
     * Electrical noise moves along each calibrated curve. Treat it as
     * independent of the model residuals and of the other FVOA's electrical
     * noise. The combined uncertainty is not a temporal RMS prediction.
     */
    out->linear_err = out->linear * (log(10.0) / 10.0) *
                     hypot((double)sigma_db1, (double)sigma_db2);
    out->voltage1 = snapshot.dac_cfg1.voltage;
    out->voltage2 = snapshot.dac_cfg2.voltage;
    return true;
}

int attenuator_apply_coefficients_preserve_db(
    struct attenuator *drv,
    const struct attenuator_model_coeffs physical[ATTENUATOR_PHYSICAL_COUNT])
{
    struct attenuator next;
    struct attenuator_model_coeffs old_coeff1, old_coeff2;
    bool ok;
    double total_db;

    if (drv == NULL || !attenuator_model_coefficients_valid(physical)) {
        return -EINVAL;
    }
    k_mutex_lock(&attenuator_io_lock, K_FOREVER);
    attenuator_snapshot(drv, &next);
    old_coeff1 = next.coeff1;
    old_coeff2 = next.coeff2;
    bool first_ok = attenuator_read_physical(&next.dac_cfg1, &next.coeff1);
    bool second_ok = attenuator_read_physical(&next.dac_cfg2, &next.coeff2);
    ok = first_ok && second_ok;
    if (ok) {
        total_db = next.dac_cfg1.attenuation_db + next.dac_cfg2.attenuation_db;
        next.coeff1 = physical[0];
        next.coeff2 = physical[1];
        ok = attenuator_set_db_staged(&next, total_db, false);
        if (!ok) {
            /* No rollback of DAC writes. Retain confirmed voltages and expose
             * failure, interpreting those voltages under the old calibration.
             */
            next.coeff1 = old_coeff1;
            next.coeff2 = old_coeff2;
        }
    }
    attenuator_commit(drv, &next);
    k_mutex_unlock(&attenuator_io_lock);
    return ok ? 0 : -EIO;
}
