COO-Utilities/hispec-tib/app/src/photodiode.h

/**
 * @file photodiode.h
 * @brief TIB photodiode sampling, rolling status windows, and dark-calibration state.
 *
 * The sampler thread owns ADC reads, per-channel moving windows, and dark
 * calibration snapshots. Command handlers can request internal configurable
 * window changes or dark captures; they do not read the ADC.
 */

#ifndef PHOTODIODE_H
#define PHOTODIODE_H

#include <zephyr/kernel.h>
#include <stdbool.h>
#include <stdint.h>

#define PHOTODIODE_SAMPLE_INTERVAL_MS 50U

#define PHOTODIODE_CHANNEL_COUNT 2

#define PHOTODIODE_ADC_FULL_SCALE_MV 2048.0
#define PHOTODIODE_ADC_LSB_MV 0.0625
#define PHOTODIODE_ADC_MAX_MV (PHOTODIODE_ADC_FULL_SCALE_MV - PHOTODIODE_ADC_LSB_MV)
#define PHOTODIODE_ADC_USABLE_MV 2000.0

#define PHOTODIODE_DEFAULT_DARK_MV 0.0
#define PHOTODIODE_DEFAULT_LOWEST_DARK_MV 0.0
#define PHOTODIODE_DEFAULT_DARK_NOISE_RMS_MV 0.0
#define PHOTODIODE_DARK_MIN_MV (-PHOTODIODE_ADC_FULL_SCALE_MV)
#define PHOTODIODE_DARK_MAX_MV PHOTODIODE_ADC_FULL_SCALE_MV
#define PHOTODIODE_NOISE_RMS_MIN_MV 0.0
#define PHOTODIODE_NOISE_RMS_MAX_MV PHOTODIODE_ADC_FULL_SCALE_MV
#define PHOTODIODE_RESPONSIVITY_MIN_A_PER_W 0.000001
#define PHOTODIODE_RESPONSIVITY_MAX_A_PER_W 10.0
#define PHOTODIODE_TRANSIMPEDANCE_MIN_V_PER_A 1.0e5
#define PHOTODIODE_TRANSIMPEDANCE_MAX_V_PER_A 1.0e12
/* RMS scatter in the fixed 500 ms window, in ADC-input mV reconstructed from
 * conversion codes. With the default effective gains and responsivities,
 * 10 mV RMS is nominally 0.538 pW RMS at YJ and 17.3 nW RMS at HK:
 * P_rms = 0.010 V / (transimpedance_v_per_a * responsivity_a_per_w).
 * These are wavelength-dependent optical equivalents; real signal changes
 * within the window also contribute to this warning statistic.
 * Warnings require five seconds without a reported input change followed by
 * a fresh fixed window; diagnostic RMS remains available during changes.
 */
#define PHOTODIODE_YJ_DEFAULT_NOISE_WARN_RMS_MV 10.0
#define PHOTODIODE_HK_DEFAULT_NOISE_WARN_RMS_MV 10.0
#define PHOTODIODE_YJ_DEFAULT_RESPONSIVITY_A_PER_W 0.93
#define PHOTODIODE_HK_DEFAULT_RESPONSIVITY_A_PER_W 0.60971
/* Effective transimpedance at the ADC input: detector datasheet gain combined
 * with the Rev. 2 0-10 V to 0-2 V divider and any intervening analog gain.
 * YJ: 1.0e11 V/A * 0.2; HK: PDA10DT at 70 dB, 4.75e6 V/A * 0.2.
 * R7/R8 present 100 kohm to the detectors (80 kohm above, 20 kohm below
 * the ADC node), so the PDA10DT's 50-ohm-load half-gain does not apply.
 * Keep this as one calibrated setting; do not apply the divider twice.
 */
#define PHOTODIODE_YJ_DEFAULT_TRANSIMPEDANCE_V_PER_A 2.0e10
#define PHOTODIODE_HK_DEFAULT_TRANSIMPEDANCE_V_PER_A 9.5e5
#define PHOTODIODE_FIXED_WINDOW_MS 500U
#define PHOTODIODE_FORCED_DARK_RMS_DEFAULT_MV 1.5

struct app_pd_channel_settings;

enum photodiode_channel {
	PHOTODIODE_CHANNEL_YJ = 0,
	PHOTODIODE_CHANNEL_HK = 1
};

struct photodiode_window_result {
	bool valid;
	uint16_t sample_length;
	uint16_t failed_samples;
	int64_t end_ms;
	double mean_mv;
	double mean_net_mv;
	double rms_mv;
	double mean_net_err_mv;
	double min_mv;
	double max_mv;
	double power_uw;
	double power_err_uw;
	int16_t max_raw;
};

struct photodiode_channel_status {
	int16_t raw;
	double mv;
	double net_mv;
	double net_err_mv;
	double power_uw;
	double power_err_uw;
	uint32_t age_ms;
	struct photodiode_window_result configurable_window;
	struct photodiode_window_result last_configurable_window;
	struct photodiode_window_result fixed_window;
	/* Monotonic acquisition start identifies freshness; UTC midpoint aligns scans. */
	int64_t sample_ms;
	uint64_t t_ms;
	struct photodiode_window_result last_fixed_window;
	struct photodiode_window_result dark_window;
	struct photodiode_window_result lowest_dark_window;
	bool dark_pending;
	uint32_t dark_duration_ms;
};

struct photodiode_status {
	struct photodiode_channel_status channel[PHOTODIODE_CHANNEL_COUNT];
};

/** Channel labels used in command replies and telemetry JSON. */
extern const char *const photodiode_channel_names[PHOTODIODE_CHANNEL_COUNT];
/** @brief Background sampler thread; blocks on ADC reads and periodic sleeps. */
void photodiode_thread(void *p1, void *p2, void *p3);

/** @brief Copy latest sample, calibration, and moving-window status. */
void photodiode_get_status(struct photodiode_status *out);

struct photodiode_sample_snapshot {
    double mv, net_mv, power_uw;
    int64_t sample_ms;
    bool dark_pending;
};

/** Copy the latest two samples under the short sampler lock. No settings, I/O,
 * window changes, power changes, or timer rearming. Missing samples are NaN. */
void photodiode_snapshot(struct photodiode_sample_snapshot out[PHOTODIODE_CHANNEL_COUNT]);

/** Wait for ADC completion (binary wakeup only, no queued readings). */
int photodiode_wait_for_sample(k_timeout_t timeout);

/** Inhibit both channels' noise warnings before an input-changing operation.
 * Pair every begin with end, including failed/partial operations. Calls may
 * overlap or nest. Uses a short spinlock; no sleeping, I/O, or publication.
 * Sampling, measurement windows, and dark-capture eligibility are unaffected.
 */
void photodiode_noise_change_begin(void);

/** Finish an input-changing operation and restart the five-second noise grace.
 * Once all operations finish, warnings require a full diagnostic window of
 * acquisitions begun after that grace. Same non-sleeping contract as begin.
 */
void photodiode_noise_change_end(void);

/**
 * @brief Convert dark-subtracted ADC millivolts to optical power in uW.
 *
 * Requires non-null, validated channel settings: positive responsivity (A/W)
 * and effective transimpedance (V/A, including the ADC divider). Converts to
 * incident optical power at the PD, before return-path correction. Negative
 * net millivolts clip to zero; NaN propagates. Overrange voltage still converts
 * numerically; the caller interprets its saturation flag. Performs no I/O.
 */
double photodiode_power_uw_from_mv(double net_mv,
				   const struct app_pd_channel_settings *settings);

/** Nearest nominal-laser power multiplier for this detector and wavelength.
 * Uses typical vendor response curves, normalized to the compiled reference
 * responsivity. Pure lookup; invalid channel/wavelength returns NaN. The sampler
 * has no source identity and does not choose a wavelength itself.
 */
double photodiode_wavelength_coefficient(enum photodiode_channel channel, double wavelength_nm);

/** Convert net ADC mV to wavelength-corrected incident PD power in uW.
 * Uses the channel's fixed response multiplier and validated app gain/settings.
 * The effective gain already includes the PCB divider. Clips negative voltage
 * to zero, propagates NaN, and performs no I/O or state changes.
 */
double photodiode_power_uw_from_mv_at_wavelength(
    enum photodiode_channel channel,
    double net_mv,
    double wavelength_nm,
    const struct app_pd_channel_settings *settings);

/** @brief Validate app-owned photodiode response/dark settings. Performs no I/O. */
bool photodiode_settings_valid(const struct app_pd_channel_settings *settings);

/**
 * @brief Set the per-channel internal configurable moving-window duration.
 *
 * Zero requests the shortest supported one-sample window. The implementation
 * rounds to the nearest whole sample and clamps to the maximum dark/window
 * duration. Changing duration closes the current configurable window into
 * last_configurable_window and starts a fresh current window, even when the
 * duration is unchanged. Conversions begun before reset are excluded.
 * Returns the accepted duration in ms (positive), or a negative errno.
 */
int photodiode_set_configurable_window_duration(enum photodiode_channel channel,
						uint32_t duration_ms);

/**
 * @brief Start a sampler-owned dark capture using the configurable window.
 *
 * The command returns immediately after arming the capture. The sampler commits
 * the completed configurable window as dark when the requested sample count is
 * reached, after 10 continuous seconds with PD power on and relevant lasers
 * off. No settling samples enter the capture. A state interruption discards
 * the window and restarts settling. Manual emitters reject the request.
 * Optional saving happens in the sampler; failures warn without discarding
 * the new RAM dark.
 */
int photodiode_start_dark_capture(enum photodiode_channel channel,
				  uint32_t duration_ms,
				  bool persist,
				  bool reset_lowest);

/** Force a dark value; reset_lowest is rejected without mutation. Optional NVS
 * writes may block and return errors after RAM application, without rollback. */
int photodiode_force_dark(enum photodiode_channel channel,
			  double mean_mv,
			  double rms_mv,
			  bool persist,
			  bool reset_lowest);

/** Reset lowest dark to the active measured dark; forced/default darks fail.
 * Optional NVS writes may block; save failures leave the RAM reset applied. */
int photodiode_reset_lowest_dark(enum photodiode_channel channel,
				 bool persist);

#endif //PHOTODIODE_H
