COO-Utilities/hispec-tib/app/src/app_settings.c

/**
 * @file app_settings.c
 * @brief Runtime defaults and direct-NVS persistence for app-owned settings.
 *
 * Public update helpers copy into the protected runtime snapshot. When
 * persistence is requested they write fixed numeric Zephyr NVS records and may block
 * on flash I/O. The app owns this fixed NVS ID map; no string setting names
 * are stored in flash.
 *
 * Copyright (c) 2026 Caltech Optical Observatories
 * SPDX-License-Identifier: Apache-2.0
 */

#include "app_settings.h"
#include "attenuator.h"
#include "devices.h"
#include "lasers.h"
#include "photodiode.h"

#include <errno.h>
#include <stdlib.h>
#include <string.h>
#include <zephyr/device.h>
#include <zephyr/drivers/flash.h>
#include <zephyr/kernel.h>
#include <zephyr/kvss/nvs.h>
#include <zephyr/logging/log.h>
#include <zephyr/storage/flash_map.h>
#include <zephyr/sys/util.h>

LOG_MODULE_REGISTER(app_settings, LOG_LEVEL_INF);

#define APP_NVS_SCHEMA_MAGIC 0x48535653U /* "HSVS" */
/* Reset app NVS for the generic source spelling and smaller route-loss table.
 * The existing schema reset discards all old app settings; no records migrate. */
#define APP_NVS_SCHEMA_VERSION 14U

enum app_nvs_id {
	APP_NVS_ID_SCHEMA = 0x0001,
	APP_NVS_ID_BOARD_TYPE = 0x0002,
	APP_NVS_ID_SERIAL_HOLDOFF_UNUSED = 0x0003,
	APP_NVS_ID_BOOT_COUNT = 0x0004,
	APP_NVS_ID_IP = 0x0005,
	APP_NVS_ID_MQTT = 0x0006,
	APP_NVS_ID_LASERBANK = 0x0007,
	APP_NVS_ID_LAST_KNOWN_UTC_UNUSED = 0x0008, /* Reserved for OTA rollback. */
	APP_NVS_ID_LAST_COMMAND_UNUSED = 0x0009, /* Command history is boot-local. */
	APP_NVS_ID_ATTEN_CH0 = 0x0100,
	APP_NVS_ID_ATTEN_FIT_CH0 = 0x0140,
	APP_NVS_ID_ATTEN_OPEN_CH0 = 0x0180,
	APP_NVS_ID_PD_CH0 = 0x0200,
	APP_NVS_ID_PD_POWER_CH0 = 0x0240,
	APP_NVS_ID_LASER_POLICY_CH0 = 0x0300,
	APP_NVS_ID_LASER_TOTAL_CH0 = 0x0340,
	APP_NVS_ID_LASER_NTC_CH0 = 0x0380,
	APP_NVS_ID_LASER_REF_CH0 = 0x03c0,
	APP_NVS_ID_LASER_AUTO_MAX_CH0 = 0x03e0,
	APP_NVS_ID_ROUTE_LOSS_CH0 = 0x0400,
	APP_NVS_ID_MEMS = 0x0500,
};

BUILD_ASSERT(APP_NVS_ID_ROUTE_LOSS_CH0 + APP_ROUTE_LOSS_RECORD_COUNT < 0x8000,
	     "app NVS IDs must stay below Zephyr settings backend IDs");
BUILD_ASSERT(APP_NVS_ID_ATTEN_CH0 + APP_ATTENUATOR_CHANNEL_COUNT <= APP_NVS_ID_ATTEN_FIT_CH0,
	     "attenuator coefficient NVS block overlaps fit policy block");
BUILD_ASSERT(APP_NVS_ID_ATTEN_FIT_CH0 + APP_ATTENUATOR_CHANNEL_COUNT <= APP_NVS_ID_ATTEN_OPEN_CH0,
	     "attenuator fit policy NVS block overlaps open settings block");
BUILD_ASSERT(APP_NVS_ID_ATTEN_OPEN_CH0 + APP_ATTENUATOR_CHANNEL_COUNT <= APP_NVS_ID_PD_CH0,
	     "attenuator open settings NVS block overlaps photodiode block");
BUILD_ASSERT(APP_NVS_ID_PD_CH0 + APP_PD_CHANNEL_COUNT <= APP_NVS_ID_PD_POWER_CH0,
	     "photodiode NVS block overlaps power state block");
BUILD_ASSERT(APP_NVS_ID_PD_POWER_CH0 + APP_PD_CHANNEL_COUNT <= APP_NVS_ID_LASER_POLICY_CH0,
	     "photodiode NVS ID block overlaps laser policy block");
BUILD_ASSERT(APP_NVS_ID_LASER_POLICY_CH0 + APP_LASER_CHANNEL_COUNT <= APP_NVS_ID_LASER_TOTAL_CH0,
	     "laser policy NVS ID block overlaps laser total block");
BUILD_ASSERT(APP_NVS_ID_LASER_TOTAL_CH0 + APP_LASER_CHANNEL_COUNT <= APP_NVS_ID_LASER_NTC_CH0,
	     "laser total NVS ID block overlaps NTC block");
BUILD_ASSERT(APP_NVS_ID_LASER_NTC_CH0 + APP_LASER_CHANNEL_COUNT <= APP_NVS_ID_LASER_REF_CH0,
	     "laser NTC NVS ID block overlaps reference block");
BUILD_ASSERT(APP_NVS_ID_LASER_REF_CH0 + APP_LASER_CHANNEL_COUNT <= APP_NVS_ID_LASER_AUTO_MAX_CH0,
	     "laser reference NVS ID block overlaps autolevel ceiling block");
BUILD_ASSERT(APP_NVS_ID_LASER_AUTO_MAX_CH0 + APP_LASER_CHANNEL_COUNT <= APP_NVS_ID_ROUTE_LOSS_CH0,
	     "laser autolevel ceiling NVS ID block overlaps route-loss block");
BUILD_ASSERT(APP_NVS_ID_ROUTE_LOSS_CH0 + APP_ROUTE_LOSS_RECORD_COUNT <= APP_NVS_ID_MEMS,
	     "route-loss NVS ID block overlaps MEMS settings");
BUILD_ASSERT(APP_NVS_ID_MEMS < 0x8000,
	     "MEMS NVS ID overlaps reserved Zephyr settings IDs");
BUILD_ASSERT(APP_ATTENUATOR_PHYSICAL_COUNT == ATTENUATOR_PHYSICAL_COUNT,
	     "app settings and attenuator physical coefficient counts must match");
BUILD_ASSERT(APP_LASER_CHANNEL_COUNT == HISPEC_LASER_COUNT,
	     "app settings and laser channel counts must match");

struct app_nvs_schema_marker {
	uint32_t magic;
	uint16_t version;
	uint16_t reserved;
};

struct app_nvs_ip_settings {
	uint8_t try_dhcp_first;
	uint8_t prefer_dhcp_dns;
	uint8_t prefer_dhcp_ntp;
	uint8_t reserved;
	char ip[NET_IPV4_ADDR_LEN];
	char subnet[NET_IPV4_ADDR_LEN];
	char gateway[NET_IPV4_ADDR_LEN];
	char dns[NET_IPV4_ADDR_LEN];
	char ntp[NET_IPV4_ADDR_LEN];
};

struct app_nvs_pd_channel {
	struct app_pd_dark_result dark;
	struct app_pd_dark_result lowest_dark;
	uint8_t lowest_dark_valid;
	uint8_t power;
	uint8_t reserved[2];
	double noise_warn_rms_mv;
	double responsivity_a_per_w;
	double transimpedance_v_per_a;
	uint32_t autooff_s;
};

struct app_nvs_laser_policy {
	double nominal_current_ma;
	double max_current_ma;
	double threshold_current_ma;
	double min_autolevel_current_ma;
	double efficiency_mw_per_ma;
	double wave_ref_nm;
	double current_cal_pct;
	double fractional_noise;
	double constant_noise_mw;
	double operating_temp_min_c;
	double operating_temp_max_c;
	double operating_temp_c;
	uint16_t tec_pid_p;
	uint16_t tec_pid_i;
	uint16_t tec_pid_d;
	uint8_t disable_tec_at_autooff;
	uint8_t reserved;
	double dlambda_dT_nm_per_k;
	double dlambda_dA_nm_per_ma;
	uint32_t autooff_s;
	double tune_delta_nm;
	uint16_t expected_serial;
	uint16_t reserved2;
	float efficiency_mw_per_ma2;
	/* The installed curve owns its reference independently of the vendor triplet. */
	double efficiency_ref_ma;
	/* Independent wavelength measurement coordinates, not operating limits. */
	double wave_ref_ma;
	double wave_ref_temp_c;
};

BUILD_ASSERT(sizeof(struct app_nvs_laser_policy) == 168);
BUILD_ASSERT(offsetof(struct app_nvs_laser_policy, efficiency_mw_per_ma2) == 140);
BUILD_ASSERT(offsetof(struct app_nvs_laser_policy, efficiency_ref_ma) == 144);

static const laserprops_t *const default_laser_props[APP_LASER_CHANNEL_COUNT] = {
	&LASER_1028,
	&LASER_1270,
	&LASER_1430YJ,
	&LASER_1430HK,
	&LASER_1510,
	&LASER_2330,
};

static const uint16_t default_laser_expected_serial[APP_LASER_CHANNEL_COUNT] = {
	8229U,
	8228U,
	8222U,
	8227U,
	8225U,
	8226U,
};

struct app_settings_state {
	struct app_settings_snapshot snapshot;
	bool pd_power_saved[APP_PD_CHANNEL_COUNT];
	struct k_mutex lock;
};

static struct app_settings_state g_settings;
static struct nvs_fs app_nvs;
static bool app_nvs_ready;

static uint16_t attenuator_nvs_id(uint8_t channel)
{
	return APP_NVS_ID_ATTEN_CH0 + channel;
}

static uint16_t pd_nvs_id(uint8_t channel)
{
	return APP_NVS_ID_PD_CH0 + channel;
}

static uint16_t laser_policy_nvs_id(uint8_t channel)
{
	return APP_NVS_ID_LASER_POLICY_CH0 + channel;
}

static uint16_t laser_total_nvs_id(uint8_t channel)
{
	return APP_NVS_ID_LASER_TOTAL_CH0 + channel;
}

/* Separate coefficient record leaves existing channel policy/calibration intact. */
static uint16_t laser_ntc_nvs_id(uint8_t channel)
{
	return APP_NVS_ID_LASER_NTC_CH0 + channel;
}

static uint16_t route_loss_nvs_id(uint8_t index)
{
	return APP_NVS_ID_ROUTE_LOSS_CH0 + index;
}

static void str_set(char *dst, size_t dst_size, const char *src)
{
	if (dst == NULL || dst_size == 0) {
		return;
	}

	if (src == NULL) {
		dst[0] = '\0';
		return;
	}

	strncpy(dst, src, dst_size - 1);
	dst[dst_size - 1] = '\0';
}

static bool double_in_range(double value, double min_value, double max_value)
{
	return value >= min_value && value <= max_value;
}

/* TIB commissioning defaults adopted November 4, 2026; provenance and limits
 * are recorded in doc/calibration_closeout.md. These are installed-device
 * estimates, not a generic FVOA specification. 1028 FVOA2 (DAC2) is a suspected
 * partially defective SM980: its valid residual-rejected fit was owner-adopted.
 * Keep each physical model, measured support, RMS and operational open together.
 * CAL uses the nominal model below, even though its index overlaps TIB 1510. */
static const struct {
	struct app_attenuator_channel_settings coefficients;
	struct app_attenuator_open_settings open;
} tib_attenuator_defaults[APP_ATTENUATOR_CHANNEL_COUNT] = {
	[HISPEC_LASER_1028_Y] = { .coefficients.physical = {
		{ .fvoa_50pct_mv = 3267.58709769, .slope_inv_fvoa_mv = 0.00291613889902,
		  .max_atten_db = 78.6815745036, .max_calibrated_db = 55.0,
		  .gain = 1.533, .rms_db = 0.157107,
		  .correction_coeff = {-35.4575806f, -8.20566654f, -47.8860016f, 13.433301f, -3.19593811f, 8.80530834f} },
		{ .fvoa_50pct_mv = 3081.94537248, .slope_inv_fvoa_mv = 0.00244188220422,
		  .max_atten_db = 77.5730895996, .max_calibrated_db = 55.0,
		  .gain = 1.533, .rms_db = 1.16084,
		  .correction_coeff = {-25.4668446f, -12.3096495f, -36.9585686f, 3.61601472f, 8.17603397f, 0.0f} },
	}, .open.mv = {2200.2685546875f, 1946.484375f} },
	[HISPEC_LASER_1270_J] = { .coefficients.physical = {
		{ .fvoa_50pct_mv = 2451.86063822, .slope_inv_fvoa_mv = 0.00176207270219,
		  .max_atten_db = 71.3910420736, .max_calibrated_db = 49.107145,
		  .gain = 1.533, .rms_db = 0.370472,
		  .correction_coeff = {-132.764404f, -268.12381f, -186.41777f, -137.26062f, -54.5727539f, -25.1429424f} },
		{ .fvoa_50pct_mv = 2974.83389956, .slope_inv_fvoa_mv = 0.00208512922125,
		  .max_atten_db = 65.0, .max_calibrated_db = 46.2900502,
		  .gain = 1.533, .rms_db = 0.311365,
		  .correction_coeff = {-52.7308044f, -110.589073f, -74.6008301f, -59.038456f, -20.9809341f, -13.8418264f} },
	}, .open.mv = {1064.2822265625f, 1550.9033203125f} },
	[HISPEC_LASER_1430_YJ] = { .coefficients.physical = {
		{ .fvoa_50pct_mv = 2509.71305074, .slope_inv_fvoa_mv = 0.00158560327333,
		  .max_atten_db = 65.0, .max_calibrated_db = 39.2999218,
		  .gain = 1.533, .rms_db = 0.496393,
		  .correction_coeff = {46.9840889f, 72.9479065f, 61.1570473f, 24.4725075f, 15.0455141f, 0.0f} },
		{ .fvoa_50pct_mv = 2609.22926199, .slope_inv_fvoa_mv = 0.00161651587979,
		  .max_atten_db = 65.0, .max_calibrated_db = 41.8378934,
		  .gain = 1.533, .rms_db = 0.168888,
		  .correction_coeff = {-53.6330338f, -101.508453f, -71.6782227f, -45.5498734f, -17.246769f, -6.57673454f} },
	}, .open.mv = {1129.541015625f, 1106.1767578125f} },
	[HISPEC_LASER_1430_HK] = { .coefficients.physical = {
		{ .fvoa_50pct_mv = 3033.94736564, .slope_inv_fvoa_mv = 0.00192345464227,
		  .max_atten_db = 65.0, .max_calibrated_db = 23.4327544,
		  .gain = 1.533, .rms_db = 0.0854788,
		  .correction_coeff = {625.920044f, 1063.35681f, 652.318909f, 262.374634f, 61.0879402f, 0.0f} },
		{ .fvoa_50pct_mv = 2806.67131921, .slope_inv_fvoa_mv = 0.00180117158801,
		  .max_atten_db = 65.0, .max_calibrated_db = 26.1613334,
		  .gain = 1.533, .rms_db = 0.131623,
		  .correction_coeff = {438.154419f, 750.448669f, 479.965668f, 204.605667f, 54.5648003f, 0.0f} },
	}, .open.mv = {1465.5029296875f, 1253.61328125f} },
	[HISPEC_LASER_1510_H] = { .coefficients.physical = {
		{ .fvoa_50pct_mv = 2982.14792957, .slope_inv_fvoa_mv = 0.00264308415227,
		  .max_atten_db = 65.0, .max_calibrated_db = 23.3990529,
		  .gain = 1.533, .rms_db = 0.0748628,
		  .correction_coeff = {-825.457153f, -1412.4231f, -894.704041f, -377.211792f, -96.2924042f, 0.0f} },
		{ .fvoa_50pct_mv = 2530.25645898, .slope_inv_fvoa_mv = 0.0016937314027,
		  .max_atten_db = 65.0, .max_calibrated_db = 30.3510789,
		  .gain = 1.533, .rms_db = 0.220064,
		  .correction_coeff = {-1426.29175f, -2544.18604f, -1758.30408f, -932.092041f, -337.762115f, -76.131897f} },
	}, .open.mv = {1801.46484375f, 1266.50390625f} },
	[HISPEC_LASER_2330_K] = { .coefficients.physical = {
		{ .fvoa_50pct_mv = 2565.73732958, .slope_inv_fvoa_mv = 0.00107511774954,
		  .max_atten_db = 65.0, .max_calibrated_db = 22.1636632,
		  .gain = 1.533, .rms_db = 0.10974,
		  .correction_coeff = {431.258392f, 739.282837f, 467.325714f, 197.530975f, 49.6572304f, 0.0f} },
		{ .fvoa_50pct_mv = 2893.81873549, .slope_inv_fvoa_mv = 0.00114684028293,
		  .max_atten_db = 65.0, .max_calibrated_db = 17.9806207,
		  .gain = 1.533, .rms_db = 0.0898274,
		  .correction_coeff = {4171.396f, 7021.07666f, 4113.32764f, 1545.52319f, 299.686249f, 0.0f} },
	}, .open.mv = {641.30859375f, 978.8818359375f} },
};

/* Seed a board's attenuator defaults before loading coefficient/open overrides.
 * Pure snapshot updates; callers own initialization or the settings mutex. */
static void attenuator_defaults(struct app_settings_snapshot *s, const char *board)
{
	for (uint8_t ch = 0; ch < APP_ATTENUATOR_CHANNEL_COUNT; ++ch) {
		for (uint8_t physical = 0; physical < APP_ATTENUATOR_PHYSICAL_COUNT; ++physical) {
			s->attenuator_fit[ch].max_fit_residual_db[physical] = 2.0;
			/* Nominal 0-3300 mV DAC span centers the half-shutter point
			 * until device-specific defaults or a saved calibration apply. */
			s->attenuator.channel[ch].physical[physical] =
				(struct app_attenuator_physical_settings){
					.fvoa_50pct_mv = 0.5 * (double)ATTENUATOR_DRIVE_MAX_MV * ATTENUATOR_DEFAULT_GAIN,
					.slope_inv_fvoa_mv = 8.0 / ((double)ATTENUATOR_DRIVE_MAX_MV * ATTENUATOR_DEFAULT_GAIN),
					.max_atten_db = FVOA_DEFAULT_MAX_ATTEN_DB,
					.max_calibrated_db = MIN(ATTENUATOR_CALIBRATED_MAX_DB, FVOA_DEFAULT_MAX_ATTEN_DB),
					.gain = ATTENUATOR_DEFAULT_GAIN,
					.rms_db = ATTENUATOR_DEFAULT_RMS_DB,
				};
			s->attenuator_open[ch].mv[physical] = ATTENUATOR_DEFAULT_OPEN_MV;
		}
		if (strcmp(board, "tib") == 0) {
			s->attenuator.channel[ch] = tib_attenuator_defaults[ch].coefficients;
			s->attenuator_open[ch] = tib_attenuator_defaults[ch].open;
		}
	}
}

static void settings_defaults(struct app_settings_snapshot *s)
{
	unsigned long broker_port = 1883UL;
	const char *default_port_str = CONFIG_COO_MQTT_BROKER_PORT;
	char *end = NULL;

	memset(s, 0, sizeof(*s));

	str_set(s->board_type, sizeof(s->board_type), "");
	s->ip.try_dhcp_first = true;
	s->ip.prefer_dhcp_dns = true;
	s->ip.prefer_dhcp_ntp = true;
	str_set(s->ip.ip, sizeof(s->ip.ip), CONFIG_NET_CONFIG_MY_IPV4_ADDR);
	str_set(s->ip.subnet, sizeof(s->ip.subnet), CONFIG_NET_CONFIG_MY_IPV4_NETMASK);
	str_set(s->ip.gateway, sizeof(s->ip.gateway), CONFIG_NET_CONFIG_MY_IPV4_GW);
	str_set(s->ip.dns, sizeof(s->ip.dns), CONFIG_APP_DEFAULT_DNS_SERVER);
	str_set(s->ip.ntp, sizeof(s->ip.ntp), CONFIG_APP_DEFAULT_NTP_SERVER);
	broker_port = strtoul(default_port_str, &end, 10);
	if (end == NULL || end == default_port_str || *end != '\0' || broker_port > UINT16_MAX) {
		broker_port = 1883UL;
	}
	str_set(s->mqtt.broker_host, sizeof(s->mqtt.broker_host), CONFIG_COO_MQTT_BROKER_HOSTNAME);
	s->mqtt.broker_port = (uint16_t)broker_port;
	attenuator_defaults(s, "");
	s->photodiode.channel[PHOTODIODE_CHANNEL_YJ].dark =
		(struct app_pd_dark_result){
			.mean_mv = PHOTODIODE_DEFAULT_DARK_MV,
			.rms_mv = PHOTODIODE_DEFAULT_DARK_NOISE_RMS_MV,
			.min_mv = PHOTODIODE_DEFAULT_DARK_MV,
			.max_mv = PHOTODIODE_DEFAULT_DARK_MV,
		};
	s->photodiode.channel[PHOTODIODE_CHANNEL_YJ].lowest_dark =
		(struct app_pd_dark_result){
			.mean_mv = PHOTODIODE_DEFAULT_LOWEST_DARK_MV,
			.rms_mv = PHOTODIODE_DEFAULT_DARK_NOISE_RMS_MV,
			.min_mv = PHOTODIODE_DEFAULT_LOWEST_DARK_MV,
			.max_mv = PHOTODIODE_DEFAULT_LOWEST_DARK_MV,
		};
	s->photodiode.channel[PHOTODIODE_CHANNEL_YJ].lowest_dark_valid = false;
	s->photodiode.channel[PHOTODIODE_CHANNEL_YJ].noise_warn_rms_mv =
		PHOTODIODE_YJ_DEFAULT_NOISE_WARN_RMS_MV;
	s->photodiode.channel[PHOTODIODE_CHANNEL_YJ].responsivity_a_per_w =
		PHOTODIODE_YJ_DEFAULT_RESPONSIVITY_A_PER_W;
	s->photodiode.channel[PHOTODIODE_CHANNEL_YJ].transimpedance_v_per_a =
		PHOTODIODE_YJ_DEFAULT_TRANSIMPEDANCE_V_PER_A;
	s->photodiode.channel[PHOTODIODE_CHANNEL_YJ].power = APP_PD_POWER_AUTO;
	s->photodiode.channel[PHOTODIODE_CHANNEL_YJ].autooff_s = APP_PD_DEFAULT_AUTOOFF_S;
	s->photodiode.channel[PHOTODIODE_CHANNEL_HK].dark =
		(struct app_pd_dark_result){
			.mean_mv = PHOTODIODE_DEFAULT_DARK_MV,
			.rms_mv = PHOTODIODE_DEFAULT_DARK_NOISE_RMS_MV,
			.min_mv = PHOTODIODE_DEFAULT_DARK_MV,
			.max_mv = PHOTODIODE_DEFAULT_DARK_MV,
		};
	s->photodiode.channel[PHOTODIODE_CHANNEL_HK].lowest_dark =
		(struct app_pd_dark_result){
			.mean_mv = PHOTODIODE_DEFAULT_LOWEST_DARK_MV,
			.rms_mv = PHOTODIODE_DEFAULT_DARK_NOISE_RMS_MV,
			.min_mv = PHOTODIODE_DEFAULT_LOWEST_DARK_MV,
			.max_mv = PHOTODIODE_DEFAULT_LOWEST_DARK_MV,
		};
	s->photodiode.channel[PHOTODIODE_CHANNEL_HK].lowest_dark_valid = false;
	s->photodiode.channel[PHOTODIODE_CHANNEL_HK].noise_warn_rms_mv =
		PHOTODIODE_HK_DEFAULT_NOISE_WARN_RMS_MV;
	s->photodiode.channel[PHOTODIODE_CHANNEL_HK].responsivity_a_per_w =
		PHOTODIODE_HK_DEFAULT_RESPONSIVITY_A_PER_W;
	s->photodiode.channel[PHOTODIODE_CHANNEL_HK].transimpedance_v_per_a =
		PHOTODIODE_HK_DEFAULT_TRANSIMPEDANCE_V_PER_A;
	s->photodiode.channel[PHOTODIODE_CHANNEL_HK].power = APP_PD_POWER_AUTO;
	s->photodiode.channel[PHOTODIODE_CHANNEL_HK].autooff_s = APP_PD_DEFAULT_AUTOOFF_S;
	s->laserbank.heater_mode = LASERBANK_HEATER_MODE_AUTO;
	for (uint8_t i = 0U; i < APP_LASER_CHANNEL_COUNT; ++i) {
		s->laser.channel[i].properties = *default_laser_props[i];
		double minimum = default_laser_props[i]->threshold_current_ma + 1.0 / DIVIDER_CURRENT;
		s->laser.channel[i].min_autolevel_current_ma = hispec_laser_quantize_current_ma(
			minimum, minimum, default_laser_props[i]->nominal_current_ma);
		s->laser.channel[i].max_autolevel_current_ma = default_laser_props[i]->nominal_current_ma;
		s->laser.channel[i].current_cal_pct = 100.0;
		s->laser.channel[i].fractional_noise = hispec_laser_default_fractional_noise[i];
		/* Owner policy adopts only fractional calibration noise as a default. */
		s->laser.channel[i].constant_noise_mw = 0.0;
		s->laser.channel[i].expected_serial = default_laser_expected_serial[i];
		s->laser.channel[i].disable_tec_at_autooff = true;
		s->laser.channel[i].autooff_s = 3U * 3600U;
		s->laser.channel[i].tune_delta_nm = 0.0;
		s->laser.channel[i].total_emitting_s = 0.0;
	}
	s->boot_count = 0U;
	s->mqtt_revision = 0U;
}

static int app_nvs_mount(void)
{
	struct flash_pages_info page_info;
	int rc;

	app_nvs.flash_device = PARTITION_DEVICE(storage_partition);
	if (!device_is_ready(app_nvs.flash_device)) {
		LOG_ERR("NVS flash device is not ready");
		return -ENODEV;
	}

	app_nvs.offset = PARTITION_OFFSET(storage_partition);
	rc = flash_get_page_info_by_offs(app_nvs.flash_device, app_nvs.offset, &page_info);
	if (rc != 0) {
		LOG_ERR("flash_get_page_info_by_offs failed (%d)", rc);
		return rc;
	}

	app_nvs.sector_size = page_info.size;
	app_nvs.sector_count = PARTITION_SIZE(storage_partition) / page_info.size;
	rc = nvs_mount(&app_nvs);
	if (rc != 0) {
		LOG_ERR("nvs_mount failed (%d)", rc);
		return rc;
	}

	app_nvs_ready = true;
	return 0;
}

static int app_nvs_write(uint16_t id, const void *data, size_t len)
{
	int rc;

	if (!app_nvs_ready) {
		return -EIO;
	}

	rc = nvs_write(&app_nvs, id, data, len);
	if (rc < 0) {
		LOG_WRN("NVS write id 0x%04x failed (%d)", id, rc);
		return rc;
	}

	return 0;
}

static int app_nvs_delete(uint16_t id)
{
	int rc;

	if (!app_nvs_ready) {
		return -EIO;
	}

	rc = nvs_delete(&app_nvs, id);
	if (rc != 0 && rc != -ENOENT) {
		LOG_WRN("NVS delete id 0x%04x failed (%d)", id, rc);
	}

	return rc == -ENOENT ? 0 : rc;
}

static bool app_nvs_read_exact(uint16_t id, void *data, size_t len, const char *name)
{
	int rc;

	if (!app_nvs_ready || data == NULL) {
		return false;
	}

	rc = nvs_read(&app_nvs, id, data, len);
	if (rc == (int)len) {
		return true;
	}
	if (rc != -ENOENT) {
		LOG_WRN("Ignoring invalid NVS %s id 0x%04x length (%d)", name, id, rc);
	}

	return false;
}

static int app_nvs_write_schema(void)
{
	const struct app_nvs_schema_marker marker = {
		.magic = APP_NVS_SCHEMA_MAGIC,
		.version = APP_NVS_SCHEMA_VERSION,
	};

	return app_nvs_write(APP_NVS_ID_SCHEMA, &marker, sizeof(marker));
}

static int app_nvs_ensure_schema(void)
{
	struct app_nvs_schema_marker marker = {0};
	int rc;

	if (app_nvs_read_exact(APP_NVS_ID_SCHEMA, &marker, sizeof(marker), "schema") &&
	    marker.magic == APP_NVS_SCHEMA_MAGIC &&
	    marker.version == APP_NVS_SCHEMA_VERSION) {
		return 0;
	}

	LOG_INF("Initializing app NVS schema %u; clearing old storage layout",
		APP_NVS_SCHEMA_VERSION);
	rc = nvs_clear(&app_nvs);
	if (rc != 0) {
		LOG_ERR("nvs_clear failed (%d)", rc);
		app_nvs_ready = false;
		return rc;
	}

	app_nvs_ready = false;
	rc = app_nvs_mount();
	if (rc != 0) {
		return rc;
	}

	return app_nvs_write_schema();
}

static void app_nvs_persist_board_type(const char *board_type)
{
	char value[APP_SETTINGS_BOARD_TYPE_MAX_LEN] = {0};

	str_set(value, sizeof(value), board_type);
	(void)app_nvs_write(APP_NVS_ID_BOARD_TYPE, value, sizeof(value));
}

static void app_nvs_persist_ip(const struct app_ip_settings *ip)
{
	struct app_nvs_ip_settings stored = {0};

	if (ip == NULL) {
		return;
	}

	stored.try_dhcp_first = ip->try_dhcp_first ? 1U : 0U;
	stored.prefer_dhcp_dns = ip->prefer_dhcp_dns ? 1U : 0U;
	stored.prefer_dhcp_ntp = ip->prefer_dhcp_ntp ? 1U : 0U;
	str_set(stored.ip, sizeof(stored.ip), ip->ip);
	str_set(stored.subnet, sizeof(stored.subnet), ip->subnet);
	str_set(stored.gateway, sizeof(stored.gateway), ip->gateway);
	str_set(stored.dns, sizeof(stored.dns), ip->dns);
	str_set(stored.ntp, sizeof(stored.ntp), ip->ntp);
	(void)app_nvs_write(APP_NVS_ID_IP, &stored, sizeof(stored));
}

static void app_nvs_persist_mqtt(const struct app_mqtt_settings *mqtt)
{
	struct app_mqtt_settings stored = {0};

	if (mqtt == NULL) {
		return;
	}

	str_set(stored.broker_host, sizeof(stored.broker_host), mqtt->broker_host);
	stored.broker_port = mqtt->broker_port;
	(void)app_nvs_write(APP_NVS_ID_MQTT, &stored, sizeof(stored));
}

static void app_nvs_persist_attenuator_channel(uint8_t channel,
					       const struct app_attenuator_channel_settings *atten)
{
	if (atten == NULL || channel >= APP_ATTENUATOR_CHANNEL_COUNT) {
		return;
	}

	(void)app_nvs_write(attenuator_nvs_id(channel), atten, sizeof(*atten));
}

static void app_nvs_persist_pd_channel(uint8_t channel,
				       const struct app_pd_channel_settings *pd)
{
	struct app_nvs_pd_channel stored = {0};

	if (pd == NULL || channel >= APP_PD_CHANNEL_COUNT) {
		return;
	}

	stored.dark = pd->dark;
	stored.lowest_dark = pd->lowest_dark;
	stored.lowest_dark_valid = pd->lowest_dark_valid ? 1U : 0U;
	stored.noise_warn_rms_mv = pd->noise_warn_rms_mv;
	stored.responsivity_a_per_w = pd->responsivity_a_per_w;
	stored.transimpedance_v_per_a = pd->transimpedance_v_per_a;
	stored.power = (uint8_t)pd->power;
	stored.autooff_s = pd->autooff_s;
	(void)app_nvs_write(pd_nvs_id(channel), &stored, sizeof(stored));
}

static void laser_policy_from_settings(struct app_nvs_laser_policy *stored,
				       const struct app_laser_channel_settings *laser)
{
	if (stored == NULL || laser == NULL) {
		return;
	}

	memset(stored, 0, sizeof(*stored));
	stored->nominal_current_ma = laser->properties.nominal_current_ma;
	stored->max_current_ma = laser->properties.max_current_ma;
	stored->threshold_current_ma = laser->properties.threshold_current_ma;
	stored->min_autolevel_current_ma = laser->min_autolevel_current_ma;
	stored->efficiency_mw_per_ma = laser->properties.efficiency_mw_per_ma;
	stored->efficiency_mw_per_ma2 = laser->properties.efficiency_mw_per_ma2;
	stored->efficiency_ref_ma = laser->properties.efficiency_ref_ma;
	stored->wave_ref_nm = laser->properties.wave_ref_nm;
	stored->wave_ref_ma = laser->properties.wave_ref_ma;
	stored->wave_ref_temp_c = laser->properties.wave_ref_temp_c;
	stored->current_cal_pct = laser->current_cal_pct;
	stored->fractional_noise = laser->fractional_noise;
	stored->constant_noise_mw = laser->constant_noise_mw;
	stored->operating_temp_min_c = laser->properties.operating_temp_range_c.min_c;
	stored->operating_temp_max_c = laser->properties.operating_temp_range_c.max_c;
	stored->operating_temp_c = laser->properties.operating_temp_c;
	stored->tec_pid_p = laser->properties.tec_pid.kp;
	stored->tec_pid_i = laser->properties.tec_pid.ki;
	stored->tec_pid_d = laser->properties.tec_pid.kd;
	stored->expected_serial = laser->expected_serial;
	stored->disable_tec_at_autooff = laser->disable_tec_at_autooff ? 1U : 0U;
	stored->dlambda_dT_nm_per_k = laser->properties.dlambda_dT_nm_per_k;
	stored->dlambda_dA_nm_per_ma = laser->properties.dlambda_dA_nm_per_ma;
	stored->autooff_s = laser->autooff_s;
	stored->tune_delta_nm = laser->tune_delta_nm;
}

/* Attempt every record and return the first flash error. RAM has already been
 * applied; callers must not describe a partial NVS write as a rollback.
 * Called with validated channel/settings. May block on separate NVS writes;
 * this is neither a hardware update nor an atomic flash transaction. */
static int app_nvs_persist_laser_channel(uint8_t channel,
					 const struct app_laser_channel_settings *laser)
{
	struct app_nvs_laser_policy stored;
	double reference[3] = {
		laser->properties.ref_mw,
		laser->properties.ref_ma,
		laser->properties.ref_temp_c,
	};

	laser_policy_from_settings(&stored, laser);
	int first = app_nvs_write(laser_policy_nvs_id(channel), &stored, sizeof(stored));
	int rc = app_nvs_write(laser_ntc_nvs_id(channel), &laser->properties.ntc_coeff_pct_per_c,
			      sizeof(laser->properties.ntc_coeff_pct_per_c));
	if (first == 0) {
		first = rc;
	}

	rc = app_nvs_write(APP_NVS_ID_LASER_REF_CH0 + channel, reference, sizeof(reference));
	if (first == 0) {
		first = rc;
	}
	/* Separate record keeps the existing calibrated policy layout intact. */
	rc = app_nvs_write(APP_NVS_ID_LASER_AUTO_MAX_CH0 + channel,
			   &laser->max_autolevel_current_ma, sizeof(laser->max_autolevel_current_ma));
	if (first == 0) {
		first = rc;
	}

	rc = app_nvs_write(laser_total_nvs_id(channel), &laser->total_emitting_s,
			   sizeof(laser->total_emitting_s));
	return first != 0 ? first : rc;
}

static void app_nvs_persist_laser_total(uint8_t channel, double total_emitting_s)
{
	if (channel >= APP_LASER_CHANNEL_COUNT) {
		return;
	}

	(void)app_nvs_write(laser_total_nvs_id(channel),
			    &total_emitting_s,
			    sizeof(total_emitting_s));
}

static void app_nvs_persist_laserbank(const struct app_laserbank_settings *laserbank)
{
	uint32_t mode;

	if (laserbank == NULL) {
		return;
	}

	mode = (uint32_t)laserbank->heater_mode;
	(void)app_nvs_write(APP_NVS_ID_LASERBANK, &mode, sizeof(mode));
}

/* Persist the already-applied route override in its assigned slot. May block
 * on NVS; returning an error does not undo the caller's RAM change. */
static int app_nvs_persist_route_loss_index(uint8_t index,
					     const struct app_route_loss_record *record)
{
	if (record == NULL || index >= APP_ROUTE_LOSS_RECORD_COUNT) {
		return -EINVAL;
	}

	return app_nvs_write(route_loss_nvs_id(index), record, sizeof(*record));
}

static bool attenuator_channel_valid(const struct app_attenuator_channel_settings *atten)
{
	struct attenuator_model_coeffs physical[ATTENUATOR_PHYSICAL_COUNT];

	if (atten == NULL) {
		return false;
	}

	for (uint8_t i = 0U; i < APP_ATTENUATOR_PHYSICAL_COUNT; ++i) {
		const struct app_attenuator_physical_settings *p = &atten->physical[i];

		physical[i].fvoa_50pct_mv = p->fvoa_50pct_mv;
		physical[i].slope_inv_fvoa_mv = p->slope_inv_fvoa_mv;
		physical[i].max_atten_db = p->max_atten_db;
		physical[i].max_calibrated_db = p->max_calibrated_db;
		physical[i].gain = p->gain;
		physical[i].rms_db = p->rms_db;
		memcpy(physical[i].correction_coeff, p->correction_coeff,
		       sizeof(physical[i].correction_coeff));
	}

	return attenuator_model_coefficients_valid(physical);
}

static void pd_settings_from_nvs(struct app_pd_channel_settings *pd,
				 const struct app_nvs_pd_channel *stored)
{
	if (pd == NULL || stored == NULL) {
		return;
	}

	pd->dark = stored->dark;
	pd->lowest_dark = stored->lowest_dark;
	pd->lowest_dark_valid = stored->lowest_dark_valid != 0U;
	pd->noise_warn_rms_mv = stored->noise_warn_rms_mv;
	pd->responsivity_a_per_w = stored->responsivity_a_per_w;
	pd->transimpedance_v_per_a = stored->transimpedance_v_per_a;
	pd->power = (enum app_pd_power_mode)stored->power;
	pd->autooff_s = stored->autooff_s;
}

static bool route_loss_record_valid(struct app_route_loss_record *record)
{
	if (record == NULL || !record->configured) {
		return false;
	}

	record->route[sizeof(record->route) - 1U] = '\0';
	record->laser[sizeof(record->laser) - 1U] = '\0';
	return record->route[0] != '\0' &&
	       record->laser[0] != '\0' &&
	       (record->transmission > 0.0 && record->transmission <= 1.0);
}

static bool mems_state_valid(char state)
{
	return state == 'A' || state == 'B';
}

static bool mems_settings_valid(const struct app_mems_settings *mems)
{
	if (mems == NULL) {
		return false;
	}

	for (uint8_t i = 0U; i < APP_MEMS_SWITCH_COUNT; ++i) {
		const struct app_mems_switch_settings *sw = &mems->switch_state[i];

		if (sw->static_configured > 1U || sw->toggle_configured > 1U) {
			return false;
		}
		if (sw->static_configured != 0U && !mems_state_valid(sw->static_state)) {
			return false;
		}
		if (sw->toggle_configured != 0U &&
		    (!mems_state_valid(sw->toggle_state) ||
		     !(sw->toggle_duty_cycle > 0.0 &&
		       sw->toggle_duty_cycle < 1.0))) {
			return false;
		}
	}

	for (uint8_t ch = 0U; ch < APP_MEMS_SPLIT_CHANNEL_COUNT; ++ch) {
		const struct app_mems_split_settings *split = &mems->split[ch];
		double sum;

		if (split->configured > 1U) {
			return false;
		}
		if (split->configured == 0U) {
			continue;
		}

		sum = split->requested[0] + split->requested[1] + split->requested[2];
		for (uint8_t i = 0U; i < APP_MEMS_SPLIT_OUTPUT_COUNT; ++i) {
			if (!double_in_range(split->requested[i], 0.0, 1.0)) {
				return false;
			}
		}
		if (!double_in_range(sum, 0.999999, 1.000001)) {
			return false;
		}
	}

	return true;
}

static void app_nvs_load_board_type(struct app_settings_snapshot *s)
{
	char value[APP_SETTINGS_BOARD_TYPE_MAX_LEN] = {0};

	if (app_nvs_read_exact(APP_NVS_ID_BOARD_TYPE, value, sizeof(value), "board_type")) {
		value[sizeof(value) - 1U] = '\0';
		str_set(s->board_type, sizeof(s->board_type), value);
	}
}

static void app_nvs_load_ip(struct app_settings_snapshot *s)
{
	struct app_nvs_ip_settings stored;

	if (!app_nvs_read_exact(APP_NVS_ID_IP, &stored, sizeof(stored), "ip")) {
		return;
	}

	stored.ip[sizeof(stored.ip) - 1U] = '\0';
	stored.subnet[sizeof(stored.subnet) - 1U] = '\0';
	stored.gateway[sizeof(stored.gateway) - 1U] = '\0';
	stored.dns[sizeof(stored.dns) - 1U] = '\0';
	stored.ntp[sizeof(stored.ntp) - 1U] = '\0';
	s->ip.try_dhcp_first = stored.try_dhcp_first != 0U;
	s->ip.prefer_dhcp_dns = stored.prefer_dhcp_dns != 0U;
	s->ip.prefer_dhcp_ntp = stored.prefer_dhcp_ntp != 0U;
	str_set(s->ip.ip, sizeof(s->ip.ip), stored.ip);
	str_set(s->ip.subnet, sizeof(s->ip.subnet), stored.subnet);
	str_set(s->ip.gateway, sizeof(s->ip.gateway), stored.gateway);
	str_set(s->ip.dns, sizeof(s->ip.dns), stored.dns);
	str_set(s->ip.ntp, sizeof(s->ip.ntp), stored.ntp);
}

static void app_nvs_load_mqtt(struct app_settings_snapshot *s)
{
	struct app_mqtt_settings stored;

	if (!app_nvs_read_exact(APP_NVS_ID_MQTT, &stored, sizeof(stored), "mqtt")) {
		return;
	}

	stored.broker_host[sizeof(stored.broker_host) - 1U] = '\0';
	if (stored.broker_host[0] == '\0' || stored.broker_port == 0U) {
		LOG_WRN("Ignoring invalid stored MQTT settings");
		return;
	}

	str_set(s->mqtt.broker_host, sizeof(s->mqtt.broker_host), stored.broker_host);
	s->mqtt.broker_port = stored.broker_port;
}

static void app_nvs_load_attenuator(struct app_settings_snapshot *s)
{
	for (uint8_t channel = 0; channel < APP_ATTENUATOR_CHANNEL_COUNT; ++channel) {
		struct app_attenuator_channel_settings stored;
		if (app_nvs_read_exact(attenuator_nvs_id(channel), &stored, sizeof(stored), "attenuator")) {
			if (attenuator_channel_valid(&stored)) {
				s->attenuator.channel[channel] = stored;
			} else {
				LOG_WRN("Ignoring invalid stored attenuator channel %u", channel);
			}
		}
		struct app_attenuator_fit_policy policy;
		if (app_nvs_read_exact(APP_NVS_ID_ATTEN_FIT_CH0 + channel, &policy,
				      sizeof(policy), "attenuator fit policy") &&
		    isfinite(policy.max_fit_residual_db[0]) && policy.max_fit_residual_db[0] > 0.0 &&
		    isfinite(policy.max_fit_residual_db[1]) && policy.max_fit_residual_db[1] > 0.0) {
			s->attenuator_fit[channel] = policy;
		}
		struct app_attenuator_open_settings open;
		if (app_nvs_read_exact(APP_NVS_ID_ATTEN_OPEN_CH0 + channel, &open,
				      sizeof(open), "attenuator open") &&
		    isfinite(open.mv[0]) && open.mv[0] >= 0.0f && open.mv[0] <= ATTENUATOR_DRIVE_MAX_MV &&
		    isfinite(open.mv[1]) && open.mv[1] >= 0.0f && open.mv[1] <= ATTENUATOR_DRIVE_MAX_MV) {
			s->attenuator_open[channel] = open;
		}
	}
}

static void app_nvs_load_photodiode(struct app_settings_snapshot *s)
{
	for (uint8_t channel = 0U; channel < APP_PD_CHANNEL_COUNT; ++channel) {
		struct app_nvs_pd_channel stored;
		struct app_pd_channel_settings *pd = &s->photodiode.channel[channel];
		struct app_pd_channel_settings candidate;
		uint8_t power = 0;

		if (app_nvs_read_exact(APP_NVS_ID_PD_POWER_CH0 + channel, &power,
				      sizeof(power), "photodiode power") && power <= 1) {
			g_settings.pd_power_saved[channel] = power != 0;
		}
		if (!app_nvs_read_exact(pd_nvs_id(channel), &stored,
					sizeof(stored), "photodiode")) {
			continue;
		}
		candidate = *pd;
		pd_settings_from_nvs(&candidate, &stored);
		if (!photodiode_settings_valid(&candidate)) {
			LOG_WRN("Ignoring invalid stored photodiode channel %u", channel);
			continue;
		}
		*pd = candidate;
	}
}

static void app_nvs_load_laserbank(struct app_settings_snapshot *s)
{
	uint32_t value;

	if (!app_nvs_read_exact(APP_NVS_ID_LASERBANK, &value, sizeof(value), "laserbank")) {
		return;
	}
	if (value > LASERBANK_HEATER_MODE_OVERRIDE_OFF) {
		LOG_WRN("Ignoring invalid stored laser-bank heater mode");
		return;
	}

	s->laserbank.heater_mode = (enum laserbank_heater_mode)value;
}

static void app_nvs_apply_laser_policy(struct app_laser_channel_settings *laser,
				       const struct app_nvs_laser_policy *stored)
{
	laser->properties.nominal_current_ma = stored->nominal_current_ma;
	laser->properties.max_current_ma = stored->max_current_ma;
	laser->properties.threshold_current_ma = stored->threshold_current_ma;
	laser->min_autolevel_current_ma = stored->min_autolevel_current_ma;
	laser->properties.efficiency_mw_per_ma = stored->efficiency_mw_per_ma;
	laser->properties.efficiency_mw_per_ma2 = stored->efficiency_mw_per_ma2;
	laser->properties.efficiency_ref_ma = stored->efficiency_ref_ma;
	laser->properties.wave_ref_nm = stored->wave_ref_nm;
	laser->properties.wave_ref_ma = stored->wave_ref_ma;
	laser->properties.wave_ref_temp_c = stored->wave_ref_temp_c;
	laser->current_cal_pct = stored->current_cal_pct;
	laser->fractional_noise = stored->fractional_noise;
	laser->constant_noise_mw = stored->constant_noise_mw;
	laser->properties.operating_temp_range_c.min_c = stored->operating_temp_min_c;
	laser->properties.operating_temp_range_c.max_c = stored->operating_temp_max_c;
	laser->properties.operating_temp_c = stored->operating_temp_c;
	laser->properties.tec_pid.kp = stored->tec_pid_p;
	laser->properties.tec_pid.ki = stored->tec_pid_i;
	laser->properties.tec_pid.kd = stored->tec_pid_d;
	laser->expected_serial = stored->expected_serial;
	laser->disable_tec_at_autooff = stored->disable_tec_at_autooff != 0U;
	laser->properties.dlambda_dT_nm_per_k = stored->dlambda_dT_nm_per_k;
	laser->properties.dlambda_dA_nm_per_ma = stored->dlambda_dA_nm_per_ma;
	laser->autooff_s = stored->autooff_s;
	laser->tune_delta_nm = stored->tune_delta_nm;
}

static void app_nvs_load_laser(struct app_settings_snapshot *s)
{
	for (uint8_t channel = 0U; channel < APP_LASER_CHANNEL_COUNT; ++channel) {
		struct app_nvs_laser_policy policy;
		struct app_laser_channel_settings laser;
		double total_emitting_s;
		double ntc_coefficient;

		/* A policy is a self-contained curve. An old-length or invalid record
		 * keeps compiled policy defaults without discarding independent inputs. */
		laser = s->laser.channel[channel];
		bool have_policy = app_nvs_read_exact(laser_policy_nvs_id(channel), &policy,
						     sizeof(policy), "laser policy");
		if (have_policy) {
			app_nvs_apply_laser_policy(&laser, &policy);
		}
		/* Restore both bounds before validation: a new support interval may lie
		 * above nominal. An absent ceiling follows the restored nominal value. */
		laser.max_autolevel_current_ma = laser.properties.nominal_current_ma;
		double upper;
		bool have_upper = app_nvs_read_exact(APP_NVS_ID_LASER_AUTO_MAX_CH0 + channel,
						    &upper, sizeof(upper), "laser autolevel ceiling");
		if (have_upper) {
			double minimum = MAX(laser.min_autolevel_current_ma,
				laser.properties.threshold_current_ma + 1.0 / DIVIDER_CURRENT);
			if (isfinite(upper) && upper > 0.0 && upper <= laser.properties.max_current_ma &&
			    isfinite(hispec_laser_quantize_current_ma(minimum, minimum, upper))) {
				laser.max_autolevel_current_ma = upper;
			} else {
				LOG_WRN("Ignoring invalid stored autolevel ceiling channel %u", channel);
			}
		}
		if (have_policy || have_upper) {
			if (hispec_laser_validate_channel_settings((enum hispec_laser_id)channel, &laser) == 0) {
				s->laser.channel[channel] = laser;
			} else {
				LOG_WRN("Ignoring invalid stored laser policy channel %u", channel);
			}
		}

		double reference[3];
		if (app_nvs_read_exact(APP_NVS_ID_LASER_REF_CH0 + channel, reference,
				       sizeof(reference), "laser reference")) {
			laser = s->laser.channel[channel];
			laser.properties.ref_mw = reference[0];
			laser.properties.ref_ma = reference[1];
			laser.properties.ref_temp_c = reference[2];
			if (hispec_laser_validate_channel_settings((enum hispec_laser_id)channel, &laser) == 0) {
				s->laser.channel[channel] = laser;
			} else {
				LOG_WRN("Ignoring invalid stored laser reference channel %u", channel);
			}
		}

		if (app_nvs_read_exact(laser_ntc_nvs_id(channel), &ntc_coefficient,
				       sizeof(ntc_coefficient), "laser NTC")) {
			laser = s->laser.channel[channel];
			laser.properties.ntc_coeff_pct_per_c = ntc_coefficient;
			if (hispec_laser_validate_channel_settings((enum hispec_laser_id)channel, &laser) == 0) {
				s->laser.channel[channel] = laser;
			} else {
				LOG_WRN("Ignoring invalid stored laser NTC channel %u", channel);
			}
		}

		if (app_nvs_read_exact(laser_total_nvs_id(channel), &total_emitting_s,
				       sizeof(total_emitting_s), "laser total") &&
		    double_in_range(total_emitting_s, 0.0, 1.0e12)) {
			s->laser.channel[channel].total_emitting_s = total_emitting_s;
		}
	}
}

static void app_nvs_load_route_loss(struct app_settings_snapshot *s)
{
	for (uint8_t i = 0U; i < APP_ROUTE_LOSS_RECORD_COUNT; ++i) {
		struct app_route_loss_record stored;

		if (!app_nvs_read_exact(route_loss_nvs_id(i), &stored,
					sizeof(stored), "route loss")) {
			continue;
		}
		if (!route_loss_record_valid(&stored)) {
			LOG_WRN("Ignoring invalid stored route-loss record %u", i);
			continue;
		}

		s->route_loss.record[i] = stored;
	}
}

static void app_nvs_load_mems(struct app_settings_snapshot *s)
{
	struct app_mems_settings stored;

	if (!app_nvs_read_exact(APP_NVS_ID_MEMS, &stored, sizeof(stored), "MEMS")) {
		return;
	}
	if (!mems_settings_valid(&stored)) {
		LOG_WRN("Ignoring invalid stored MEMS settings");
		return;
	}

	s->mems = stored;
}

static void app_nvs_load_all(struct app_settings_snapshot *s)
{
	uint32_t value;

	app_nvs_load_board_type(s);
	attenuator_defaults(s, s->board_type);
	if (app_nvs_read_exact(APP_NVS_ID_BOOT_COUNT, &value, sizeof(value), "boot count")) {
		s->boot_count = value;
	}
	app_nvs_load_ip(s);
	app_nvs_load_mqtt(s);
	app_nvs_load_attenuator(s);
	app_nvs_load_photodiode(s);
	app_nvs_load_laserbank(s);
	app_nvs_load_laser(s);
	app_nvs_load_route_loss(s);
	app_nvs_load_mems(s);
}

static void delete_setting_record(uint16_t id, int *first_rc)
{
	int rc = app_nvs_delete(id);

	if (rc != 0 && first_rc != NULL && *first_rc == 0) {
		*first_rc = rc;
	}
}

static int delete_resettable_settings(bool keep_ip, bool keep_boot_count)
{
	int first_rc = 0;

	delete_setting_record(APP_NVS_ID_SERIAL_HOLDOFF_UNUSED, &first_rc);
	delete_setting_record(APP_NVS_ID_BOARD_TYPE, &first_rc);
	if (!keep_boot_count) {
		delete_setting_record(APP_NVS_ID_BOOT_COUNT, &first_rc);
	}
	delete_setting_record(APP_NVS_ID_LAST_KNOWN_UTC_UNUSED, &first_rc);
	if (!keep_ip) {
		delete_setting_record(APP_NVS_ID_IP, &first_rc);
	}
	delete_setting_record(APP_NVS_ID_MQTT, &first_rc);
	delete_setting_record(APP_NVS_ID_LASERBANK, &first_rc);

	for (uint8_t channel = 0U; channel < APP_ATTENUATOR_CHANNEL_COUNT; ++channel) {
		delete_setting_record(attenuator_nvs_id(channel), &first_rc);
		delete_setting_record(APP_NVS_ID_ATTEN_FIT_CH0 + channel, &first_rc);
		delete_setting_record(APP_NVS_ID_ATTEN_OPEN_CH0 + channel, &first_rc);
	}
	for (uint8_t channel = 0U; channel < APP_PD_CHANNEL_COUNT; ++channel) {
		delete_setting_record(pd_nvs_id(channel), &first_rc);
		delete_setting_record(APP_NVS_ID_PD_POWER_CH0 + channel, &first_rc);
	}
	for (uint8_t channel = 0U; channel < APP_LASER_CHANNEL_COUNT; ++channel) {
		delete_setting_record(laser_policy_nvs_id(channel), &first_rc);
		delete_setting_record(laser_ntc_nvs_id(channel), &first_rc);
		delete_setting_record(APP_NVS_ID_LASER_REF_CH0 + channel, &first_rc);
		delete_setting_record(APP_NVS_ID_LASER_AUTO_MAX_CH0 + channel, &first_rc);
		delete_setting_record(laser_total_nvs_id(channel), &first_rc);
	}
	for (uint8_t i = 0U; i < APP_ROUTE_LOSS_RECORD_COUNT; ++i) {
		delete_setting_record(route_loss_nvs_id(i), &first_rc);
	}
	delete_setting_record(APP_NVS_ID_MEMS, &first_rc);

	return first_rc;
}

static int route_loss_record_index_locked(const char *route, const char *laser,
					  bool allocate)
{
	int first_free = -1;

	for (uint8_t i = 0U; i < APP_ROUTE_LOSS_RECORD_COUNT; ++i) {
		struct app_route_loss_record *record =
			&g_settings.snapshot.route_loss.record[i];

		if (!record->configured) {
			if (first_free < 0) {
				first_free = i;
			}
			continue;
		}

		if (strcmp(record->route, route) == 0 &&
		    strcmp(record->laser, laser) == 0) {
			return i;
		}
	}

	return allocate ? first_free : -1;
}

int app_settings_init(void)
{
	int rc;

	k_mutex_init(&g_settings.lock);
	settings_defaults(&g_settings.snapshot);
	memset(g_settings.pd_power_saved, 0, sizeof(g_settings.pd_power_saved));

	/* Direct NVS keeps Zephyr's flash wear-leveling and recovery behavior
	 * without storing human-readable setting names alongside small values.
	 */
	rc = app_nvs_mount();
	if (rc != 0) {
		return rc;
	}

	rc = app_nvs_ensure_schema();
	if (rc != 0) {
		return rc;
	}

	app_nvs_load_all(&g_settings.snapshot);
	return 0;
}

void app_settings_get_snapshot(struct app_settings_snapshot *out)
{
	if (out == NULL) {
		return;
	}

	k_mutex_lock(&g_settings.lock, K_FOREVER);
	*out = g_settings.snapshot;
	k_mutex_unlock(&g_settings.lock);
}

int app_settings_note_board_type(const char *board_type, bool *changed)
{
	bool persist_needed = false;
	bool reset_needed = false;

	if (board_type == NULL || board_type[0] == '\0' ||
	    strlen(board_type) >= APP_SETTINGS_BOARD_TYPE_MAX_LEN) {
		return -EINVAL;
	}

	k_mutex_lock(&g_settings.lock, K_FOREVER);
	if (g_settings.snapshot.board_type[0] == '\0') {
		str_set(g_settings.snapshot.board_type,
			sizeof(g_settings.snapshot.board_type),
			board_type);
		attenuator_defaults(&g_settings.snapshot, board_type);
		/* A first detection must still honor any saved coefficient/open records. */
		app_nvs_load_attenuator(&g_settings.snapshot);
		persist_needed = true;
	} else if (strcmp(g_settings.snapshot.board_type, board_type) != 0) {
		char previous[APP_SETTINGS_BOARD_TYPE_MAX_LEN];

		str_set(previous, sizeof(previous), g_settings.snapshot.board_type);
		LOG_WRN("Board type changed from %s to %s; clearing persisted settings",
			previous, board_type);
		settings_defaults(&g_settings.snapshot);
		memset(g_settings.pd_power_saved, 0, sizeof(g_settings.pd_power_saved));
		str_set(g_settings.snapshot.board_type,
			sizeof(g_settings.snapshot.board_type),
			board_type);
		persist_needed = true;
		reset_needed = true;
		attenuator_defaults(&g_settings.snapshot, board_type);
	}
	k_mutex_unlock(&g_settings.lock);

	if (reset_needed) {
		(void)delete_resettable_settings(false, false);
	}
	if (persist_needed) {
		app_nvs_persist_board_type(board_type);
	}
	if (changed != NULL) {
		*changed = reset_needed;
	}

	return 0;
}

int app_settings_erase_non_ip_settings(void)
{
	struct app_ip_settings ip;
	uint32_t boot_count;
	int rc;

	if (!app_nvs_ready) {
		return -EIO;
	}

	k_mutex_lock(&g_settings.lock, K_FOREVER);
	ip = g_settings.snapshot.ip;
	boot_count = g_settings.snapshot.boot_count;
	settings_defaults(&g_settings.snapshot);
	attenuator_defaults(&g_settings.snapshot, devices_board_type_name());
	memset(g_settings.pd_power_saved, 0, sizeof(g_settings.pd_power_saved));
	g_settings.snapshot.ip = ip;
	g_settings.snapshot.boot_count = boot_count;
	k_mutex_unlock(&g_settings.lock);

	rc = delete_resettable_settings(true, true);
	if (rc != 0) {
		LOG_WRN("Failed to erase all non-IP settings (%d)", rc);
		return rc;
	}

	LOG_WRN("Erased stored non-IP settings; preserved IP settings and boot count");
	return 0;
}

void app_settings_get_ip(struct app_ip_settings *out)
{
	if (out == NULL) {
		return;
	}

	k_mutex_lock(&g_settings.lock, K_FOREVER);
	*out = g_settings.snapshot.ip;
	k_mutex_unlock(&g_settings.lock);
}

void app_settings_update_ip(const struct app_ip_settings *ip, bool persist)
{
	if (ip == NULL) {
		return;
	}

	k_mutex_lock(&g_settings.lock, K_FOREVER);
	g_settings.snapshot.ip = *ip;
	k_mutex_unlock(&g_settings.lock);

	if (persist) {
		app_nvs_persist_ip(ip);
	}
}

void app_settings_get_mqtt(struct app_mqtt_settings *out)
{
	if (out == NULL) {
		return;
	}

	k_mutex_lock(&g_settings.lock, K_FOREVER);
	*out = g_settings.snapshot.mqtt;
	k_mutex_unlock(&g_settings.lock);
}

void app_settings_update_mqtt(const struct app_mqtt_settings *mqtt, bool persist)
{
	if (mqtt == NULL) {
		return;
	}

	k_mutex_lock(&g_settings.lock, K_FOREVER);
	g_settings.snapshot.mqtt = *mqtt;
	g_settings.snapshot.mqtt_revision++;
	k_mutex_unlock(&g_settings.lock);

	if (persist) {
		app_nvs_persist_mqtt(mqtt);
	}
}

void app_settings_get_attenuator_open(uint8_t channel, struct app_attenuator_open_settings *out)
{
	if (channel >= APP_ATTENUATOR_CHANNEL_COUNT || out == NULL) return;
	k_mutex_lock(&g_settings.lock, K_FOREVER);
	*out = g_settings.snapshot.attenuator_open[channel];
	k_mutex_unlock(&g_settings.lock);
}

int app_settings_update_attenuator_open(uint8_t channel,
		const struct app_attenuator_open_settings *open, bool persist)
{
	if (channel >= APP_ATTENUATOR_CHANNEL_COUNT || open == NULL) return -EINVAL;
	for (uint8_t i = 0; i < APP_ATTENUATOR_PHYSICAL_COUNT; ++i) {
		if (!isfinite(open->mv[i]) || open->mv[i] < 0.0f || open->mv[i] > ATTENUATOR_DRIVE_MAX_MV) return -EINVAL;
	}
	k_mutex_lock(&g_settings.lock, K_FOREVER);
	g_settings.snapshot.attenuator_open[channel] = *open;
	k_mutex_unlock(&g_settings.lock);
	return persist ? app_nvs_write(APP_NVS_ID_ATTEN_OPEN_CH0 + channel, open, sizeof(*open)) : 0;
}

void app_settings_get_attenuator_fit(uint8_t channel, struct app_attenuator_fit_policy *out)
{
	if (channel >= APP_ATTENUATOR_CHANNEL_COUNT || out == NULL) return;
	k_mutex_lock(&g_settings.lock, K_FOREVER);
	*out = g_settings.snapshot.attenuator_fit[channel];
	k_mutex_unlock(&g_settings.lock);
}

int app_settings_update_attenuator_fit(uint8_t channel,
		const struct app_attenuator_fit_policy *policy, bool persist)
{
	if (channel >= APP_ATTENUATOR_CHANNEL_COUNT || policy == NULL) return -EINVAL;
	for (uint8_t i = 0; i < APP_ATTENUATOR_PHYSICAL_COUNT; ++i) {
		if (!isfinite(policy->max_fit_residual_db[i]) || policy->max_fit_residual_db[i] <= 0.0) return -EINVAL;
	}
	k_mutex_lock(&g_settings.lock, K_FOREVER);
	g_settings.snapshot.attenuator_fit[channel] = *policy;
	k_mutex_unlock(&g_settings.lock);
	return persist ? app_nvs_write(APP_NVS_ID_ATTEN_FIT_CH0 + channel, policy, sizeof(*policy)) : 0;
}

void app_settings_get_attenuator(struct app_attenuator_settings *out)
{
	if (out == NULL) {
		return;
	}

	k_mutex_lock(&g_settings.lock, K_FOREVER);
	*out = g_settings.snapshot.attenuator;
	k_mutex_unlock(&g_settings.lock);
}

void app_settings_update_attenuator_channel(uint8_t channel,
					    const struct app_attenuator_channel_settings *atten,
					    bool persist)
{
	if (atten == NULL || channel >= APP_ATTENUATOR_CHANNEL_COUNT) {
		return;
	}

	k_mutex_lock(&g_settings.lock, K_FOREVER);
	g_settings.snapshot.attenuator.channel[channel] = *atten;
	k_mutex_unlock(&g_settings.lock);

	if (persist) {
		app_nvs_persist_attenuator_channel(channel, atten);
	}
}

bool app_settings_photodiode_power_at_boot(uint8_t channel)
{
	if (channel >= APP_PD_CHANNEL_COUNT) return false;
	k_mutex_lock(&g_settings.lock, K_FOREVER);
	enum app_pd_power_mode mode = g_settings.snapshot.photodiode.channel[channel].power;
	bool enabled = mode == APP_PD_POWER_OVERRIDE_ON ||
		(mode == APP_PD_POWER_AUTO && g_settings.pd_power_saved[channel]);
	k_mutex_unlock(&g_settings.lock);
	return enabled;
}

int app_settings_record_photodiode_power(uint8_t channel, bool enabled)
{
	if (channel >= APP_PD_CHANNEL_COUNT) return -EINVAL;
	int rc = 0;
	uint8_t value = enabled ? 1 : 0;
	k_mutex_lock(&g_settings.lock, K_FOREVER);
	/* Separate from calibration/settings: relay use must not save RAM-only darks.
	 * Flash is touched only on a change; a failed write remains eligible to retry. */
	if (g_settings.pd_power_saved[channel] != enabled) {
		rc = app_nvs_write(APP_NVS_ID_PD_POWER_CH0 + channel, &value, sizeof(value));
		if (rc == 0) g_settings.pd_power_saved[channel] = enabled;
	}
	k_mutex_unlock(&g_settings.lock);
	return rc;
}

void app_settings_get_photodiode(struct app_photodiode_settings *out)
{
	if (out == NULL) {
		return;
	}

	k_mutex_lock(&g_settings.lock, K_FOREVER);
	*out = g_settings.snapshot.photodiode;
	k_mutex_unlock(&g_settings.lock);
}

bool app_settings_try_get_photodiode(struct app_photodiode_settings *out)
{
	if (out == NULL) {
		return false;
	}

	if (k_mutex_lock(&g_settings.lock, K_NO_WAIT) != 0) {
		return false;
	}

	*out = g_settings.snapshot.photodiode;
	k_mutex_unlock(&g_settings.lock);
	return true;
}

void app_settings_update_photodiode(const struct app_photodiode_settings *pd, bool persist)
{
	if (pd == NULL) {
		return;
	}

	k_mutex_lock(&g_settings.lock, K_FOREVER);
	g_settings.snapshot.photodiode = *pd;
	k_mutex_unlock(&g_settings.lock);

	if (persist) {
		app_nvs_persist_pd_channel(0U, &pd->channel[0]);
		app_nvs_persist_pd_channel(1U, &pd->channel[1]);
	}
}

void app_settings_update_photodiode_channel(uint8_t channel,
					    const struct app_pd_channel_settings *pd,
					    bool persist)
{
	if (pd == NULL || channel >= APP_PD_CHANNEL_COUNT) {
		return;
	}

	k_mutex_lock(&g_settings.lock, K_FOREVER);
	g_settings.snapshot.photodiode.channel[channel] = *pd;
	k_mutex_unlock(&g_settings.lock);

	if (persist) {
		app_nvs_persist_pd_channel(channel, pd);
	}
}

void app_settings_get_laserbank(struct app_laserbank_settings *out)
{
	if (out == NULL) {
		return;
	}

	k_mutex_lock(&g_settings.lock, K_FOREVER);
	*out = g_settings.snapshot.laserbank;
	k_mutex_unlock(&g_settings.lock);
}

void app_settings_update_laserbank(const struct app_laserbank_settings *laserbank,
				   bool persist)
{
	if (laserbank == NULL) {
		return;
	}

	k_mutex_lock(&g_settings.lock, K_FOREVER);
	g_settings.snapshot.laserbank = *laserbank;
	k_mutex_unlock(&g_settings.lock);

	if (persist) {
		app_nvs_persist_laserbank(laserbank);
	}
}

int app_settings_get_laser_channel(uint8_t channel,
				   struct app_laser_channel_settings *out)
{
	if (out == NULL || channel >= APP_LASER_CHANNEL_COUNT) {
		return -EINVAL;
	}

	k_mutex_lock(&g_settings.lock, K_FOREVER);
	*out = g_settings.snapshot.laser.channel[channel];
	k_mutex_unlock(&g_settings.lock);
	return 0;
}

int app_settings_update_laser_channel(uint8_t channel,
				      const struct app_laser_channel_settings *laser,
				      bool persist)
{
	if (laser == NULL || channel >= APP_LASER_CHANNEL_COUNT) {
		return -EINVAL;
	}

	k_mutex_lock(&g_settings.lock, K_FOREVER);
	g_settings.snapshot.laser.channel[channel] = *laser;
	k_mutex_unlock(&g_settings.lock);

	if (persist) {
		return app_nvs_persist_laser_channel(channel, laser);
	}

	return 0;
}

int app_settings_update_laser_total_emitting(uint8_t channel,
					     double total_emitting_s,
					     bool persist)
{
	if (channel >= APP_LASER_CHANNEL_COUNT || !(total_emitting_s >= 0.0)) {
		return -EINVAL;
	}

	k_mutex_lock(&g_settings.lock, K_FOREVER);
	g_settings.snapshot.laser.channel[channel].total_emitting_s = total_emitting_s;
	k_mutex_unlock(&g_settings.lock);

	if (persist) {
		app_nvs_persist_laser_total(channel, total_emitting_s);
	}

	return 0;
}

/* Shared forward-launch loss names resolve to the existing physical 1430
 * records. Keep switch sequencing and saved records unchanged; every settings
 * operation uses the same identity, including calibration/default restoration.
 * Pure name resolution: no lock, hardware I/O or persistence. */
static const char *route_loss_storage_route(const char *route, const char *laser)
{
	if (strcmp(laser, "1430yj") == 0) {
		if (strcmp(route, "yj_laser_to_yj_ao") == 0) return "yj_1430_to_yj_ao";
		if (strcmp(route, "yj_laser_to_yj_fei") == 0) return "yj_1430_to_yj_fei";
	} else if (strcmp(laser, "1430hk") == 0) {
		if (strcmp(route, "hk_laser_to_hk_ao") == 0) return "hk_1430_to_hk_ao";
		if (strcmp(route, "hk_laser_to_hk_fei") == 0) return "hk_1430_to_hk_fei";
	}
	return route;
}

int app_settings_get_route_loss(const char *route, const char *laser,
				double *transmission)
{
	int index;

	if (transmission == NULL || route == NULL || laser == NULL) {
		return -EINVAL;
	}
	if (route[0] == '\0' || laser[0] == '\0' ||
	    strlen(route) >= APP_ROUTE_LOSS_ROUTE_MAX_LEN ||
	    strlen(laser) >= APP_ROUTE_LOSS_LASER_MAX_LEN) {
		return -EINVAL;
	}

	route = route_loss_storage_route(route, laser);
	*transmission = devices_route_loss_default(route, laser);
	k_mutex_lock(&g_settings.lock, K_FOREVER);
	index = route_loss_record_index_locked(route, laser, false);
	if (index >= 0) {
		*transmission = g_settings.snapshot.route_loss.record[index].transmission;
	}
	k_mutex_unlock(&g_settings.lock);

	return 0;
}

bool app_settings_try_get_status(struct app_status_settings *out)
{
    struct app_route_loss_settings losses;
    if (k_mutex_lock(&g_settings.lock, K_NO_WAIT) != 0) return false;
    out->boot_count = g_settings.snapshot.boot_count;
    out->mqtt = g_settings.snapshot.mqtt;
    losses = g_settings.snapshot.route_loss;
    for (size_t ch = 0; ch < APP_MEMS_SPLIT_CHANNEL_COUNT; ++ch)
        out->split_configured[ch] = g_settings.snapshot.mems.split[ch].configured != 0;
    k_mutex_unlock(&g_settings.lock);

    /* Resolve the fixed status paths on the private copy, not while holding
     * the settings lock. Public forward names share the existing 1430 mapping.
     */
    for (size_t i = 0; i < APP_LASER_CHANNEL_COUNT + APP_MEMS_SPLIT_CHANNEL_COUNT; ++i) {
        bool split = i >= APP_LASER_CHANNEL_COUNT;
        size_t ch = split ? i - APP_LASER_CHANNEL_COUNT : (i < 3 ? 0 : 1);
        const char *channel = ch == 0 ? "yj" : "hk";
        for (size_t j = 0; j < (split ? 3 : 2); ++j) {
            char route[APP_ROUTE_LOSS_ROUTE_MAX_LEN];
            const char *source = split ? (const char *const[]){"split1", "split2", "split3"}[j] :
                hispec_laser_name(i);
            if (split) snprintk(route, sizeof(route), "%s_calin_to_%s_split", channel, channel);
            else snprintk(route, sizeof(route), "%s_laser_to_%s_%s", channel, channel, j == 0 ? "ao" : "fei");
            const char *stored_route = route_loss_storage_route(route, source);
            double tx = devices_route_loss_default(stored_route, source);
            for (size_t k = 0; k < APP_ROUTE_LOSS_RECORD_COUNT; ++k) {
                const struct app_route_loss_record *r = &losses.record[k];
                if (r->configured && strcmp(r->route, stored_route) == 0 && strcmp(r->laser, source) == 0) {
                    tx = r->transmission;
                    break;
                }
            }
            if (split) out->split_tx[ch][j] = tx;
            else out->launch_tx[i][j] = tx;
        }
    }
    return true;
}

int app_settings_set_route_loss(const char *route, const char *laser,
				double transmission, bool persist)
{
	int index;
	struct app_route_loss_record record;

	if (route == NULL || laser == NULL ||
	    route[0] == '\0' || laser[0] == '\0' ||
	    strlen(route) >= APP_ROUTE_LOSS_ROUTE_MAX_LEN ||
	    strlen(laser) >= APP_ROUTE_LOSS_LASER_MAX_LEN ||
	    !(transmission > 0.0 && transmission <= 1.0)) {
		return -EINVAL;
	}

	route = route_loss_storage_route(route, laser);
	memset(&record, 0, sizeof(record));
	record.configured = true;
	str_set(record.route, sizeof(record.route), route);
	str_set(record.laser, sizeof(record.laser), laser);
	record.transmission = transmission;

	k_mutex_lock(&g_settings.lock, K_FOREVER);
	index = route_loss_record_index_locked(route, laser, true);
	if (index >= 0) {
		g_settings.snapshot.route_loss.record[index] = record;
	}
	k_mutex_unlock(&g_settings.lock);

	if (index < 0) {
		return -ENOSPC;
	}

	if (persist) {
		return app_nvs_persist_route_loss_index((uint8_t)index, &record);
	}

	return 0;
}

/* Remove only this exact override. With persist=false the stored override can
 * return after reboot, exactly like other volatile settings changes.
 * Holds the settings mutex while clearing RAM and, when requested, finding and
 * deleting matching flash records. May block on NVS but never actuates MEMS.
 * Retains the first flash error while attempting the remaining slots. */
int app_settings_reset_route_loss(const char *route, const char *laser, bool persist)
{
	if (route == NULL || laser == NULL || route[0] == '\0' || laser[0] == '\0' ||
	    strlen(route) >= APP_ROUTE_LOSS_ROUTE_MAX_LEN ||
	    strlen(laser) >= APP_ROUTE_LOSS_LASER_MAX_LEN) {
		return -EINVAL;
	}

	route = route_loss_storage_route(route, laser);
	int first = 0;
	k_mutex_lock(&g_settings.lock, K_FOREVER);
	for (uint8_t i = 0; i < APP_ROUTE_LOSS_RECORD_COUNT; ++i) {
		struct app_route_loss_record *record = &g_settings.snapshot.route_loss.record[i];
		bool match = record->configured && strcmp(record->route, route) == 0 &&
			strcmp(record->laser, laser) == 0;

		/* A previous volatile reset can have removed the RAM entry. Find its
		 * persisted identity too, without deleting a different reused slot. */
		struct app_route_loss_record stored;
		if (match) {
			memset(record, 0, sizeof(*record));
		}
		if (!persist) {
			continue;
		}

		int read = app_nvs_ready ? nvs_read(&app_nvs, route_loss_nvs_id(i), &stored, sizeof(stored)) : -EIO;
		if (read < 0 && read != -ENOENT) {
			/* Cannot confirm that this slot lacks the override. */
			if (first == 0) {
				first = read;
			}
		} else if (read == sizeof(stored) && route_loss_record_valid(&stored) &&
			   strcmp(stored.route, route) == 0 && strcmp(stored.laser, laser) == 0) {
			delete_setting_record(route_loss_nvs_id(i), &first);
		}
	}
	k_mutex_unlock(&g_settings.lock);

	return first;
}

void app_settings_get_mems(struct app_mems_settings *out)
{
	if (out == NULL) {
		return;
	}

	k_mutex_lock(&g_settings.lock, K_FOREVER);
	*out = g_settings.snapshot.mems;
	k_mutex_unlock(&g_settings.lock);
}

int app_settings_update_mems(const struct app_mems_settings *mems, bool persist)
{
	if (mems == NULL) {
		return -EINVAL;
	}

	k_mutex_lock(&g_settings.lock, K_FOREVER);
	g_settings.snapshot.mems = *mems;
	k_mutex_unlock(&g_settings.lock);

	return persist ? app_nvs_write(APP_NVS_ID_MEMS, mems, sizeof(*mems)) : 0;
}

uint32_t app_settings_get_mqtt_revision(void)
{
	uint32_t value;

	k_mutex_lock(&g_settings.lock, K_FOREVER);
	value = g_settings.snapshot.mqtt_revision;
	k_mutex_unlock(&g_settings.lock);

	return value;
}

uint32_t app_settings_get_boot_count(void)
{
	uint32_t value;

	k_mutex_lock(&g_settings.lock, K_FOREVER);
	value = g_settings.snapshot.boot_count;
	k_mutex_unlock(&g_settings.lock);

	return value;
}

void app_settings_increment_boot_count(void)
{
	uint32_t value;

	k_mutex_lock(&g_settings.lock, K_FOREVER);
	g_settings.snapshot.boot_count++;
	value = g_settings.snapshot.boot_count;
	k_mutex_unlock(&g_settings.lock);

	(void)app_nvs_write(APP_NVS_ID_BOOT_COUNT, &value, sizeof(value));
}
