COO-Utilities/hispec-tib/app/src/laser_command.c

/*
 * Copyright (c) 2026 Caltech Optical Observatories
 * SPDX-License-Identifier: Apache-2.0
 */

#include "laser_command.h"
#include "laser_calibration.h"
#include "attenuator_calibration.h"

#include <errno.h>
#include <float.h>
#include <stdint.h>
#include <stdio.h>
#include <stdlib.h>
#include <math.h>
#include <string.h>

#include <zephyr/sys/util.h>

#include "app_settings.h"
#include "laserbank_tempcontrol.h"
#include "lasers.h"
#include "throughput_monitor.h"

#include <coo_commons/json_utils.h>

static const struct coo_json_string_choice laserbank_power_mode_choices[] = {
	{ "auto", HISPEC_LASER_BANK_POWER_AUTO },
	{ "override_on", HISPEC_LASER_BANK_POWER_OVERRIDE_ON },
	{ "override_off", HISPEC_LASER_BANK_POWER_OVERRIDE_OFF },
};

static const struct coo_json_string_choice heater_mode_choices[] = {
	{ "auto", LASERBANK_HEATER_MODE_AUTO },
	{ "override_on", LASERBANK_HEATER_MODE_OVERRIDE_ON },
	{ "override_off", LASERBANK_HEATER_MODE_OVERRIDE_OFF },
};

static int laser_cmd_error_rc(struct coo_cmd_response *out,
			      const struct coo_cmd_request *cmd,
			      const char *msg,
			      int rc)
{
	if (rc == -EBUSY) {
		return coo_cmd_busy_response(out, cmd);
	}
	if (rc == -EPERM) {
		return coo_cmd_error_rc(out, cmd, "laser bank power override_off", rc);
	}
	return coo_cmd_error_rc(out, cmd, msg, rc);
}

static int laser_cmd_failure(struct coo_cmd_response *out,
	const struct coo_cmd_request *cmd, enum hispec_laser_id id,
	const char *operation, int rc, const char *detail)
{
	char message[256];
	if (rc == -EBUSY) return coo_cmd_busy_response(out, cmd);
	/* Copy detail before response construction clears the reused payload buffer. */
	const char *reason = detail != NULL && detail[0] != '\0' ? detail :
		rc == -EPERM ? "laser bank power override_off" :
		rc == -EADDRNOTAVAIL ? "driver identity mismatch" :
		rc == -ERANGE || rc == -EINVAL ? "invalid setting or limit" :
		"operation failed; controller state uncertain";
	snprintk(message, sizeof(message), "%s %s: %s", hispec_laser_name(id), operation, reason);
	return coo_cmd_error_rc(out, cmd, message, rc);
}

static bool parse_laserbank_mode_request(const struct coo_cmd_request *cmd,
					 const char *key,
					 const struct coo_json_string_choice *choices,
					 size_t choice_count,
					 int *mode_value)
{
	const char *suffix;
	int payload_mode;
	int parse_rc;

	if (mode_value == NULL) {
		return false;
	}

	if (cmd == NULL) {
		return false;
	}
	parse_rc = coo_cmd_payload_empty(cmd) ? COO_JSON_EXTRACT_MISSING :
		coo_json_extract_string_choice(cmd->payload, "mode", choices,
					      choice_count, &payload_mode);
	if (parse_rc == COO_JSON_EXTRACT_ERR) {
		return false;
	}
	if (strcmp(cmd->key, key) == 0) {
		if (parse_rc != COO_JSON_EXTRACT_OK) return false;
		*mode_value = payload_mode;
		return true;
	}
	suffix = coo_cmd_key_suffix_after(cmd->key, key);
	return coo_json_match_string_choice(suffix, choices, choice_count, mode_value) == 0 &&
	       (parse_rc == COO_JSON_EXTRACT_MISSING || payload_mode == *mode_value);
}

int laserbank_power(const struct coo_cmd_request *cmd, struct coo_cmd_response *out)
{
	enum hispec_laser_bank_power_mode mode;
	char payload[128] = {0};
	int mode_value;
	int rc;

	if (cmd != NULL &&
	    (cmd->msg_type == COO_CMD_EFFECT ||
	     coo_cmd_key_suffix_after(cmd->key, "laser/bankpower")[0] != '\0')) {
		if (!parse_laserbank_mode_request(cmd, "laser/bankpower",
						  laserbank_power_mode_choices,
						  ARRAY_SIZE(laserbank_power_mode_choices),
						  &mode_value)) {
			return coo_cmd_error(out, cmd, "mode must be auto, override_on, or override_off");
		}
		mode = (enum hispec_laser_bank_power_mode)mode_value;
		/* Calibration owns bank state, but emergency bank-off must remain
		 * available even if its normal source STOP cannot be confirmed. */
		if (laser_calibration_active()) {
			if (mode != HISPEC_LASER_BANK_POWER_OVERRIDE_OFF) {
				return coo_cmd_busy_response(out, cmd);
			}
			(void)laser_calibration_stop(NULL); /* Bank-off remains available after a failed STOP. */
		}
		if (attenuator_calibration_active()) {
			if (mode != HISPEC_LASER_BANK_POWER_OVERRIDE_OFF) return coo_cmd_busy_response(out, cmd);
			(void)attenuator_calibration_stop(NULL);
		}
		rc = hispec_laser_bank_power_mode_set(mode);
		if (rc != 0) {
			if (rc == -EBUSY) {
				return coo_cmd_busy_response(out, cmd);
			}
			mode = hispec_laser_bank_power_mode_get();
			snprintk(payload, sizeof(payload),
				 "{\"error\":\"laser bank power mode failed\","
				 "\"rc\":%d,\"mode\":\"%s\",\"powered\":%s}",
				 rc,
				 hispec_laser_bank_power_mode_name(mode),
				 hispec_laser_bank_power_is_enabled() ? "true" : "false");
			return coo_cmd_reply(out, cmd, COO_CMD_RESP_ERROR, payload);
		}
	}

	mode = hispec_laser_bank_power_mode_get();
	snprintk(payload, sizeof(payload),
		 "{\"mode\":\"%s\",\"powered\":%s}",
		 hispec_laser_bank_power_mode_name(mode),
		 hispec_laser_bank_power_is_enabled() ? "true" : "false");
	return coo_cmd_reply(out, cmd, COO_CMD_RESP_OK, payload);
}

int laserbank_clearfaults(const struct coo_cmd_request *cmd, struct coo_cmd_response *out)
{
	uint32_t off_ms = 0U;
	char payload[COO_CMD_PAYLOAD_MAX] = {0};
	int rc;

	/* Fault clear powers the bank off. Cancel calibration first, but a failed
	 * normal STOP must not prevent that recovery power cycle. */
	(void)laser_calibration_stop(NULL);
	rc = hispec_laser_bank_clear_faults(HISPEC_LASER_BANK_FAULT_CLEAR_OFF_MS, &off_ms);
	if (rc != 0) {
		return laser_cmd_error_rc(out, cmd, "laser bank fault clear failed", rc);
	}

	snprintf(payload, sizeof(payload), "{\"off_ms\":%u}", off_ms);
	return coo_cmd_reply(out, cmd, COO_CMD_RESP_OK, payload);
}

static const char *laserbank_tempcontrol_auto_state(
	const struct laserbank_tempcontrol_status *status)
{
	if (status == NULL) {
		return "unknown";
	}
	if (status->heater_mode == LASERBANK_HEATER_MODE_OVERRIDE_ON) {
		return "override_on";
	}
	if (status->heater_mode == LASERBANK_HEATER_MODE_OVERRIDE_OFF) {
		return "override_off";
	}
	if (status->waiting_for_temps) {
		return "waiting_for_temps";
	}
	if (status->any_disabled_below_on_threshold) {
		return "warming_disabled_tec";
	}
	if (status->all_disabled_above_off_threshold) {
		return "disabled_tec_warm";
	}
	if (status->all_tecs_enabled) {
		return "tecs_running";
	}
	return "holding";
}

static int laserbank_tempcontrol_status_payload(char *payload, size_t payload_len)
{
	struct laserbank_tempcontrol_status status = {0};
	uint32_t poll_age_s;
	size_t off = 0U;

	laserbank_tempcontrol_get_status(&status);
	poll_age_s = status.last_poll_age_ms / 1000U;
	if (coo_json_append(payload, payload_len, &off,
			    "{\"mode\":\"%s\","
			    "\"auto_state\":\"%s\","
			    "\"heater_on\":%s,\"bank_power\":%s,"
			    "\"ambient_c\":",
			    laserbank_heater_mode_name(status.heater_mode),
			    laserbank_tempcontrol_auto_state(&status),
			    status.heater_on ? "true" : "false",
			    status.bank_powered ? "true" : "false") != 0 ||
	    coo_json_append_float_or_null(payload, payload_len, &off,
					  status.ambient_c, 2) != 0 ||
	    coo_json_append(payload, payload_len, &off,
			    ",\"idle_tec_temps\":%u,\"idle_tec_avg_c\":",
			    status.idle_tec_temp_count) != 0 ||
	    coo_json_append_float_or_null(payload, payload_len, &off,
					  status.idle_tec_temp_avg_c, 2) != 0 ||
	    coo_json_append(payload, payload_len, &off,
			    ",\"last_error\":%d,\"poll_age_s\":",
			    status.last_error) != 0) {
		return -ENOSPC;
	}
	if (status.last_poll_age_ms == UINT32_MAX) {
		if (coo_json_append(payload, payload_len, &off, "null}") != 0) {
			return -ENOSPC;
		}
	} else if (coo_json_append(payload, payload_len, &off, "%u}",
				   poll_age_s) != 0) {
		return -ENOSPC;
	}
	return 0;
}

int laserbank_heater(const struct coo_cmd_request *cmd, struct coo_cmd_response *out)
{
	enum laserbank_heater_mode mode;
	char payload[COO_CMD_PAYLOAD_MAX] = {0};
	int mode_value;

	if (cmd != NULL &&
	    (cmd->msg_type == COO_CMD_EFFECT ||
	     coo_cmd_key_suffix_after(cmd->key, "laser/bankheater")[0] != '\0')) {
		if (!parse_laserbank_mode_request(cmd, "laser/bankheater",
						  heater_mode_choices,
						  ARRAY_SIZE(heater_mode_choices),
						  &mode_value)) {
			return coo_cmd_reply(out, cmd, COO_CMD_RESP_ERROR,
					     "{\"error\":\"Use laser/bankheater mode=auto|override_on|override_off\"}");
		}
		mode = (enum laserbank_heater_mode)mode_value;
		int rc = laserbank_tempcontrol_set_heater_mode(mode, true);
		if (rc != 0) {
			return coo_cmd_error_rc(out, cmd, "heater mode update/save failed; runtime mode may be applied", rc);
		}
	}

	if (laserbank_tempcontrol_status_payload(payload, sizeof(payload)) != 0) {
		return coo_cmd_error(out, cmd, "laser bank heater response too large");
	}
	return coo_cmd_reply(out, cmd, COO_CMD_RESP_OK, payload);
}

static int command_laser_id_from_payload(const struct coo_cmd_request *cmd,
					 enum hispec_laser_id *id,
					 char *name,
					 size_t name_len)
{
	int parse_rc;

	if (cmd == NULL || id == NULL || name == NULL || name_len == 0U) {
		return -EINVAL;
	}

	parse_rc = coo_json_extract_string(cmd->payload, "name", name, name_len);
	if (parse_rc != COO_JSON_EXTRACT_OK) {
		return -EINVAL;
	}
	return hispec_laser_id_from_name(name, id);
}

static int laser_append_compact_status(char *payload, size_t payload_len,
				       const struct hispec_laser_status *status)
{
	size_t off = 0U;
	const laserprops_t *props = &status->properties;

	if (coo_json_append(payload, payload_len, &off,
			    "{\"name\":\"%s\",\"powered\":%s,"
			    "\"ready\":%s,\"output_state\":\"%s\",\"blocked_reason\":",
			    status->name,
			    status->bank_powered ? "true" : "false",
			    status->ready_to_operate ? "true" : "false", status->output_state) != 0 ||
	    coo_json_append_string_or_null(payload, payload_len, &off,
					   status->blocked_reason) != 0 ||
	    coo_json_append(payload, payload_len, &off,
			    ",\"tec_on_s\":") != 0 ||
	    coo_json_append_seconds_or_null(payload, payload_len, &off,
					    status->tec_runtime_active,
					    status->tec_on_time_s) != 0 ||
	    coo_json_append(payload, payload_len, &off,
			    ",\"emit_on_s\":") != 0 ||
	    coo_json_append_seconds_or_null(payload, payload_len, &off,
					    status->current_runtime_active,
					    status->current_on_time_s) != 0 ||
	    coo_json_append(payload, payload_len, &off,
			    ",\"emit_total_s\":") != 0 ||
	    coo_json_append_seconds_or_null(payload, payload_len, &off,
					    true,
					    status->total_emitting_s) != 0 ||
	    coo_json_append(payload, payload_len, &off,
			    ",\"temp_c\":") != 0 ||
	    coo_json_append_float_or_null(payload, payload_len, &off,
					  status->tec_temperature_measured_c, 2) != 0 ||
	    coo_json_append(payload, payload_len, &off, ",\"tec_temp_set_c\":") != 0 ||
	    coo_json_append_float_or_null(payload, payload_len, &off,
					  status->tec_temperature_set_c, 2) != 0 ||
	    coo_json_append(payload, payload_len, &off,
			    ",\"i_mA\":") != 0 ||
	    coo_json_append_float_or_null(payload, payload_len, &off,
					  status->current_set_ma, 2) != 0 ||
	    coo_json_append(payload, payload_len, &off,
			    ",\"value\":") != 0 ||
	    coo_json_append_float_or_null(payload, payload_len, &off,
					  status->level_percent / 100.0, 4) != 0 ||
	    coo_json_append(payload, payload_len, &off,
			    ",\"power_mw\":") != 0 ||
	    coo_json_append_float_or_null(payload, payload_len, &off,
					  status->estimated_power_mw, 3) != 0 ||
	    coo_json_append(payload, payload_len, &off,
			    ",\"wave_ref_nm\":%.3f,\"tuned_nm\":",
			    props != NULL ? (double)props->wave_ref_nm : 0.0) != 0 ||
	    coo_json_append_float_or_null(payload, payload_len, &off,
					  status->estimated_wavelength_nm, 3) != 0 ||
	    coo_json_append(payload, payload_len, &off,
			    ",\"tune_nm\":%.3f,\"tec_ma\":",
			    (double)status->tune_delta_nm) != 0 ||
	    coo_json_append_float_or_null(payload, payload_len, &off,
					  (double)status->tec_current_measured_a * 1000.0, 2) != 0 ||
	    coo_json_append(payload, payload_len, &off,
			    ",\"diode_v\":") != 0 ||
	    coo_json_append_float_or_null(payload, payload_len, &off,
					  status->voltage_v, 3) != 0 ||
	    coo_json_append(payload, payload_len, &off,
			    ",\"tec_v\":") != 0 ||
	    coo_json_append_float_or_null(payload, payload_len, &off,
					  status->tec_voltage_v, 3) != 0 ||
	    coo_json_append(payload, payload_len, &off,
			    ",\"off_in_s\":") != 0 ||
	    coo_json_append_i64_or_null(payload, payload_len, &off,
					status->autooff_active,
					status->off_in_s) != 0 ||
	    coo_json_append(payload, payload_len, &off,
			    ",\"oc_fault\":%s}",
			    status->lock_ld_overcurrent ? "true" : "false") != 0) {
		return -ENOSPC;
	}

	return 0;
}

int laser_get(const struct coo_cmd_request *cmd, struct coo_cmd_response *out)
{
	enum hispec_laser_id id;
	struct hispec_laser_status status = {0};
	char name[16] = {0};
	char payload[COO_CMD_PAYLOAD_MAX] = {0};
	int rc;

	if (command_laser_id_from_payload(cmd, &id, name, sizeof(name)) != 0) {
		return coo_cmd_error(out, cmd, "missing or invalid laser name");
	}

	rc = hispec_laser_get_status(id, false, &status);
	if (rc != 0) {
		return laser_cmd_failure(out, cmd, id, "status read", rc, NULL);
	}
	if (laser_append_compact_status(payload, sizeof(payload), &status) != 0) {
		return coo_cmd_error(out, cmd, "laser response too large");
	}
	return coo_cmd_reply(out, cmd, COO_CMD_RESP_OK, payload);
}
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
