COO-Utilities/hispec-tib/app/src/devices.c

/**
 * @file devices.c
 * @brief Board strap detection and board-profile-specific device setup.
 */
/*
 * Copyright (c) 2024 Analog Devices, Inc.
 *
 * SPDX-License-Identifier: Apache-2.0
 */

#ifndef __DEVICE_C__
#define __DEVICE_C__

#include "devices.h"
#include "app_settings.h"
#include "app_output.h"
#include "drivers/dac/dac7x78.h"
#include "maiman.h"
#include "mems_switching.h"
#include "photodiode.h"

#include <errno.h>
#include <stdio.h>
#include <string.h>
#include <zephyr/drivers/hwinfo.h>
#include <zephyr/sys/util.h>

LOG_MODULE_REGISTER(devices, LOG_LEVEL_INF);

#define USER_NODE DT_PATH(zephyr_user)
#define MAX_NUM_MEMS_SWITCHES 8U

BUILD_ASSERT(APP_ATTENUATOR_CHANNEL_COUNT == NUM_ATTENUATORS,
	     "Persistent attenuator settings must match logical attenuator count");
BUILD_ASSERT(NUM_ATTENUATORS == HISPEC_LASER_COUNT,
	     "Logical attenuator mapping assumes one TIB attenuator per laser");
BUILD_ASSERT(HISPEC_ATTENUATOR_LFC_INDEX < NUM_ATTENUATORS,
	     "LFC/CAL attenuator index must fit logical attenuator table");

/* Devices */
const struct gpio_dt_spec laser_power_gpio = GPIO_DT_SPEC_GET(USER_NODE, laser_power_gpios);
const struct gpio_dt_spec heater_power_gpio = GPIO_DT_SPEC_GET(USER_NODE, heater_power_gpios);
const struct gpio_dt_spec yj_power_gpio = GPIO_DT_SPEC_GET(USER_NODE, yj_power_gpios);
const struct gpio_dt_spec hk_power_gpio = GPIO_DT_SPEC_GET(USER_NODE, hk_power_gpios);


static const struct gpio_dt_spec board_type_tib_gpio = GPIO_DT_SPEC_GET(USER_NODE, board_type_tib_gpios);
static const struct gpio_dt_spec board_type_cal_yj_gpio = GPIO_DT_SPEC_GET(USER_NODE, board_type_cal_yj_gpios);
static const struct gpio_dt_spec board_type_cal_hk_gpio = GPIO_DT_SPEC_GET(USER_NODE, board_type_cal_hk_gpios);
static const struct gpio_dt_spec board_type_as_gpio = GPIO_DT_SPEC_GET(USER_NODE, board_type_as_gpios);

#define MODBUS_NODE DT_COMPAT_GET_ANY_STATUS_OKAY(zephyr_modbus_serial)
static const char modbus_name[] = DEVICE_DT_NAME(MODBUS_NODE);
const struct device *adc_dev = DEVICE_DT_GET(DT_NODELABEL(adc1115));

const struct device *gpio_dev = DEVICE_DT_GET(DT_NODELABEL(pcal6416a));
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
