COO-Utilities/hispec-tib/(commit log)

2025-11-14 Add documentation detailing hardware, libraries, design intent, code structure, and outstanding tasks. Include notes for breadboarding, library options, and nuances encountered during early developme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
    [main.c]
2026-01-06 Convert attenuator initialization to return success status (bool), simplify attenuator setting logic, make minor photodiode and status updates, add TODOs for code clarity and error handling improveme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
    [attenuator.c, attenuator.h, command.c, main.c, mems_switching.c, photodiode.c]
2026-01-06 Remove QEMU x86 overlay and add STM32H5 board documentation.
2026-02-09 Mems switching minor edits
2026-02-09 some devices cleanup
2026-02-23 Add hardware documentation for FIB PCB controller, consolidate design details, update status doc, and refine descriptions of connected components. Also, include two renamed STM32H5 board documents.
2026-02-25 Update documentation structure and content. Consolidate and simplify library notes, add detailed command reference, and include `laser_properties.h` for default laser configurations.
2026-04-10 Add `laser_properties.h` include and expand `maiman_driver_t` struct with new fields (serial number, laser configuration). Restore Modbus functions to `maiman.c`. Update and refine documentation for 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
2026-04-10 Remove unused configs and refactor device configuration overlay files. Introduce GPIO, ADC, DAC, and Modbus device support for Nucleo-H563ZI.
2026-04-11 Actually builds. Update DAC7578 support, I2C configurations, and board files
    Added new 1-Wire device configurations and refined I2C bus mappings for ADC and DAC devices. Adjusted DAC7578 driver to expose `dac7578_read_value` and updated header accordingly. Included initial draft for board type selection using GPIO jumpers and added relevant documentation updates.
2026-04-13 Mid work by Codex. Checkpointing as a placeholder
    Add settings persistence framework, AI prompt library, and initial network configuration helpers
    Introduce `app_settings.c` and `app_settings.h` for managing application settings persistence. Add AI prompt library templates (`prompts_clion.md`) and self-review checklist (`self_review_checklist.md`). Implement basic network initialization and configuration utilities in `network.h` and `mqtt_client.c`. Minor fixes to `photodiode` thread signature and command handling utilities. Update project configuration (`prj.conf`) with UART console support and DHCP settings.
    [app_settings.c, app_settings.h, command.c, command.h, main.c]
2026-04-13 Add MQTT broker configuration persistence and runtime reconfiguration
    [app_settings.c, app_settings.h, command.c, command.h, main.c]
2026-04-14 Some initial slop on mems switching. Its remarkable how good...and yet so bad agents are.
    [command.c, devices.c, mems_switching.c, mems_switching.h]
2026-04-17 Add 1-Wire GPIO support, update sample.yaml, and configure out-of-tree DS2408 module
    Enable 1-Wire support in `prj.conf` with DS2408 GPIO configurations. Update `sample.yaml` to reflect new application name, description, and integration platform. Add logic to include DS2408 out-of-tree module in build process and placeholder in `west.yml`.
2026-04-29 Integrate DS18B20 temperature sensing with 1-Wire GPIO support
    Add `tempsense` module to provide temperature sensing using DS18B20. Update `prj.conf` and device tree overlays to support 1-Wire Protocol. Extend command API to include `temp_get` for temperature status retrieval. Update CMakeLists to include new source files. Minor additions to enable related code inspections.
2026-05-01 Remove unused workflow and refactor command handling logic
    Delete `.github/workflows/build.yml` as it is unused. Make serial block MQTT command handling not MQTT connection while consolidating command execution threads. Simplify network and MQTT logic gating with `command_handle_mqtt_publish`. Add error response for serial command priority over MQTT. Clean up redundant includes and legacy functions.
    [command.c, command.h, main.c]
2026-05-01 Clarify serial command flow
2026-05-01 Add photodiode dark calibration support
2026-05-01 Add board type detection and profiles
2026-05-02 Define and register calibration MEMS routes for CAL board types. -JIB
2026-05-02 Simplify board profiles and static routes
2026-05-02 Refine board straps and photodiode calibration
2026-05-02 Persist attenuator calibration coefficients
2026-05-02 Wire laserbank power commands
2026-05-02 First pass at porting python laser code from lab testing. -JIB
2026-05-12 Refactor MQTT broker settings to unified `<host-or-ip>:<port>` format, consolidate persistent settings structure, and update corresponding documentation and workflows.
    [app_identity.h, app_settings.c, app_settings.h, command.c, main.c, photodiode.c]
2026-05-13 Refactor attenuator and MEMS switch models: implement paired physical attenuator support, improve MEMS handling, and update related docs.
2026-05-13 Refactor telemetry and queue logic: replace `photodiode_queue` with direct `outbound_queue` usage, improve `outbound_queue` capacity handling, and update related documentation.
    [command.c, command.h, main.c, photodiode.c, photodiode.h]
2026-05-14 Add laser-bank heater control: implement TIB auto/override policy, TEC temperature polling, and command handling. Update related docs and persist heater mode.
2026-05-14 Work on sorting out GPIOs, some minor cleanup of laser enum and board bringup. General tidying.
2026-05-15 mqtt: select topic identity from board strap
2026-05-15 Update and flesh out laser control intentions
2026-05-15 Implement laser command suite
2026-05-15 Use laser percent for throughput autolevel
2026-05-15 Load laser runtime settings lazily
2026-05-15 Move throughput flux estimate into laser module
2026-05-15 Refactor MEMS pin mapping and toggle rate handling; simplify docs build
2026-05-15 Refactor command handling: streamline error responses, enhance MQTT payload inference, and log last command details.
    [command.c, command.h]
2026-05-15 Track laser-bank power-on time and expose via status response
2026-05-16 Remove legacy `unit: volts` references in `pd_get`, streamline MEMS switch functions, and update documentation
2026-05-16 Add throughput monitor flow diagrams, update related flows, and align documentation numbering.
2026-05-16 Move laser command handlers to adapter
2026-05-16 Tighten laser command domain boundaries
    [laser_command.c, lasers.c, lasers.h]
2026-05-16 Rename laser bank temperature control module
2026-05-18 Switch app settings persistence from Zephyr string-based settings API to direct NVS-based implementation.
    Why waste perfectly good NVRAM?
2026-05-18 Trim unused laser pulse helpers
2026-05-18 Stop compiling unused PID helper
2026-05-18 Consolidate laser runtime counters
2026-05-19 Hide dormant PID helper from project docs
2026-05-19 Fold temperature status into housekeeping
2026-05-19 Move relay power ownership to housekeeping
2026-05-19 Revert throughput housekeeping service
    [housekeeping.c, main.c, throughput_monitor.c, throughput_monitor.h]
2026-05-19 Use shared choices for laserbank modes
2026-05-19 Use shared choices for MEMS switch state
2026-05-19 Remove misspelled heater mode aliases
2026-05-19 Tighten laserbank mode command aliases
    [laser_command.c]
2026-05-19 Update housekeeping thread documentation
2026-05-19 Move laser autooff to laser timeout actor
2026-05-19 Use delayable work for laser autooff
2026-05-19 Allow TEC current limit laser setting
2026-05-19 Share laserbank override parsing
2026-05-19 Separate laser temperature ownership
2026-05-19 Move bank on-time to laser power owner
2026-05-19 Expand stack sizes, enable thread analyzer, and add boot reset telemetry features
    [devices.c, devices.h, main.c, photodiode.c, photodiode.h]
2026-05-19 Add device readiness check and configure board straps upfront. Theres still an issue here as the overlay should be sorting this. FIXME
    [devices.c, main.c]
2026-05-19 Replace serial thread with buffered character polling and runtime-managed state.
    [main.c, sntp_sync.c]
2026-05-20 Persist last known UTC time, restore it on boot, and update overlay/device configurations.
2026-05-20 Remove redundant app-specific CMakeLists and update hardware documentation for I2C2 configuration changes
2026-05-20 Add MQTT client for HISPEC FIB PCB with JSON command API, telemetry decoding, and live plotting support.
2026-05-20 Add attenuator calibration module with automatic and manual modes and configuration support. Update throughput_monitor spec
2026-05-20 Simplify photodiode to use averaging functionality for dark measurement with short averaging. Transition dark persistence and statistics handling.
    [attenuator_calibration.c, photodiode.c, photodiode.h, photodiode_command.c]
2026-05-20 Add attenuator calibration functionality with new dataclasses, validation logic, and support for auto and manual modes. Enhance throughput measurements with input/output routing and max flux handling.
2026-05-20 Disable HSE and update PLL configurations for HISPEC-FIB PCB to support I2C2 on PF1/PF0 with HSI as clock source.
2026-05-20 Update hardware documentation and overlay to detail MB1404 solder bridge configuration for PE9 GPIO routing
2026-05-20 Improve MQTT handling: log retained command errors, limit socket poll intervals, enhance payload response formatting, and better support serial guard with refined read-only query allowances. Update `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
    [command.c, gpio_ds2408.c]
2026-05-23 Lower I2C1 clock frequency to 100 kHz in NUCLEO_H563ZI overlay configuration. Allows ADC to run
2026-05-23 Adjust logging levels, update hardware documentation, improve network and watchdog initialization logic, and refine device startup with default configurations.
2026-05-23 board: configure strap inputs with gpio hogs
2026-05-23 logging: back off repeated ADC errors
    [photodiode.c]
2026-05-23 board: disable DAC7578 clear pin
2026-05-25 Simplify devices.c
2026-05-26 attenuator: use DAC7x78 driver API
2026-05-27 Switch to dac7678
2026-05-27 config: add pySourceRootDetection for devicetree scripts
2026-05-27 Refactor command help guard and reboot ownership
    [app_settings.c, app_settings.h, command.c, command.h]
2026-05-27 Update DAC channel mappings and attenuator terminology
    Revised DAC channel mappings for attenuators and clarified hardware documentation. Introduced consistent naming for attenuator voltage outputs (`v1_mv` and `v2_mv`) across docs and code. Simplified `attenuator_dac_pair_for_index` logic using a new static mapping.
2026-05-27 Refactor reboot preparation to conditionally handle photodiode power and laser output for HISPEC_BOARD_TIB
    [command.c]
2026-05-28 Update attenuator voltage limits and DAC configuration
    Revised max attenuator drive span to 5000 mV across code and documentation. Updated `ATTENUATOR_DAC_MAX_MV` references to `ATTENUATOR_DRIVE_MAX_MV` for clarity. Refactored DAC channel mapping logic to simplify device assignment and improve consistency.
2026-05-29 Update uptime field to `uptime_s` and convert to seconds
    Standardized `uptime` field to `uptime_s` for clarity in units. Adjusted code to convert milliseconds to seconds across JSON payloads and documentation.
2026-05-29 Get MEMS working.
    Streamlined MEMS response handling by conditionally omitting timing fields for static states and refactored callbacks for duty cycle and timing data. Updated GPIO configuration to adopt board-defined active-low logic via `gpio_dt_spec`, improving clarity and consistency in hardware abstraction.
2026-05-30 Refactor laser bank power management to improve GPIO handling and firmware state tracking
    Modified the laser bank power control logic by replacing GPIO read-as-source with a firmware state model (`bank_power_requested_enabled`). Improved handling of bank power transitions, added forced writes to ensure state consistency, and enhanced logging. Updated Nucleo overlay configuration to use open-drain GPIO for laser power. Adjusted associated hardware documentation and command response error handling.
    [laser_command.c, lasers.c, lasers.h]
2026-05-30 Refactor MEMS switch pulse handling to use uptime-based deadlines
    Replaced tick-based pulse tracking with uptime-based deadlines to improve accuracy and timing consistency. Updated related data fields, replaced ticks with time-reached checks, and adjusted cleanup logic accordingly. Improved comments and documentation for switch timing behavior and duty cycle response.
    [mems_switching.c, mems_switching.h]
2026-05-30 Increase main stack size to 8192 and disable thread analyzer features
2026-06-02 Add selective deletion of non-IP settings during reboot preparation
    Refactored `delete_resettable_settings` to support conditional IP and boot count preservation. Introduced `app_settings_erase_non_ip_settings` for erasing settings while retaining key configuration. Updated reboot logic to handle optional `erase_non_ip_settings` payload. Enhanced documentation to reflect these changes.
    [app_settings.c, app_settings.h, command.c]
2026-06-02 Refactor attenuator voltage handling and clamping logic
    Introduced utility functions to convert between attenuator voltage and DAC code. Improved clamping behavior with optional warning thresholds for out-of-range voltages. Enhanced precision in attenuation and voltage comparisons by applying configurable epsilon values. Adjusted related logging and updated applied voltage tracking for greater accuracy.
2026-06-02 Speed up adc to 250 sps for now. 400khz i2c
2026-06-02 Work on cleaning up network bringup to remove a dhcp failure
    [main.c]
2026-06-03 Rename variables for clarity: standardize time and voltage fields (uptime_s, v1_mv, v2_mv).
2026-06-03 Update TODOs: refine laser/photodiode settings, clarify power modes, and address Modbus timeout issues.
2026-06-04 Update hardware documentation: add FFLS status pin details and overlay TODOs
2026-06-04 Normalize laserbank mode schema and heater auto safety
2026-06-04 Apply default laser TEC setpoint
2026-06-04 Add catalog command and simplify heater status
2026-06-04 Avoid greedy laser bus polling
    [command.c, laser_command.c, laserbank_tempcontrol.c, lasers.c, lasers.h]
2026-06-04 Remove unused Maiman driver cache
2026-06-04 Shorten command payload keys
    [attenuator_calibration.c, attenuator_command.c, command.c, laser_command.c, throughput_monitor.c]
2026-06-04 Inline laser lock wait policies
2026-06-05 Document switch assignments and update MEMS switch configurations
2026-06-05 Reorder switch assignments and adjust MEMS GPIO configurations
2026-06-05 Tighten Maiman timeout handling
    [devices.h, laser_command.c, lasers.c]
2026-06-06 Avoid redundant heater relay writes
    [laserbank_tempcontrol.c]
2026-06-06 Rename command off timers to off_in_s
2026-06-06 Keep explicit MEMS cycles fixed
    [mems_command.c, mems_switching.c, mems_switching.h]
2026-06-06 Add photodiode power policy settings
2026-06-06 Add photodiode auto power control
2026-06-06 Respect photodiode power policy in throughput
2026-06-08 Report photodiode relay on-times
2026-06-08 Persist MEMS switch intent
2026-06-10 Add detailed laser status reporting and key validation
    Refine laser command handling with extended status fields (`ready`, `blocked_reason`, and runtime indicators), reject unknown payload keys, and enhance command-specific key restrictions and prefix matching.
2026-06-10 Refine laser heater control with idle TEC temperature metrics and enhanced status serialization
2026-06-10 Instrument attenuator calibration telemetry
2026-06-10 Refine telemetry ownership and relay on-time semantics
2026-06-10 Reduce throughput calibration stack use
2026-06-10 Reset photodiode noise estimator on optical steps
    [photodiode.c]
2026-06-10 Broaden attenuator calibration voltage schedule
2026-06-10 Emit attenuator calibration fit dataset telemetry
2026-06-10 Bound attenuator calibration fit telemetry
2026-06-11 Log all PCB telemetry in Python client
2026-06-11 Adapt attenuator auto calibration range handling
2026-06-11 Persist accepted laser driver serial
2026-06-11 Require confirmed laser driver serial
2026-06-11 Drop idle laser blocked reason
2026-06-13 Overhaul attenuator calibration acquisition
2026-06-15 Prefix attenuator calibration data methods with underscore
2026-06-15 Refine attenuator calibration warnings and messages
2026-06-15 Fix attenuator calibration acquisition robustness
    [attenuator_calibration.c, attenuator_calibration.h, photodiode.c, throughput_monitor.c]
2026-06-15 Overhaul attenuator calibration dataset plotting
2026-06-15 Recover attenuator calibration records and plotting
2026-06-16 Update human review checklist and fix LaserBankHeater API argument handling
2026-06-16 Adjust default noise warning RMS values for photodiodes
    [photodiode.h]
2026-06-17 Add detailed info for attenuator calibration, including setup, procedures, and uncertainty handling.
2026-06-17 Completely overhaul attenuation calibration. Add new Jupyter notebook for bridge-normalized attenuator calibration, update data model to include slope and offset refactor, and enhance comments/docume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
2026-06-17 Document attenuator calibration flow, bridge normalization, and firmware state machine. Update command, telemetry, and dark measurement details. Expand Jupyter lab notebook with improved sampling and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
2026-06-17 Update laser tuning documentation and logic: clarify TEC setpoint roles, improve tuning persistence, and refine power restore handling.
2026-06-17 Refactor persistence key: replace `persistent` with `persist` across codebase and documentation.
    [attenuator_calibration.c, attenuator_calibration.h, attenuator_command.c]
2026-06-17 Overhaul photodiode dark capture flow: introduce pending dark action handling, replace `length_ms` with `duration_ms`, and decouple window arming and commitment logic. Update related commands, docume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
    [app_settings.h, command.c, photodiode.c, photodiode.h, photodiode_command.c]
2026-06-18 Simplify attenuator calibration by removing redundant routing functions and incorporating route definitions into static structures. Update calibration commands and related logic accordingly.
2026-06-18 Fix attenuator calibration flux uncertainty
    [attenuator_calibration.c]
2026-06-18 Improve attenuator calibration analysis helpers
2026-06-19 This commit has a regression in that the sweep is binary and should be linear but I'm commiting as a baseline for diff aid. Document attenuator calibration band model and enhance recording structure: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
2026-06-21 Remove redundant attenuation record events and references; simplify bridge handling and calibration logic
2026-06-21 Align attenuator calibration dataset export
2026-06-22 Refactor attenuation calibration logic: improve fitting, enhance metadata, refine tail floor estimations, and streamline handling of explanatory comments.
2026-06-22 Incorporate `max_atten_db` into attenuation model for physical leakage floor estimation: refine tail fitting, enhance residual propagation, update documentation and JSON coefficients.
    [app_settings.c, app_settings.h, attenuator.c, attenuator.h, attenuator_calibration.c, attenuator_calibration.h, attenuator_command.c, command.c]
2026-06-23 Refactor attenuation calibration: replace double with float for main fit data, introduce analytic Jacobian for Gauss-Newton optimization, and enhance model uncertainty handling.
    [attenuator.c, attenuator.h, attenuator_calibration.c, attenuator_command.c]
2026-07-02 Needs final review. Likley needs to be updated slightly and maybe increased to 6 term per ipython notebook version, but it seems like this will do it and get us sorted.
    Add four-term Chebyshev residual correction to attenuation model: improve residual fitting, enforce monotonicity checks, update firmware model, JSON structure, and documentation.
    [app_settings.c, app_settings.h, attenuator.c, attenuator.h, attenuator_calibration.c, attenuator_calibration.h, attenuator_command.c, command.c]
2026-07-02 Refactor attenuation DAC handling: add check for unused channels, copy correction coefficients for both physical models, and ensure proper memory alignment.
    [devices.c]
2026-07-02 Remove bring-up patch: reinstate proper error handling for unsupported board types
    [devices.c]
2026-09-03 Update hardware documentation and overlay: clarify ADC reference modes, adjust gain settings, and remove outdated breadboard considerations.
2026-09-03 Bound photodiode ADC failure reporting
    [photodiode.c]
2026-09-10 Update laser power GPIO pins to GPIO_ACTIVE_LOW with GPIO_PULL_UP to work with new BSS138
2026-09-11 Update hardware documentation: clarify laser bank power enable configuration with BSS138 and GPIO_ACTIVE_LOW setup
2026-09-11 Remove outdated RP2040/Pico references from west configuration and README.
2026-09-12 Add throughput lab dashboard and selected-laser shutdown
2026-09-12 Limit throughput shutdown to the autolevel operation's laser
2026-09-13 Normalize throughput at ADC acquisition and gate ordinary autolevel moves
2026-09-13 Persist per-laser optical power uncertainty and propagate it to throughput
2026-09-13 Retain attenuator fit RMS with calibration and propagate transmission uncertainty
2026-09-15 Reuse prepared laser state for current updates and preserve I/O faults
2026-09-15 Stream fresh 20 Hz photodiode power measurements with audited errors
    [attenuator_calibration.c, lasers.c, lasers.h, photodiode.c, photodiode.h, photodiode_command.c, throughput_command.c]
2026-09-15 Separate laser and attenuator I/O from confirmed state snapshots
2026-09-15 Keep source context in throughput and complete calibration windows from ADC samples
2026-09-15 Restore command-owned routes and correct passive photodiode measurements
    [app_settings.c, app_settings.h, command.c, devices.c, devices.h, throughput_command.c, throughput_command.h]
2026-09-15 Clarify attenuator calibration plot markers
2026-09-15 Separate laser estimates from operational communication health
2026-09-15 Move relay health checks out of throughput and protect PD acquisition power
2026-09-15 Reject clipped calibration windows and complete six-term correction support
    [app_settings.c, attenuator.c, attenuator_calibration.c, attenuator_command.c]
2026-09-15 Keep throughput streaming during manual laser level changes
2026-09-16 Include FVOA electrical noise in transmission uncertainty
    [attenuator.c, attenuator.h]
2026-09-16 Add attenuator calibration and throughput noise exploration notebook
2026-09-16 Respect Maiman busy timing and retain laser preparation across zero levels
2026-09-17 Refactor JSON helper functions into `coo_json` module and replace local implementations
    [command.c, laser_command.c]
2026-09-17 Working on attenuator noise and calibration. Fix some other messes.
    [app_settings.c, app_settings.h, attenuator.c, attenuator.h, attenuator_calibration.c, attenuator_calibration.h, attenuator_command.c, devices.c]
2026-09-17 Improve JSON validation, error messaging, and handling for commands, laser, and attenuator operations. Refactor payload checks and enhance field-specific diagnostics.
    [attenuator_command.c, command.c, laser_command.c, mems_command.c, throughput_command.c]
2026-09-17 Make throughput dimming priority selectable and bound laser startup
2026-09-17 Eliminate redundant null workqueue checks and streamline queue initialization in housekeeping, laser, and temperature control modules
2026-09-17 Update laser default noise constants for improved power uncertainty modeling
    [lasers.h]
2026-09-17 Serialize Maiman transactions with 1-Wire and drain RTU receive work
2026-09-17 Keep acknowledged stopped laser state valid with physical interlock
2026-09-18 Initialize GPIO 1-Wire mutexes before bus contention
2026-09-18 Checkpoint calibration, throughput and lab investigation work in progress
    Intentionally mixed WIP checkpoint requested before dependency updates and
    follow-up timeout repairs. This preserves the current desk/lab state; it is
    not a claim that the full calibration workflow is validated.
    - Fit with the first support point beyond the calibrated range, validate the
    corrected curve on a dense grid and around its continuation join, and retry
    rejected correction fits with fewer Chebyshev terms before base-only use.
    - Score within measured calibrated support and clarify retained-record/plot
    inclusion, metric semantics, and calibration documentation.
    - Pause numerical work periodically so house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
    [noise_1028y_20260916T190406_856832Z.csv, noise_1028y_20260916T203939_260995Z.csv, noise_1028y_20260916T211000_542258Z.csv, noise_1028y_20260917T002415_664622Z.csv, noise_1028y_20260917T004208_239715Z.csv, noise_1028y_20260917T010209_024272Z.csv, noise_1028y_20260917T045825_043482Z.csv, noise_1028y_20260917T050309_592593Z.csv]
2026-09-18 Validate transport patches on the updated west dependencies
    Advance Zephyr to 55303e23f59d and zscilib to b5668a80c02e, including the
    manifest's CMSIS and STM32 HAL revisions. Adapt the RTU patch and regression
    boundary to upstream's modbus_work_submit() helper. The new optional Modbus
    workqueue remains disabled. The DS18B20 and W1 mutex patches apply unchanged.
    Remove the W1 test's always-successful pin_configure callback and fake GPIO
    device. QEMU gpio-emul rejects the open-drain mode required by w1-gpio; hiding
    that limitation in a fake configure callback was an unnecessary test shortcut.
    The regression now targets nucleo_h563zi with the actual STM32 GPIO driver and
    application bus pins.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
    [main.c]
2026-09-18 Keep calibration status polling responsive while fitting
    The saved notebook times out on an atten/calibrate query near the end of
    fitting. The getter waits forever on cal_lock while the throughput thread
    holds that lock across both numerical fits. Periodic fitting sleeps let
    housekeeping run but do not release the lock for command status queries.
    Publish a coherent status snapshot under a separate short mutex at owner
    start/stop/tick boundaries and immediately before fitting. Status and active
    queries read that snapshot without taking cal_lock. Keep running status during
    fitting and publish both final metrics together when the owner finishes; no
    reader sees partially written fit results. Th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
    [attenuator_calibration.c, attenuator_calibration.h]
2026-09-18 Update attenuator calibration data
2026-09-18 Move 1-Wire buses to native UART transport
    Use stock serial 1-Wire on UART9/PG1 and swapped UART12/PE9 with open-drain pinctrl and existing external pull-ups. Remove Maiman cross-bus locking, the DS18B20 presence and GPIO mutex patches, and their obsolete tests. Keep the independent Modbus receive-lifetime patch.
    Document the accepted stock DS2408 reset timing at 3.3 V and the existing ownership that avoids native bus-mutex contention. Preserve relay defaults, commands, persistence, laser I/O serialization and busy intervals.
    Validation: fresh Nucleo H563ZI build, transport and throughput host regressions, generated DTS/config inspection, and patch application checks passed. PCB validation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
    [maiman.c, main.c]
2026-09-18 Use native USART2 FIFO and retire the Zephyr RTU patch
    Enable STM32 USART2 FIFO while retaining interrupt-driven Modbus and GPIO
    driver enable. Move client configuration into Maiman and replace interface
    selection with client initialization. Only a timed-out register transaction
    disables the client, synchronizing cancellation of its shared parser work;
    initialization waits until the next requested transaction. Preserve the
    original error, sticky health state, response timestamps and busy guards,
    without replaying commands or treating local initialization as a response.
    Remove the final Zephyr patch, manifest, apply helper and build hooks. The
    existing west pin now runs unmodified with the U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
    [devices.c, devices.h, maiman.c, maiman.h]
2026-09-18 Set 1-Wire serial bit timeout to 5000 ms
2026-09-21 Update hardware documentation to reflect FVOA resistance measurements from lab testing
2026-09-21 Remove old garbage
    [throughput_1028y_20260911_183707.csv, throughput_1028y_20260914_103852.csv, throughput_1028y_20260914_172959.csv, throughput_1028y_20260915_144520.csv]
2026-09-21 Serialize unavailable laser settings as valid JSON null
2026-09-21 Rerun with fully assembled YJ TIB. maybe some signs that the opamp capacitor on FVOA1 for 1028y was unwise.
2026-09-22 Run calibration fitting at low priority and retain acquired records
    Numerical fitting inherited the throughput thread's priority and could delay
    1-Wire polling past its receive timeout. Reuse that thread at the lowest
    application priority with no calibration mutex held over calculation, restore
    its priority before finalization, and remove timed fitting pauses. Stop the
    calibration-owned laser before fitting. Start/stop cancel and join numerical
    work before reusing its inputs; canceled work cannot install coefficients.
    Keep one static calibration dataset until the next accepted start or reboot.
    Stop/error cleanup preserves records, references, bridges and completed fits.
    Return shutdown erro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
    [attenuator_calibration.c, attenuator_calibration.h, attenuator_command.c, main.c]
2026-09-22 Replace commissioning component worksheets with a route ledger
2026-09-22 Update laser efficiency coefficients (I forgot to subtract off the threshold current, oops)
2026-09-22 Compare adjacent current steps and add manual command timing captures
2026-09-22 Allow passive throughput capture before laser initialization
2026-09-22 Use PCB settings for commissioning power comparison
2026-09-22 Cleanup things that should not have been added and tidy documentation
    [noise_1028y_20260916T190406_856832Z.csv, noise_1028y_20260916T203939_260995Z.csv, noise_1028y_20260916T211000_542258Z.csv, noise_1028y_20260917T002415_664622Z.csv, noise_1028y_20260917T004208_239715Z.csv, noise_1028y_20260917T010209_024272Z.csv, noise_1028y_20260917T045825_043482Z.csv, noise_1028y_20260917T050309_592593Z.csv]
2026-09-22 Clarify commissioning route losses and detector power comparisons
2026-09-23 Reorder commissioning around explicit captures and calibration comparisons
2026-10-02 Harden commissioning calibration, timing and streamed state
    Require settled measured darks, gate forced lowest-dark resets, add per-FVOA peak residual limits and a constrained 65 dB floor, and precompute paired DAC writes. Use LSE-backed uptime/RTC, the app queue for reboot shutdown, completion UTC acknowledgements and reserved event-driven reply output.
    Update host signal search, clock checks, signed slope telemetry and temporal-noise/live plotting support with the command and architecture docs. Normal Nucleo and isolated ota-flash MCUboot builds pass; temporary C/Python checks and 64 saved/partial/noisy-tail fit replays pass. OTA image dry-run is local only. No hardware commands or flashi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
    [app_settings.c, app_settings.h, attenuator.c, attenuator.h, attenuator_calibration.c, attenuator_command.c, command.c, command.h]
2026-10-02 Use signal search and temporal-noise analysis in commissioning
    Use board timestamps for acquisition boundaries and thin event markers, select missing signal levels, and abort saturated holds while preserving partial captures. Preserve the existing plot panels and repeat colors, add relative predictions with photon RMS bars, and provide conditional excess-noise bounds without claiming electrical identifiability.
    Keep connection disabled by default. All cells parse and saved September 29/30 data, plots and self-assessment were exercised offline. User saved-output edits remain unstaged.
2026-10-02 Prepare paired FVOA scope investigation and offline safeguards
    Remove unconditional connection and full-power commands. Add a guarded, reproducible grid with held-DUT signal search, role swaps, reference revisits, paired local response measurements, optional preamp probing, and per-record raw archives with shutdown on failure.
    Use recorded firmware slopes and keep response ensembles within their operating point. Temporary scope doubles exercised synchronous transfer, correlated-drive spectra, unreachable-point skips and failure cleanup. No PCB or scope access. The separately requested execution prompt remains uncommitted.
2026-10-02 Defer photodiode noise warnings during input changes
    [attenuator.c, housekeeping.c, lasers.c, mems_switching.c, photodiode.c, photodiode.h]
2026-10-03 Use FPU runtime math and prioritize Modbus completion
    Enable shared single-precision FP context and order preemptible owners as
    MEMS 0, PD 1, system/Modbus 2, throughput 3 and main/MQTT 4. Keep existing
    response deadlines, sample cadence and hardware sequencing.
    Use float PD windows and a checked runtime FVOA dB/slope evaluator. Prepare
    normalization and correction endpoints once per bounded voltage inverse.
    Retain double fitting, linear requests and throughput/error arithmetic.
    Validate fitted curves against the deployed float path.
    Normal Nucleo and isolated OTA builds pass, as do the OTA dry-run, all six
    installed DAC grids, 33006 repeatable inverse requests, 88 exact fit/metric
    compari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
    [attenuator.c, attenuator.h, attenuator_calibration.c, main.c, mems_switching.c, photodiode.c]
2026-10-03 Correct H563ZI HSE solder bridge rationale
2026-10-04 Update autolevel dimming guard and default priority
    Introduce a two-sample (100 ms) low-side guard to delay brightening after input changes, ensuring stability during signal adjustments. Update `TP_AUTOLEVEL_DIM_PRIORITY` default to `TP_LASER_FIRST` for consistent dimming order. Adjusted time tolerance for UTC syncing. Updated documentation to reflect behavior changes.
    [throughput_monitor.c]
2026-10-04 Combine attenuator calibration review by run
2026-10-04 Document offline calibration replay setup
2026-10-07 Add freezer temperature test notebook and command logging
2026-10-09 Keep idle laser probes within the approved 19–21 C heater band
2026-10-09 Add explicit FVOA and laser commissioning holds
2026-10-09 Improve laser failure diagnostics
2026-10-09 Clarify laser readiness and output state
2026-10-09 Continue temperature observation during heater override
2026-10-09 Exclude operating TECs from enclosure temperature
2026-10-09 Remove notebook bank cycling during low-power transitions
2026-10-09 Add laser-bank output power convenience helper
2026-10-09 Synchronize thermistor coefficients in datasheet units
2026-10-09 Make laser engineering readbacks consistent
2026-10-09 Simplify laser failure reporting into bounded MQTT detail
2026-10-10 Fix internal LD NTC register and record TEC calibration evidence
2026-10-12 Remove outdated test documentation and update notebook for calibration corrections
2026-10-12 "Add serial numbers, update specifications and coefficients for laser properties, and refresh associated datasheets."
2026-10-12 Complete per-diode properties and expose ld_serial in host settings
2026-10-12 Support broadband route-loss overrides in firmware and commissioning
    Use the existing none source record for passive return overrides and CAL ledger writes. Keep named laser records independent and enlarge the bounded table to 40 slots. Update command/help, settings docs, Python helper, and ledger previews.
    Verified with the Nucleo build and temporary C/Python checks for defaults, override independence, loss parsing, ambiguity, query output, capacity, and record restoration. No hardware or reboot persistence test performed.
2026-10-12 Constrain commissioning power fits to historical laser thresholds
    Fit a nonnegative slope at the fixed measurement-time threshold and preserve quantized historical currents. Compare fitted and configured efficiencies, nominal-current powers, residuals, and the signed measurement-path attenuation adjustment using an explicit archived or live nominal reference.
    Verified offline threshold constraints, absent nominal settings, attenuation sign, and rendered fit figures. Fit and calibration comments now describe the fixed threshold and unresolved meter-fiber loss.
2026-10-12 Unify commissioning holds and audit drift with bounded capture intervals
    Replace the duplicate hold runner with noise_points. Preserve group DACs and exact revisits, guard fresh samples independently of metadata queries, close failures before shutdown, recover only from overrange, and archive/display every attempt with explicit outcomes.
    Replay historical requested settings, stale labels, skipped preparations, and inferred boundaries without rewriting raw captures. Share valid intervals across drift, PSD, ACF, averaging, and conditional variance reports. Add common-duration comparisons, route archive selection, nonnegative linear throughput axes, and correct stopped-start and clock timing i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
2026-10-13 **Update `simple_example.ipynb` to reflect revised patch notes and experimental setup streamlining**
    - Updated fiber connection and patch panel notes for clarity and accuracy.
    - Adjusted channel defaults from `_ao` to `_fei` for consistency.
    - Added detailed instructions and example on using `pcb.measure_throughput` with auto-leveling, including data collection and control handling.
    - Revised dark current measurement behavior, extending `autooff_s` and enabling `ACCEPT_DARK` by default for improved calibration workflows.
    - Improved laser emission shutdown logic to ensure TEC stops reliably during manual control transitions.
2026-10-13 **Refactor data handling for calibration and noise archives**
    - Replaced JSON/pickle metadata with structured NPZ tables to improve data portability and maintain consistency.
    - Implemented utilities for parameter flattening and context storage as structured tables.
    - Updated calibration save/load logic for improved error handling and raw data retention.
    - Improved support for noise archive replay with session-based or explicit file selection.
    - Enhanced photodiode noise warning thresholds and measurement outputs for better debugging.
    - Verified changes with updated unit tests and example datasets.
2026-10-13 "Update `tib_fvoa_noise_scope_lab.ipynb` with revised laser configurations, improved probe details, and automated investigation setup adjustments"
2026-10-13 Correct generic TIB route losses and launch telemetry
    Limit broadband loss settings to the eight TIB CAL launch and PD return
    routes under generic. Use the MM/SM compiled defaults directly, keep named
    source overrides independent, and retain AS split and named-source storage.
    Report launch_route_tx for explicitly routed passive light without inferring
    emission or throughput; rename JSON/Python consumers at the same binary position.
    Use provisional YJ whole-route defaults of 34.5/41/62 dB and 1 dB for CAL,
    with equal AO/FEI estimates. Align the commissioning ledger, retain component
    notes, and document the saved-data/source-model basis. Reduce overrides to
    32 slots per PCB. Schema 14 uses th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
2026-10-21 Add reference-anchored laser calibration and scoped defaults restore
2026-10-21 Make laser calibration readable for human review
2026-10-21 Add PCB design files and datasheets for more laser diodes.
2026-10-21 docs: consolidate firmware guides and audit implementation contracts
    Organize operation mathematics, uncertainty, Python test helpers and hardware teaching around their owning features. Replace redundant command inventories, architecture shelves and completed implementation notes with one control specification and linked guides.
    Expose missing C contracts, document Python helpers and correct three help descriptions without changing control logic or schemas. Cross-check PCB evidence and retain concrete algorithm, ownership, CLI and physical-mapping questions in the review ledger.
    Validation: strict Sphinx build, Nucleo build, 14 Mermaid renders, 172 MathJax equations, public-contract covera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
2026-10-22 Add laser calibration workflow and vendor curves to commissioning
2026-10-22 Fit reference-anchored laser curves and separate calibration application
2026-10-22 Make laser commissioning prerequisites and fit review explicit
2026-10-22 Record laser calibration validation and successful OTA trial
2026-10-23 Make laser curves independently installable and preserve emission levels
2026-10-23 Record verified laser calibration OTA and policy restoration
2026-10-23 Sample laser currents at multiple PD levels and fit calibrated attenuation uncertainty
2026-10-23 Compare multilevel laser captures with raw returns and prior reference data
2026-10-23 Keep valid laser calibration probes when ranging exhausts its budget
2026-10-23 Separate commissioning laser runs and expose acquisition failures
2026-10-23 Validate laser calibration through the configured range against vendor curves
2026-10-23 Clarify laser calibration thresholds and guard full-range installation
2026-10-25 Correct HK detector gain for the PCB input divider
2026-10-27 Fix attenuator calibration stack overflow
2026-10-27 Capture source-off backgrounds around attenuator calibration
2026-10-27 Use firmware calibration records in notebook diagnostics and park outputs closed
2026-10-30 Update FIB Switcher PCB print
2026-10-30 Correct TIB SM/MM switch names and return routes
2026-10-31 Fix calibration full-open ranging and correction endpoint validation
2026-10-31 Separate commissioning channels and keep calibration replay static
2026-10-31 Reconcile calibration documentation and record OTA bench verification
2026-11-03 This is a checkpoint of living work - JIB. Update PCB commissioning script: adjust photodiode configurations, refine patch notes, and set default connection states.
2026-11-03 Add engineering current commands and preserve autolevel ownership
2026-11-03 Fit measured dark history and retain reviewable laser support
2026-11-03 Reconcile calibration guidance and report saved-data stability
2026-11-03 Clarify calibration review limits and expose quiet monitoring
2026-11-03 Record closeout calibration control and normalization evidence
2026-11-03 Restore photodiode power intent and AUTO state across boots
2026-11-03 Bound laser operation timers and standardize duration fields
2026-11-04 Fit broad laser response while reporting path variability separately
2026-11-04 Show calibration variability and standalone adoption in notebook review
2026-11-04 Record calibration closeout verification and clarify review guidance
2026-11-04 Anchor laser shape to reference data and measure path agreement directly
2026-11-04 Verify relative calibration models on hardware and record remaining path limits
2026-11-04 Laser fits programmed and all returns launch estimates updated.
2026-11-04 Seed TIB attenuation defaults from adopted device calibrations
2026-11-05 Use vendor laser curves and adopted fractional noise as defaults
2026-11-05 Add readable print mode to Python status helper
2026-11-05 Refresh OTA update notebook with status print examples
2026-11-05 Record temperature read errors during PD stress check
2026-11-06 Fix notebook consumers of current status and attenuator fields
